chipsalliance/adams-bridge/docs/images/MLDSA/image1.png

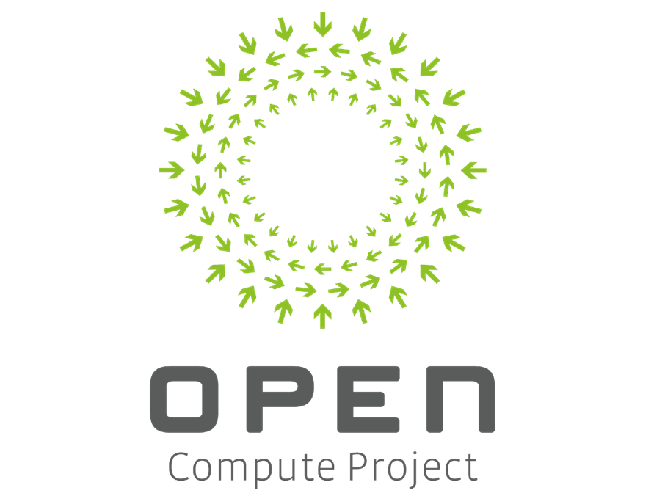
docs/images/MLDSA/image1.png
