chipsalliance/adams-bridge/docs/images/MLDSA/image64.png

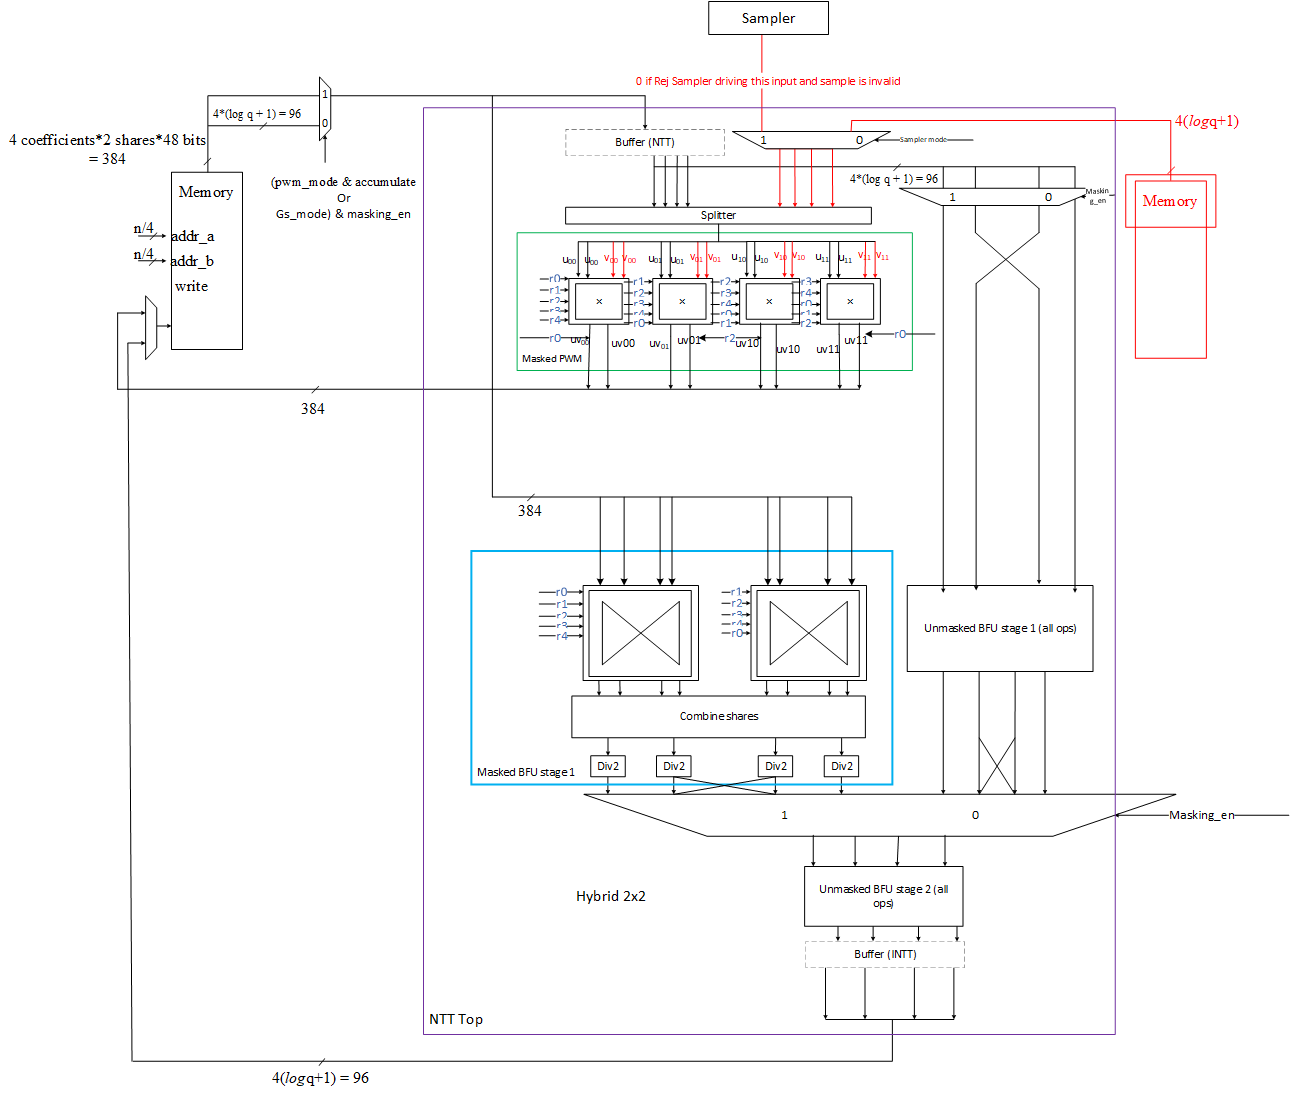
docs/images/MLDSA/image64.png
