chipsalliance/adams-bridge/docs/images/MLKEM/image2.png

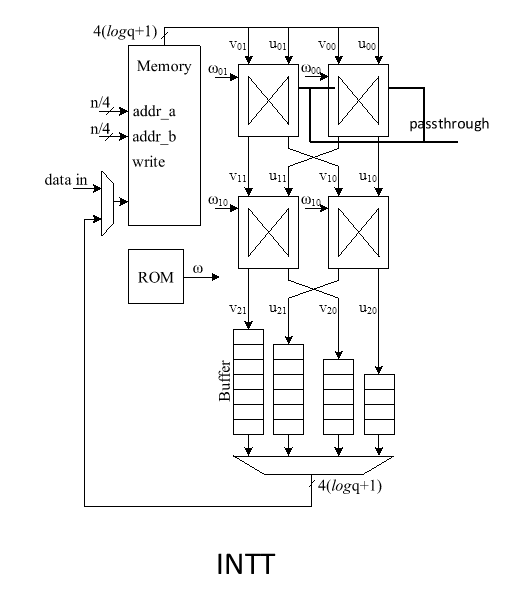
docs/images/MLKEM/image2.png
