chipsalliance/adams-bridge/docs/images/MLKEM/image3.png

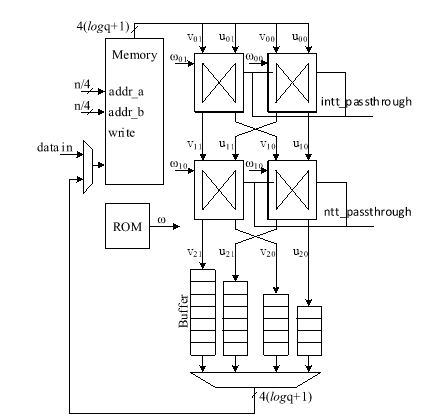
docs/images/MLKEM/image3.png
