chipsalliance/adams-bridge/docs/AdamsBridge_TestPlan.xlsx

Sheet: ML-KEM
Test Category | Test Name | Randomization Parameters | Description | Pass Metrics
Baseline Function
 | Directed Keygen KATs (tb) | none | Validate the keygen using a fixed KAT to ensure any update doesn't break the functionallity | Data check
 | Directed Encaps KATs (tb) | none | Validate the signing using a fixed KAT to ensure any update doesn't break the functionallity | Data check
 | Directed Keygen+Decaps KATs (tb) | none | Validate the keygen+signing using a fixed KAT to ensure any update doesn't break the functionallity | Data check
 | Directed Decaps KATs (tb) | none | Validate the verifying using a fixed KAT to ensure any update doesn't break the functionallity | Data check
 | Directed Keygen KATs (smoke tests) | none | Validate the keygen using a fixed KAT in a C smoke test to ensure any update doesn't break the functionallity | Data check
 | Directed Keygen+Decaps KATs (smoke tests) | none | Validate the keygen+signing using a fixed KAT in a C smoke test to ensure any update doesn't break the functionallity | Data check
 | Directed Encaps KATs (smoke tests) | none | Validate the signing using a fixed KAT in a C smoke test to ensure any update doesn't break the functionallity | Data check
 | Directed Decaps KATs (smoke tests) | none | Validate the verifying using a fixed KAT in a C smoke test to ensure any update doesn't break the functionallity | Data check
 | randomized test | selected operation | Randomly select keygen/encap/decap and verify using reference model | Data check
 |  | order of operation
 |  | input data
 | Zero-seed KAT | seed = 0 | Run keygen with all-zero seed and validate against known behavior | Data check
 | Chaning the command during the process | randomized timing | Assert another command either 1 cycle or X cycles after the first command to ensure it is ignored while the engine is busy.
 | zeroize with command | none | Assert zeroize simultaneously with keygen, encaps, or decap
 | zeroize during the process | randomized timing | Assert zeroize either 1 cycle or X cycles after issuing the command to interrupt the process and ensure all registers and memories are cleared.
 | kv interaction | selected operation | Perform key generation, Encaps or Decaps with the seed sourced from KV, ensuring the secret asset remains hidden from firmware.
 |  | order of operation
 |  | input data
 | zeorize after process being done | selected operation | Assert zeroize upon process completion to ensure all registers and memories will be cleared.
 |  | input data | add several assertion to ensure registers and memories are cleared using zeroize/scan_mode command.
Error Trigger
 | encapsulation with invalid ek | invalid input | Set a 12b coefficient value in the EK to >= MLKEM Q | Data check
 | decapsulation with invalid dk | invalid input | Bit flip on EK/hash portion of DK | Data check
 | Decaps rejection | valid ct from a different EK | Use a ciphertext from a different EK and ensure decapsulation fails (comparing with expected shared key) | Data check
Edge cases
 | Prevent partial key recovery |  | zeroize during kv access
 |  |  | fw read during kv access
 |  |  | Assert zeroize in the middle of reading the seed from KV to ensure that no partial key is presented.
 | Restrict fw access while kv assets exist |  | Attempt to read the API while the seed is sourced from KV, ensuring the secret asset is not exposed to the firmware.
 | Reg API lock feature |  | reading the API during the process
 |  |  | any unlock(excluding the regular valid output) clears the API content
 |  |  | only valid signature unlocks the API and releases the content
 | scan_mode/debug |  | Assert scan/debug_mode to interrupt the process and ensure all registers are cleared.
 | write after read during zeroize |  | Read from and write to the API while zeroize is occurring to ensure the engine only returns 0.
Unit Level TB
 | barrett reduction

Sheet: ML-DSA
Test Category | Test Name | Randomization Parameters | Description | Pass Metrics
Baseline Function
 | Directed Keygen KATs (tb) | none | Validate the keygen using a fixed KAT to ensure any update doesn't break the functionallity | Data check
 | Directed Signing KATs (tb) | none | Validate the signing using a fixed KAT to ensure any update doesn't break the functionallity | Data check
 | Directed Keygen+Signing KATs (tb) | none | Validate the keygen+signing using a fixed KAT to ensure any update doesn't break the functionallity | Data check
 | Directed Verifying KATs (tb) | none | Validate the verifying using a fixed KAT to ensure any update doesn't break the functionallity | Data check
 | Directed Keygen KATs (smoke tests) | none | Validate the keygen using a fixed KAT in a C smoke test to ensure any update doesn't break the functionallity | Data check
 | Directed Keygen+signing KATs (smoke tests) | none | Validate the keygen+signing using a fixed KAT in a C smoke test to ensure any update doesn't break the functionallity | Data check
 | Directed Signing KATs (smoke tests) | none | Validate the signing using a fixed KAT in a C smoke test to ensure any update doesn't break the functionallity | Data check
 | Directed Verifying KATs (smoke tests) | none | Validate the verifying using a fixed KAT in a C smoke test to ensure any update doesn't break the functionallity | Data check
 | randomized test | selected operation order of operation input data | randomly select one operations (keygen/signing/verifying tests) and perform using random inputs and validate the reuslts using the reference model. | Data check
 | verifying failure | change rho/t1 parts of pk change the message change c~/z/h part of signature | randomly change different parts of input to generate failure for verifying | Data chaeck
 | on the fly reset test | randomized timing | Assert reset during execution to halt the core.
 | Chaning the command during the process | randomized timing | Assert another command either 1 cycle or X cycles after the first command to ensure it is ignored while the engine is busy.
 | zeroize with command | none | Assert zeroize simultaneously with the keygen, signing, or verifying command to ensure the command is ignored.
 | zeroize during the process | randomized timing | Assert zeroize either 1 cycle or X cycles after issuing the command to interrupt the process and ensure all registers and memories are cleared.
 | kv interaction with keygen/signing | selected operation order of operation input data | Perform key generation or signing with the seed sourced from KV, ensuring the secret asset remains hidden from firmware.
 | zeorize after process being done | selected operation input data | Assert zeroize upon process completion to ensure all registers and memories will be cleared.
Error Trigger
 | signing with invalid s1/s2 | invalid input | Perform the signing operation with invalid input to validate that the system detects the error and reports it appropriately. | Data check
 | verifying with invalid h | invalid input | Perform the verifying operation with invalid input to validate that the system detects the error and reports it appropriately. | Data check
Edge cases
 | inject invalid makehint |  | make failure for hintsum during signing/verifying | Data check
 | inject invalid normcheck |  | inject failute for 3 normcheck operations in singing, or the one for verifying | Data check
 | partial key recovery |  | zeroize during kv access fw read during kv access hmac/sha interation during kv access
 | fw access while kv assets exist |  | Attempt to read the API while the seed is sourced from KV, ensuring the secret asset is not exposed to the firmware.
 | equal scenaio for decompose |  | Checking the corner cases for decomposition operations to ensure all edge scenarios are handled correctly.
Unique features
 | Reg API lock feature |  | reading the API during the process any unlock(excluding the regular valid output) clears the API content only valid signature unlocks the API and releases the content signing failure keeps API locked
 | single signing cmd |  | single signing is not supported
 | iteration failure for signing round |  | inject failure for validity checks during signing for all rounds to check time-out
 | iteration failure for rejection samplers |  | inject failure for vrejection samplers to check time-out
 | zeroize partial keys (inject zeroize) |  | Assert zeroize in the middle of reading the seed from KV to ensure that no partial key is presented.
 | mldsa with scan_mode/debug |  | Assert scan/debug_mode to interrupt the process and ensure all registers are cleared.
 | sva for zeroize period |  | add several assertion to ensure registers and memories are cleared using zeroize/scan_mode command.
 | write after read during zeroize |  | Read from and write to the API while zeroize is occurring to ensure the engine only returns 0.
 | code coverage at least for a week |  | Checking the coverage
 | sign_rnd |  | Validate non-deterministic signing and verifying by using a fixed KAT to ensure correct functionality.
 | Lint issues |  | Checking the lint
