chipsalliance/adams-bridge/(threads)

Thread 45 (2024-11-22):

updated NTT block to support masking countermeasure for A.y

mojtaba-bisheh, 2024-11-22:
The current masking supports only PWM operation that is followed by INTT operations. Hence, the intermediate results of PWM is not stored in memory.
In the case of A.y, PWM with accumulation needs to happen first and then INTT. Since this is accumulation over several polynomials, we cannot perform INTT on the fly for each PWM operation that happens.
We should update the memory arch to store the intermediate masked data of size (4 coeff * 2 shares * 46 bits * 64 addr) that stores 1 poly at a time and accumulation happens over it with masked PWM. Then INTT is triggered that reads this share memory and performs 1st stage of masking and combines shares and writes to original memory.

Now, NTT should support:
All unmasked operations
Masked PWM
Masked PWMA (accumulation)
Masked INTT
Masked PWM + INTT

Thread 54 (2024-12-11):

Don't use a prehashed version of ML-DSA

brainhub, 2024-12-11:
NIST has recently clarified that one FIPS module can accept a hash of the message and use the "pure" or "normal" version of ML-DSA. ("pure ML-DSA" below). The method to use pure ML-DSA with a hash of the message is known as "external mu" method.

The method can be seen on lines 6-7 of Algorithm 8 in https://doi.org/10.6028/NIST.FIPS.204:

6: 𝑡𝑟 ← H(𝑝𝑘, 64)
7: 𝜇 ← (H(BytesToBits(𝑡𝑟)||𝑀 ′ , 64)) ▷ message representative that may optionally be computed in a different cryptographic module

Then the module, such as the one implementing this IP, takes the 64-byte "mu" as input (representing the hashed message).

The issues of prehashing is best to leave to the higher levels of firmware. In many cases, as e.g. in composite signatures, the messages passed to ML-DSA are very small, and the pure ML-DSA is used. This is just one example. The same is true for e.g. boot images where often short images are signed, that include hashes of larger images.

Therefore, to make the IP applicable to more use cases, and to simplify testing of the IP, it should stay with the pure version of ML-DSA.

This keeps the register `message` effectively the same. In this case of verification the register `pk` is not used. I don't see a strong need to hash the `pk` by IP itself, so this should not be a material issue.

igilman0, 2024-12-11:
If I understand the previous post correctly, it is now impossible to check the current Adam's Bridge (ABR) IP implementation correctness against the NIST-provided FIPS204 standard compliance Sign and Verify vectors.  Correct?
These vectors have input "messages" (M in FIPS204 nomenclature) that are way longer than the ABR 64-byte MSG register so currently ABR couldn't even accept them.

Could you also confirm that the ABR IP in fact *will* be fixed to accept a 64-byte "mu" input into its MSG register (a.k.a., externally-computed message representative "mu")?

brainhub, 2024-12-12:
I think I was asking for this 35180387a977abe48777415c1aed86c35413a25f . @igilman0, so there is "pure ML-DSA" and "prehash ML-DSA" and they are binary incompatible. The test vectors will not match.

I propose to use the "external mu" interface to pure ML-DSA.

> Could you also confirm that the ABR IP in fact will be fixed to accept a 64-byte "mu" input into its MSG register (a.k.a., externally-hashed message representative "mu")?

I am not sure to whom this question is directed, but because I advocate pure ML-DSA, the minimal change to the current interface is to accept the "mu". This will mean from functional point of view that the same properties of the HW interface are preserved, namely, that the input representative of a message is still a hash (broadly speaking), while this interface can be tested against standard pure ML-DSA test vectors.

mojtaba-bisheh, 2024-12-12:
AdamsBridge doesn't support ExternalMu variant. This is pure MLDSA where the message size is limited to 512 bits based on Calitpra use model.
Caliptra performs a SHA512 over the data and passes the digest to AdamsBridge that works in Pure MLDSA mode.

brainhub, 2024-12-12:
Will you be able to find "official" test vectors for fixed-size-512-bit-message?

mjosaarinen, 2024-12-18:
Comment from the sidelines :)  The current behavior maps to the "IPD" draft version of FIPS 204, which allowed one to simply sign a hash as if it were a message. This is problematic cryptanalytically as the same signature is now valid for both SHA(message) and also its hash, interpreted as a 64-byte message (without hashing). HashML-DSA and additional domain separation were specifically introduced in the final version of FIPS 204 to overcome this EUF-CMA security problem. Thus I would not think that the current approach is FIPS-certifiable.

 I've worked with Chris Celi of NIST little bit on this (to fix those test vectors), and the latest test vectors include ExternalMu cases, so one should be able to FIPS certify with that kind of API.

An ExternaMu interface would allow your module to support all modes and hash functions (pure and non-pure) with current external interfaces. It bypasses the domain separation padding steps altogether and 64-byte "msg" becomes:
- "mu" on line 6 of Algorithm 7 (ML-DSA.Sign_internal) and
- "mu" on line 7 of Algorithm 8 (ML-DSA.Verify_internal)
( See https://doi.org/10.6028/NIST.FIPS.204 )

You're trusting the caller to compute the hash so you could also trust that party to also format the hash with domain separation. Note the comment _message representative that may optionally be computed in a different cryptographic module_ in the spec.

Cheers,
-markku

mjosaarinen, 2024-12-18:
Btw the only bug in these test vectors was that the "rnd" parameter bytes need to reversed (or for Adams Bridge, not reversed, unlike everything else..) https://groups.google.com/a/list.nist.gov/g/pqc-forum/c/bV_tuibsCWU/m/HrNpJ2sTAAAJ

To pass all test cases one needs four different APIs but you don't need to implement all of those; it's just to facilitate people having different kinds of APIs.

## quote

**Dec 5, 2024, 3:36 PM (13 days ago) to Christopher,**
Thanks Chris,

With this byte reversal of "rnd", I am now passing all 360 ML-DSA sigGen test cases. It seems to work for preHash, externalMu, both external and internal interfaces, and all parameter sets.

This requires one to use four different signing interfaces to the ML-Dsa implementation:

1. When "preHash" is set: Algorithm 4, HashML-DSA.Sign(sk, M, ctx, PH) interface, with the "PH" switch case extended with all of the additional OIDs and hashes in the test cases.
3. When "externalMu" is set: Algorithm 7, ML-DSA.Sign_internal(sk, <M'>, rnd) is used with the additional parameter mu that is inserted in line 6 of the algorithm. Parameter M' is not used.
4. when "signatureInterface" = "external": Algorithm 2 ML-DSA.Sign(sk, M, ctx).
5. when "signatureInterface" = "internal": Algorithm 7, Algorithm 7, ML-DSA.Sign_internal(sk, M', rnd), where M' is the message.

My test code checks the various flags in that order; for example, if preHash is set, other cases are ignored.

Note again that in *all* cases, the rnd input bytes are reversed to pass the non-deterministic cases.

Cheers,
- Markku

mojtaba-bisheh, 2025-03-12:
> NIST has recently clarified that one FIPS module can accept a hash of the message and use the "pure" or "normal" version of ML-DSA. ("pure ML-DSA" below). The method to use pure ML-DSA with a hash of the message is known as "external mu" method.
- The current design only supports Pure-MLDSA.

> An ExternaMu interface would allow your module to support all modes and hash functions (pure and non-pure) with current external interfaces. It bypasses the domain separation padding steps altogether and 64-byte "msg" becomes:
- ExternalMu is added to design but hardcoded to be zero until validation https://github.com/chipsalliance/adams-bridge/issues/108

> Note again that in _all_ cases, the rnd input bytes are reversed to pass the non-deterministic cases.
- we have added a smoke test with non-zero rnd to ensure the endianness is correct. https://github.com/chipsalliance/caliptra-rtl/tree/main/src/integration/test_suites/smoke_test_mldsa_sign_rnd

Thread 62 (2024-12-19):

sample_in_ball_ctrl module state machine stuck in SIB_DONE state without zeroize or reset

batthineniatlubis, 2024-12-19:
In the sampler units, one of the units is sample_in_ball_ctrl which is being used in signing operation. This module got an FSM which traverses from IDLE -> BUFFER -> ACTIVE->DONE, once it reached the"DONE" state the fsm waits for the zeroize or !rst_b signal to jump back to"IDLE" state.On the higher  level if the signature is valid for the current request and once this request is served and a new request is triggered without a zeroize or !rst_b then the SampleInball operation immediately returns done signal which isn't actually triggered for this request.

mojtaba-bisheh, 2024-12-19:
We assume zeroize is required between two operations, however, we can consider this fix as an enhancement for any use case that doesn't need FIPS certificate to perform zeroize

Closed 2025-06-25.

Thread 67 (2025-01-14):

lint waiver file doesn’t exist

mojtaba-bisheh, 2025-01-14:
One of the files provides pointers for lint waivers but the directories doesn’t exist in github

https://github.com/chipsalliance/adams-bridge/blob/b4a3eec9a791a260a036f453f4e6ef3f596ea6c8/src/mldsa_top/config/compile.yml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

Closed 2025-01-16.

Thread 73 (2025-01-21):

Adams Bridge interface needs debugUnlock_or_scan_mode_switch input to drive zeroize in case of debug/scan mode

upadhyayulakiran, 2025-01-21:
ABR needs debugUnlock_or_scan_mode_switch input to zeroize internal regs and memories upon debug/scan mode entry

@Nitsirks I believe all crypto engines until now finish zeroization in the next clk after assertion of this signal. However in mldsa, it will take ~500 clks to finish zeroizing the memories. Can you confirm if this is okay and if the memories won't be part of the scan chain (per discussion with Avirup this morning)?

Nitsirks, 2025-01-22:
Scan mode is usually for shifting out flop values, which will be cleared in the same clock.

We need to be very clear in the integration spec how integrators will need to protect SRAMs from leaking secrets over BIST logic. This would include putting restrictions on when dft logic can read them.

Closed 2025-01-23.

Thread 86 (2025-02-05):

There is a write when ntt is done.

batthineniatlubis, 2025-02-05:
The following scenario occurs when the ntt is set for one of the modes for example ct and the operation goes on until the done signal is asserted, which ideally considering done a very strong signal, because after done, we should be able to start another computation. In the current design its not feasible because there is a write even when the done is asserted and this means a new computation cannot be triggered until this is finished. This would be an issue if the ntt block is pulled and used for any another project where it needs back to back computations.

Closed 2025-02-21.

Thread 89 (2025-02-09):

buf_wren stays asserted during EXEC_WAIT state in ntt_ctrl module

batthineniatlubis, 2025-02-09:
The issue here is, buf_wren stays high even in EXEC_WAIT(last state before going to STAGE state for next round) state and it writes 0s to the lower buffer while upper buffer is being read. This is not expected.

upadhyayulakiran, 2025-02-21:
This is an issue, however in ABR we don't see functional issue due to this, since the 0s are written after the last set of writes complete. So, the 0s are never read and everything pointers are reset before starting next round. It's good to fix, but not a functional issue. Marking as enhancement

Thread 90 (2025-02-10):

NTT: wrong counting for sampler valid causing deadlock

mojtaba-bisheh, 2025-02-10:
If sampler valid de-asserts at data beat number 63 it can cause a deadlock, where the computation never finishes.
Here is the response from the designer:

This is a bug. I see in the waves that, sampler_valid goes low on the very last read. In that case, since data is not valid, NTT should wait for sampler_valid to go high again and then read, execute and write. But in this case, since the read counter is already updated, it thinks that it already saw the last data whereas the write fsm is stuck because it only counted 63 writes instead of 64.

[ntt_top_never_leaves_busy3.fsdb.zip](https://github.com/user-attachments/files/18724897/ntt_top_never_leaves_busy3.fsdb.zip)

mojtaba-bisheh, 2025-02-10:
CCed https://github.com/ludwigatlubis

Closed 2025-02-21.

Thread 96 (2025-02-14):

Norm check shuffling is enabled for non shuffle mode

batthineniatlubis, 2025-02-14:
In the normcheck where back to back enables trigger one with shuffling and the second without shuffling, in the second operation still it will considered as shuffling because of the latched_shuffling signal is resetted post idle state.

[fv_norm_check_top_fv_norm_check_top_verif_run_IDLE_to_READ_MEM_1_a_0.fsdb.zip](https://github.com/user-attachments/files/18800349/fv_norm_check_top_fv_norm_check_top_verif_run_IDLE_to_READ_MEM_1_a_0.fsdb.zip)

.

Thread 125 (2025-03-12):

Assertion error at EOT

BharathwajMuralidharan, 2025-03-12:
Hi Team,
I am currently observing the following assertion failure in the MLDSA tests
"mldsa.sampler_top_inst.sha3_inst.u_pad.RunThenComplete_M". The assertion is a strong assertion, expecting an response before the EOT. Despite adding a drain time, It is observed that the assertion still fails.

Nitsirks, 2025-05-13:
Which operation (keygen/sign/verify) are you running that results in this assertion?

Nitsirks, 2025-07-10:
closing due to inactivity and inability to reproduce internally.

Closed 2025-07-10.

Thread 131 (2025-03-20):

sigdecode_h missing default case in rd fsm

batthineniatlubis, 2025-03-20:
The read fsm in the sigdecode_h module doesn't have a default condition.

This is an enhancement

Thread 133 (2025-03-24):

Simulation deadlock for signing tests

BharathwajMuralidharan, 2025-03-24:
Hi,

While executing the random signing testcase, it is observed that the simulation doesn't proceed beyond 42000 ns(clk is operating at frequency of 1ghz). Further debugging revealed that the simulation is stuck at the following logic in mldsa_ctrl.sv

  always_comb process_done = (keygen_process & keygen_done) |
                             (signing_process & signature_done) |
                             (verifying_process & verify_done);

in a parallel always_ff block, the process_done deasserts the signing_process signal which is causing this deadlock.

Let me know if any waveform is needed.

The simulator used here is xcelium.

Nitsirks, 2025-04-25:
process_done should have triggered the VALID register to be set. Are you sure that the signing operation didn't just complete normally?

Nitsirks, 2025-05-13:
Closing this issue due to inactivity, feel free to re-open it if you are still facing the issue.

BharathwajMuralidharan, 2025-05-14:
"process_done should have triggered the VALID register to be set" --> The simulator identified a glitch condition with this logic and the test gets stuck. We have used a delay_trigger switch as a workaround. Attaching the cadence article for your reference
 https://community.cadence.com/cadence_technology_forums/f/logic-design/15558/problem-with-simvision-hanging-in-an-endless-loop

Thread 136 (2025-04-15):

Stream msg interface doesn't absorb back pressure for ctx

batthineniatlubis, 2025-04-15:
In the rtl version of mldsa_ctrl where it supports the msg stream. It is observed  that if the ctx_size is greater than the number of beats the keccak module handles then there will be a back pressure from the keccak by deasserting msg_rdy_i for a clk and this would drop the msg_valid missing the ctx data. Since the logic doesn't consider this case.

Nitsirks, 2025-04-25:
After review, looks like the modeling of primary inputs was incorrect. Runs with the corrected modeling will determine if this is a real issue.

Thread 145 (2025-05-15):

[BUG] Streaming message will drop a byte for specific lengths of message

Nitsirks, 2025-05-15:
The streaming message logic will drop 1 byte of MSG data when an odd number of dwords is sent to the streaming message buffer, followed by a partial dword of 3 bytes.

In this corner case, the partial triggers the last message logic and transitions to the flush state. In the flush state, the normal condition is to flush the remaining bytes, but in this case there is a full message + 1 byte so it only flushes the full message and drops the last byte.

This escaped due to a hole in the validation randomization that was preventing odd dword length messages.

Closed 2025-05-16.

Thread 163 (2025-07-17):

Reset in CBD and specification

batthineniatlubis, 2025-07-17:
The reset pin (active low) isn't used since the module is purely combinational. Rather zeroize is used, so the reset pin can be removed.

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

CBD specification has a modular mux values 0,1,2,3,4. Which should be 0,1,2,6,7.

https://github.com/chipsalliance/adams-bridge/blob/feee8cfc22bc73e33eba261c5000d996ac16cdec/docs/AdamsBridge_MLKEM.md

Closed 2025-07-18.

Thread 168 (2025-07-23):

[RTL] Decaps flow is missing an input check

Nitsirks, 2025-07-23:
FIPS 203 requires a decapsulation check that the provided hash of EK is in fact the hash of the provided EK portion of the DK.

Closed 2025-07-30.

Thread 197 (2025-08-22):

Build failure from missing includes

jlmahowa-amd, 2025-08-22:
For FPGA builds I found that with 2.1 (not required for 2.0) I need to include kv_macros.svh and abr_config_define.svh from abr_ctrl.sv.
A couple concerns with my hack:
- Many of the macros are defined in abr_sva.svh, which is included in abr_config_defines.svh. Would abr_sva.svh be preferred to be included instead of abr_config_defines.svh?
- kv_macros.svh is from the caliptra-rtl repo. Are there concerns about adding an include from the caliptra-rtl besides gating it on CALIPTRA being defined?

The error message reported by Vivado for the build is misleading. Vivado dropped abr_ctrl.sv because of the undefined macros.
```
ERROR: [Synth 8-439] module 'abr_ctrl' not found [/fourtb/jlmahowa/caliptra-mcu-sw-lock/hw/fpga/caliptra_build/caliptra_fpga_project.gen/sources_1/bd/caliptra_fpga_project_bd/ipshared/3d11/src/abr_top.sv:339
```

The actual errors in abr_ctrl.sv:
```
[HDL 9-3952] use of undefined macro 'CALIPTRA_KV_WRITE_STATUS_ASSIGN' ["/fourtb/jlmahowa/caliptra-mcu-sw-lock/hw/caliptra-ss/third_party/caliptra-rtl/submodules/adams-bridge/src/abr_top/rtl/abr_ctrl.sv":242]

[HDL 9-3952] use of undefined macro 'CALIPTRA_KV_READ_CTRL_REG2STRUCT' ["/fourtb/jlmahowa/caliptra-mcu-sw-lock/hw/caliptra-ss/third_party/caliptra-rtl/submodules/adams-bridge/src/abr_top/rtl/abr_ctrl.sv":243]

[HDL 9-3952] use of undefined macro 'CALIPTRA_KV_WRITE_CTRL_REG2STRUCT' ["/fourtb/jlmahowa/caliptra-mcu-sw-lock/hw/caliptra-ss/third_party/caliptra-rtl/submodules/adams-bridge/src/abr_top/rtl/abr_ctrl.sv":246]

[HDL 9-3952] use of undefined macro 'ABR_ASSERT_KNOWN' ["/fourtb/jlmahowa/caliptra-mcu-sw-lock/hw/caliptra-ss/third_party/caliptra-rtl/submodules/adams-bridge/src/abr_top/rtl/abr_ctrl.sv":2192]

[HDL 9-3952] use of undefined macro 'ABR_ASSERT' ["/fourtb/jlmahowa/caliptra-mcu-sw-lock/hw/caliptra-ss/third_party/caliptra-rtl/submodules/adams-bridge/src/abr_top/rtl/abr_ctrl.sv":2196]

[HDL 9-3952] use of undefined macro 'ABR_ASSERT_NEVER' ["/fourtb/jlmahowa/caliptra-mcu-sw-lock/hw/caliptra-ss/third_party/caliptra-rtl/submodules/adams-bridge/src/abr_top/rtl/abr_ctrl.sv":2198]

[HDL 9-3952] use of undefined macro 'ASSERT' ["/fourtb/jlmahowa/caliptra-mcu-sw-lock/hw/caliptra-ss/src/ast/rtl/adc.sv":113]

[HDL 9-3952] use of undefined macro 'ASSERT_KNOWN' ["/fourtb/jlmahowa/caliptra-mcu-sw-lock/hw/caliptra-ss/src/ast/rtl/ast.sv":938]

[HDL 9-3952] use of undefined macro 'ASSERT_PRIM_REG_WE_ONEHOT_ERROR_TRIGGER_ERR' ["/fourtb/jlmahowa/caliptra-mcu-sw-lock/hw/caliptra-ss/src/ast/rtl/ast.sv":995]

[HDL 9-3952] use of undefined macro 'ASSERT' ["/fourtb/jlmahowa/caliptra-mcu-sw-lock/hw/caliptra-ss/src/ast/rtl/ast_pulse_sync.sv":143]

[HDL 9-3952] use of undefined macro 'ASSERT_PULSE' ["/fourtb/jlmahowa/caliptra-mcu-sw-lock/hw/caliptra-ss/src/ast/rtl/ast_reg_top.sv":1958]

[HDL 9-3952] use of undefined macro 'ASSERT' ["/fourtb/jlmahowa/caliptra-mcu-sw-lock/hw/caliptra-ss/src/ast/rtl/ast_reg_top.sv":1961]

[HDL 9-3952] use of undefined macro 'ASSERT' ["/fourtb/jlmahowa/caliptra-mcu-sw-lock/hw/caliptra-ss/src/pwrmgr/rtl/pwrmgr.sv":163]

[HDL 9-3952] use of undefined macro 'ASSERT_INIT' ["/fourtb/jlmahowa/caliptra-mcu-sw-lock/hw/caliptra-ss/src/pwrmgr/rtl/pwrmgr.sv":370]

[HDL 9-3952] use of undefined macro 'ASSERT_KNOWN' ["/fourtb/jlmahowa/caliptra-mcu-sw-lock/hw/caliptra-ss/src/pwrmgr/rtl/pwrmgr.sv":696]

[HDL 9-3952] use of undefined macro 'ASSERT_PRIM_FSM_ERROR_TRIGGER_ERR' ["/fourtb/jlmahowa/caliptra-mcu-sw-lock/hw/caliptra-ss/src/pwrmgr/rtl/pwrmgr.sv":729]

[HDL 9-3952] use of undefined macro 'ASSERT_PRIM_REG_WE_ONEHOT_ERROR_TRIGGER_ALERT' ["/fourtb/jlmahowa/caliptra-mcu-sw-lock/hw/caliptra-ss/src/pwrmgr/rtl/pwrmgr.sv":736]

[HDL 9-3952] use of undefined macro 'ASSERT_INIT' ["/fourtb/jlmahowa/caliptra-mcu-sw-lock/hw/caliptra-ss/src/pwrmgr/rtl/pwrmgr_fsm.sv":80]

[HDL 9-3952] use of undefined macro 'PRIM_FLOP_SPARSE_FSM' ["/fourtb/jlmahowa/caliptra-mcu-sw-lock/hw/caliptra-ss/src/pwrmgr/rtl/pwrmgr_fsm.sv":179]

[HDL 9-3952] use of undefined macro 'PRIM_FLOP_SPARSE_FSM' ["/fourtb/jlmahowa/caliptra-mcu-sw-lock/hw/caliptra-ss/src/pwrmgr/rtl/pwrmgr_slow_fsm.sv":138]

[HDL 9-3952] use of undefined macro 'ASSERT' ["/fourtb/jlmahowa/caliptra-mcu-sw-lock/hw/caliptra-ss/src/pwrmgr/rtl/pwrmgr_slow_fsm.sv":356]

[HDL 9-3952] use of undefined macro 'ASSERT_INIT' ["/fourtb/jlmahowa/caliptra-mcu-sw-lock/hw/caliptra-ss/src/tlul/rtl/tlul_adapter_dmi.sv":180]

```

Nitsirks, 2025-08-26:
closed with pr #199

Closed 2025-08-26.

Thread 203 (2025-09-02):

[Question] memory collision when zeroize?

nelson-ou, 2025-09-02:
Hello!
When _zeroize_ occur, both **mem*_re_i** and **mem*_we_i** are assert to 1'b1
There will be a memory read/write collision at address 0 isn't it?
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

Thread 206 (2025-09-04):

Timing issues with SRAM to reg path

amitjaink, 2025-09-04:
We are observing timing issues with mem2reg paths after replacing the existing flop based
memory with our techonology specific SRAM(includign DFT and ECC logic)

There is a high logic depth for mem2reg paths in Adams Bridge(Screenshot attached)

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

)

WNS: -0.282358
Average Logic depth: 35
Average Buffer invertors added: 6

Please look into  pipeline the SRAM data in Adams bridge

Thread 214 (2025-09-16):

[Lint] Mismatch bit length

seongchan1-kim, 2025-09-16:
Hi,

There are lint errors by mismatch bit length.

1. Between "sampler_ntt_data" and "pwm_b_rd_data" in abr_top.sv(676 line).

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

2. Between "mlkem_mul_res_reduced_reg" and "opb_i" in ntt_butterfly.sv(256 line).

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

3. Between "w10_i[MLKEM_REG_SIZE - 1:0]" and "opw_i" in ntt_hybrid_butterfly_2x2.sv (321 line, 338 line)

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

Regards,
Seongchan

seongchan1-kim, 2025-09-19:
Hi @Nitsirks

Lint rule is a PORT_BITLEN.

Regards,
Seongchan

Nitsirks, 2025-09-19:
Thanks Seongchan,

I'm looking for an equivalent spyglass rule to catch these in the future.

seongchan1-kim, 2025-09-19:
Hi @Nitsirks ,

Okay, Thanks.
Are these lint errors planning to be fixed?

Regards,
Seongchan
