chipsalliance/adams-bridge/src/abr_top/stimulus/uvmf_mldsa_top_promote_regression.yml

document:
  schema: 1.0

contents:
  - generator:
      tags: ["L0", "uvmf_mldsa",  "directed", "smoke_test"]
      path: ""
      weight: 100
      generations: 1
      formats: 
        generate: "reseed {template}.yml -seed 1"
        path: "{template_basename}__1.yml"
      templates:
        - $ADAMSBRIDGE_ROOT/src/abr_top/uvmf/uvmf_template_output/project_benches/mldsa/tb/tests/src/ML_DSA_randomized_key_gen_and_sign_test
  - generator:
      tags: ["L0", "uvmf_mldsa",  "directed", "smoke_test"]
      path: ""
      weight: 100
      generations: 1
      formats: 
        generate: "reseed {template}.yml -seed 1"
        path: "{template_basename}__1.yml"
      templates:
        - $ADAMSBRIDGE_ROOT/src/abr_top/uvmf/uvmf_template_output/project_benches/mldsa/tb/tests/src/ML_DSA_randomized_verif_test
  - generator:
      tags: ["L0", "uvmf_mldsa",  "directed", "smoke_test"]
      path: ""
      weight: 100
      generations: 1
      formats: 
        generate: "reseed {template}.yml -seed 1"
        path: "{template_basename}__1.yml"
      templates:
        - $ADAMSBRIDGE_ROOT/src/abr_top/uvmf/uvmf_template_output/project_benches/mldsa/tb/tests/src/ML_DSA_keygen_KATs_test
  - generator:
      tags: ["L0", "uvmf_mldsa",  "directed", "smoke_test"]
      path: ""
      weight: 100
      generations: 1
      formats: 
        generate: "reseed {template}.yml -seed 1"
        path: "{template_basename}__1.yml"
      templates:
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
      generations: 1
      formats: 
        generate: "reseed {template}.yml -seed 1"
        path: "{template_basename}__1.yml"
      templates:
        - $ADAMSBRIDGE_ROOT/src/abr_top/uvmf/uvmf_template_output/project_benches/mldsa/tb/tests/src/ML_DSA_randomized_verif_stream_msg_test
