chipsalliance/adams-bridge/src/abr_top/rtl/abr_ctrl.sv

// SPDX-License-Identifier: Apache-2.0
//
// Licensed under the Apache License, Version 2.0 (the "License");
// you may not use this file except in compliance with the License.
// You may obtain a copy of the License at
//
// http://www.apache.org/licenses/LICENSE-2.0
//
// Unless required by applicable law or agreed to in writing, software
// distributed under the License is distributed on an "AS IS" BASIS,
// WITHOUT WARRANTIES OR CONDITIONS OF ANY KIND, either express or implied.
// See the License for the specific language governing permissions and
// limitations under the License.

//High level controller block for executing
//Adams Bridge functions
//  ML-DSA Keygen
//  ML-DSA Signing
//  ML-DSA Verifying
//  ML-KEM Keygen
//  ML-KEM Encaps
//  ML-KEM Decaps

`include "abr_config_defines.svh"
`ifdef CALIPTRA
`include "kv_macros.svh"
`endif

module abr_ctrl
  import abr_reg_pkg::*;
  import abr_sha3_pkg::*;
  import abr_sampler_pkg::*;
  import abr_ctrl_pkg::*;
  import abr_params_pkg::*;
  import ntt_defines_pkg::*;
  import compress_defines_pkg::*;
  import decompress_defines_pkg::*;
  `ifdef CALIPTRA
  import kv_defines_pkg::*; 
  `endif
  #(
    parameter SRAM_LATENCY = 1,
    parameter bit MASKING_EN = 0,
    parameter bit SHA3_MASKING_EN = 0
  )
  (
  input logic clk,
  input logic rst_b,
  output logic zeroize,

`ifdef RV_FPGA_SCA
  output logic NTT_trigger,
  output logic PWM_trigger,
  output logic PWA_trigger,
  output logic INTT_trigger,
`endif

  output abr_reg__in_t abr_reg_hwif_in_o,
  input  abr_reg__out_t abr_reg_hwif_out_i,

  //sampler interface
  output abr_sampler_mode_e          sampler_mode_o,
  output logic                       sha3_start_o,
  output logic                       sha3_masked_o,
  output logic                       msg_start_o,
  output logic                       msg_valid_o,
  input  logic                       msg_rdy_i,
  output logic [MsgStrbW-1:0]        msg_strobe_o,
  output logic [MsgWidth-1:0]        msg_data_o,
  output logic                       sampler_start_o,

  input  logic                       sampler_busy_i,
  input logic                        sampler_state_dv_i,
  input logic [abr_sha3_pkg::StateW-1:0] sampler_state_data_i,

  output logic [ABR_MEM_ADDR_WIDTH-1:0] dest_base_addr_o,

  //ntt interfaces — single command set, abr_top handles mirroring to NTT[1]
  output logic                        ntt_enable_o,
  output abr_ntt_mode_e               ntt_mode_o,
  output ntt_mem_addr_t               ntt_mem_base_addr_o,
  output pwo_mem_addr_t               pwo_mem_base_addr_o,
  output logic                        ntt_masking_en_o,
  output logic                        ntt_shuffling_en_o,
  input logic                         ntt_busy_i,

  //aux interfaces
  output logic [ABR_MEM_ADDR_WIDTH-1:0] aux_src0_base_addr_o,
  output logic [ABR_MEM_ADDR_WIDTH-1:0] aux_src1_base_addr_o,
  output logic [ABR_MEM_ADDR_WIDTH-1:0] aux_dest_base_addr_o,

  output logic                        split_en_o,
  output logic                        recombine_en_o,
  output logic                        recombine_mode_o,    // 0 = MLDSA, 1 = MLKEM

  output logic power2round_enable_o,
  input mem_if_t [1:0] pwr2rnd_keymem_if_i,
  input logic [1:0] [ABR_REG_WIDTH-1:0] pwr2rnd_wr_data_i,
  input logic pk_t1_wren_i,
  input logic [7:0][T1_COEFF_W-1:0] pk_t1_wrdata_i,
  input logic [7:0] pk_t1_wr_addr_i,
  input logic power2round_done_i,

  output logic decompose_enable_o,
  output logic decompose_mode_o,
  input logic decompose_done_i,

  output logic skencode_enable_o,
  input mem_if_t skencode_keymem_if_i,
  input logic [ABR_REG_WIDTH-1:0] skencode_wr_data_i,
  input logic skencode_done_i,

  output logic skdecode_enable_o,
  input mem_if_t [1:0] skdecode_keymem_if_i,
  output logic [1:0][ABR_REG_WIDTH-1:0] skdecode_rd_data_o,
  output logic [1:0] skdecode_rd_data_valid_o,
  input logic skdecode_done_i,
  input logic skdecode_error_i,

  output logic makehint_enable_o,
  input logic makehint_invalid_i,
  input logic makehint_done_i,
  input logic makehint_reg_wren_i,
  input logic [3:0][7:0] makehint_reg_wrdata_i,
  input logic [ABR_MEM_ADDR_WIDTH-1:0] makehint_reg_wr_addr_i,

  output logic normcheck_enable_o,
  output logic [1:0] normcheck_mode_o,
  input logic normcheck_invalid_i,
  input logic normcheck_done_i,

  output logic sigencode_enable_o,
  input mem_if_t sigencode_wr_req_i,
  input logic [1:0][3:0][19:0] sigencode_wr_data_i,
  input logic sigencode_done_i,

  output logic pkdecode_enable_o,
  input logic pkdecode_rd_en_i,
  input logic [7:0] pkdecode_rd_addr_i,
  output logic [7:0][T1_COEFF_W-1:0] pkdecode_rd_data_o,
  output logic pkdecode_rd_data_valid_o,
  input logic pkdecode_done_i,

  output logic sigdecode_h_enable_o, 
  output logic [SIGNATURE_H_VALID_NUM_BYTES-1:0][7:0] signature_h_o,
  input logic sigdecode_h_invalid_i,
  input logic sigdecode_h_done_i,

  output logic sigdecode_z_enable_o, 
  input mem_if_t sigdecode_z_rd_req_i,
  output logic [1:0][3:0][19:0] sigdecode_z_rd_data_o,
  output logic sigdecode_z_rd_data_valid_o,
  input logic sigdecode_z_done_i,

  output logic compress_enable_o,
  output compress_mode_t compress_mode_o,
  output logic compress_compare_mode_o,
  output logic [2:0] compress_num_poly_o,
  input logic compress_done_i,
  input logic compress_compare_failed_i,
  input logic [1:0] compress_api_rw_en_i,
  input logic [ABR_MEM_ADDR_WIDTH-1:0] compress_api_rw_addr_i,
  input logic [ABR_REG_WIDTH-1:0] compress_api_wr_data_i,
  output logic [ABR_REG_WIDTH-1:0] compress_api_rd_data_o,
  output logic compress_api_rd_data_valid_o,

  output logic decompress_enable_o,
  input logic decompress_done_i,
  output decompress_mode_t decompress_mode_o,
  output logic [2:0] decompress_num_poly_o,
  input logic decompress_api_rd_en_i,
  input logic [ABR_MEM_ADDR_WIDTH-1:0] decompress_api_rd_addr_i,
  output logic [1:0][ABR_REG_WIDTH-1:0] decompress_api_rd_data_o,
  output logic decompress_api_rd_data_valid_o,

  output logic lfsr_enable_o,
  // Aggregated LFSR seed: NTT seeds plus (when SHA3 masking is enabled) the
  // masked-Keccak DOM and message-mask LFSR seeds. All fields are carved from
  // currently-unused upper SHAKE-squeeze bits and are mutually disjoint.
  output abr_lfsr_seed_t lfsr_seed_o,

  //Memory interface export
  abr_sram_if.req sk_bank0_mem_if,
  abr_sram_if.req sk_bank1_mem_if,
  abr_sram_be_if.req sig_z_mem_if,
  abr_sram_be_if.req pk_mem_if,

  output mem_if_t zeroize_mem_o,

  `ifdef CALIPTRA
  // KV interface
  output kv_read_t [2:0] kv_read,
  input kv_rd_resp_t [2:0] kv_rd_resp,
  output kv_write_t kv_write,
  input kv_wr_resp_t kv_wr_resp,
  //PCR Signing
  input pcr_signing_t pcr_signing_data,
  input logic ocp_lock_in_progress,
  `endif

  input logic debugUnlock_or_scan_mode_switch,
  output logic busy_o,

  //Interrupts
  output logic error_intr,
  output logic notif_intr

  );

  abr_reg__in_t abr_reg_hwif_in;
  abr_reg__out_t abr_reg_hwif_out;
  abr_scratch_reg_u abr_scratch_reg;
  logic abr_ready;
  logic abr_idle;
  logic mldsa_valid_reg;
  logic mlkem_valid_reg;
  logic mldsa_privkey_lock, mlkem_dk_lock;
  logic kv_mldsa_seed_data_present, kv_mlkem_seed_data_present, kv_mlkem_msg_data_present;
  logic kv_mlkem_msg_nonzero;
  logic kv_mlkem_msg_write_en;
  logic [$clog2(MLKEM_MSG_MEM_NUM_DWORDS)-1:0] kv_mlkem_msg_write_offset;
  logic [ABR_REG_WIDTH-1:0] kv_mlkem_msg_write_data;

  logic external_mu;
  logic external_mu_mode, external_mu_mode_nxt;

  `ifdef CALIPTRA
  //Custom keyvault logic for Caliptra
  logic kv_mldsa_seed_write_en;
  logic [$clog2(SEED_NUM_DWORDS)-1:0] kv_mldsa_seed_write_offset;
  logic [ABR_REG_WIDTH-1:0] kv_mldsa_seed_write_data;
  logic kv_mlkem_seed_write_en;
  logic [$clog2(2*SEED_NUM_DWORDS)-1:0] kv_mlkem_seed_write_offset;
  logic [ABR_REG_WIDTH-1:0] kv_mlkem_seed_write_data;
  kv_read_ctrl_reg_t kv_mldsa_seed_read_ctrl_reg;
  kv_read_ctrl_reg_t kv_mlkem_seed_read_ctrl_reg;
  kv_read_ctrl_reg_t kv_mlkem_msg_read_ctrl_reg;
  kv_write_ctrl_reg_t kv_mlkem_sharedkey_write_ctrl_reg;
  kv_read_filter_metrics_t kv_mldsa_seed_read_metrics;
  kv_read_filter_metrics_t kv_mlkem_seed_read_metrics;
  kv_read_filter_metrics_t kv_mlkem_msg_read_metrics;
  kv_write_filter_metrics_t kv_mlkem_sharedkey_write_metrics;
  kv_error_code_e kv_mldsa_seed_error;
  kv_error_code_e kv_mlkem_seed_error;
  kv_error_code_e kv_mlkem_msg_error;
  kv_error_code_e kv_mlkem_sharedkey_error;
  logic kv_mldsa_seed_ready, kv_mldsa_seed_done;
  logic kv_mlkem_seed_ready, kv_mlkem_seed_done;
  logic kv_mlkem_msg_ready, kv_mlkem_msg_done;
  logic kv_mlkem_sharedkey_ready, kv_mlkem_sharedkey_done;
  logic kv_mldsa_seed_data_present_set;
  logic kv_mlkem_seed_data_present_set;
  logic kv_mlkem_msg_data_present_set;
  logic pcr_sign_mode;
  logic pcr_sign_input_invalid;
  logic dest_keyvault;
  logic kv_dest_data_avail;

  logic [SHAREDKEY_NUM_DWORDS-1:0][3:0][7:0] mlkem_sharedkey_data;

  `CALIPTRA_KV_READ_STATUS_ASSIGN(kv_mldsa_seed, abr_reg_hwif_in, zeroize)
  `CALIPTRA_KV_READ_STATUS_ASSIGN(kv_mlkem_seed, abr_reg_hwif_in, zeroize)
  `CALIPTRA_KV_READ_STATUS_ASSIGN(kv_mlkem_msg, abr_reg_hwif_in, zeroize)
  `CALIPTRA_KV_WRITE_STATUS_ASSIGN(kv_mlkem_sharedkey, abr_reg_hwif_in, zeroize)
  `CALIPTRA_KV_READ_CTRL_REG2STRUCT(kv_mldsa_seed_read_ctrl_reg, kv_mldsa_seed_rd_ctrl, abr_reg_hwif_out)
  `CALIPTRA_KV_READ_CTRL_REG2STRUCT(kv_mlkem_seed_read_ctrl_reg, kv_mlkem_seed_rd_ctrl, abr_reg_hwif_out)
  `CALIPTRA_KV_READ_CTRL_REG2STRUCT(kv_mlkem_msg_read_ctrl_reg,  kv_mlkem_msg_rd_ctrl, abr_reg_hwif_out)
  `CALIPTRA_KV_WRITE_CTRL_REG2STRUCT(kv_mlkem_sharedkey_write_ctrl_reg,  kv_mlkem_sharedkey_wr_ctrl, abr_reg_hwif_out)

  //Detect keyvault data coming in to lock api registers and protect outputs
  always_comb kv_mldsa_seed_data_present_set = kv_mldsa_seed_read_ctrl_reg.read_en | pcr_sign_mode;
  always_comb kv_mlkem_seed_data_present_set = kv_mlkem_seed_read_ctrl_reg.read_en;
  always_comb kv_mlkem_msg_data_present_set = kv_mlkem_msg_read_ctrl_reg.read_en;
  
  //lock kv controls
  always_comb abr_reg_hwif_in.kv_mldsa_seed_rd_ctrl.read_en.swwe         = !kv_mldsa_seed_data_present && abr_ready;
  always_comb abr_reg_hwif_in.kv_mldsa_seed_rd_ctrl.read_entry.swwe      = !kv_mldsa_seed_data_present && abr_ready;
  always_comb abr_reg_hwif_in.kv_mldsa_seed_rd_ctrl.pcr_hash_extend.swwe = '0;
  always_comb abr_reg_hwif_in.kv_mldsa_seed_rd_ctrl.rsvd.swwe            = '0;
  always_comb abr_reg_hwif_in.kv_mlkem_seed_rd_ctrl.read_en.swwe         = !kv_mlkem_seed_data_present && abr_ready;
  always_comb abr_reg_hwif_in.kv_mlkem_seed_rd_ctrl.read_entry.swwe      = !kv_mlkem_seed_data_present && abr_ready;
  always_comb abr_reg_hwif_in.kv_mlkem_seed_rd_ctrl.pcr_hash_extend.swwe = '0;
  always_comb abr_reg_hwif_in.kv_mlkem_seed_rd_ctrl.rsvd.swwe            = '0;
  always_comb abr_reg_hwif_in.kv_mlkem_msg_rd_ctrl.read_en.swwe          = !kv_mlkem_msg_data_present  && abr_ready;
  always_comb abr_reg_hwif_in.kv_mlkem_msg_rd_ctrl.read_entry.swwe       = !kv_mlkem_msg_data_present  && abr_ready;
  always_comb abr_reg_hwif_in.kv_mlkem_msg_rd_ctrl.pcr_hash_extend.swwe  = '0;
  always_comb abr_reg_hwif_in.kv_mlkem_msg_rd_ctrl.rsvd.swwe             = '0;
  always_comb abr_reg_hwif_in.kv_mlkem_sharedkey_wr_ctrl.write_en.swwe              = abr_ready;
  always_comb abr_reg_hwif_in.kv_mlkem_sharedkey_wr_ctrl.write_entry.swwe           = abr_ready;
  always_comb abr_reg_hwif_in.kv_mlkem_sharedkey_wr_ctrl.hmac_key_dest_valid.swwe   = abr_ready;
  always_comb abr_reg_hwif_in.kv_mlkem_sharedkey_wr_ctrl.hmac_block_dest_valid.swwe = abr_ready;
  always_comb abr_reg_hwif_in.kv_mlkem_sharedkey_wr_ctrl.mldsa_seed_dest_valid.swwe = abr_ready;
  always_comb abr_reg_hwif_in.kv_mlkem_sharedkey_wr_ctrl.ecc_pkey_dest_valid.swwe   = abr_ready;
  always_comb abr_reg_hwif_in.kv_mlkem_sharedkey_wr_ctrl.ecc_seed_dest_valid.swwe   = abr_ready;
  always_comb abr_reg_hwif_in.kv_mlkem_sharedkey_wr_ctrl.aes_key_dest_valid.swwe    = abr_ready;
  always_comb abr_reg_hwif_in.kv_mlkem_sharedkey_wr_ctrl.mlkem_seed_dest_valid.swwe = abr_ready;
  always_comb abr_reg_hwif_in.kv_mlkem_sharedkey_wr_ctrl.mlkem_msg_dest_valid.swwe  = abr_ready;
  always_comb abr_reg_hwif_in.kv_mlkem_sharedkey_wr_ctrl.dma_data_dest_valid.swwe   = abr_ready;
  always_comb abr_reg_hwif_in.kv_mlkem_sharedkey_wr_ctrl.rsvd.swwe                  = '0;

  //OCP Lock filtering rules inputs
  always_comb begin
    //MLDSA SEED
    kv_mldsa_seed_read_metrics.ocp_lock_in_progress = ocp_lock_in_progress;
    kv_mldsa_seed_read_metrics.kv_read_dest         = KV_NUM_READ'(1<<KV_DEST_IDX_MLDSA_SEED);
    kv_mldsa_seed_read_metrics.kv_key_entry         = kv_mldsa_seed_read_ctrl_reg.read_entry;
    //MLKEM SEED
    kv_mlkem_seed_read_metrics.ocp_lock_in_progress = ocp_lock_in_progress;
    kv_mlkem_seed_read_metrics.kv_read_dest         = KV_NUM_READ'(1<<KV_DEST_IDX_MLKEM_SEED);
    kv_mlkem_seed_read_metrics.kv_key_entry         = kv_mlkem_seed_read_ctrl_reg.read_entry;
    //MLKEM MSG
    kv_mlkem_msg_read_metrics.ocp_lock_in_progress  = ocp_lock_in_progress;
    kv_mlkem_msg_read_metrics.kv_read_dest          = KV_NUM_READ'(1<<KV_DEST_IDX_MLKEM_MSG);
    kv_mlkem_msg_read_metrics.kv_key_entry          = kv_mlkem_msg_read_ctrl_reg.read_entry;
    //MLKEM SHARED KEY
    kv_mlkem_sharedkey_write_metrics.ocp_lock_in_progress = ocp_lock_in_progress;
    kv_mlkem_sharedkey_write_metrics.kv_data0_present     = kv_mlkem_seed_data_present;
    kv_mlkem_sharedkey_write_metrics.kv_data0_entry       = kv_mlkem_seed_read_ctrl_reg.read_entry;
    kv_mlkem_sharedkey_write_metrics.kv_data1_present     = kv_mlkem_msg_data_present;
    kv_mlkem_sharedkey_write_metrics.kv_data1_entry       = kv_mlkem_msg_read_ctrl_reg.read_entry;
    kv_mlkem_sharedkey_write_metrics.kv_write_src         = KV_NUM_WRITE'(1 << KV_WRITE_IDX_MLKEM);
    kv_mlkem_sharedkey_write_metrics.kv_write_entry       = kv_mlkem_sharedkey_write_ctrl_reg.write_entry;
    kv_mlkem_sharedkey_write_metrics.aes_decrypt_ecb_op   = 1'b0;
  end

  //Read ML-DSA SEED
  kv_read_client #(
    .DATA_WIDTH(SEED_NUM_DWORDS*32),
    .PAD(0)
  )
  kv_mldsa_seed_read_inst
  (
    .clk(clk),
    .rst_b(rst_b),
    .zeroize(zeroize),

    //client control register
    .read_ctrl_reg(kv_mldsa_seed_read_ctrl_reg),
    .read_metrics(kv_mldsa_seed_read_metrics),

    //interface with kv
    .kv_read(kv_read[0]),
    .kv_resp(kv_rd_resp[0]),

    //interface with client
    .write_en(kv_mldsa_seed_write_en),
    .write_offset(kv_mldsa_seed_write_offset),
    .write_data(kv_mldsa_seed_write_data),

    .error_code(kv_mldsa_seed_error),
    .kv_ready(kv_mldsa_seed_ready),
    .read_done(kv_mldsa_seed_done),
    .check_key_size(1'b0),
    .expected_key_size(KV_ENTRY_SIZE_W'(SEED_NUM_DWORDS-1))
  );

  //Read ML-KEM SEED
  kv_read_client #(
    .DATA_WIDTH(2*SEED_NUM_DWORDS*32),
    .PAD(0)
  )
  kv_mlkem_seed_read_inst
  (
    .clk(clk),
    .rst_b(rst_b),
    .zeroize(zeroize),

    //client control register
    .read_ctrl_reg(kv_mlkem_seed_read_ctrl_reg),
    .read_metrics(kv_mlkem_seed_read_metrics),

    //interface with kv
    .kv_read(kv_read[1]),
    .kv_resp(kv_rd_resp[1]),

    //interface with client
    .write_en(kv_mlkem_seed_write_en),
    .write_offset(kv_mlkem_seed_write_offset),
    .write_data(kv_mlkem_seed_write_data),

    .error_code(kv_mlkem_seed_error),
    .kv_ready(kv_mlkem_seed_ready),
    .read_done(kv_mlkem_seed_done),
    .check_key_size(1'b0),
    .expected_key_size(KV_ENTRY_SIZE_W'(2*SEED_NUM_DWORDS-1))
  );

  //Read ML-KEM SEED
  kv_read_client #(
    .DATA_WIDTH(MLKEM_MSG_MEM_NUM_DWORDS*32),
    .PAD(0)
  )
  kv_mlkem_msg_read_inst
  (
    .clk(clk),
    .rst_b(rst_b),
    .zeroize(zeroize),

    //client control register
    .read_ctrl_reg(kv_mlkem_msg_read_ctrl_reg),
    .read_metrics(kv_mlkem_msg_read_metrics),

    //interface with kv
    .kv_read(kv_read[2]),
    .kv_resp(kv_rd_resp[2]),

    //interface with client
    .write_en(kv_mlkem_msg_write_en),
    .write_offset(kv_mlkem_msg_write_offset),
    .write_data(kv_mlkem_msg_write_data),

    .error_code(kv_mlkem_msg_error),
    .kv_ready(kv_mlkem_msg_ready),
    .read_done(kv_mlkem_msg_done),
    .check_key_size(1'b0),
    .expected_key_size(KV_ENTRY_SIZE_W'(MLKEM_MSG_MEM_NUM_DWORDS-1))
  );

kv_write_client #(
  .DATA_WIDTH(SHAREDKEY_NUM_DWORDS*32),
  .KV_WRITE_SWAP_DWORDS(0)
)
kv_mlkem_sharedkey_write_inst
(
  .clk(clk),
  .rst_b(rst_b),
  .zeroize(zeroize),

  //client control register
  .write_ctrl_reg(kv_mlkem_sharedkey_write_ctrl_reg),
  .num_dwords(SHAREDKEY_NUM_DWORDS[3:0]), 
  .write_metrics(kv_mlkem_sharedkey_write_metrics),

  //interface with kv
  .kv_write(kv_write),
  .kv_resp(kv_wr_resp),

  //interface with client
  .dest_keyvault(dest_keyvault),
  .dest_data_avail(kv_dest_data_avail),
  .dest_data(mlkem_sharedkey_data),

  .error_code(kv_mlkem_sharedkey_error),
  .kv_ready(kv_mlkem_sharedkey_ready),
  .dest_done(kv_mlkem_sharedkey_done)
);
//Swizzle the data to match KV endianness
always_comb begin
  for(int d = 0; d < SHAREDKEY_NUM_DWORDS; d++) begin
    for(int b = 0; b < 4; b++) begin
      mlkem_sharedkey_data[d][b] = abr_scratch_reg.mlkem_enc.shared_key[SHAREDKEY_NUM_DWORDS-1-d][(b*8) +: 8];
    end
  end
end

always_ff @(posedge clk or negedge rst_b) begin : abr_kv_reg
  if (!rst_b) begin
    kv_mldsa_seed_data_present <= '0;
    kv_mlkem_seed_data_present <= '0;
    kv_mlkem_msg_data_present <= '0;
    kv_mlkem_msg_nonzero <= '0;
  end else if (zeroize) begin
    kv_mldsa_seed_data_present <= '0;
    kv_mlkem_seed_data_present <= '0;
    kv_mlkem_msg_data_present <= '0;
    kv_mlkem_msg_nonzero <= '0;
  end else begin
    kv_mldsa_seed_data_present <=  kv_mldsa_seed_data_present_set ? '1 : kv_mldsa_seed_data_present;
    kv_mlkem_seed_data_present <=  kv_mlkem_seed_data_present_set ? '1 : kv_mlkem_seed_data_present;
    kv_mlkem_msg_data_present  <=  kv_mlkem_msg_data_present_set ? '1 : kv_mlkem_msg_data_present;
    // Track whether any nonzero dword was written from KV for msg
    if (kv_mlkem_msg_write_en & |kv_mlkem_msg_write_data)
      kv_mlkem_msg_nonzero <= 1'b1;
  end
end

always_comb pcr_sign_mode = abr_reg_hwif_out.MLDSA_CTRL.PCR_SIGN.value;

`else
  `CALIPTRA_KV_RD_TIEOFF(kv_mldsa_seed, abr_reg_hwif_in)
  `CALIPTRA_KV_RD_TIEOFF(kv_mlkem_seed, abr_reg_hwif_in)
  `CALIPTRA_KV_RD_TIEOFF(kv_mlkem_msg, abr_reg_hwif_in)
  `CALIPTRA_KV_WR_TIEOFF(kv_mlkem_sharedkey, abr_reg_hwif_in)

always_comb kv_mldsa_seed_data_present = '0;
always_comb kv_mlkem_seed_data_present = '0;
always_comb kv_mlkem_msg_data_present = '0;
always_comb kv_mlkem_msg_nonzero = '0;

always_comb kv_mlkem_msg_write_en = '0;
always_comb kv_mlkem_msg_write_offset = '0;
always_comb kv_mlkem_msg_write_data = '0;
`endif

  mldsa_cmd_e mldsa_cmd_reg;
  mlkem_cmd_e mlkem_cmd_reg;

  logic mldsa_keygen_process, mldsa_keygen_process_nxt;
  logic mldsa_signing_process, mldsa_signing_process_nxt;
  logic mldsa_verifying_process, mldsa_verifying_process_nxt;
  logic mldsa_keygen_signing_process, mldsa_keygen_signing_process_nxt;
  logic mldsa_keygen_done,mldsa_signature_done,mldsa_verify_done;
  logic mlkem_keygen_process, mlkem_keygen_process_nxt;
  logic mlkem_encaps_process, mlkem_encaps_process_nxt;
  logic mlkem_decaps_process, mlkem_decaps_process_nxt;
  logic mlkem_keygen_decaps_process, mlkem_keygen_decaps_process_nxt;
  logic mlkem_keygen_done,mlkem_encaps_done,mlkem_decaps_done;
  logic mldsa_process_done;
  logic mlkem_process_done;

  //assign appropriate data to msg interface
  logic [ABR_OPR_WIDTH-1:0]  sampler_src;
  logic [15:0]               sampler_src_offset;
  logic [SRAM_LATENCY:0][2:0] sampler_src_offset_stg;
  logic [15:0]               sampler_imm;
  
  logic [ENTROPY_NUM_DWORDS-1 : 0][ABR_REG_WIDTH-1:0] entropy_reg;
  logic [SEED_NUM_DWORDS-1 : 0][ABR_REG_WIDTH-1:0] mldsa_seed_reg;
  logic [SEED_NUM_DWORDS-1 : 0][ABR_REG_WIDTH-1:0] mlkem_seed_d_reg;
  logic [MLDSA_MSG_NUM_DWORDS-1 : 0][ABR_REG_WIDTH-1:0] msg_reg;
  logic internal_mu_we;
  logic [MU_NUM_DWORDS-1 : 0][ABR_REG_WIDTH-1:0] internal_mu_reg;
  logic [MU_NUM_DWORDS-1 : 0][ABR_REG_WIDTH-1:0] external_mu_reg;
  logic [SIGN_RND_NUM_DWORDS-1 : 0][ABR_REG_WIDTH-1:0] sign_rnd_reg;
  logic [7:0][63:0] mu_reg;
  logic [15:0] kappa_reg;
  logic update_kappa;

  logic [MsgWidth-1:0] msg_data;
  logic stream_msg_mode;
  logic stream_msg_rdy;
  logic stream_msg_valid;
  logic [3:0] stream_msg_strobe;
  logic stream_msg_last;
  logic stream_msg_done;
  logic stream_msg_ip;

  logic [31:0] stream_msg_data;
  logic [63:0] stream_msg_buffer_data;
  logic        stream_msg_buffer_valid;
  logic [7:0]  stream_msg_buffer_strobe;
  logic        stream_msg_buffer_flush;

  logic [CTX_NUM_DWORDS-1:0][ABR_REG_WIDTH-1:0] ctx_reg;
  logic [CTX_SIZE_W-1:0] ctx_size;
  logic [CTX_SIZE_W-$clog2(STREAM_MSG_STROBE_W)-1:0] ctx_cnt_required;
  logic [$clog2(STREAM_MSG_STROBE_W)-1:0] ctx_cnt_offset;

  mldsa_stream_msg_fsm_state_e stream_msg_fsm_ps, stream_msg_fsm_ns;
  logic [CTX_SIZE_W-$clog2(STREAM_MSG_STROBE_W)-1:0] ctx_cnt,ctx_cnt_nxt;

  logic abr_seq_en;
  logic [ABR_PROG_ADDR_W-1 : 0] abr_prog_cntr, abr_prog_cntr_nxt;
  abr_seq_instr_t abr_instr_o, abr_instr;

  logic msg_done;
  logic msg_last;
  logic [MsgStrbW-1:0] msg_strobe_nxt, last_msg_strobe;
  logic [ABR_OPR_WIDTH-1:$clog2(MsgStrbW)] msg_cnt_nxt, msg_cnt;
  logic msg_valid_nxt;

  logic error_flag;
  logic error_flag_reg;
  logic error_flag_edge;
  logic mldsa_seed_zero_error;
  logic mlkem_seed_zero_error;
  logic mlkem_msg_zero_error;
  logic subcomponent_busy;

  abr_ctrl_fsm_state_e abr_ctrl_fsm_ps, abr_ctrl_fsm_ns;
  logic msg_valid, msg_valid_stg;
  logic msg_cnt_inc;

  mldsa_signature_u signature_reg;

  //signature and verify validity checks
  logic signature_valid, set_signature_valid, clear_signature_valid;
  logic verify_valid, set_verify_valid, clear_verify_valid;
  logic decaps_valid, set_decaps_valid, clear_decaps_valid;
  logic encaps_input_check_failure;
  logic decaps_input_check_failure;

  //Explicit hardware signature verification result
  logic mldsa_verify_res_we;
  logic mldsa_verify_res_match;
  logic mldsa_verify_pass_reg;

  //per controller enable/busy for ntt
  logic ntt_en;
  logic ntt_busy;

  logic [ABR_MEM_ADDR_WIDTH-1:0] ntt_temp_address;

  //Interrupts
  logic abr_status_done;

  logic set_entropy;
  logic [7:0][63:0] lfsr_entropy_reg;
  logic [MsgWidth-1:0] counter_reg;

  logic zeroize_mem_we;
  logic zeroize_mem_we_pk, zeroize_mem_we_sk, zeroize_mem_we_sig;
  logic [ABR_MEM_ADDR_WIDTH-1:0] zeroize_mem_addr;
  logic zeroize_mem_done;
  

  //Private Key and Decaps Key External Memory
  //Request muxing
  logic [1:0] sk_ram_we_bank, sk_ram_re_bank;
  logic [1:0][SK_MEM_BANK_ADDR_W-1:0] sk_ram_waddr_bank, sk_ram_raddr_bank;
  logic [1:0][ABR_REG_WIDTH-1:0] sk_ram_wdata, sk_ram_rdata;

  logic [1:0] skencode_keymem_we_bank, pwr2rnd_keymem_we_bank, api_keymem_we_bank;
  logic [1:0] mlkem_api_dk_we_bank, mlkem_api_ek_we_bank, mlkem_api_ct_we_bank, mlkem_api_msg_we_bank;
  logic [ABR_REG_WIDTH-1:0] mlkem_msg_wdata;
  logic [1:0] compress_keymem_we_bank;
  logic [SRAM_LATENCY:0][1:0] compress_keymem_re_bank; 
  logic [SRAM_LATENCY:0] decompress_keymem_re;
  logic [SK_MEM_BANK_ADDR_W:0] api_sk_waddr, api_sk_raddr;
  logic [SK_MEM_BANK_ADDR_W:0] api_sk_mem_waddr, api_sk_mem_raddr;
  logic [5:0] api_sk_reg_waddr, api_sk_reg_raddr;
  logic [1:0] api_sk_re_bank;
  logic [SRAM_LATENCY:0][1:0] api_keymem_re_bank;
  logic [SRAM_LATENCY:0] api_sk_reg_re;

  logic api_keymem_wr_dec, api_sk_reg_wr_dec;
  logic api_keymem_rd_dec, api_sk_reg_rd_dec;
  logic api_keymem_rd_vld;

  logic [SRAM_LATENCY:0][1:0] skdecode_re_bank;
  logic [1:0][SK_MEM_BANK_ADDR_W:0] skdecode_rdaddr;

  logic [SK_MEM_BANK_ADDR_W:0] mlkem_api_dk_addr;
  logic [SK_MEM_BANK_ADDR_W:0] mlkem_api_dk_mem_addr;
  logic [5:0] mlkem_api_dk_reg_addr;
  logic [1:0] mlkem_api_dk_re_bank;

  logic mlkem_api_dk_mem_dec, mlkem_api_dk_reg_dec;
  logic mlkem_api_dk_rd_vld;

  logic [SK_MEM_BANK_ADDR_W:0] mlkem_api_ek_addr;
  logic [SK_MEM_BANK_ADDR_W:0] mlkem_api_ek_mem_addr;
  logic [5:0] mlkem_api_ek_reg_addr;
  logic [1:0] mlkem_api_ek_re_bank;

  logic mlkem_api_ek_mem_dec, mlkem_api_ek_reg_dec;
  logic mlkem_api_ek_rd_vld;

  logic [SK_MEM_BANK_ADDR_W:0] mlkem_api_ct_addr;
  logic [SK_MEM_BANK_ADDR_W:0] mlkem_api_ct_mem_addr;
  logic [1:0] mlkem_api_ct_re_bank;

  logic mlkem_api_ct_mem_dec, mlkem_api_ct_rd_vld;

  logic [SK_MEM_BANK_ADDR_W:0] mlkem_api_msg_waddr;
  logic [SK_MEM_BANK_ADDR_W:0] mlkem_api_msg_mem_waddr;
  logic mlkem_api_msg_mem_wr_dec;

  logic [SRAM_LATENCY:0] privkey_out_rd_ack, signature_rd_ack, pubkey_rd_ack;
  logic [SRAM_LATENCY:0] encapskey_rd_ack, decapskey_rd_ack, ciphertext_rd_ack;

  logic [ABR_REG_WIDTH-1:0] privkey_out_rdata;

  logic [ABR_REG_WIDTH-1:0] api_reg_rdata;

  //Signature external mem
  logic sig_z_ram_we, sig_z_ram_re;
  logic [SRAM_LATENCY:0] sigdecode_z_ram_re;
  logic [SIG_Z_MEM_ADDR_W-1:0] sig_z_ram_waddr, sig_z_ram_raddr;
  logic [SIG_Z_MEM_NUM_DWORD-1:0][31:0] sig_z_ram_wdata, sig_z_ram_rdata;
  logic [SIG_Z_MEM_WSTROBE_W-1:0] sig_z_ram_wstrobe;
  logic api_sig_z_dec, api_sig_h_dec, api_sig_c_dec;
  logic [SRAM_LATENCY:0] api_sig_z_re;
  logic api_sig_z_we;
  logic api_sig_reg_re;
  logic [SIG_ADDR_W-1:0] api_sig_addr;
  mldsa_signature_z_addr_t [SRAM_LATENCY:0] api_sig_z_addr;
  logic [SIG_C_REG_ADDR_W-1:0] api_sig_c_addr;
  logic [SIG_H_REG_ADDR_W-1:0] api_sig_h_addr;
  logic [ABR_REG_WIDTH-1:0] signature_reg_rdata;

//public key memory
  logic pubkey_ram_we, pubkey_ram_re;
  logic [PK_MEM_ADDR_W-1:0] pubkey_ram_waddr, pubkey_ram_raddr;
  logic [PK_MEM_NUM_DWORDS-1:0][31:0] pubkey_ram_wdata, pubkey_ram_rdata;
  logic [31:0][T1_COEFF_W-1:0] pubkey_ram_rdata_t1;
  logic [PK_MEM_WSTROBE_W-1:0] pubkey_ram_wstrobe;
  logic api_pubkey_dec, api_pubkey_rho_dec;
  logic [SRAM_LATENCY:0] api_pubkey_re;
  logic api_pubkey_we;
  logic [PK_ADDR_W-1:0] api_pubkey_addr;
  mldsa_pubkey_mem_addr_t api_pubkey_mem_addr[SRAM_LATENCY:0];
  mldsa_pubkey_mem_addr_t sampler_pubkey_mem_addr;
  logic [5:0] api_pk_reg_raddr,api_pk_reg_waddr;
  logic [SRAM_LATENCY:0] sampler_pk_rd_en;
  logic [SRAM_LATENCY:0] pkdecode_rd_en;
  logic [SRAM_LATENCY:0] sampler_sk_rd_en;
  logic [SK_MEM_BANK_ADDR_W-1:0] sampler_sk_rd_offset;
  logic [SRAM_LATENCY:0][1:0] pkdecode_rd_offset;

  assign abr_reg_hwif_in_o = abr_reg_hwif_in;
  assign abr_reg_hwif_out = abr_reg_hwif_out_i;

  //ABR Ready allows writes to api registers
  //No writes allowed during operation or when keyvault reads are in progress
  `ifdef CALIPTRA
  always_comb abr_ready = (abr_prog_cntr == ABR_RESET) &
                           kv_mlkem_seed_ready &
                           kv_mlkem_msg_ready &
                           kv_mldsa_seed_ready &
                           kv_mlkem_sharedkey_ready;

  always_comb abr_idle = ((abr_prog_cntr == ABR_RESET) | (abr_prog_cntr == ABR_ZEROIZE) |
                           mldsa_valid_reg | mlkem_valid_reg) &
                           kv_mlkem_seed_ready &
                           kv_mlkem_msg_ready &
                           kv_mldsa_seed_ready &
                           kv_mlkem_sharedkey_ready;

  always_comb kv_dest_data_avail = dest_keyvault & 
                                   ((mlkem_encaps_process & mlkem_encaps_done) |
                                    (mlkem_decaps_process & mlkem_decaps_done));   
  `else
  always_comb abr_ready = (abr_prog_cntr == ABR_RESET);
  always_comb abr_idle = ((abr_prog_cntr == ABR_RESET) | (abr_prog_cntr == ABR_ZEROIZE) |
                           mldsa_valid_reg | mlkem_valid_reg);
  `endif

  //without zeroize to make it more complex
  always_ff @(posedge clk or negedge rst_b) begin
    if (!rst_b)
      counter_reg <= '0;
    else
      counter_reg <= counter_reg + 1;
  end

  //Set busy when engine is in progress
  always_comb busy_o = ~abr_idle;
  always_comb zeroize = abr_reg_hwif_out.MLDSA_CTRL.ZEROIZE.value || 
                        abr_reg_hwif_out.MLKEM_CTRL.ZEROIZE.value ||
                        debugUnlock_or_scan_mode_switch;

  always_comb abr_reg_hwif_in.reset_b = rst_b;
  always_comb abr_reg_hwif_in.hard_reset_b = rst_b; //no sticky registers
  always_comb abr_reg_hwif_in.abr_ready = abr_ready;
  always_comb abr_reg_hwif_in.MLDSA_CTRL.CTRL.hwclr = |mldsa_cmd_reg;
  always_comb abr_reg_hwif_in.MLKEM_CTRL.CTRL.hwclr = |mlkem_cmd_reg;
  `ifdef CALIPTRA
    always_comb abr_reg_hwif_in.MLDSA_CTRL.PCR_SIGN.hwclr = abr_reg_hwif_out.MLDSA_CTRL.PCR_SIGN.value;
    always_comb mldsa_cmd_reg = mldsa_cmd_e'(abr_reg_hwif_out.MLDSA_CTRL.CTRL.value & {$bits(mldsa_cmd_reg){kv_mldsa_seed_ready}});
    always_comb mlkem_cmd_reg = mlkem_cmd_e'(abr_reg_hwif_out.MLKEM_CTRL.CTRL.value & 
                                            {$bits(mlkem_cmd_reg){kv_mlkem_seed_ready}} & 
                                            {$bits(mlkem_cmd_reg){kv_mlkem_msg_ready}});
  `else
    always_comb abr_reg_hwif_in.MLDSA_CTRL.PCR_SIGN.hwclr = '0;
    always_comb mldsa_cmd_reg = mldsa_cmd_e'(abr_reg_hwif_out.MLDSA_CTRL.CTRL.value);
    always_comb mlkem_cmd_reg = mlkem_cmd_e'(abr_reg_hwif_out.MLKEM_CTRL.CTRL.value);
  `endif
  
  always_comb external_mu = abr_reg_hwif_out.MLDSA_CTRL.EXTERNAL_MU.value;
  always_comb abr_reg_hwif_in.MLDSA_CTRL.EXTERNAL_MU.hwclr = abr_reg_hwif_out.MLDSA_CTRL.EXTERNAL_MU.value;

  always_comb begin : ABR_REG_HWIF_IN_ASSIGN
    //MLDSA
    abr_reg_hwif_in.MLDSA_NAME[0].NAME.next = MLDSA_CORE_NAME[31:0];
    abr_reg_hwif_in.MLDSA_NAME[1].NAME.next = MLDSA_CORE_NAME[63:32];
    abr_reg_hwif_in.MLDSA_VERSION[0].VERSION.next = MLDSA_CORE_VERSION[31:0];
    abr_reg_hwif_in.MLDSA_VERSION[1].VERSION.next = MLDSA_CORE_VERSION[63:32];

    abr_reg_hwif_in.MLDSA_STATUS.READY.next = abr_ready;
    abr_reg_hwif_in.MLDSA_STATUS.VALID.next = mldsa_valid_reg;
    abr_reg_hwif_in.MLDSA_STATUS.ERROR.next = error_flag_reg;
    abr_reg_hwif_in.MLDSA_STATUS.MSG_STREAM_READY.next = stream_msg_rdy;
    abr_reg_hwif_in.MLDSA_STATUS.VERIFY_PASS.next = mldsa_verify_pass_reg & ~error_flag_reg;

    stream_msg_mode = abr_reg_hwif_out.MLDSA_CTRL.STREAM_MSG.value;
    abr_reg_hwif_in.MLDSA_CTRL.STREAM_MSG.hwclr = zeroize;

    for (int unsigned dword=0; dword < ENTROPY_NUM_DWORDS; dword++) begin
      entropy_reg[dword] = abr_reg_hwif_out.ABR_ENTROPY[dword].ENTROPY.value;
      abr_reg_hwif_in.ABR_ENTROPY[dword].ENTROPY.hwclr = zeroize;
    end

    for (int unsigned dword=0; dword < SEED_NUM_DWORDS; dword++) begin
      mldsa_seed_reg[dword] = abr_reg_hwif_out.MLDSA_SEED[dword].SEED.value;

      `ifdef CALIPTRA
      abr_reg_hwif_in.MLDSA_SEED[dword].SEED.we = (pcr_sign_mode | (kv_mldsa_seed_write_en & (kv_mldsa_seed_write_offset == SEED_NUM_DWORDS-1-dword))) & ~zeroize;
      abr_reg_hwif_in.MLDSA_SEED[dword].SEED.next = pcr_sign_mode   ? pcr_signing_data.pcr_mldsa_signing_seed[SEED_NUM_DWORDS-1-dword] : 
                                                      kv_mldsa_seed_write_data;
      abr_reg_hwif_in.MLDSA_SEED[dword].SEED.hwclr = zeroize | (kv_mldsa_seed_error != KV_SUCCESS);
      abr_reg_hwif_in.MLDSA_SEED[dword].SEED.swwe = abr_ready & ~kv_mldsa_seed_data_present;
      `else
      abr_reg_hwif_in.MLDSA_SEED[dword].SEED.we = '0;
      abr_reg_hwif_in.MLDSA_SEED[dword].SEED.next = '0;
      abr_reg_hwif_in.MLDSA_SEED[dword].SEED.hwclr = zeroize;
      abr_reg_hwif_in.MLDSA_SEED[dword].SEED.swwe = abr_ready;
      `endif
    end
  
    for (int unsigned dword=0; dword < MLDSA_MSG_NUM_DWORDS; dword++) begin
      msg_reg[dword] = external_mu_mode? '0 : abr_reg_hwif_out.MLDSA_MSG[dword].MSG.value;
      `ifdef CALIPTRA
      abr_reg_hwif_in.MLDSA_MSG[dword].MSG.we = pcr_sign_mode & !external_mu & !zeroize;
      abr_reg_hwif_in.MLDSA_MSG[dword].MSG.next = pcr_signing_data.pcr_hash[MLDSA_MSG_NUM_DWORDS-1-dword];
      abr_reg_hwif_in.MLDSA_MSG[dword].MSG.hwclr = zeroize;
      `else
      abr_reg_hwif_in.MLDSA_MSG[dword].MSG.we = '0;
      abr_reg_hwif_in.MLDSA_MSG[dword].MSG.next = '0;
      abr_reg_hwif_in.MLDSA_MSG[dword].MSG.hwclr = zeroize;
      `endif
      abr_reg_hwif_in.MLDSA_MSG[dword].MSG.swwe = abr_ready | stream_msg_rdy;
    end

    for (int unsigned dword=0; dword < MU_NUM_DWORDS; dword++) begin
      external_mu_reg[dword] = abr_reg_hwif_out.MLDSA_EXTERNAL_MU[dword].EXTERNAL_MU.value;
      abr_reg_hwif_in.MLDSA_EXTERNAL_MU[dword].EXTERNAL_MU.we = internal_mu_we & !external_mu & !zeroize;
      abr_reg_hwif_in.MLDSA_EXTERNAL_MU[dword].EXTERNAL_MU.next = internal_mu_reg[dword];
      abr_reg_hwif_in.MLDSA_EXTERNAL_MU[dword].EXTERNAL_MU.hwclr = zeroize;
    end
  
    for (int unsigned dword=0; dword < SIGN_RND_NUM_DWORDS; dword++) begin
      sign_rnd_reg[dword] = abr_reg_hwif_out.MLDSA_SIGN_RND[dword].SIGN_RND.value;
      abr_reg_hwif_in.MLDSA_SIGN_RND[dword].SIGN_RND.hwclr = zeroize;
    end
  
    for (int unsigned dword=0; dword < VERIFY_RES_NUM_DWORDS; dword++) begin 
      abr_reg_hwif_in.MLDSA_VERIFY_RES[dword].VERIFY_RES.we = set_verify_valid | mldsa_verify_res_we;
      abr_reg_hwif_in.MLDSA_VERIFY_RES[dword].VERIFY_RES.next = set_verify_valid ? ~signature_reg.enc.c[dword] : sampler_state_data_i[dword*32 +: 32];
      abr_reg_hwif_in.MLDSA_VERIFY_RES[dword].VERIFY_RES.hwclr = zeroize;
    end
  
    abr_reg_hwif_in.MLDSA_MSG_STROBE.STROBE.swwe = stream_msg_rdy;
    abr_reg_hwif_in.MLDSA_MSG_STROBE.STROBE.hwclr = zeroize;

    for (int unsigned dword = 0; dword < CTX_NUM_DWORDS; dword++) begin
      ctx_reg[dword] = abr_reg_hwif_out.MLDSA_CTX[dword].CTX.value;
      abr_reg_hwif_in.MLDSA_CTX[dword].CTX.hwclr = zeroize;
    end
    ctx_size = abr_reg_hwif_out.MLDSA_CTX_CONFIG.CTX_SIZE.value;
    abr_reg_hwif_in.MLDSA_CTX_CONFIG.CTX_SIZE.hwclr = zeroize;

    //MLKEM
    abr_reg_hwif_in.MLKEM_NAME[0].NAME.next = MLKEM_CORE_NAME[31:0];
    abr_reg_hwif_in.MLKEM_NAME[1].NAME.next = MLKEM_CORE_NAME[63:32];
    abr_reg_hwif_in.MLKEM_VERSION[0].VERSION.next = MLKEM_CORE_VERSION[31:0];
    abr_reg_hwif_in.MLKEM_VERSION[1].VERSION.next = MLKEM_CORE_VERSION[63:32];

    abr_reg_hwif_in.MLKEM_STATUS.READY.next = abr_ready;
    abr_reg_hwif_in.MLKEM_STATUS.VALID.next = mlkem_valid_reg;
    abr_reg_hwif_in.MLKEM_STATUS.ERROR.next = error_flag_reg;

    for (int unsigned dword=0; dword < SEED_NUM_DWORDS; dword++) begin
      mlkem_seed_d_reg[dword] = abr_reg_hwif_out.MLKEM_SEED_D[dword].SEED.value;
      `ifdef CALIPTRA
      abr_reg_hwif_in.MLKEM_SEED_D[dword].SEED.we = ((kv_mlkem_seed_write_en & (kv_mlkem_seed_write_offset == $clog2(2*SEED_NUM_DWORDS)'(SEED_NUM_DWORDS-1-dword)))) & ~zeroize;
      abr_reg_hwif_in.MLKEM_SEED_D[dword].SEED.next = kv_mlkem_seed_write_data;
      abr_reg_hwif_in.MLKEM_SEED_D[dword].SEED.hwclr = zeroize | (kv_mlkem_seed_error != KV_SUCCESS);
      abr_reg_hwif_in.MLKEM_SEED_D[dword].SEED.swwe = abr_ready & ~kv_mlkem_seed_data_present;
      `else
      mlkem_seed_d_reg[dword] = abr_reg_hwif_out.MLKEM_SEED_D[dword].SEED.value;
      abr_reg_hwif_in.MLKEM_SEED_D[dword].SEED.we = '0;
      abr_reg_hwif_in.MLKEM_SEED_D[dword].SEED.next = '0;
      abr_reg_hwif_in.MLKEM_SEED_D[dword].SEED.hwclr = zeroize;
      abr_reg_hwif_in.MLKEM_SEED_D[dword].SEED.swwe = abr_ready;
      `endif
    end

    for (int unsigned dword=0; dword < SEED_NUM_DWORDS; dword++) begin
      abr_reg_hwif_in.MLKEM_SEED_Z[dword].wr_ack = abr_reg_hwif_out.MLKEM_SEED_Z[dword].req & abr_reg_hwif_out.MLKEM_SEED_Z[dword].req_is_wr;
    end

    for (int unsigned dword=0; dword < SHAREDKEY_NUM_DWORDS; dword++) begin
      abr_reg_hwif_in.MLKEM_SHARED_KEY[dword].rd_ack = abr_reg_hwif_out.MLKEM_SHARED_KEY[dword].req & ~abr_reg_hwif_out.MLKEM_SHARED_KEY[dword].req_is_wr;
      `ifdef CALIPTRA
      abr_reg_hwif_in.MLKEM_SHARED_KEY[dword].rd_data = mlkem_valid_reg & ~dest_keyvault & ~kv_mlkem_seed_data_present & ~kv_mlkem_msg_data_present ? 
                                                        abr_scratch_reg.mlkem_enc.shared_key[dword] : '0;
      `else
      abr_reg_hwif_in.MLKEM_SHARED_KEY[dword].rd_data = mlkem_valid_reg ? abr_scratch_reg.mlkem_enc.shared_key[dword] : '0;
      `endif
    end
  end

  always_comb begin : ABR_REG_HWIF_IN_MEM_ASSIGN
    //MLDSA
    abr_reg_hwif_in.MLDSA_PRIVKEY_IN.rd_ack = abr_reg_hwif_out.MLDSA_PRIVKEY_IN.req & ~abr_reg_hwif_out.MLDSA_PRIVKEY_IN.req_is_wr;
    abr_reg_hwif_in.MLDSA_PRIVKEY_IN.wr_ack = abr_reg_hwif_out.MLDSA_PRIVKEY_IN.req & abr_reg_hwif_out.MLDSA_PRIVKEY_IN.req_is_wr;
    abr_reg_hwif_in.MLDSA_PRIVKEY_IN.rd_data = '0; //NO READ PORT
    abr_reg_hwif_in.MLDSA_PRIVKEY_OUT.rd_ack = privkey_out_rd_ack[SRAM_LATENCY];
    abr_reg_hwif_in.MLDSA_PRIVKEY_OUT.wr_ack = abr_reg_hwif_out.MLDSA_PRIVKEY_OUT.req & abr_reg_hwif_out.MLDSA_PRIVKEY_OUT.req_is_wr;
    abr_reg_hwif_in.MLDSA_PRIVKEY_OUT.rd_data = privkey_out_rd_ack[SRAM_LATENCY] & mldsa_valid_reg & ~mldsa_privkey_lock ? privkey_out_rdata : 0;
    abr_reg_hwif_in.MLDSA_SIGNATURE.rd_ack = signature_rd_ack[SRAM_LATENCY];
    abr_reg_hwif_in.MLDSA_SIGNATURE.wr_ack = abr_reg_hwif_out.MLDSA_SIGNATURE.req & abr_reg_hwif_out.MLDSA_SIGNATURE.req_is_wr;
    abr_reg_hwif_in.MLDSA_SIGNATURE.rd_data = api_sig_z_re[SRAM_LATENCY] ? sig_z_ram_rdata[api_sig_z_addr[SRAM_LATENCY].offset] : api_reg_rdata;
    abr_reg_hwif_in.MLDSA_PUBKEY.rd_ack = pubkey_rd_ack[SRAM_LATENCY];
    abr_reg_hwif_in.MLDSA_PUBKEY.wr_ack = abr_reg_hwif_out.MLDSA_PUBKEY.req &  abr_reg_hwif_out.MLDSA_PUBKEY.req_is_wr;
    abr_reg_hwif_in.MLDSA_PUBKEY.rd_data = api_pubkey_re[SRAM_LATENCY] ? pubkey_ram_rdata[api_pubkey_mem_addr[SRAM_LATENCY].offset] : api_reg_rdata;
    //MLKEM
    abr_reg_hwif_in.MLKEM_CIPHERTEXT.rd_ack = ciphertext_rd_ack[SRAM_LATENCY];
    abr_reg_hwif_in.MLKEM_CIPHERTEXT.wr_ack = abr_reg_hwif_out.MLKEM_CIPHERTEXT.req & abr_reg_hwif_out.MLKEM_CIPHERTEXT.req_is_wr;
    abr_reg_hwif_in.MLKEM_CIPHERTEXT.rd_data = ciphertext_rd_ack[SRAM_LATENCY] & mlkem_valid_reg ? privkey_out_rdata : '0;
    abr_reg_hwif_in.MLKEM_DECAPS_KEY.rd_ack = decapskey_rd_ack[SRAM_LATENCY];
    abr_reg_hwif_in.MLKEM_DECAPS_KEY.wr_ack = abr_reg_hwif_out.MLKEM_DECAPS_KEY.req & abr_reg_hwif_out.MLKEM_DECAPS_KEY.req_is_wr;
    abr_reg_hwif_in.MLKEM_DECAPS_KEY.rd_data = decapskey_rd_ack[SRAM_LATENCY] & mlkem_valid_reg & ~mlkem_dk_lock ? privkey_out_rdata : '0;
    abr_reg_hwif_in.MLKEM_ENCAPS_KEY.rd_ack = encapskey_rd_ack[SRAM_LATENCY];
    abr_reg_hwif_in.MLKEM_ENCAPS_KEY.wr_ack = abr_reg_hwif_out.MLKEM_ENCAPS_KEY.req & abr_reg_hwif_out.MLKEM_ENCAPS_KEY.req_is_wr;
    abr_reg_hwif_in.MLKEM_ENCAPS_KEY.rd_data = encapskey_rd_ack[SRAM_LATENCY] & mlkem_valid_reg ? privkey_out_rdata : '0;
    abr_reg_hwif_in.MLKEM_MSG.rd_ack = abr_reg_hwif_out.MLKEM_MSG.req & ~abr_reg_hwif_out.MLKEM_MSG.req_is_wr;
    abr_reg_hwif_in.MLKEM_MSG.wr_ack = abr_reg_hwif_out.MLKEM_MSG.req & abr_reg_hwif_out.MLKEM_MSG.req_is_wr;
    abr_reg_hwif_in.MLKEM_MSG.rd_data = '0; //NO READ PORT
  end

  //Generate a pulse to trig the interrupt after finishing the operation
  always_comb abr_status_done = (abr_reg_hwif_in.MLDSA_STATUS.VALID.next & ~abr_reg_hwif_out.MLDSA_STATUS.VALID.value) || 
                                (abr_reg_hwif_in.MLKEM_STATUS.VALID.next & ~abr_reg_hwif_out.MLKEM_STATUS.VALID.value);

  assign error_intr = abr_reg_hwif_out.intr_block_rf.error_global_intr_r.intr;
  assign notif_intr = abr_reg_hwif_out.intr_block_rf.notif_global_intr_r.intr;

  always_comb begin
    abr_reg_hwif_in.intr_block_rf.error_internal_intr_r.error_internal_sts.hwset = error_flag_edge;
    abr_reg_hwif_in.intr_block_rf.notif_internal_intr_r.notif_cmd_done_sts.hwset = abr_status_done;
  end

  //Private Key and Decaps Key External Memory
  always_ff @(posedge clk or negedge rst_b) begin : mldsa_privkey_lock_reg
    if (!rst_b) begin
      mldsa_privkey_lock <= '1;
      mlkem_dk_lock <= '1;
    end else if (zeroize) begin
      mldsa_privkey_lock <= '1;
      mlkem_dk_lock <= '1;
    end else if ((|mldsa_cmd_reg) | (|mlkem_cmd_reg)) begin
      //Re-lock when any command is issued
      mldsa_privkey_lock <= '1;
      mlkem_dk_lock <= '1;
    end else begin
      //Clear the lock only after completing standalone keygen where the seed did not come from the keyvault
      if (~kv_mldsa_seed_data_present & (mldsa_keygen_process & mldsa_keygen_done)) mldsa_privkey_lock <= '0;
      if (~kv_mlkem_seed_data_present & (mlkem_keygen_process & mlkem_keygen_done)) mlkem_dk_lock <= '0;
    end
  end
  
  always_comb api_keymem_rd_vld = abr_reg_hwif_out.MLDSA_PRIVKEY_OUT.req & ~abr_reg_hwif_out.MLDSA_PRIVKEY_OUT.req_is_wr & 
                                  mldsa_valid_reg & ~mldsa_privkey_lock;

  always_comb api_sk_waddr = abr_reg_hwif_out.MLDSA_PRIVKEY_IN.addr[12:2];
  always_comb api_sk_raddr = abr_reg_hwif_out.MLDSA_PRIVKEY_OUT.addr[12:2];

  always_comb api_sk_reg_wr_dec = abr_reg_hwif_out.MLDSA_PRIVKEY_IN.req & api_sk_waddr inside {[0:31]};
  always_comb api_keymem_wr_dec = abr_reg_hwif_out.MLDSA_PRIVKEY_IN.req & api_sk_waddr inside {[32:PRIVKEY_NUM_DWORDS-1]} & ~kv_mlkem_msg_data_present;

  always_comb api_sk_reg_rd_dec = abr_reg_hwif_out.MLDSA_PRIVKEY_OUT.req & api_sk_raddr inside {[0:31]};
  always_comb api_keymem_rd_dec = abr_reg_hwif_out.MLDSA_PRIVKEY_OUT.req & api_sk_raddr inside {[32:PRIVKEY_NUM_DWORDS-1]};

  assign api_sk_reg_waddr = {1'b0,api_sk_waddr[4:0]};
  assign api_sk_reg_raddr = {1'b0,api_sk_raddr[4:0]};

  assign api_sk_mem_waddr = api_sk_waddr - 'd32;
  assign api_sk_mem_raddr = api_sk_raddr - 'd32;

  always_comb mlkem_api_dk_rd_vld = abr_reg_hwif_out.MLKEM_DECAPS_KEY.req & ~abr_reg_hwif_out.MLKEM_DECAPS_KEY.req_is_wr & 
                                    mlkem_valid_reg & ~mlkem_dk_lock;

  always_comb mlkem_api_dk_addr = {1'b0,abr_reg_hwif_out.MLKEM_DECAPS_KEY.addr[11:2]};

  always_comb mlkem_api_dk_reg_dec = abr_reg_hwif_out.MLKEM_DECAPS_KEY.req & mlkem_api_dk_addr inside {[MLKEM_DK_MEM_NUM_DWORDS:DK_NUM_DWORDS-1]};
  always_comb mlkem_api_dk_mem_dec = abr_reg_hwif_out.MLKEM_DECAPS_KEY.req & mlkem_api_dk_addr inside {[0:MLKEM_DK_MEM_NUM_DWORDS-1]};

  assign mlkem_api_dk_reg_addr = {1'b0,mlkem_api_dk_addr[4:0]};

  assign mlkem_api_dk_mem_addr = mlkem_api_dk_addr;

  always_comb mlkem_api_ek_rd_vld = abr_reg_hwif_out.MLKEM_ENCAPS_KEY.req & ~abr_reg_hwif_out.MLKEM_ENCAPS_KEY.req_is_wr & mlkem_valid_reg;

  always_comb mlkem_api_ek_addr = {2'b0,abr_reg_hwif_out.MLKEM_ENCAPS_KEY.addr[10:2]};

  always_comb mlkem_api_ek_reg_dec = abr_reg_hwif_out.MLKEM_ENCAPS_KEY.req & mlkem_api_ek_addr inside {[MLKEM_EK_MEM_NUM_DWORDS:EK_NUM_DWORDS-1]};
  always_comb mlkem_api_ek_mem_dec = abr_reg_hwif_out.MLKEM_ENCAPS_KEY.req & mlkem_api_ek_addr inside {[0:MLKEM_EK_MEM_NUM_DWORDS-1]};

  assign mlkem_api_ek_reg_addr = {3'b0,mlkem_api_ek_addr[2:0]};

  assign mlkem_api_ek_mem_addr = mlkem_api_ek_addr + MLKEM_DEST_EK_MEM_OFFSET[SK_MEM_BANK_ADDR_W:0];

  always_comb mlkem_api_ct_rd_vld = abr_reg_hwif_out.MLKEM_CIPHERTEXT.req & ~abr_reg_hwif_out.MLKEM_CIPHERTEXT.req_is_wr & mlkem_valid_reg;

  always_comb mlkem_api_ct_addr = {2'b0,abr_reg_hwif_out.MLKEM_CIPHERTEXT.addr[10:2]};

  always_comb mlkem_api_ct_mem_dec = abr_reg_hwif_out.MLKEM_CIPHERTEXT.req & mlkem_api_ct_addr inside {[0:MLKEM_CIPHERTEXT_MEM_NUM_DWORDS-1]};

  assign mlkem_api_ct_mem_addr = mlkem_api_ct_addr + MLKEM_DEST_C1_MEM_OFFSET[SK_MEM_BANK_ADDR_W:0];

  logic [$clog2(MLKEM_MSG_MEM_NUM_DWORDS)-1:0] kv_mlkem_msg_write_offset_rev;
  assign kv_mlkem_msg_write_offset_rev = $clog2(MLKEM_MSG_MEM_NUM_DWORDS)'(MLKEM_MSG_MEM_NUM_DWORDS-1-kv_mlkem_msg_write_offset);
  always_comb mlkem_api_msg_waddr =  kv_mlkem_msg_write_en ? {8'b0,kv_mlkem_msg_write_offset_rev} : {8'b0,abr_reg_hwif_out.MLKEM_MSG.addr[4:2]};
  always_comb mlkem_api_msg_mem_wr_dec = abr_reg_hwif_out.MLKEM_MSG.req & ~kv_mlkem_msg_data_present & mlkem_api_msg_waddr inside {[0:MLKEM_MSG_MEM_NUM_DWORDS-1]};
  assign mlkem_api_msg_mem_waddr = mlkem_api_msg_waddr + MLKEM_DEST_MSG_MEM_OFFSET[SK_MEM_BANK_ADDR_W:0];
  always_comb mlkem_msg_wdata = kv_mlkem_msg_write_en ? kv_mlkem_msg_write_data : abr_reg_hwif_out.MLKEM_MSG.wr_data;
  
  always_comb sampler_sk_rd_en[0] = (sampler_src == MLKEM_EK_REG_ID) & (sampler_src_offset inside {[0:191]}) |
                                    (sampler_src == MLKEM_MSG_ID) & (sampler_src_offset inside {[0:3]}) |
                                    (sampler_src == MLKEM_CIPHERTEXT_ID) & (sampler_src_offset inside {[0:195]});

  always_comb sampler_sk_rd_offset = (sampler_src == MLKEM_EK_REG_ID) ? MLKEM_DEST_EK_MEM_OFFSET/2 :
                                     (sampler_src == MLKEM_MSG_ID) ? MLKEM_DEST_MSG_MEM_OFFSET/2 :
                                     (sampler_src == MLKEM_CIPHERTEXT_ID) ? MLKEM_DEST_C1_MEM_OFFSET/2 : '0;

  //Secret Key Write Interface
  always_comb begin
    for (int unsigned i = 0; i < 2; i++) begin
      skencode_keymem_we_bank[i] = ((skencode_keymem_if_i.rd_wr_en == RW_WRITE) & (skencode_keymem_if_i.addr[0] == i));
      pwr2rnd_keymem_we_bank[i] = (pwr2rnd_keymem_if_i[i].rd_wr_en == RW_WRITE);
      api_keymem_we_bank[i] = abr_reg_hwif_in.MLDSA_PRIVKEY_IN.wr_ack & abr_ready & api_keymem_wr_dec & (api_sk_mem_waddr[0] == i);
      mlkem_api_dk_we_bank[i] = abr_reg_hwif_in.MLKEM_DECAPS_KEY.wr_ack & abr_ready & mlkem_api_dk_mem_dec & (mlkem_api_dk_mem_addr[0] == i);
      mlkem_api_ek_we_bank[i] = abr_reg_hwif_in.MLKEM_ENCAPS_KEY.wr_ack & abr_ready & mlkem_api_ek_mem_dec & (mlkem_api_ek_mem_addr[0] == i);
      mlkem_api_ct_we_bank[i] = abr_reg_hwif_in.MLKEM_CIPHERTEXT.wr_ack & abr_ready & mlkem_api_ct_mem_dec & (mlkem_api_ct_mem_addr[0] == i);
      mlkem_api_msg_we_bank[i] = ((abr_reg_hwif_in.MLKEM_MSG.wr_ack & abr_ready & mlkem_api_msg_mem_wr_dec) | kv_mlkem_msg_write_en) & (mlkem_api_msg_waddr[0] == i);
      compress_keymem_we_bank[i] = compress_api_rw_en_i[0] & (compress_api_rw_addr_i[0] == i);

      sk_ram_we_bank[i] = skencode_keymem_we_bank[i] | pwr2rnd_keymem_we_bank[i] | compress_keymem_we_bank[i] |api_keymem_we_bank[i] |
                          mlkem_api_dk_we_bank[i] | mlkem_api_ek_we_bank[i] | mlkem_api_ct_we_bank[i] | mlkem_api_msg_we_bank[i] | zeroize_mem_we_sk;

      sk_ram_waddr_bank[i] = ({SK_MEM_BANK_ADDR_W{skencode_keymem_we_bank[i]}} & skencode_keymem_if_i.addr[SK_MEM_BANK_ADDR_W:1]) |
                             ({SK_MEM_BANK_ADDR_W{pwr2rnd_keymem_we_bank[i]}} & pwr2rnd_keymem_if_i[i].addr[SK_MEM_BANK_ADDR_W:1] ) |
                             ({SK_MEM_BANK_ADDR_W{compress_keymem_we_bank[i]}} & compress_api_rw_addr_i[SK_MEM_BANK_ADDR_W:1]) |
                             ({SK_MEM_BANK_ADDR_W{api_keymem_we_bank[i]}} & api_sk_mem_waddr[SK_MEM_BANK_ADDR_W:1]) |
                             ({SK_MEM_BANK_ADDR_W{mlkem_api_dk_we_bank[i]}} & mlkem_api_dk_mem_addr[SK_MEM_BANK_ADDR_W:1]) |
                             ({SK_MEM_BANK_ADDR_W{mlkem_api_ek_we_bank[i]}} & mlkem_api_ek_mem_addr[SK_MEM_BANK_ADDR_W:1]) |
                             ({SK_MEM_BANK_ADDR_W{mlkem_api_ct_we_bank[i]}} & mlkem_api_ct_mem_addr[SK_MEM_BANK_ADDR_W:1]) |
                             ({SK_MEM_BANK_ADDR_W{mlkem_api_msg_we_bank[i]}} & mlkem_api_msg_mem_waddr[SK_MEM_BANK_ADDR_W:1]) |
                             ({SK_MEM_BANK_ADDR_W{zeroize_mem_we_sk}} & zeroize_mem_addr[SK_MEM_BANK_ADDR_W-1:0]);
                 
      sk_ram_wdata[i] = ({ABR_REG_WIDTH{skencode_keymem_we_bank[i]}} & skencode_wr_data_i) |
                        ({ABR_REG_WIDTH{pwr2rnd_keymem_we_bank[i]}} & pwr2rnd_wr_data_i[i]) |
                        ({ABR_REG_WIDTH{compress_keymem_we_bank[i]}} & compress_api_wr_data_i) |
                        ({ABR_REG_WIDTH{api_keymem_we_bank[i]}} & abr_reg_hwif_out.MLDSA_PRIVKEY_IN.wr_data) |
                        ({ABR_REG_WIDTH{mlkem_api_dk_we_bank[i]}} & abr_reg_hwif_out.MLKEM_DECAPS_KEY.wr_data) |
                        ({ABR_REG_WIDTH{mlkem_api_ek_we_bank[i]}} & abr_reg_hwif_out.MLKEM_ENCAPS_KEY.wr_data) |
                        ({ABR_REG_WIDTH{mlkem_api_ct_we_bank[i]}} & abr_reg_hwif_out.MLKEM_CIPHERTEXT.wr_data) |
                        ({ABR_REG_WIDTH{mlkem_api_msg_we_bank[i]}} & mlkem_msg_wdata);         
    end
  end     
  
  //Secret Key Read Interface
  always_comb decompress_keymem_re[0] = decompress_api_rd_en_i;

  always_comb begin
    for (int unsigned i = 0; i < 2; i++) begin
      api_sk_re_bank[i] = api_keymem_rd_vld & api_keymem_rd_dec & (api_sk_mem_raddr[0] == i);
      mlkem_api_dk_re_bank[i] = mlkem_api_dk_rd_vld & mlkem_api_dk_mem_dec & (mlkem_api_dk_mem_addr[0] == i);
      mlkem_api_ek_re_bank[i] = mlkem_api_ek_rd_vld & mlkem_api_ek_mem_dec & (mlkem_api_ek_mem_addr[0] == i);
      mlkem_api_ct_re_bank[i] = mlkem_api_ct_rd_vld & mlkem_api_ct_mem_dec & (mlkem_api_ct_mem_addr[0] == i);

      skdecode_re_bank[0][i] = (skdecode_keymem_if_i[i].rd_wr_en == RW_READ);

      skdecode_rdaddr[i] = skdecode_keymem_if_i[i].addr[SK_MEM_BANK_ADDR_W:0];

      compress_keymem_re_bank[0][i] = compress_api_rw_en_i[1] & (compress_api_rw_addr_i[0] == i);

      sk_ram_re_bank[i] = skdecode_re_bank[0][i] | api_sk_re_bank[i] | mlkem_api_dk_re_bank[i] |  mlkem_api_ek_re_bank[i] |
                          mlkem_api_ct_re_bank[i] | sampler_sk_rd_en[0] | decompress_keymem_re[0] | compress_keymem_re_bank[0][i];

      sk_ram_raddr_bank[i] = ({SK_MEM_BANK_ADDR_W{skdecode_re_bank[0][i]}} & skdecode_rdaddr[i][SK_MEM_BANK_ADDR_W:1]) |
                             ({SK_MEM_BANK_ADDR_W{api_sk_re_bank[i]}} & api_sk_mem_raddr[SK_MEM_BANK_ADDR_W:1]) |
                             ({SK_MEM_BANK_ADDR_W{mlkem_api_dk_re_bank[i]}} & mlkem_api_dk_mem_addr[SK_MEM_BANK_ADDR_W:1]) |
                             ({SK_MEM_BANK_ADDR_W{mlkem_api_ek_re_bank[i]}} & mlkem_api_ek_mem_addr[SK_MEM_BANK_ADDR_W:1]) |
                             ({SK_MEM_BANK_ADDR_W{mlkem_api_ct_re_bank[i]}} & mlkem_api_ct_mem_addr[SK_MEM_BANK_ADDR_W:1]) |
                             ({SK_MEM_BANK_ADDR_W{decompress_keymem_re[0]}} & decompress_api_rd_addr_i[SK_MEM_BANK_ADDR_W-1:0]) |
                             ({SK_MEM_BANK_ADDR_W{compress_keymem_re_bank[0][i]}} & compress_api_rw_addr_i[SK_MEM_BANK_ADDR_W:1]) |
                             ({SK_MEM_BANK_ADDR_W{sampler_sk_rd_en[0]}} & (sampler_src_offset[SK_MEM_BANK_ADDR_W-1:0] + sampler_sk_rd_offset));

    end
  end

  always_comb api_keymem_re_bank[0] = api_sk_re_bank | mlkem_api_dk_re_bank | mlkem_api_ek_re_bank | mlkem_api_ct_re_bank;
  always_comb api_sk_reg_re[0] =  api_sk_reg_rd_dec | (mlkem_api_dk_rd_vld & mlkem_api_dk_reg_dec) | (mlkem_api_ek_rd_vld & mlkem_api_ek_reg_dec);

  always_comb skdecode_rd_data_o = sk_ram_rdata;
  always_comb skdecode_rd_data_valid_o = skdecode_re_bank[SRAM_LATENCY];
  always_comb decompress_api_rd_data_o = sk_ram_rdata;
  always_comb decompress_api_rd_data_valid_o = decompress_keymem_re[SRAM_LATENCY];
  always_comb compress_api_rd_data_o = {ABR_REG_WIDTH{compress_keymem_re_bank[SRAM_LATENCY][0]}} & sk_ram_rdata[0] |
                                       {ABR_REG_WIDTH{compress_keymem_re_bank[SRAM_LATENCY][1]}} & sk_ram_rdata[1];
  always_comb compress_api_rd_data_valid_o = |compress_keymem_re_bank[SRAM_LATENCY];                      
  always_comb privkey_out_rdata = {ABR_REG_WIDTH{api_keymem_re_bank[SRAM_LATENCY][0]}} & sk_ram_rdata[0] |
                                  {ABR_REG_WIDTH{api_keymem_re_bank[SRAM_LATENCY][1]}} & sk_ram_rdata[1] |
                                  {ABR_REG_WIDTH{api_sk_reg_re[SRAM_LATENCY]}} & api_reg_rdata;

  always_comb sk_bank0_mem_if.we_i = (sk_ram_we_bank[0]);
  always_comb sk_bank0_mem_if.waddr_i = (sk_ram_waddr_bank[0]);
  always_comb sk_bank0_mem_if.wdata_i = (sk_ram_wdata[0]);
  always_comb sk_bank0_mem_if.re_i = (sk_ram_re_bank[0]);
  always_comb sk_bank0_mem_if.raddr_i = (sk_ram_raddr_bank[0]);
  always_comb sk_ram_rdata[0] = sk_bank0_mem_if.rdata_o;

  always_comb sk_bank1_mem_if.we_i = (sk_ram_we_bank[1]);
  always_comb sk_bank1_mem_if.waddr_i = (sk_ram_waddr_bank[1]);
  always_comb sk_bank1_mem_if.wdata_i = (sk_ram_wdata[1]);
  always_comb sk_bank1_mem_if.re_i = (sk_ram_re_bank[1]);
  always_comb sk_bank1_mem_if.raddr_i = (sk_ram_raddr_bank[1]);
  always_comb sk_ram_rdata[1] = sk_bank1_mem_if.rdata_o;

  //private key read ports
  always_ff @(posedge clk or negedge rst_b) begin
    if (!rst_b) begin
      api_reg_rdata <= '0;
    end else if (zeroize) begin
      api_reg_rdata <= '0;
    end else begin
      if      (api_sk_reg_rd_dec)    api_reg_rdata <= {ABR_REG_WIDTH{api_keymem_rd_vld}} & abr_scratch_reg.raw[api_sk_reg_raddr];
      else if (mlkem_api_dk_reg_dec) api_reg_rdata <= {ABR_REG_WIDTH{mlkem_api_dk_rd_vld}} & abr_scratch_reg.raw[mlkem_api_dk_reg_addr];
      else if (mlkem_api_ek_reg_dec) api_reg_rdata <= {ABR_REG_WIDTH{mlkem_api_ek_rd_vld}} & abr_scratch_reg.raw[mlkem_api_ek_reg_addr];    
      else if (api_pubkey_rho_dec)   api_reg_rdata <= {ABR_REG_WIDTH{mldsa_valid_reg}} & abr_scratch_reg.raw[api_pk_reg_raddr];
      else if (api_sig_reg_re)       api_reg_rdata <= {ABR_REG_WIDTH{mldsa_valid_reg}} & signature_reg_rdata;
    end
  end

  always_comb api_sig_addr = abr_reg_hwif_out.MLDSA_SIGNATURE.addr[SIG_ADDR_W+1:2];

  always_comb api_sig_c_dec = abr_reg_hwif_out.MLDSA_SIGNATURE.req & api_sig_addr inside {[0:SIGNATURE_C_NUM_DWORDS-1]};
  always_comb api_sig_z_dec = abr_reg_hwif_out.MLDSA_SIGNATURE.req & api_sig_addr inside {[SIGNATURE_C_NUM_DWORDS:SIGNATURE_C_NUM_DWORDS+SIGNATURE_Z_NUM_DWORDS-1]};
  always_comb api_sig_h_dec = abr_reg_hwif_out.MLDSA_SIGNATURE.req & api_sig_addr inside {[SIGNATURE_C_NUM_DWORDS+SIGNATURE_Z_NUM_DWORDS:SIGNATURE_NUM_DWORDS-1]};

  always_comb api_sig_z_addr[0].addr   = SIG_Z_MEM_ADDR_W'( (api_sig_addr - SIGNATURE_C_NUM_DWORDS)/SIG_Z_MEM_NUM_DWORD );
  always_comb api_sig_z_addr[0].offset = (api_sig_addr - SIGNATURE_C_NUM_DWORDS)%SIG_Z_MEM_NUM_DWORD;
  always_comb api_sig_c_addr = api_sig_addr[SIG_C_REG_ADDR_W-1:0];
  always_comb api_sig_h_addr = SIG_H_REG_ADDR_W'( api_sig_addr - (SIGNATURE_C_NUM_DWORDS+SIGNATURE_Z_NUM_DWORDS) );

  always_comb api_sig_z_we = abr_ready & api_sig_z_dec & abr_reg_hwif_in.MLDSA_SIGNATURE.wr_ack;

  always_comb api_sig_z_re[0] = mldsa_valid_reg & api_sig_z_dec & ~abr_reg_hwif_out.MLDSA_SIGNATURE.req_is_wr;
  always_comb api_sig_reg_re = (api_sig_c_dec | api_sig_h_dec) & ~abr_reg_hwif_out.MLDSA_SIGNATURE.req_is_wr;

  always_comb sig_z_mem_if.we_i = (sig_z_ram_we);
  always_comb sig_z_mem_if.waddr_i = (sig_z_ram_waddr);
  always_comb sig_z_mem_if.wstrobe_i = (sig_z_ram_wstrobe);
  always_comb sig_z_mem_if.wdata_i = (sig_z_ram_wdata);
  always_comb sig_z_mem_if.re_i = (sig_z_ram_re);
  always_comb sig_z_mem_if.raddr_i = (sig_z_ram_raddr);
  always_comb sig_z_ram_rdata = sig_z_mem_if.rdata_o;

  //read requests
  always_comb sigdecode_z_ram_re[0] = sigdecode_z_rd_req_i.rd_wr_en == RW_READ;
  always_comb sig_z_ram_re = sigdecode_z_ram_re[0] | api_sig_z_re[0];
  always_comb sig_z_ram_raddr = ({SIG_Z_MEM_ADDR_W{sigdecode_z_ram_re[0]}} & sigdecode_z_rd_req_i.addr[SIG_Z_MEM_ADDR_W:1]) |
                                ({SIG_Z_MEM_ADDR_W{api_sig_z_re[0]}} & api_sig_z_addr[0].addr);

  always_comb sigdecode_z_rd_data_o = sig_z_ram_rdata;
  always_comb sigdecode_z_rd_data_valid_o = sigdecode_z_ram_re[SRAM_LATENCY];

  //write requests
  always_comb sig_z_ram_we = (sigencode_wr_req_i.rd_wr_en == RW_WRITE) | api_sig_z_we | zeroize_mem_we_sig;
  always_comb sig_z_ram_waddr = ({SIG_Z_MEM_ADDR_W{(sigencode_wr_req_i.rd_wr_en == RW_WRITE)}} & sigencode_wr_req_i.addr[SIG_Z_MEM_ADDR_W:1]) |
                                ({SIG_Z_MEM_ADDR_W{api_sig_z_we}} & api_sig_z_addr[0].addr) |
                                ({SIG_Z_MEM_ADDR_W{zeroize_mem_we_sig}} & zeroize_mem_addr[SIG_Z_MEM_ADDR_W-1:0]);

  always_comb sig_z_ram_wstrobe = ({SIG_Z_MEM_WSTROBE_W{(sigencode_wr_req_i.rd_wr_en == RW_WRITE)}}) |
                                  ({SIG_Z_MEM_WSTROBE_W{api_sig_z_we}} & ('hF << api_sig_z_addr[0].offset*4)) |
                                  ({SIG_Z_MEM_WSTROBE_W{zeroize_mem_we_sig}});


  always_comb sig_z_ram_wdata = ({SIG_Z_MEM_DATA_W{(sigencode_wr_req_i.rd_wr_en == RW_WRITE)}} & sigencode_wr_data_i) |
                                ({SIG_Z_MEM_DATA_W{(api_sig_z_we)}} & SIG_Z_MEM_DATA_W'(abr_reg_hwif_out.MLDSA_SIGNATURE.wr_data << api_sig_z_addr[0].offset*32));

  always_comb signature_reg_rdata = {ABR_REG_WIDTH{api_sig_c_dec}} & signature_reg.enc.c[api_sig_c_addr] |
                                    {ABR_REG_WIDTH{api_sig_h_dec}} & signature_reg.enc.h[api_sig_h_addr];

  always_ff @(posedge clk or negedge rst_b) begin
    if (!rst_b) begin
      signature_reg <= '0;
    end else if (zeroize) begin
      signature_reg <= '0;
    end else begin
      //HW write c
      if (sampler_state_dv_i & (abr_instr.operand3 == MLDSA_DEST_SIG_C_REG_ID)) begin
        signature_reg.enc.c <= sampler_state_data_i[511:0];
      end else if (abr_ready & api_sig_c_dec & abr_reg_hwif_out.MLDSA_SIGNATURE.req_is_wr) begin
        signature_reg.enc.c[api_sig_c_addr] <= abr_reg_hwif_out.MLDSA_SIGNATURE.wr_data;
      end
      //HW write h
      if (set_signature_valid) begin
        signature_reg.enc.h <= '0;
      end else if (makehint_reg_wren_i) begin
        for (int unsigned dword = 0; dword < SIGNATURE_H_NUM_DWORDS; dword++) begin
          if (makehint_reg_wr_addr_i == dword)
            signature_reg.enc.h[dword] <= signature_reg.enc.h[dword] | makehint_reg_wrdata_i;
        end
      end else if (abr_ready & api_sig_h_dec & abr_reg_hwif_out.MLDSA_SIGNATURE.req_is_wr) begin
        signature_reg.enc.h[api_sig_h_addr] <= abr_reg_hwif_out.MLDSA_SIGNATURE.wr_data;
      end
    end
  end

  always_comb begin
    //HW read h
    for (int unsigned i = 0; i < SIGNATURE_H_VALID_NUM_BYTES; i++) begin
      signature_h_o[i] = signature_reg.enc.h[i/4][(i%4)*8 +: 8];
    end
  end

  always_comb begin
    sampler_src_offset_stg[0] = sampler_pubkey_mem_addr.offset[2:0];
    pkdecode_rd_offset[0] = pkdecode_rd_addr_i[1:0];
  end



  always_comb api_pubkey_addr = abr_reg_hwif_out.MLDSA_PUBKEY.addr[PK_ADDR_W+1:2];

  always_comb api_pubkey_rho_dec = abr_reg_hwif_out.MLDSA_PUBKEY.req & api_pubkey_addr inside {[0:7]};
  always_comb api_pubkey_dec = abr_reg_hwif_out.MLDSA_PUBKEY.req & api_pubkey_addr inside {[8:PUBKEY_NUM_DWORDS-1]};

  always_comb api_pubkey_mem_addr[0].addr   = PK_MEM_ADDR_W'( (api_pubkey_addr - 8)/PK_MEM_NUM_DWORDS );
  always_comb api_pubkey_mem_addr[0].offset = (api_pubkey_addr - 8)%PK_MEM_NUM_DWORDS;

  always_comb api_pk_reg_raddr = {3'b0,api_pubkey_addr[2:0]};
  always_comb api_pk_reg_waddr = {3'b0,api_pubkey_addr[2:0]};

  always_comb api_pubkey_we = abr_ready & api_pubkey_dec & abr_reg_hwif_in.MLDSA_PUBKEY.wr_ack;

  always_comb api_pubkey_re[0] = mldsa_valid_reg & api_pubkey_dec & ~abr_reg_hwif_out.MLDSA_PUBKEY.req_is_wr;

  always_comb pk_mem_if.we_i = (pubkey_ram_we);
  always_comb pk_mem_if.waddr_i = (pubkey_ram_waddr);
  always_comb pk_mem_if.wstrobe_i = (pubkey_ram_wstrobe);
  always_comb pk_mem_if.wdata_i = (pubkey_ram_wdata);
  always_comb pk_mem_if.re_i = (pubkey_ram_re);
  always_comb pk_mem_if.raddr_i = (pubkey_ram_raddr);
  always_comb pubkey_ram_rdata = pk_mem_if.rdata_o;

  assign pubkey_ram_rdata_t1 = pubkey_ram_rdata;

  always_comb pkdecode_rd_en[0] = pkdecode_rd_en_i;

  always_comb begin
      sampler_pk_rd_en[0] = (sampler_src == MLDSA_PK_REG_ID) & (sampler_src_offset inside {[4:324]});
      sampler_pubkey_mem_addr.addr = PK_MEM_ADDR_W'((sampler_src_offset - 4)/(PK_MEM_NUM_DWORDS_HALF));
      sampler_pubkey_mem_addr.offset = (sampler_src_offset - 4)%(PK_MEM_NUM_DWORDS_HALF);
  end
  //read requests
  always_comb pubkey_ram_re = sampler_pk_rd_en[0] | pkdecode_rd_en[0] | api_pubkey_re[0];
  always_comb pubkey_ram_raddr = ({PK_MEM_ADDR_W{sampler_pk_rd_en[0]}} & sampler_pubkey_mem_addr.addr) |
                                 ({PK_MEM_ADDR_W{pkdecode_rd_en[0]}} & pkdecode_rd_addr_i[PK_MEM_ADDR_W+1:2]) |
                                 ({PK_MEM_ADDR_W{api_pubkey_re[0]}} & api_pubkey_mem_addr[0].addr);

  always_comb begin
    unique case (pkdecode_rd_offset[SRAM_LATENCY][1:0])
      2'b00:   pkdecode_rd_data_o = pubkey_ram_rdata_t1[7:0];
      2'b01:   pkdecode_rd_data_o = pubkey_ram_rdata_t1[15:8];
      2'b10:   pkdecode_rd_data_o = pubkey_ram_rdata_t1[23:16];
      default: pkdecode_rd_data_o = pubkey_ram_rdata_t1[31:24];
    endcase
  end

  always_comb pkdecode_rd_data_valid_o = pkdecode_rd_en[SRAM_LATENCY];

  //write requests
  always_comb pubkey_ram_we = (pk_t1_wren_i) | api_pubkey_we | zeroize_mem_we_pk;
  always_comb pubkey_ram_waddr = ({PK_MEM_ADDR_W{pk_t1_wren_i}} & pk_t1_wr_addr_i[PK_MEM_ADDR_W+1:2]) |
                                ({PK_MEM_ADDR_W{api_pubkey_we}} & api_pubkey_mem_addr[0].addr) |
                                ({PK_MEM_ADDR_W{zeroize_mem_we_pk}} & zeroize_mem_addr[PK_MEM_ADDR_W-1:0]);

  always_comb pubkey_ram_wstrobe = ({PK_MEM_WSTROBE_W{pk_t1_wren_i}} & PK_MEM_WSTROBE_W'('h3FF << pk_t1_wr_addr_i[1:0]*10)) |
                                   ({PK_MEM_WSTROBE_W{api_pubkey_we}} & PK_MEM_WSTROBE_W'('hF << api_pubkey_mem_addr[0].offset*4)) |
                                   ({PK_MEM_WSTROBE_W{zeroize_mem_we_pk}});


  always_comb pubkey_ram_wdata = ({PK_MEM_DATA_W{pk_t1_wren_i}} & PK_MEM_DATA_W'(pk_t1_wrdata_i << pk_t1_wr_addr_i[1:0]*80)) |
                                 ({PK_MEM_DATA_W{(api_pubkey_we)}} & PK_MEM_DATA_W'(abr_reg_hwif_out.MLDSA_PUBKEY.wr_data << api_pubkey_mem_addr[0].offset*32));

  //pipeline the read ack
  always_comb begin
      privkey_out_rd_ack[0] = abr_reg_hwif_out.MLDSA_PRIVKEY_OUT.req & ~abr_reg_hwif_out.MLDSA_PRIVKEY_OUT.req_is_wr;
      signature_rd_ack[0]   = abr_reg_hwif_out.MLDSA_SIGNATURE.req & ~abr_reg_hwif_out.MLDSA_SIGNATURE.req_is_wr;
      pubkey_rd_ack[0]      = abr_reg_hwif_out.MLDSA_PUBKEY.req & ~abr_reg_hwif_out.MLDSA_PUBKEY.req_is_wr;
      encapskey_rd_ack[0]   = abr_reg_hwif_out.MLKEM_ENCAPS_KEY.req & ~abr_reg_hwif_out.MLKEM_ENCAPS_KEY.req_is_wr;
      decapskey_rd_ack[0]   = abr_reg_hwif_out.MLKEM_DECAPS_KEY.req & ~abr_reg_hwif_out.MLKEM_DECAPS_KEY.req_is_wr;
      ciphertext_rd_ack[0]  = abr_reg_hwif_out.MLKEM_CIPHERTEXT.req & ~abr_reg_hwif_out.MLKEM_CIPHERTEXT.req_is_wr;
  end

  //Stage the read enables into read data valids
  generate
    for (genvar g_stage = 1; g_stage <= SRAM_LATENCY; g_stage++) begin : read_en_stage
    //public key memory
      always_ff @(posedge clk or negedge rst_b) begin
        if (!rst_b) begin
          api_pubkey_re[g_stage] <= '0;
          api_pubkey_mem_addr[g_stage] <= '0;
          pkdecode_rd_en[g_stage] <= '0;
          pkdecode_rd_offset[g_stage] <= '0;
          sampler_pk_rd_en[g_stage] <= '0;
          sampler_sk_rd_en[g_stage] <= '0;
          sampler_src_offset_stg[g_stage] <= '0;
          sigdecode_z_ram_re[g_stage] <= '0;
          api_sig_z_re[g_stage] <= '0;
          api_sig_z_addr[g_stage] <= '0;
          skdecode_re_bank[g_stage] <= '0;
          api_keymem_re_bank[g_stage] <= '0;
          privkey_out_rd_ack[g_stage] <= '0;
          signature_rd_ack[g_stage] <= '0;
          pubkey_rd_ack[g_stage] <= '0;
          encapskey_rd_ack[g_stage] <= '0;
          decapskey_rd_ack[g_stage] <= '0;
          ciphertext_rd_ack[g_stage] <= '0;
          api_sk_reg_re[g_stage] <= '0;
          compress_keymem_re_bank[g_stage] <= '0;
          decompress_keymem_re[g_stage] <= '0;
        end else if (zeroize) begin
          api_pubkey_re[g_stage] <= '0;
          api_pubkey_mem_addr[g_stage] <= '0;
          pkdecode_rd_en[g_stage] <= '0;
          pkdecode_rd_offset[g_stage] <= '0;
          sampler_pk_rd_en[g_stage] <= '0;
          sampler_sk_rd_en[g_stage] <= '0;
          sampler_src_offset_stg[g_stage] <= '0;
          sigdecode_z_ram_re[g_stage] <= '0;
          api_sig_z_re[g_stage] <= '0;
          api_sig_z_addr[g_stage] <= '0;
          skdecode_re_bank[g_stage] <= '0;
          api_keymem_re_bank[g_stage] <= '0;
          privkey_out_rd_ack[g_stage] <= '0;
          signature_rd_ack[g_stage] <= '0;
          pubkey_rd_ack[g_stage] <= '0;
          encapskey_rd_ack[g_stage] <= '0;
          decapskey_rd_ack[g_stage] <= '0;
          ciphertext_rd_ack[g_stage] <= '0;
          api_sk_reg_re[g_stage] <= '0;
          compress_keymem_re_bank[g_stage] <= '0;
          decompress_keymem_re[g_stage] <= '0;
        end else begin
          api_pubkey_re[g_stage] <= api_pubkey_re[g_stage-1];
          api_pubkey_mem_addr[g_stage] <= api_pubkey_mem_addr[g_stage-1];
          pkdecode_rd_en[g_stage] <= pkdecode_rd_en[g_stage-1];
          pkdecode_rd_offset[g_stage] <= pkdecode_rd_offset[g_stage-1];
          sampler_pk_rd_en[g_stage] <= sampler_pk_rd_en[g_stage-1];
          sampler_sk_rd_en[g_stage] <=sampler_sk_rd_en[g_stage-1];
          sampler_src_offset_stg[g_stage] <= sampler_src_offset_stg[g_stage-1];
          sigdecode_z_ram_re[g_stage] <= sigdecode_z_ram_re[g_stage-1];
          api_sig_z_re[g_stage] <= api_sig_z_re[g_stage-1];
          api_sig_z_addr[g_stage] <= api_sig_z_addr[g_stage-1];
          skdecode_re_bank[g_stage] <= skdecode_re_bank[g_stage-1];
          api_keymem_re_bank[g_stage] <= api_keymem_re_bank[g_stage-1];
          privkey_out_rd_ack[g_stage] <= privkey_out_rd_ack[g_stage-1];
          signature_rd_ack[g_stage] <= signature_rd_ack[g_stage-1];
          pubkey_rd_ack[g_stage] <= pubkey_rd_ack[g_stage-1];
          encapskey_rd_ack[g_stage] <= encapskey_rd_ack[g_stage-1];
          decapskey_rd_ack[g_stage] <= decapskey_rd_ack[g_stage-1];
          ciphertext_rd_ack[g_stage] <= ciphertext_rd_ack[g_stage-1];
          api_sk_reg_re[g_stage] <= api_sk_reg_re[g_stage-1];
          compress_keymem_re_bank[g_stage] <= compress_keymem_re_bank[g_stage-1];
          decompress_keymem_re[g_stage] <= decompress_keymem_re[g_stage-1];
        end
      end
    end
  endgenerate

  //pure-MLDSA assuming 512-bit input msg and empty ctx
  //padding zeroes for highest dword to prevent x prop
  logic [MLDSA_MSG_NUM_DWORDS-1+2 : 0][ABR_REG_WIDTH-1:0] msg_p_reg;
  always_comb begin
    if (stream_msg_mode) msg_p_reg = {512'b0,stream_msg_buffer_data};
    else msg_p_reg = {32'h0, 16'h0, msg_reg, 8'h00, 8'h00};
  end

  logic [15:0] kappa_sum;
  assign kappa_sum = kappa_reg + 16'(sampler_imm[2:0]);

  always_ff @(posedge clk or negedge rst_b) begin
    if (!rst_b) begin
      msg_data <= '0;
    end else if (zeroize) begin
      msg_data <= '0;
    end else begin
      unique case (sampler_src) inside
        MLDSA_SEED_ID:        msg_data <= msg_last ? {48'b0,sampler_imm} : {mldsa_seed_reg[{sampler_src_offset[1:0],1'b1}],mldsa_seed_reg[{sampler_src_offset[1:0],1'b0}]};
        MLDSA_RHO_ID:         msg_data <= msg_last ? {48'b0,sampler_imm} : abr_scratch_reg.mldsa_enc.rho[sampler_src_offset[1:0]];
        MLDSA_RHO_P_ID:       msg_data <= msg_last ? {48'b0,sampler_imm} : abr_scratch_reg.mldsa_enc.rho_p[sampler_src_offset[2:0]];
        MLDSA_TR_ID:          msg_data <= abr_scratch_reg.mldsa_enc.tr[sampler_src_offset[2:0]];
        MLDSA_MSG_ID:         msg_data <= {msg_p_reg[{sampler_src_offset[3:0],1'b1}],msg_p_reg[{sampler_src_offset[3:0],1'b0}]};
        MLDSA_K_ID:           msg_data <= abr_scratch_reg.mldsa_enc.K[sampler_src_offset[1:0]];
        MLDSA_MU_ID:          msg_data <= mu_reg[sampler_src_offset[2:0]];
        MLDSA_SIGN_RND_ID:    msg_data <= {sign_rnd_reg[{sampler_src_offset[1:0],1'b1}],sign_rnd_reg[{sampler_src_offset[1:0],1'b0}]};
        MLDSA_RHO_P_KAPPA_ID: msg_data <= msg_last ? {48'b0,kappa_sum} : abr_scratch_reg.mldsa_enc.rho_p[sampler_src_offset[2:0]];
        MLDSA_SIG_C_REG_ID:   msg_data <= {signature_reg.enc.c[{sampler_src_offset[2:0],1'b1}], signature_reg.enc.c[{sampler_src_offset[2:0],1'b0}]};
        MLDSA_PK_REG_ID:      msg_data <= abr_scratch_reg.mldsa_enc.rho[sampler_src_offset[1:0]];
        ABR_ENTROPY_ID:       msg_data <= lfsr_entropy_reg[sampler_src_offset[2:0]];
        MLKEM_SEED_D_ID:      msg_data <= msg_last ? {48'b0,sampler_imm} : {mlkem_seed_d_reg[{sampler_src_offset[1:0],1'b1}],mlkem_seed_d_reg[{sampler_src_offset[1:0],1'b0}]};
        MLKEM_SIGMA_ID:       msg_data <= msg_last ? {48'b0,sampler_imm} : abr_scratch_reg.mlkem_enc.sigma[sampler_src_offset[1:0]];
        MLKEM_RHO_ID:         msg_data <= msg_last ? {48'b0,sampler_imm} : abr_scratch_reg.mlkem_enc.rho[sampler_src_offset[1:0]];
        MLKEM_EK_REG_ID:      msg_data <= abr_scratch_reg.mlkem_enc.rho[sampler_src_offset[1:0]];
        MLKEM_R_ID:           msg_data <= msg_last ? {48'b0,sampler_imm} : abr_scratch_reg.mlkem_enc.sigma[sampler_src_offset[1:0]];
        MLKEM_TR_ID:          msg_data <= abr_scratch_reg.mlkem_enc.tr[sampler_src_offset[1:0]];
        MLKEM_SEED_Z_ID:      msg_data <= {abr_scratch_reg.mlkem_enc.seed_z[{sampler_src_offset[1:0],1'b1}],abr_scratch_reg.mlkem_enc.seed_z[{sampler_src_offset[1:0],1'b0}]};
        ABR_CNT_ID:           msg_data <= counter_reg;
        default:              msg_data <= '0;
      endcase
    end 
  end

  always_comb begin
    msg_data_o = sampler_pk_rd_en[SRAM_LATENCY] ? {pubkey_ram_rdata[{sampler_src_offset_stg[SRAM_LATENCY][2:0],1'b1}],pubkey_ram_rdata[{sampler_src_offset_stg[SRAM_LATENCY][2:0],1'b0}]} :
                 sampler_sk_rd_en[SRAM_LATENCY] ? sk_ram_rdata : msg_data;
  end

  //If we're storing state directly into registers, do that here
  //Scratch register is a common set of flops used by all flows
  always_ff @(posedge clk or negedge rst_b) begin
    if (!rst_b) begin
      abr_scratch_reg <= '0;
    end
    else if (zeroize) begin
      abr_scratch_reg <= '0;
    end
    //Sampler Writes
    else if (sampler_state_dv_i) begin
      unique case (abr_instr.operand3)
        MLDSA_DEST_K_RHO_REG_ID: begin
          abr_scratch_reg.mldsa_enc.rho <= sampler_state_data_i[255:0];
          abr_scratch_reg.mldsa_enc.rho_p <= sampler_state_data_i[767:256];
          abr_scratch_reg.mldsa_enc.K <= sampler_state_data_i[1023:768];
        end
        MLDSA_DEST_TR_REG_ID: begin
          abr_scratch_reg.mldsa_enc.tr <= sampler_state_data_i[511:0];
        end
        MLDSA_DEST_RHO_P_REG_ID: begin
          abr_scratch_reg.mldsa_enc.rho_p <= sampler_state_data_i[511:0];
        end
        MLKEM_DEST_RHO_SIGMA_REG_ID: begin
          abr_scratch_reg.mlkem_enc.rho <= sampler_state_data_i[255:0];
          abr_scratch_reg.mlkem_enc.sigma <= sampler_state_data_i[511:256];
        end
        MLKEM_DEST_TR_REG_ID: begin
          abr_scratch_reg.mlkem_enc.tr <= sampler_state_data_i[255:0];
        end
        MLKEM_DEST_K_R_REG_ID: begin
          abr_scratch_reg.mlkem_enc.shared_key <= sampler_state_data_i[255:0];
          abr_scratch_reg.mlkem_enc.sigma <= sampler_state_data_i[511:256];
        end
        MLKEM_DEST_K_REG_ID: begin
          if (~decaps_valid & mlkem_decaps_process) //implicit rejection for shared key
            abr_scratch_reg.mlkem_enc.shared_key <= sampler_state_data_i[255:0];
        end
        default: begin
          //default case does nothing, just to avoid linter warnings
        end
      endcase
    end
    //API Writes
    else if (abr_reg_hwif_in.MLKEM_ENCAPS_KEY.wr_ack & abr_ready & mlkem_api_ek_reg_dec) begin
      abr_scratch_reg.raw[mlkem_api_ek_reg_addr] <= abr_reg_hwif_out.MLKEM_ENCAPS_KEY.wr_data;
    end
    else if (abr_reg_hwif_in.MLKEM_DECAPS_KEY.wr_ack & abr_ready & mlkem_api_dk_reg_dec) begin
      abr_scratch_reg.raw[mlkem_api_dk_reg_addr] <= abr_reg_hwif_out.MLKEM_DECAPS_KEY.wr_data;
    end
    else if (abr_reg_hwif_in.MLDSA_PRIVKEY_IN.wr_ack & abr_ready & api_sk_reg_wr_dec) begin
      abr_scratch_reg.raw[api_sk_reg_waddr] <= abr_reg_hwif_out.MLDSA_PRIVKEY_IN.wr_data;
    end
    else if (abr_ready & api_pubkey_rho_dec & abr_reg_hwif_out.MLDSA_PUBKEY.req_is_wr) begin
      abr_scratch_reg.raw[api_pk_reg_waddr] <= abr_reg_hwif_out.MLDSA_PUBKEY.wr_data;
    end
    else begin
      for (int unsigned i = 0; i < SEED_NUM_DWORDS; i++) begin
        if (abr_reg_hwif_out.MLKEM_SEED_Z[i].req & abr_reg_hwif_out.MLKEM_SEED_Z[i].req_is_wr & abr_ready & ~kv_mlkem_seed_data_present) begin
          abr_scratch_reg.mlkem_enc.seed_z[i] <= abr_reg_hwif_out.MLKEM_SEED_Z[i].wr_data;
        end
        `ifdef CALIPTRA
        if (kv_mlkem_seed_write_en & (kv_mlkem_seed_write_offset == (2*SEED_NUM_DWORDS - 1 - i))) begin
          abr_scratch_reg.mlkem_enc.seed_z[i] <= kv_mlkem_seed_write_data;
        end
        `endif
      end
    end
  end


  always_comb begin
    internal_mu_we = sampler_state_dv_i & (abr_instr.operand3 == MLDSA_DEST_MU_REG_ID);
    internal_mu_reg = sampler_state_data_i[511:0];
    mu_reg = external_mu_reg;
  end

  // without zeroize to make it more complex
  always_ff @(posedge clk or negedge rst_b) begin
    if (!rst_b) begin
      lfsr_seed_o <= '0;
      lfsr_entropy_reg <= '0;
    end
    else if (set_entropy) begin
      lfsr_entropy_reg <= lfsr_entropy_reg ^ entropy_reg;
    end
    else if (sampler_state_dv_i) begin
      // Entropy pass 1: capture the 512-bit entropy feedback only.
      if (abr_instr.operand3 == ABR_DEST_ENTROPY_REG_ID) begin
          lfsr_entropy_reg <= sampler_state_data_i[ENTROPY_LSB +: ENTROPY_W];
      end
      // Entropy pass 2: capture the LFSR seeds from a fresh squeeze; these bits are
      // disjoint from the pass-1 feedback, so no entropy output is ever reused.
      if (abr_instr.operand3 == ABR_DEST_LFSR_SEED_REG_ID) begin
          lfsr_seed_o.ntt  <= sampler_state_data_i[NTT_SEED_LSB +: NTT_SEED_W];
          lfsr_seed_o.dom  <= sampler_state_data_i[DOM_SEED_LSB +: KECCAK_DOM_LFSR_W];
          lfsr_seed_o.msg  <= sampler_state_data_i[MSG_SEED_LSB +: KECCAK_MSG_LFSR_W];
      end
    end
  end

  always_ff @(posedge clk or negedge rst_b) begin
    if (!rst_b) begin
      kappa_reg <= '0;
    end
    else if (zeroize) begin
      kappa_reg <= '0;
    end
    else if (update_kappa) begin
      kappa_reg <= kappa_reg + 7;
    end
  end
  
  always_ff @(posedge clk or negedge rst_b) begin
    if (!rst_b) begin
      mldsa_valid_reg <= '0;
      mlkem_valid_reg <= '0;
      signature_valid <= 0;
      verify_valid <= 0;
      decaps_valid <= 0;
      mldsa_keygen_process <= 0;
      mldsa_signing_process <= 0;
      mldsa_verifying_process <= 0;
      mldsa_keygen_signing_process <= 0;
      mlkem_keygen_process <= 0;
      mlkem_encaps_process <= 0;
      mlkem_decaps_process <= 0;
      mlkem_keygen_decaps_process <= 0;
    end
    else if (zeroize) begin
      mldsa_valid_reg <= '0;
      mlkem_valid_reg <= '0;
      signature_valid <= 0;
      verify_valid <= 0;
      decaps_valid <= 0;
      mldsa_keygen_process <= 0;
      mldsa_signing_process <= 0;
      mldsa_verifying_process <= 0;
      mldsa_keygen_signing_process <= 0;
      mlkem_keygen_process <= 0;
      mlkem_encaps_process <= 0;
      mlkem_decaps_process <= 0;
      mlkem_keygen_decaps_process <= 0;
    end
    else begin
      mldsa_valid_reg <= mldsa_valid_reg | mldsa_process_done;
      mlkem_valid_reg <= mlkem_valid_reg | mlkem_process_done;
      signature_valid <= set_signature_valid ? 1 :
                         clear_signature_valid ? 0 :
                         signature_valid;
      verify_valid <= set_verify_valid ? 1 :
                      clear_verify_valid ? 0 :
                      verify_valid;
      decaps_valid <= set_decaps_valid ? 1 :
                      clear_decaps_valid ? 0 :
                      decaps_valid;
      mldsa_keygen_process <= mldsa_process_done ? '0 : mldsa_keygen_process | mldsa_keygen_process_nxt;
      mldsa_signing_process <= mldsa_process_done ? '0 : mldsa_signing_process | mldsa_signing_process_nxt;
      mldsa_verifying_process <= mldsa_process_done ? '0 : mldsa_verifying_process | mldsa_verifying_process_nxt;
      mldsa_keygen_signing_process <= mldsa_process_done ? '0 : mldsa_keygen_signing_process | mldsa_keygen_signing_process_nxt;
      mlkem_keygen_process <= mlkem_process_done ? '0 : mlkem_keygen_process | mlkem_keygen_process_nxt;
      mlkem_encaps_process <= mlkem_process_done ? '0 : mlkem_encaps_process | mlkem_encaps_process_nxt;
      mlkem_decaps_process <= mlkem_process_done ? '0 : mlkem_decaps_process | mlkem_decaps_process_nxt;
      mlkem_keygen_decaps_process <= mlkem_process_done ? '0 : mlkem_keygen_decaps_process | mlkem_keygen_decaps_process_nxt;
    end
  end

  always_comb mldsa_process_done = (mldsa_keygen_process & mldsa_keygen_done) |
                                   (mldsa_signing_process & mldsa_signature_done) |
                                   (mldsa_verifying_process & mldsa_verify_done);
  
  always_comb mlkem_process_done = (mlkem_keygen_process & mlkem_keygen_done) |
                                   (mlkem_encaps_process & mlkem_encaps_done) |
                                   (mlkem_decaps_process & mlkem_decaps_done);

  always_ff @(posedge clk or negedge rst_b) begin
    if (!rst_b)
      external_mu_mode <= 0;  
    else if (zeroize | mldsa_process_done)
      external_mu_mode <= 0; 
    else 
      external_mu_mode <= external_mu_mode | external_mu_mode_nxt;
  end
      
  //Clear signature if makehint or normcheck fail
  always_comb clear_signature_valid = mldsa_signing_process & ((makehint_done_i & makehint_invalid_i) | (normcheck_done_i & normcheck_invalid_i));

  //Jump to done if this happens, could cause x reads (or fix sigdecode to not stop early)
  always_comb clear_verify_valid = mldsa_verifying_process & ((normcheck_done_i & normcheck_invalid_i) | 
                                   (abr_instr.opcode.aux_en & (abr_instr.opcode.mode.aux_mode == MLDSA_SIGDEC_H) & sigdecode_h_invalid_i));

  //--------------------------------------------------------------------
  // Explicit hardware signature verification result
  //
  // The recomputed c~ is compared against the c field of the supplied
  // signature by hardware, at the exact same cycle (and with the exact
  // same data) that populates MLDSA_VERIFY_RES.
  //
  // The result flop is cleared when a verify is started (set_verify_valid)
  // and when a verify is aborted early on a rejected signature
  // (clear_verify_valid). Early-abort paths jump straight to MLDSA_VERIFY_E
  // and never assert mldsa_verify_res_we, so the explicit clear guarantees
  // the flag can never report the verdict of a previous verify.
  //--------------------------------------------------------------------
  always_comb mldsa_verify_res_we = verify_valid & sampler_state_dv_i & (abr_instr.operand3 == MLDSA_DEST_VERIFY_RES_REG_ID);
  always_comb mldsa_verify_res_match = (sampler_state_data_i[(VERIFY_RES_NUM_DWORDS*32)-1:0] == signature_reg.enc.c);

  always_ff @(posedge clk or negedge rst_b) begin : mldsa_verify_result
    if (!rst_b)
      mldsa_verify_pass_reg <= 1'b0;
    else if (zeroize)
      mldsa_verify_pass_reg <= 1'b0;
    else if (set_verify_valid | clear_verify_valid)
      mldsa_verify_pass_reg <= 1'b0;
    else if (mldsa_verify_res_we)
      mldsa_verify_pass_reg <= mldsa_verify_res_match;
  end

  //Clear decaps valid if the compare of c fails
  always_comb clear_decaps_valid = mlkem_decaps_process & abr_instr.opcode.aux_en & (abr_instr.opcode.mode.aux_mode == MLKEM_COMPRESS) &
                                   compress_compare_mode_o & compress_compare_failed_i;

  always_comb encaps_input_check_failure = mlkem_encaps_process & abr_instr.opcode.aux_en & (abr_instr.opcode.mode.aux_mode == MLKEM_COMPRESS) & compress_compare_mode_o & compress_compare_failed_i;
  always_comb decaps_input_check_failure = mlkem_decaps_process & sampler_state_dv_i & (abr_instr.operand3 == MLKEM_DEST_TR_REG_ID) & (sampler_state_data_i[255:0] != abr_scratch_reg.mlkem_enc.tr);

  //ML-DSA sequencer, instruction is busy
  always_comb subcomponent_busy = !(abr_ctrl_fsm_ns inside {ABR_CTRL_IDLE, ABR_CTRL_MSG_WAIT}) |
                                  sampler_busy_i | ntt_busy;

always_comb begin
  error_flag = skdecode_error_i | encaps_input_check_failure | decaps_input_check_failure;
  `ifdef CALIPTRA
  //extra error condition for caliptra
  pcr_sign_input_invalid = (mldsa_cmd_reg inside {MLDSA_KEYGEN, MLDSA_SIGN, MLDSA_VERIFY}) & pcr_sign_mode;
  // All-zero KV seed/msg error detection
  mldsa_seed_zero_error = kv_mldsa_seed_data_present & (|mldsa_cmd_reg) & (mldsa_seed_reg == '0);
  mlkem_seed_zero_error = kv_mlkem_seed_data_present & (|mlkem_cmd_reg) & (mlkem_seed_d_reg == '0) & (abr_scratch_reg.mlkem_enc.seed_z == '0);
  mlkem_msg_zero_error  = kv_mlkem_msg_data_present  & (|mlkem_cmd_reg) & ~kv_mlkem_msg_nonzero;
  error_flag |= pcr_sign_input_invalid | mldsa_seed_zero_error | mlkem_seed_zero_error | mlkem_msg_zero_error;
  `else
  mldsa_seed_zero_error = '0;
  mlkem_seed_zero_error = '0;
  mlkem_msg_zero_error  = '0;
  `endif
end                              

  always_ff @(posedge clk or negedge rst_b) 
  begin : error_detection
      if(!rst_b)
          error_flag_reg <= 1'b0;
      else if(zeroize)
          error_flag_reg <= 1'b0;
      else if (error_flag)
          error_flag_reg <= 1'b1;
  end // error_detection

  always_comb error_flag_edge = error_flag & (!error_flag_reg);

  //program counter
  always_ff @(posedge clk or negedge rst_b) begin
    if(!rst_b) begin
      abr_prog_cntr <= ABR_RESET;
    end
    else if(zeroize) begin
      abr_prog_cntr <= ABR_ZEROIZE;
    end
    else if (error_flag_reg) begin
      abr_prog_cntr <= ABR_ERROR;
    end else begin
      abr_prog_cntr <= abr_prog_cntr_nxt;
    end
  end

  //Subroutine decode
  always_comb begin
    mldsa_keygen_process_nxt = 0;
    mldsa_signing_process_nxt = 0;
    mldsa_verifying_process_nxt = 0;
    mldsa_keygen_signing_process_nxt = 0;
    mldsa_keygen_done = 0;
    mldsa_signature_done = 0;
    mldsa_verify_done = 0;
    update_kappa = 0;
    set_verify_valid = 0; 
    set_signature_valid = 0;
    set_decaps_valid = 0;
    external_mu_mode_nxt = 0; 
    mlkem_keygen_process_nxt = 0;
    mlkem_encaps_process_nxt = 0;
    mlkem_decaps_process_nxt = 0;
    mlkem_keygen_decaps_process_nxt = 0;
    mlkem_keygen_done = 0;
    mlkem_encaps_done = 0;
    mlkem_decaps_done = 0;
    abr_prog_cntr_nxt = abr_prog_cntr;
    abr_seq_en = !zeroize;
    set_entropy = 0;

    unique case (abr_prog_cntr) inside
      ABR_RESET : begin 
        // Waiting for new valid command
        unique case ({mlkem_cmd_reg,mldsa_cmd_reg}) inside
          {MLKEM_NONE,MLDSA_KEYGEN} : begin  // keygen
            abr_prog_cntr_nxt = MLDSA_KG_S;
            mldsa_keygen_process_nxt = 1;
            set_entropy = 1;
          end
          {MLKEM_NONE,MLDSA_SIGN} : begin  // signing
            abr_prog_cntr_nxt = MLDSA_SIGN_S;
            mldsa_signing_process_nxt  = 1;
            set_signature_valid = 1;
            set_entropy = 1;
            external_mu_mode_nxt = external_mu;
          end
          {MLKEM_NONE,MLDSA_VERIFY} : begin  // verifying
            abr_prog_cntr_nxt = MLDSA_VERIFY_S;
            mldsa_verifying_process_nxt  = 1;
            set_verify_valid = 1;
            external_mu_mode_nxt = external_mu;
          end
          {MLKEM_NONE,MLDSA_KEYGEN_SIGN} : begin  // KEYGEN + SIGNING 
            abr_prog_cntr_nxt = MLDSA_KG_S;
            mldsa_keygen_signing_process_nxt  = 1;
            set_signature_valid = 1;
            set_entropy = 1;
            external_mu_mode_nxt = external_mu;
          end
          {MLKEM_KEYGEN,MLDSA_NONE} : begin  // MLKEM KEYGEN
            abr_prog_cntr_nxt = MLKEM_KG_S;
            mlkem_keygen_process_nxt  = 1;
            set_entropy = 1;
          end                    
          {MLKEM_ENCAPS,MLDSA_NONE} : begin  // MLKEM ENCAPS
            abr_prog_cntr_nxt = MLKEM_ENCAPS_S;
            mlkem_encaps_process_nxt  = 1;
            set_entropy = 1;
          end
          {MLKEM_DECAPS,MLDSA_NONE} : begin  // MLKEM DECAPS
            abr_prog_cntr_nxt = MLKEM_DECAPS_S;
            mlkem_decaps_process_nxt = 1;
            set_decaps_valid = 1;
            set_entropy = 1;
          end
          {MLKEM_KEYGEN_DEC,MLDSA_NONE} : begin  // MLKEM DECAPS
            abr_prog_cntr_nxt = MLKEM_KG_S;
            mlkem_keygen_decaps_process_nxt  = 1;
            set_decaps_valid = 1;
            set_entropy = 1;
          end
          default : begin
            abr_prog_cntr_nxt = ABR_RESET;
            abr_seq_en = 0;
            external_mu_mode_nxt = 0;
          end
        endcase
      end
      ABR_ZEROIZE : begin
        if (zeroize_mem_done)
          abr_prog_cntr_nxt = ABR_RESET;
        else
          abr_prog_cntr_nxt = ABR_ZEROIZE;
        abr_seq_en = 0;  
      end     
      MLDSA_KG_JUMP_SIGN : begin
        //Jump to signing process
        if (mldsa_keygen_signing_process) begin
          set_signature_valid = 1;
          abr_prog_cntr_nxt = MLDSA_SIGN_CHECK_MODE;
          mldsa_signing_process_nxt  = 1;
        end
        else begin
          abr_prog_cntr_nxt = abr_prog_cntr + 1;
        end
      end
      MLDSA_KG_E : begin // end of keygen
        mldsa_keygen_done = 1;
      end
      MLDSA_SIGN_CHECK_MODE : begin
        if (external_mu_mode)
          abr_prog_cntr_nxt = MLDSA_SIGN_H_RHO_P;
        else
          abr_prog_cntr_nxt = MLDSA_SIGN_H_MU;
      end
      MLDSA_SIGN_CHL_E : begin // end of challenge generation
        if (signature_valid) 
          abr_prog_cntr_nxt = MLDSA_SIGN_E;
        else begin
          set_signature_valid = 1;
          //increment kappa value
          update_kappa = 1;
          //restart challenge generation
          abr_prog_cntr_nxt = MLDSA_SIGN_LFSR_S;
       end
      end
      MLDSA_SIGN_E : begin // end of signature
        mldsa_signature_done = 1;
      end
      MLDSA_VERIFY_CHECK_MODE : begin
        if (external_mu_mode)
          abr_prog_cntr_nxt = MLDSA_VERIFY_MAKE_C;
        else
          abr_prog_cntr_nxt = MLDSA_VERIFY_H_MU;
      end
      MLDSA_VERIFY_E : begin // end of verify flow
        mldsa_verify_done = 1;
      end
      MLKEM_KG_E : begin // end of keygen
        if (mlkem_keygen_decaps_process) begin
          abr_prog_cntr_nxt = MLKEM_DECAPS_S;
          mlkem_decaps_process_nxt  = 1;
        end else begin
          mlkem_keygen_done = mlkem_keygen_process;
        end
      end
      MLKEM_ENCAPS_E : begin // end of encaps
        //Both encaps and encaps come here
        //if decaps, keep running to decaps chk state
        if (mlkem_decaps_process) begin
          abr_prog_cntr_nxt = MLKEM_DECAPS_CHK;
        end
        //else, we're done here
        else begin
          mlkem_encaps_done = 1;
        end
      end
      MLKEM_DECAPS_E : begin // end of decaps
        mlkem_decaps_done = 1; 
      end
      default : begin
        if (clear_verify_valid)
          abr_prog_cntr_nxt = MLDSA_VERIFY_E;
        else if (subcomponent_busy) begin //Stalled until sub-component is done 
          abr_prog_cntr_nxt = abr_prog_cntr;
        end
        else begin
          abr_prog_cntr_nxt = abr_prog_cntr + 1;
        end
      end
    endcase
  end

//Controller abr_instr decode - drives sampler and primary ntt
  always_comb begin
    sampler_mode_o = ABR_SAMPLER_NONE;
    if (abr_instr.opcode.sampler_en) begin
      if (abr_instr.opcode.ntt_en & abr_instr.opcode.mode.ntt_mode inside {MLDSA_PWM_SMPL, MLDSA_PWM_ACCUM_SMPL}) begin
        sampler_mode_o = MLDSA_REJ_SAMPLER;
      end else if (abr_instr.opcode.ntt_en & abr_instr.opcode.mode.ntt_mode inside {MLKEM_PWM_SMPL, MLKEM_PWM_ACCUM_SMPL}) begin
        sampler_mode_o = MLKEM_REJ_SAMPLER;
      end else begin
        sampler_mode_o = abr_instr.opcode.mode.sampler_mode;
      end
    end else if (abr_instr.opcode.keccak_en) begin
      sampler_mode_o = abr_instr.opcode.mode.sampler_mode;
    end else if (abr_instr.opcode.aux_en) begin
      if (abr_instr.opcode.mode.aux_mode == MLDSA_DECOMP) begin
        sampler_mode_o = ABR_SHAKE256;
      end
    end
  end

  always_comb sha3_masked_o = SHA3_MASKING_EN && abr_instr.opcode.mask_keccak_en;

  always_comb sampler_src_offset = {4'b0, msg_cnt};

  always_comb dest_base_addr_o = abr_instr.operand3[ABR_MEM_ADDR_WIDTH-1:0];
  always_comb aux_src0_base_addr_o = abr_instr.operand1[ABR_MEM_ADDR_WIDTH-1:0];
  always_comb aux_src1_base_addr_o = abr_instr.operand2[ABR_MEM_ADDR_WIDTH-1:0];
  always_comb aux_dest_base_addr_o = abr_instr.operand3[ABR_MEM_ADDR_WIDTH-1:0];

  always_comb normcheck_mode_o = (abr_instr.opcode.aux_en & (abr_instr.opcode.mode.aux_mode == MLDSA_NORMCHK)) ? abr_instr.imm[1:0] : '0;
  always_comb decompose_mode_o = abr_instr.opcode.aux_en & (abr_instr.opcode.mode.aux_mode == MLDSA_USEHINT);
  always_comb compress_mode_o = (abr_instr.opcode.aux_en & (abr_instr.opcode.mode.aux_mode == MLKEM_COMPRESS)) ? abr_instr.imm[1:0] : '0;
  always_comb compress_num_poly_o = (abr_instr.opcode.aux_en & (abr_instr.opcode.mode.aux_mode == MLKEM_COMPRESS)) ? abr_instr.imm[10:8] : '0;
  always_comb compress_compare_mode_o = abr_instr.opcode.aux_en & (abr_instr.opcode.mode.aux_mode == MLKEM_COMPRESS) & 
                                        ((abr_instr.imm[4] & mlkem_encaps_process) | (abr_instr.imm[5] & mlkem_decaps_process)); 
  always_comb decompress_mode_o = (abr_instr.opcode.aux_en & (abr_instr.opcode.mode.aux_mode == MLKEM_DECOMPRESS)) ? abr_instr.imm[1:0] : '0;
  always_comb decompress_num_poly_o = (abr_instr.opcode.aux_en & (abr_instr.opcode.mode.aux_mode == MLKEM_DECOMPRESS)) ? abr_instr.imm[10:8] : '0;
  
//Message streaming mode
//new input data available
always_ff @(posedge clk or negedge rst_b) begin
  if (!rst_b) begin
    stream_msg_valid <= 0;
  end
  else if (zeroize) begin
    stream_msg_valid <= 0;
  end
  else if (stream_msg_rdy) begin
    stream_msg_valid <= abr_reg_hwif_out.MLDSA_MSG[0].MSG.swmod;
  end
end 

//set stream message ip when given instruction to load MSG
always_comb stream_msg_ip = stream_msg_mode & (abr_ctrl_fsm_ps == ABR_CTRL_MSG_LOAD) & (sampler_src == MLDSA_MSG_ID);

//count how many dwords of ctx sent
always_ff @(posedge clk or negedge rst_b) begin
  if (!rst_b) begin
    ctx_cnt <= 0;
  end
  else if (zeroize) begin
    ctx_cnt <= 0;
  end
  else begin
    ctx_cnt <= ctx_cnt_nxt;
  end
end 

always_comb {ctx_cnt_required,ctx_cnt_offset} = ctx_size;

always_comb begin
  stream_msg_fsm_ns = stream_msg_fsm_ps;
  stream_msg_buffer_flush = 0;
  stream_msg_rdy = 0;
  stream_msg_done = 0;
  stream_msg_strobe = 0;
  stream_msg_data = 0;
  stream_msg_last = 0;
  ctx_cnt_nxt = 0;
  unique case (stream_msg_fsm_ps) inside
    MLDSA_MSG_IDLE: begin
      if (stream_msg_ip) stream_msg_fsm_ns = MLDSA_MSG_CTX_SIZE;
    end
    MLDSA_MSG_CTX_SIZE: begin
      //Drive context mode and size - 2 bytes
      stream_msg_strobe = 4'b0011;
      stream_msg_data = {16'h0, ctx_size, 8'h00};
      stream_msg_fsm_ns = MLDSA_MSG_CTX;
    end
    MLDSA_MSG_CTX: begin
      //Drive context
      ctx_cnt_nxt = ctx_cnt + 1;
      stream_msg_last = ctx_cnt >= ctx_cnt_required;
      stream_msg_strobe = stream_msg_last ? ~(STREAM_MSG_STROBE_W'('1) << ctx_cnt_offset) : '1;
      stream_msg_data = ctx_reg[ctx_cnt];
      if (ctx_cnt >= ctx_cnt_required) begin
        stream_msg_fsm_ns = MLDSA_MSG_RDY;
        ctx_cnt_nxt = 0;
      end
    end
    MLDSA_MSG_RDY: begin
      //Stream msg
      stream_msg_rdy = 1;
      stream_msg_strobe = stream_msg_valid ? abr_reg_hwif_out.MLDSA_MSG_STROBE.STROBE.value : '0;
      stream_msg_data = abr_reg_hwif_out.MLDSA_MSG[0].MSG.value;
      if ((stream_msg_strobe != '1) & stream_msg_valid) begin
        stream_msg_fsm_ns = MLDSA_MSG_FLUSH;
      end
    end
    MLDSA_MSG_FLUSH: begin
      //Flush buffer
      stream_msg_buffer_flush = 1;
      if (stream_msg_buffer_strobe == '0) begin
        stream_msg_fsm_ns = MLDSA_MSG_DONE;
      end
    end
    MLDSA_MSG_DONE: begin
      stream_msg_done = 1;
      stream_msg_fsm_ns = MLDSA_MSG_IDLE;
    end
    default: begin
    end
  endcase
end

//State flop
always_ff @(posedge clk or negedge rst_b) begin : stream_msg_fsm_flops
  if (!rst_b) begin
    stream_msg_fsm_ps <= MLDSA_MSG_IDLE;
  end
  else if (zeroize) begin
    stream_msg_fsm_ps <= MLDSA_MSG_IDLE;
  end
  else begin
    stream_msg_fsm_ps <= stream_msg_fsm_ns;
  end
end 

//Buffer msg data to align to msg interface
abr_msg_buffer #(
  .NUM_WR(STREAM_MSG_STROBE_W),
  .NUM_RD(MsgStrbW),
  .BUFFER_DATA_W(8) //stores on byte level
) stream_msg_buffer (
  .clk(clk),
  .rst_b(rst_b),
  .zeroize(zeroize),
  .flush(stream_msg_buffer_flush),
  //input data
  .data_valid_i(stream_msg_strobe),
  .data_i(stream_msg_data),
  .buffer_full_o(),
  //output data
  .data_valid_o(stream_msg_buffer_strobe),
  .data_hold_i('0),
  .data_o(stream_msg_buffer_data)
);

//send valid when full packet, or when flushing
always_comb stream_msg_buffer_valid = stream_msg_buffer_flush ? (|stream_msg_buffer_strobe) : (&stream_msg_buffer_strobe);

//determine the number of bytes in the last message
//operand 2 contains the length of the message being fed to sha3
//shift a zero into the strobe for each byte, and invert to get the valid bytes
always_comb last_msg_strobe = ~(MsgStrbW'('1) << abr_instr.length[$clog2(MsgStrbW)-1:0]);

//overload msg interface with stream msg interface
always_comb msg_cnt_nxt = stream_msg_ip ? '0 :
                          msg_done ? '0 :
                          msg_cnt_inc ? msg_cnt + 'd1 : msg_cnt;
always_comb msg_valid_nxt = stream_msg_ip ? stream_msg_buffer_valid : msg_valid;
always_comb msg_strobe_nxt = stream_msg_ip ? stream_msg_buffer_strobe :
                             msg_last ? last_msg_strobe : '1;

//Computing the msg interfaces signals
//Last cycle when msg count is equal to length - add a cnt for extra SRAM latency
//EK requires waiting for SRAM latency to drain before reading the flops
//Need to ensure that we increment the msg count 
always_comb begin
  msg_valid_stg = 0;
  msg_last = 0;
  msg_done = 0;
  msg_cnt_inc = 0;
  if (stream_msg_ip) begin
    msg_last = 0;
    msg_done = stream_msg_done;
  end
  else if (abr_ctrl_fsm_ps == ABR_CTRL_MSG_LOAD) begin
    if (sampler_src inside {MLKEM_EK_REG_ID}) begin
      if (sampler_src_offset inside {[0:191]}) begin //Delay the part from SRAM reads
        msg_cnt_inc = 1;
        msg_valid_stg = sampler_sk_rd_en[SRAM_LATENCY-1];
      end else if (sampler_sk_rd_en[SRAM_LATENCY-1]) begin //Dont increment msg cnt until SRAM reads have drained
        msg_cnt_inc = 0;
        msg_valid_stg = 1;
      end else begin //Read the data stored in flops
        msg_cnt_inc = 1;
        msg_valid_stg = 1;
      end

      msg_last = (msg_cnt == (abr_instr.length[ABR_OPR_WIDTH-1:$clog2(MsgStrbW)]));
      msg_done = (msg_cnt > (abr_instr.length[ABR_OPR_WIDTH-1:$clog2(MsgStrbW)]));
    end
    else if (sampler_src inside {MLKEM_MSG_ID,MLKEM_CIPHERTEXT_ID}) begin
      msg_cnt_inc = 1;
      msg_valid_stg = sampler_sk_rd_en[SRAM_LATENCY-1];
      msg_last = (msg_cnt == (abr_instr.length[ABR_OPR_WIDTH-1:$clog2(MsgStrbW)] + (SRAM_LATENCY-1)));
      msg_done = (msg_cnt > (abr_instr.length[ABR_OPR_WIDTH-1:$clog2(MsgStrbW)] + (SRAM_LATENCY-1)));
    end
    else if (sampler_src inside {MLDSA_PK_REG_ID} && sampler_src_offset >= 4) begin
      msg_cnt_inc = 1;
      msg_valid_stg = sampler_pk_rd_en[SRAM_LATENCY-1];
      msg_last = (msg_cnt == (abr_instr.length[ABR_OPR_WIDTH-1:$clog2(MsgStrbW)] + (SRAM_LATENCY-1)));
      msg_done = (msg_cnt > (abr_instr.length[ABR_OPR_WIDTH-1:$clog2(MsgStrbW)] + (SRAM_LATENCY-1)));
    end
    else begin
      msg_cnt_inc = 1;
      msg_valid_stg = 1;
      msg_last = (msg_cnt == abr_instr.length[ABR_OPR_WIDTH-1:$clog2(MsgStrbW)]);
      msg_done = (msg_cnt > abr_instr.length[ABR_OPR_WIDTH-1:$clog2(MsgStrbW)]);
    end
  end
end

always_ff @(posedge clk or negedge rst_b) begin
  if (!rst_b) begin
    msg_cnt <= 0;
    msg_valid_o <= 0;
    msg_strobe_o <= 0;
  end
  else if (zeroize) begin
    msg_cnt <= 0;
    msg_valid_o <= 0;
    msg_strobe_o <= 0;
  end
  else begin
    msg_cnt <= msg_cnt_nxt;
    msg_valid_o <= msg_valid_nxt;
    msg_strobe_o <= msg_strobe_nxt;
  end
end

//State logic
always_comb begin : ctrl_fsm_out_combo
    abr_ctrl_fsm_ns = abr_ctrl_fsm_ps;
    sha3_start_o = '0;
    msg_start_o = '0;
    msg_valid = '0;
    sampler_start_o = '0;
    sampler_src = '0;
    sampler_imm = '0;
    ntt_en = '0;
    power2round_enable_o = '0;
    decompose_enable_o = '0;
    skencode_enable_o = '0;
    pkdecode_enable_o = '0;
    sigdecode_h_enable_o = '0;
    sigdecode_z_enable_o = '0;
    skdecode_enable_o = '0;
    makehint_enable_o = '0;
    sigencode_enable_o = '0;
    normcheck_enable_o = '0;
    compress_enable_o = '0;
    decompress_enable_o = '0;
    lfsr_enable_o = '0;

    unique case (abr_ctrl_fsm_ps)
      ABR_CTRL_IDLE: begin
        //load keccak data to SIPO
        if (abr_instr.opcode.keccak_en)
          abr_ctrl_fsm_ns = ABR_CTRL_SHA3_START;
        else if (abr_instr.opcode.ntt_en & ntt_busy)
          abr_ctrl_fsm_ns = ABR_CTRL_STALLED;
        else if ((abr_instr.opcode.sampler_en | abr_instr.opcode.aux_en | abr_instr.opcode.ntt_en))
          abr_ctrl_fsm_ns = ABR_CTRL_FUNC_START;
      end
      ABR_CTRL_SHA3_START: begin
        abr_ctrl_fsm_ns = ABR_CTRL_MSG_START;
        //drive start
        sha3_start_o = 1;
      end
      ABR_CTRL_MSG_START: begin
        abr_ctrl_fsm_ns = ABR_CTRL_MSG_LOAD;
        msg_start_o = 1;
      end
      ABR_CTRL_MSG_LOAD: begin
        msg_valid = msg_valid_stg;
        sampler_src = abr_instr.operand1;
        sampler_imm = abr_instr.imm;
        if (msg_done) begin
          msg_valid =0;
          if (abr_instr.opcode.ntt_en & ntt_busy) abr_ctrl_fsm_ns = ABR_CTRL_STALLED;
          else if (abr_instr.opcode.sampler_en | abr_instr.opcode.aux_en | abr_instr.opcode.ntt_en) abr_ctrl_fsm_ns = ABR_CTRL_FUNC_START;
	  else abr_ctrl_fsm_ns = ABR_CTRL_MSG_WAIT;
        end
      end
      ABR_CTRL_MSG_WAIT: begin
        //load another message
        if (abr_instr.opcode.keccak_en) 
          abr_ctrl_fsm_ns = ABR_CTRL_MSG_LOAD;
        //NTT is stalled
        else if (abr_instr.opcode.ntt_en & ntt_busy) 
          abr_ctrl_fsm_ns = ABR_CTRL_STALLED;
        //Start the function
        else if ((abr_instr.opcode.sampler_en | abr_instr.opcode.aux_en | abr_instr.opcode.ntt_en))
          abr_ctrl_fsm_ns = ABR_CTRL_FUNC_START;
      end
      ABR_CTRL_STALLED: begin
        if (abr_instr.opcode.ntt_en & ~ntt_busy) 
          abr_ctrl_fsm_ns = ABR_CTRL_FUNC_START;
      end
      ABR_CTRL_FUNC_START: begin
        abr_ctrl_fsm_ns = ABR_CTRL_DONE;
        sampler_start_o = abr_instr.opcode.sampler_en;
        ntt_en = abr_instr.opcode.ntt_en;
        if (abr_instr.opcode.aux_en) begin
          power2round_enable_o = (abr_instr.opcode.mode.aux_mode == MLDSA_PWR2RND);
          decompose_enable_o = (abr_instr.opcode.mode.aux_mode inside {MLDSA_DECOMP,MLDSA_USEHINT});
          skencode_enable_o = (abr_instr.opcode.mode.aux_mode == MLDSA_SKENCODE);
          pkdecode_enable_o = (abr_instr.opcode.mode.aux_mode == MLDSA_PKDECODE);
          sigdecode_h_enable_o = (abr_instr.opcode.mode.aux_mode == MLDSA_SIGDEC_H);
          sigdecode_z_enable_o = (abr_instr.opcode.mode.aux_mode == MLDSA_SIGDEC_Z);
          skdecode_enable_o = (abr_instr.opcode.mode.aux_mode == MLDSA_SKDECODE);
          makehint_enable_o = (abr_instr.opcode.mode.aux_mode == MLDSA_MAKEHINT);
          sigencode_enable_o = (abr_instr.opcode.mode.aux_mode == MLDSA_SIGENC);
          normcheck_enable_o = (abr_instr.opcode.mode.aux_mode == MLDSA_NORMCHK);
          compress_enable_o = (abr_instr.opcode.mode.aux_mode == MLKEM_COMPRESS);
          decompress_enable_o = (abr_instr.opcode.mode.aux_mode == MLKEM_DECOMPRESS);
          lfsr_enable_o = (abr_instr.opcode.mode.aux_mode == MLDSA_LFSR);
        end
      end
      ABR_CTRL_DONE: begin
        if ((~sampler_busy_i & ~ntt_busy & ~abr_instr.opcode.aux_en) |
            (abr_instr.opcode.aux_en & (abr_instr.opcode.mode.aux_mode inside {MLDSA_DECOMP,MLDSA_USEHINT}) & decompose_done_i) |
            (abr_instr.opcode.aux_en & (abr_instr.opcode.mode.aux_mode == MLDSA_PWR2RND)    & power2round_done_i) |
            (abr_instr.opcode.aux_en & (abr_instr.opcode.mode.aux_mode == MLDSA_SKENCODE)   & skencode_done_i) |
            (abr_instr.opcode.aux_en & (abr_instr.opcode.mode.aux_mode == MLDSA_PKDECODE)   & pkdecode_done_i) |
            (abr_instr.opcode.aux_en & (abr_instr.opcode.mode.aux_mode == MLDSA_SIGDEC_H)   & sigdecode_h_done_i) |
            (abr_instr.opcode.aux_en & (abr_instr.opcode.mode.aux_mode == MLDSA_SIGDEC_Z)   & sigdecode_z_done_i) |
            (abr_instr.opcode.aux_en & (abr_instr.opcode.mode.aux_mode == MLDSA_NORMCHK)    & normcheck_done_i) |
            (abr_instr.opcode.aux_en & (abr_instr.opcode.mode.aux_mode == MLDSA_SKDECODE)   & skdecode_done_i) |
            (abr_instr.opcode.aux_en & (abr_instr.opcode.mode.aux_mode == MLDSA_MAKEHINT)   & makehint_done_i) |
            (abr_instr.opcode.aux_en & (abr_instr.opcode.mode.aux_mode == MLDSA_SIGENC)     & sigencode_done_i) |
            (abr_instr.opcode.aux_en & (abr_instr.opcode.mode.aux_mode == MLKEM_COMPRESS)   & compress_done_i) |
            (abr_instr.opcode.aux_en & (abr_instr.opcode.mode.aux_mode == MLKEM_DECOMPRESS) & decompress_done_i) |
            (abr_instr.opcode.aux_en & (abr_instr.opcode.mode.aux_mode == MLDSA_LFSR)) ) begin
          
          abr_ctrl_fsm_ns = ABR_CTRL_IDLE;

        end
      end
      default: begin
      end
    endcase
end

//State flop
always_ff @(posedge clk or negedge rst_b) begin : ctrl_fsm_flops
  if (!rst_b) begin
      abr_ctrl_fsm_ps <= ABR_CTRL_IDLE;
  end
  else if (zeroize) begin
      abr_ctrl_fsm_ps <= ABR_CTRL_IDLE;
  end
  else begin
      abr_ctrl_fsm_ps <= abr_ctrl_fsm_ns;
  end
end  

abr_seq abr_seq_inst
(
  .clk(clk),

  .en_i(abr_seq_en),
  .addr_i(abr_prog_cntr_nxt),
  .data_o(abr_instr_o)
);

//NTT gasket — single command output
//Check if ntt is being enabled in this clock also
always_comb begin
  ntt_busy = abr_instr.opcode.ntt_en & (ntt_busy_i | ntt_enable_o);
end

always_comb begin
  ntt_enable_o = ntt_en;
  ntt_mode_o = abr_instr.opcode.mode.ntt_mode;
  ntt_masking_en_o = abr_instr.opcode.masking_en & ntt_en;
  ntt_shuffling_en_o = abr_instr.opcode.shuffling_en;
  ntt_temp_address = abr_instr.imm[0] ? MLDSA_TEMP2_BASE[ABR_MEM_ADDR_WIDTH-1:0] : MLDSA_TEMP0_BASE[ABR_MEM_ADDR_WIDTH-1:0];
  ntt_mem_base_addr_o = '{src_base_addr:abr_instr.operand1[ABR_MEM_ADDR_WIDTH-1:0],
                                        interim_base_addr:ntt_temp_address,
                                        dest_base_addr:abr_instr.operand3[ABR_MEM_ADDR_WIDTH-1:0]};
  pwo_mem_base_addr_o = '{pw_base_addr_b:abr_instr.operand1[ABR_MEM_ADDR_WIDTH-1:0],
                                        pw_base_addr_a:abr_instr.operand2[ABR_MEM_ADDR_WIDTH-1:0],
                                        pw_base_addr_c:abr_instr.operand3[ABR_MEM_ADDR_WIDTH-1:0]};                                   
end

// Splitter/recombine is bypassed if masking is disabled.
always_comb split_en_o = MASKING_EN & abr_instr.opcode.masking_en & ~ntt_en;
always_comb recombine_en_o = MASKING_EN & abr_instr.opcode.recombine_en;

always_comb recombine_mode_o =
    (abr_instr.opcode.ntt_en & (abr_instr.opcode.mode.ntt_mode == MLKEM_PWS)) |
    (abr_instr.opcode.aux_en & (abr_instr.opcode.mode.aux_mode == MLKEM_COMPRESS));

always_comb abr_instr = ((abr_prog_cntr == ABR_ZEROIZE) | (abr_prog_cntr == ABR_RESET)) ? '0 : abr_instr_o;

always_ff @(posedge clk or negedge rst_b) begin
  if (!rst_b) begin
    zeroize_mem_addr <= 0;
    zeroize_mem_done <= 0;
  end
  else if (abr_prog_cntr == ABR_ZEROIZE) begin
    if (zeroize_mem_addr == ABR_MEM_MAX_DEPTH-1) begin
      zeroize_mem_addr <= 0;
      zeroize_mem_done <= 1;
    end else if (!zeroize_mem_done) begin
      zeroize_mem_addr <= zeroize_mem_addr + 1;
    end
  end else begin
    zeroize_mem_addr <= 0;
    zeroize_mem_done <= 0;
  end
end

always_comb zeroize_mem_we = (abr_prog_cntr == ABR_ZEROIZE) & !zeroize_mem_done;
always_comb zeroize_mem_we_pk = zeroize_mem_we && zeroize_mem_o.addr < PK_MEM_DEPTH;
always_comb zeroize_mem_we_sk = zeroize_mem_we && zeroize_mem_o.addr < SK_MEM_BANK_DEPTH;
always_comb zeroize_mem_we_sig = zeroize_mem_we && zeroize_mem_o.addr < SIG_Z_MEM_DEPTH;
always_comb zeroize_mem_o.rd_wr_en = zeroize_mem_we? RW_WRITE : RW_IDLE;
always_comb zeroize_mem_o.addr = zeroize_mem_addr;
  
`ifdef RV_FPGA_SCA
    //===========================================================================
    //
    //      ************** TRIGER Functionality **************
    //
    //===========================================================================
    logic NTT_raw_signal, PWM_raw_signal, PWA_raw_signal, INTT_raw_signal;
    gen_pulse_custom NTT_pulse
    (
        .clk(clk),
        .reset_n(rst_b),
        .raw_signal(NTT_raw_signal),
        .trigger_pulse(NTT_trigger)
    );

    gen_pulse_custom PWM_pulse
    (
        .clk(clk),
        .reset_n(rst_b),
        .raw_signal(PWM_raw_signal),
        .trigger_pulse(PWM_trigger)
    );
    
    gen_pulse_custom PWA_pulse
    (
        .clk(clk),
        .reset_n(rst_b),
        .raw_signal(PWA_raw_signal),
        .trigger_pulse(PWA_trigger)
    );

    gen_pulse_custom INTT_pulse
    (
        .clk(clk),
        .reset_n(rst_b),
        .raw_signal(INTT_raw_signal),
        .trigger_pulse(INTT_trigger)
    );

    always_ff @(posedge clk or negedge rst_b) begin
        if (!rst_b) begin
            NTT_raw_signal <= 'h0;
            PWM_raw_signal <= 'h0;
            PWA_raw_signal <= 'h0;
            INTT_raw_signal <= 'h0;
        end 
        else if (zeroize) begin
            NTT_raw_signal <= 'h0;
            PWM_raw_signal <= 'h0;
            PWA_raw_signal <= 'h0;
            INTT_raw_signal <= 'h0;
        end 
        else begin
            if (sec_seq_en) begin
                unique case(sec_prog_cntr_nxt)
                    MLDSA_SIGN_VALID_S : begin //NTT(C)
                        NTT_raw_signal <= 'h1;
                        PWM_raw_signal <= 'h0;
                        PWA_raw_signal <= 'h0;
                        INTT_raw_signal <= 'h0;
                    end
                    MLDSA_SIGN_VALID_S+2 : begin
                        NTT_raw_signal <= 'h0;
                        PWM_raw_signal <= 'h1;
                        PWA_raw_signal <= 'h0;
                        INTT_raw_signal <= 'h0;
                    end
                    MLDSA_SIGN_VALID_S+4 : begin
                        NTT_raw_signal <= 'h0;
                        PWM_raw_signal <= 'h0;
                        PWA_raw_signal <= 'h1;
                        INTT_raw_signal <= 'h0;
                    end
                    MLDSA_SIGN_VALID_S+3 : begin
                        NTT_raw_signal <= 'h0;
                        PWM_raw_signal <= 'h0;
                        PWA_raw_signal <= 'h0;
                        INTT_raw_signal <= 'h1;
                    end
                    default : begin
                        NTT_raw_signal <= 'h0;
                        PWM_raw_signal <= 'h0;
                        PWA_raw_signal <= 'h0;
                        INTT_raw_signal <= 'h0;
                    end
                endcase 
            end
        end
    end
`endif

  `ABR_ASSERT_KNOWN(ERR_ABR_CTRL_FSM_X, {abr_ctrl_fsm_ps}, clk, !rst_b)
  `ABR_ASSERT_KNOWN(ERR_NTT_MEM_X, {ntt_mem_base_addr_o}, clk, !rst_b) 
  `ABR_ASSERT_KNOWN(ERR_PWO_MEM_X, {pwo_mem_base_addr_o}, clk, !rst_b)
  `ABR_ASSERT_KNOWN(ERR_REG_HWIF_X, {abr_reg_hwif_in_o}, clk, !rst_b)
  `ABR_ASSERT(ZEROIZE_SEED_REG, $fell(zeroize) |-> (mldsa_seed_reg === '0), clk, !rst_b)

  // ------------------------------------------------------------------
  // Decode-partition mutex checks
  //
  // For every API bus that is partitioned between a scratch-reg region
  // and a memory region (or between multiple memory regions), the decode
  // signals must be mutually exclusive on any given cycle. A shared
  // endpoint (e.g. write decode [0:31] AND [31:...]) collapses two
  // buffers onto the same address and drives a spurious write; that is
  // exactly the class of bug tracked as adams-bridge #284.
  //
  // These MUTEX assertions catch overlap the first time the boundary
  // address is exercised, regardless of which side of the split is the
  // logically intended target.
  // ------------------------------------------------------------------
  `ABR_ASSERT_MUTEX(ERR_MLDSA_PRIVKEY_IN_DEC_MUTEX,
                    {api_sk_reg_wr_dec, api_keymem_wr_dec}, clk, !rst_b)
  `ABR_ASSERT_MUTEX(ERR_MLDSA_PRIVKEY_OUT_DEC_MUTEX,
                    {api_sk_reg_rd_dec, api_keymem_rd_dec}, clk, !rst_b)
  `ABR_ASSERT_MUTEX(ERR_MLKEM_DK_DEC_MUTEX,
                    {mlkem_api_dk_reg_dec, mlkem_api_dk_mem_dec}, clk, !rst_b)
  `ABR_ASSERT_MUTEX(ERR_MLKEM_EK_DEC_MUTEX,
                    {mlkem_api_ek_reg_dec, mlkem_api_ek_mem_dec}, clk, !rst_b)
  `ABR_ASSERT_MUTEX(ERR_MLDSA_SIG_DEC_MUTEX,
                    {api_sig_c_dec, api_sig_z_dec, api_sig_h_dec}, clk, !rst_b)
  `ABR_ASSERT_MUTEX(ERR_MLDSA_PUBKEY_DEC_MUTEX,
                    {api_pubkey_rho_dec, api_pubkey_dec}, clk, !rst_b)

  `ABR_ASSERT(ERR_MLDSA_PRIVKEY_WR_REG_MATCHES_RD,
              api_sk_reg_wr_dec |-> (api_sk_waddr < 'd32), clk, !rst_b)
  `ABR_ASSERT(ERR_MLDSA_PRIVKEY_WR_MEM_MATCHES_RD,
              api_keymem_wr_dec |-> (api_sk_waddr >= 'd32), clk, !rst_b)

  `ABR_ASSERT(ERR_MLDSA_PRIVKEY_SK_MEM_WADDR_IN_RANGE,
              (abr_reg_hwif_in.MLDSA_PRIVKEY_IN.wr_ack & abr_ready & api_keymem_wr_dec)
                |-> (api_sk_mem_waddr < (PRIVKEY_NUM_DWORDS - 32)),
              clk, !rst_b)

`ifdef CALIPTRA
  `ABR_ASSERT_STABLE(ERR_ABR_MLDSA_SEED_RD_CTRL_NOT_STABLE, kv_mldsa_seed_read_ctrl_reg, clk, (!rst_b || (abr_prog_cntr == ABR_RESET)) )
  `ABR_ASSERT_STABLE(ERR_ABR_MLKEM_SEED_RD_CTRL_NOT_STABLE, kv_mlkem_seed_read_ctrl_reg, clk, (!rst_b || (abr_prog_cntr == ABR_RESET)) )
  `ABR_ASSERT_STABLE(ERR_ABR_MLKEM_MSG_RD_CTRL_NOT_STABLE,  kv_mlkem_msg_read_ctrl_reg , clk, (!rst_b || (abr_prog_cntr == ABR_RESET)) )
`endif

endmodule
