chipsalliance/adams-bridge/src/abr_top/rtl/abr_top.sv

// SPDX-License-Identifier: Apache-2.0
//
// Licensed under the Apache License, Version 2.0 (the "License");
// you may not use this file except in compliance with the License.
// You may obtain a copy of the License at
//
// http://www.apache.org/licenses/LICENSE-2.0
//
// Unless required by applicable law or agreed to in writing, software
// distributed under the License is distributed on an "AS IS" BASIS,
// WITHOUT WARRANTIES OR CONDITIONS OF ANY KIND, either express or implied.
// See the License for the specific language governing permissions and
// limitations under the License.

//Initial top level module
`include "abr_config_defines.svh"
`include "abr_prim_assert.sv"

module abr_top
  import abr_prim_alert_pkg::*;
  import abr_reg_pkg::*;
  import abr_params_pkg::*;
  import abr_ctrl_pkg::*;
  import abr_sampler_pkg::*;
  import abr_sha3_pkg::*;
  import ntt_defines_pkg::*;
  import decompose_defines_pkg::*;
  import compress_defines_pkg::*;
  import decompress_defines_pkg::*;
  `ifdef CALIPTRA
  import kv_defines_pkg::*; 
  `endif
  #(
  //top level params
    parameter bit MASKING_EN = 1,
    parameter bit SHA3_MASKING_EN = 1,
    parameter SRAM_LATENCY = 1, //SRAM read latency in cycles
    parameter AHB_ADDR_WIDTH = 32,
    parameter AHB_DATA_WIDTH = 64,
    parameter CLIENT_DATA_WIDTH = 32
  )
  (
  input logic clk,
  input logic rst_b,

`ifdef RV_FPGA_SCA
  output wire NTT_trigger,
  output wire PWM_trigger,
  output wire PWA_trigger,
  output wire INTT_trigger,
`endif

  //ahb input
  input logic  [AHB_ADDR_WIDTH-1:0] haddr_i,
  input logic  [AHB_DATA_WIDTH-1:0] hwdata_i,
  input logic                       hsel_i,
  input logic                       hwrite_i,
  input logic                       hready_i,
  input logic  [1:0]                htrans_i,
  input logic  [2:0]                hsize_i,

  //ahb output
  output logic                      hresp_o,
  output logic                      hreadyout_o,
  output logic [AHB_DATA_WIDTH-1:0] hrdata_o,

  abr_mem_if.req                  abr_memory_export,

  `ifdef CALIPTRA
  // KV interface
  output kv_read_t [2:0] kv_read,
  input kv_rd_resp_t [2:0] kv_rd_resp,
  output kv_write_t kv_write,
  input kv_wr_resp_t kv_wr_resp,
  //PCR Signing
  input pcr_signing_t pcr_signing_data,
  input logic ocp_lock_in_progress,
  `endif
  //Zeroize the engine if entering debug or scan mode
  input logic debugUnlock_or_scan_mode_switch,

  output logic                      busy_o,

  output logic                      error_intr,
  output logic                      notif_intr


  );

//Signal Declarations
  localparam ABR_NUM_NTT = MASKING_EN ? 2 : 1;
  // Safe array index for share[1] refs in MASKING_EN=0 dead branches (avoids VCS SIOB).
  localparam MASKED_IDX  = MASKING_EN ? 1 : 0;
  logic zeroize_reg;

  abr_sampler_mode_e         sampler_mode;
  logic                      sha3_start;
  logic                      sha3_masked;
  logic                      msg_start;
  logic                      msg_valid;
  logic                      msg_rdy;
  logic [MsgStrbW-1:0]       msg_strobe;
  logic [MsgWidth-1:0]       msg_data;
  logic                      sampler_start;
  logic [ABR_MEM_ADDR_WIDTH-1:0] dest_base_addr;

  logic                        sampler_busy;
  logic                        sampler_state_dv;
  logic [abr_sha3_pkg::StateW-1:0] sampler_state_data;

  logic sampler_mem_dv;
  logic [ABR_MEM_DATA_WIDTH-1:0] sampler_mem_data [ABR_NUM_NTT];
  logic [ABR_MEM_ADDR_WIDTH-1:0] sampler_mem_addr;

  logic [ABR_NUM_NTT-1:0] sampler_ntt_dv, sampler_ntt_dv_f;
  logic [ABR_NUM_NTT-1:0] sampler_ntt_mode;
  logic [ABR_NUM_NTT-1:0] sampler_valid;
  logic [COEFF_PER_CLK-1:0][MLDSA_Q_WIDTH-1:0] sampler_ntt_data;

  abr_ntt_mode_e [ABR_NUM_NTT-1:0] ntt_mode;
  mode_t [ABR_NUM_NTT-1:0] mode;
  logic [ABR_NUM_NTT-1:0] accumulate;
  logic [ABR_NUM_NTT-1:0] ntt_enable;
  logic [ABR_NUM_NTT-1:0] mlkem_mode;
  ntt_mem_addr_t [ABR_NUM_NTT-1:0] ntt_mem_base_addr;
  pwo_mem_addr_t [ABR_NUM_NTT-1:0] pwo_mem_base_addr;

  // Controller outputs — single command set
  abr_ntt_mode_e ntt_mode_ctrl;
  logic ntt_enable_ctrl;
  ntt_mem_addr_t ntt_mem_base_addr_ctrl;
  pwo_mem_addr_t pwo_mem_base_addr_ctrl;
  logic ntt_masking_en_ctrl;
  logic ntt_shuffling_en_ctrl;
  logic split_en;
  // Aggregate recombine enable + mode driven by abr_ctrl.
  logic [1:0][ABR_MEM_DATA_WIDTH-1:0] recombine_share0;
  logic [1:0][ABR_MEM_DATA_WIDTH-1:0] recombine_share1;
  logic [1:0][ABR_MEM_DATA_WIDTH-1:0] recombine_data;
  logic                          recombine_en;
  logic [SRAM_LATENCY:0]         recombine_en_pipe;
  logic                          recombine_mode;       // 0 = MLDSA, 1 = MLKEM (stable for entire op)
  mem_if_t [ABR_NUM_NTT-1:0] ntt_mem_wr_req;
  logic [ABR_NUM_NTT-1:0][2:0][ABR_MEM_ADDR_WIDTH-1:0] ntt_mem_wr_req_mux;
  mem_if_t [ABR_NUM_NTT-1:0] ntt_mem_rd_req;
  logic [ABR_NUM_NTT-1:0][2:0][ABR_MEM_ADDR_WIDTH-1:0] ntt_mem_rd_req_mux;
  logic [ABR_NUM_NTT-1:0][ABR_MEM_DATA_WIDTH-1:0] ntt_mem_wr_data;
  logic [ABR_NUM_NTT-1:0][2:0][ABR_MEM_DATA_WIDTH-1:0] ntt_mem_wr_data_mux;
  logic [ABR_NUM_NTT-1:0][ABR_MEM_DATA_WIDTH-1:0] ntt_mem_rd_data;
  logic [ABR_NUM_NTT-1:0] ntt_mem_rd_data_valid;
  mem_if_t [ABR_NUM_NTT-1:0] pwm_a_rd_req;
  logic [ABR_NUM_NTT-1:0][2:0][ABR_MEM_ADDR_WIDTH-1:0] pwm_a_rd_req_mux;
  mem_if_t [ABR_NUM_NTT-1:0] pwm_b_rd_req;
  logic [ABR_NUM_NTT-1:0][2:0][ABR_MEM_ADDR_WIDTH-1:0] pwm_b_rd_req_mux;
  logic [ABR_NUM_NTT-1:0][ABR_MEM_DATA_WIDTH-1:0] pwm_a_rd_data;
  logic [ABR_NUM_NTT-1:0][ABR_MEM_DATA_WIDTH-1:0] pwm_b_rd_data;
  logic [ABR_NUM_NTT-1:0] pwm_a_rd_data_valid;
  logic [ABR_NUM_NTT-1:0] pwm_b_rd_data_valid;
  logic [ABR_NUM_NTT-1:0] ntt_busy;
  logic [ABR_NUM_NTT-1:0] ntt_done;
  logic [ABR_NUM_NTT-1:0] ntt_shuffling_en;

  mem_if_t w1_mem_wr_req;
  logic [ABR_MEM_W1_DATA_W-1:0] w1_mem_wr_data;
  mem_if_t w1_mem_rd_req;
  logic [ABR_MEM_W1_DATA_W-1:0] w1_mem_rd_data;

  logic decomp_msg_valid;
  logic [MsgWidth-1:0] decomp_msg_data;

  logic [ABR_MEM_ADDR_WIDTH-1:0] aux_src0_base_addr;
  logic [ABR_MEM_ADDR_WIDTH-1:0] aux_src1_base_addr;
  logic [ABR_MEM_ADDR_WIDTH-1:0] aux_dest_base_addr;

  logic power2round_enable, power2round_done;
  mem_if_t [1:0] pwr2rnd_mem_rd_req;
  logic [1:0][ABR_MEM_DATA_WIDTH-1:0] pwr2rnd_mem_rd_data;
  logic pwr2rnd_mem_rd_data_valid;
  mem_if_t [1:0] pwr2rnd_keymem_if;
  logic [1:0] [ABR_REG_WIDTH-1:0] pwr2rnd_wr_data;
  logic pk_t1_wren;
  logic [7:0][T1_COEFF_W-1:0] pk_t1_wrdata;
  logic [7:0] pk_t1_wr_addr;

  logic decompose_enable, decompose_done;
  mem_if_t decomp_mem_wr_req;
  mem_if_t [1:0] decomp_mem_rd_req;
  logic [ABR_MEM_DATA_WIDTH-1:0] decomp_mem_wr_data;
  logic [1:0][ABR_MEM_DATA_WIDTH-1:0] decomp_mem_rd_data;
  logic decomp_mem_rd_data_valid;
  logic decompose_mode;

  logic skencode_enable, skencode_done;
  mem_if_t skencode_keymem_if;
  logic [ABR_REG_WIDTH-1:0] skencode_wr_data;
  mem_if_t [1:0] skencode_mem_rd_req;
  logic [1:0][ABR_MEM_DATA_WIDTH-1:0] skencode_mem_rd_data;
  logic skencode_mem_rd_data_valid;

  logic skdecode_enable, skdecode_done;
  mem_if_t [1:0] skdecode_keymem_if;
  logic [1:0][ABR_REG_WIDTH-1:0] skdecode_rd_data;
  logic [1:0] skdecode_rd_data_valid;
  mem_if_t [1:0] skdecode_mem_wr_req;
  logic [ABR_NUM_NTT-1:0][ABR_MEM_DATA_WIDTH-1:0] skdecode_mem_wr_data_a;
  logic [ABR_NUM_NTT-1:0][ABR_MEM_DATA_WIDTH-1:0] skdecode_mem_wr_data_b;
  logic skdecode_error;

  logic makehint_enable, makehint_done;
  logic makehint_invalid;
  mem_if_t makehint_mem_rd_req;
  logic [ABR_MEM_DATA_WIDTH-1:0] makehint_mem_rd_data;
  logic makehint_mem_rd_data_valid;
  logic makehint_reg_wren;
  logic [3:0][7:0] makehint_reg_wrdata;
  logic [ABR_MEM_ADDR_WIDTH-1:0] makehint_reg_wr_addr;

  logic normcheck_enable;
  logic normcheck_done;
  logic [1:0] normcheck_mode;
  logic normcheck_invalid;
  mem_if_t normcheck_mem_rd_req;
  logic [ABR_MEM_DATA_WIDTH-1:0] normcheck_mem_rd_data;
  logic normcheck_mem_rd_data_valid;

  logic compress_enable;
  logic compress_done;
  logic compress_compare_failed;
  compress_mode_t compress_mode;
  logic compress_compare_mode;
  logic [2:0] compress_num_poly;
  mem_if_t compress_mem_rd_req;
  logic [ABR_MEM_DATA_WIDTH-1:0] compress_mem_rd_data;
  logic compress_mem_rd_data_valid;
  logic [1:0] compress_api_rw_en;
  logic [ABR_MEM_ADDR_WIDTH-1:0] compress_api_rw_addr;
  logic [ABR_REG_WIDTH-1:0] compress_api_wr_data;
  logic [ABR_REG_WIDTH-1:0] compress_api_rd_data;
  logic compress_api_rd_data_valid;

  logic decompress_enable;
  logic decompress_done;
  decompress_mode_t decompress_mode;
  logic [2:0] decompress_num_poly;
  mem_if_t decompress_mem_wr_req;
  logic [ABR_NUM_NTT-1:0][ABR_MEM_DATA_WIDTH-1:0] decompress_mem_wr_data;
  logic decompress_api_rd_en;
  logic [ABR_MEM_ADDR_WIDTH-1:0] decompress_api_rd_addr;
  logic [1:0][ABR_REG_WIDTH-1:0] decompress_api_rd_data;
  logic decompress_api_rd_data_valid;

  logic sigencode_enable, sigencode_done;
  mem_if_t [1:0] sigencode_mem_rd_req;
  logic [1:0][ABR_MEM_DATA_WIDTH-1:0] sigencode_mem_rd_data;
  logic sigencode_mem_rd_data_valid;
  mem_if_t sigencode_mem_wr_req;
  logic [1:0][3:0][19:0] sigencode_mem_wr_data;

  logic pkdecode_enable, pkdecode_done;
  mem_if_t [1:0] pkdecode_mem_wr_req;
  logic [1:0][ABR_MEM_DATA_WIDTH-1:0] pkdecode_mem_wr_data;
  logic pkdecode_rd_en;
  logic [7:0] pkdecode_rd_addr;
  logic [7:0][T1_COEFF_W-1:0] pkdecode_rd_data;
  logic pkdecode_rd_data_valid;

  logic sigdecode_z_enable, sigdecode_z_done;
  mem_if_t [1:0] sigdecode_z_mem_wr_req;
  logic [1:0][ABR_MEM_DATA_WIDTH-1:0] sigdecode_z_mem_wr_data;
  mem_if_t sigdecode_z_mem_rd_req;
  logic [1:0][3:0][19:0] sigdecode_z_mem_rd_data;
  logic sigdecode_z_mem_rd_data_valid;

  logic sigdecode_h_enable, sigdecode_h_done;
  logic [SIGNATURE_H_VALID_NUM_BYTES-1:0][7:0] signature_h;
  logic sigdecode_h_invalid;
  mem_if_t sigdecode_h_mem_wr_req;
  logic [ABR_MEM_DATA_WIDTH-1:0] sigdecode_h_mem_wr_data;

  mem_if_t                       sib_mem_rd_req;
  logic [ABR_MEM_DATA_WIDTH-1:0] sib_mem_rd_data;
  logic sib_mem_rd_data_valid;

  logic lfsr_enable;
  abr_lfsr_seed_t lfsr_seed;
  logic [NTT_NUM_LFSR-1:0][NTT_LFSR_W-1:0] rand_bits;

  // Dedicated masked-Keccak LFSRs (independent of the NTT masking LFSRs above).
  //  - DOM bank: free-running, full-width, zero-stall (5*161 = 805 >= 801).
  //  - Msg LFSR: single 64b, advanced only on an accepted masked message beat.
  // Seeds arrive inside lfsr_seed (.dom/.msg); the sequencer always seeds before
  // any masked SHA3 op, so no separate "seeded" gate is tracked here.
  logic [KECCAK_DOM_NUM_LFSR-1:0][KECCAK_DOM_LFSR_DW-1:0]  keccak_dom_lfsr_state;
  logic [KECCAK_DOM_LFSR_W-1:0]                            keccak_dom_rand_bits;
  logic [KECCAK_MSG_LFSR_W-1:0]                            keccak_msg_rand_bits;
  logic [abr_sha3_pkg::StateW/2-1:0]                       keccak_dom_rand;
  logic [MsgWidth-1:0]                                     keccak_msg_mask;
  logic                                                    keccak_aux_rand;

  //gasket to assemble reg requests
  logic abr_reg_dv;
  logic abr_reg_hold;
  logic abr_reg_rd_ack, abr_reg_wr_ack;
  logic [CLIENT_DATA_WIDTH-1:0] abr_reg_rdata;
  logic [AHB_ADDR_WIDTH-1:0]    abr_reg_addr;
  logic [CLIENT_DATA_WIDTH-1:0] abr_reg_wdata;
  logic                         abr_reg_write;

  logic abr_reg_err, abr_reg_read_err, abr_reg_write_err;

  abr_reg__in_t abr_reg_hwif_in;
  abr_reg__out_t abr_reg_hwif_out;

  mem_if_t zeroize_mem;
  logic zeroize_mem_we;
  logic [2:0] zeroize_mem_we_inst;
  logic zeroize_mem_we_w1_inst;
  logic zeroize_mem_re;
  logic [ABR_MEM_ADDR_WIDTH-1:0] zeroize_mem_addr;
    
  //Memory interface decode — [ABR_NUM_NTT-1:0] outermost: [0]=regular, [1]=masked
  logic [ABR_NUM_NTT-1:0][2:1] abr_mem_re;
  logic [ABR_NUM_NTT-1:0][2:1][ABR_MEM_ADDR_WIDTH-4:0] abr_mem_raddr;
  logic [ABR_NUM_NTT-1:0][2:1][ABR_MEM_DATA_WIDTH-1:0] abr_mem_rdata;
  logic [ABR_NUM_NTT-1:0][1:0] abr_mem_re0_bank;
  logic [ABR_NUM_NTT-1:0][1:0][ABR_MEM_ADDR_WIDTH-5:0] abr_mem_raddr0_bank;
  logic [ABR_NUM_NTT-1:0][1:0][ABR_MEM_DATA_WIDTH-1:0] abr_mem_rdata0_bank;
  logic [ABR_NUM_NTT-1:0][2:1] abr_mem_we;
  logic [ABR_NUM_NTT-1:0][2:1][ABR_MEM_ADDR_WIDTH-4:0] abr_mem_waddr;
  logic [ABR_NUM_NTT-1:0][2:1][ABR_MEM_DATA_WIDTH-1:0] abr_mem_wdata;
  logic [ABR_NUM_NTT-1:0][1:0] abr_mem_we0_bank;
  logic [ABR_NUM_NTT-1:0][1:0][ABR_MEM_ADDR_WIDTH-5:0] abr_mem_waddr0_bank;
  logic [ABR_NUM_NTT-1:0][1:0][ABR_MEM_DATA_WIDTH-1:0] abr_mem_wdata0_bank;

  logic [2:1] sampler_mem_we;
  logic [ABR_NUM_NTT-1:0][2:0] ntt_mem_we;
  logic [ABR_NUM_NTT-1:0][2:0] ntt_mem_we_mux;
  logic [ABR_NUM_NTT-1:0][1:0] ntt_mem_we0_bank;
  logic [2:1] decomp_mem_we;
  logic [1:0] sampler_mem_we0_bank;
  logic [1:0] decomp_mem_we0_bank;
  logic [1:0] skdecode_mem_we0_bank;
  logic [1:0] pkdecode_mem_we0_bank;
  logic [1:0] sigdecode_z_mem_we0_bank;
  logic [2:1] sigdecode_h_mem_we;
  logic [1:0] sigdecode_h_mem_we0_bank;
  logic [1:0] decompress_mem_we0_bank;
  logic [2:1] decompress_mem_we;

  logic [ABR_NUM_NTT-1:0][2:0] ntt_mem_re[SRAM_LATENCY:0];
  logic [ABR_NUM_NTT-1:0][2:0] pwo_a_mem_re[SRAM_LATENCY:0];
  logic [ABR_NUM_NTT-1:0][2:0] pwo_b_mem_re[SRAM_LATENCY:0];
  logic [1:0][2:1] decomp_mem_re[SRAM_LATENCY:0];
  logic [2:1] normcheck_mem_re[SRAM_LATENCY:0];
  logic [2:1] compress_mem_re[SRAM_LATENCY:0];
  logic [ABR_NUM_NTT-1:0][1:0] ntt_mem_re0_bank[SRAM_LATENCY:0];
  logic [ABR_NUM_NTT-1:0][1:0] pwo_a_mem_re0_bank[SRAM_LATENCY:0];
  logic [ABR_NUM_NTT-1:0][1:0] pwo_b_mem_re0_bank[SRAM_LATENCY:0];
  logic [1:0][1:0] decomp_mem_re0_bank[SRAM_LATENCY:0];
  logic [1:0] normcheck_mem_re0_bank[SRAM_LATENCY:0];
  logic [1:0] compress_mem_re0_bank[SRAM_LATENCY:0];
  logic [2:1] makehint_mem_re[SRAM_LATENCY:0];
  logic [ABR_NUM_NTT-1:0][2:0] ntt_mem_re_mux;
  logic [ABR_NUM_NTT-1:0][2:0] pwo_a_mem_re_mux;
  logic [ABR_NUM_NTT-1:0][2:0] pwo_b_mem_re_mux;
  logic [ABR_NUM_NTT-1:0][1:0] ntt_mem_re0_bank_mux;
  logic [ABR_NUM_NTT-1:0][1:0] pwo_a_mem_re0_bank_mux;
  logic [ABR_NUM_NTT-1:0][1:0] pwo_b_mem_re0_bank_mux;
  logic [1:0] skencode_mem_re0_bank[SRAM_LATENCY:0];
  logic [1:0] sigencode_mem_re0_bank[SRAM_LATENCY:0];
  logic [1:0] pwr2rnd_mem_re0_bank[SRAM_LATENCY:0];

  logic sib_mem_re[1:0];
  logic [ABR_NUM_NTT-1:0] ntt_sib_rd_detect;
  logic [ABR_NUM_NTT-1:0] ntt_sib_rd_detect_d1;

  //memory interfaces
  abr_sram_if #(.ADDR_W(SK_MEM_BANK_ADDR_W), .DATA_W(SK_MEM_BANK_DATA_W)) sk_bank0_mem_if();
  abr_sram_if #(.ADDR_W(SK_MEM_BANK_ADDR_W), .DATA_W(SK_MEM_BANK_DATA_W)) sk_bank1_mem_if();
  abr_sram_be_if #(.ADDR_W(SIG_Z_MEM_ADDR_W), .DATA_W(SIG_Z_MEM_DATA_W)) sig_z_mem_if();
  abr_sram_be_if #(.ADDR_W(PK_MEM_ADDR_W), .DATA_W(PK_MEM_DATA_W)) pk_mem_if();

  logic [1:0][ABR_MEM_DATA_WIDTH-1:0] splitter_rand;
  logic [ABR_NUM_NTT-1:0][5:0] shuffling_rand;
  for (genvar gi = 0; gi < 2; gi++) begin : gen_rand_assign
    assign splitter_rand[gi]  = rand_bits[gi][ABR_MEM_DATA_WIDTH-1:0];
    if (gi < ABR_NUM_NTT) begin : gen_shuffle
      assign shuffling_rand[gi] = rand_bits[gi][ABR_MEM_DATA_WIDTH+5:ABR_MEM_DATA_WIDTH];
    end
  end

  abr_ahb_slv_sif #(
    .AHB_ADDR_WIDTH(AHB_ADDR_WIDTH),
    .AHB_DATA_WIDTH(AHB_DATA_WIDTH),
    .CLIENT_DATA_WIDTH(CLIENT_DATA_WIDTH)
)
  mldsa_ahb_slv_inst (
    //AMBA AHB Lite INF
    .hclk(clk),
    .hreset_n(rst_b),
    .haddr_i(haddr_i),
    .hwdata_i(hwdata_i),
    .hsel_i(hsel_i),
    .hwrite_i(hwrite_i),
    .hready_i(hready_i),
    .htrans_i(htrans_i),
    .hsize_i(hsize_i),

    .hresp_o(hresp_o),
    .hreadyout_o(hreadyout_o),
    .hrdata_o(hrdata_o),

    //COMPONENT INF
    .dv(abr_reg_dv),
    .hld(abr_reg_hold),
    .err(abr_reg_err),
    .write(abr_reg_write),
    .wdata(abr_reg_wdata),
    .addr(abr_reg_addr[AHB_ADDR_WIDTH-1:0]),

    .rdata(abr_reg_rdata)
);

always_comb abr_reg_err = (abr_reg_rd_ack & abr_reg_read_err) | (abr_reg_wr_ack & abr_reg_write_err);
always_comb abr_reg_hold = abr_reg_dv & ~(abr_reg_rd_ack | abr_reg_wr_ack);

abr_reg abr_reg_inst (
  .clk(clk),
  .rst(rst_b),

  .s_cpuif_req(abr_reg_dv),
  .s_cpuif_req_is_wr(abr_reg_write),
  .s_cpuif_addr(abr_reg_addr[ABR_REG_ADDR_WIDTH-1:0]),
  .s_cpuif_wr_data(abr_reg_wdata),
  .s_cpuif_wr_biten('1),
  .s_cpuif_req_stall_wr(),
  .s_cpuif_req_stall_rd(),
  .s_cpuif_rd_ack(abr_reg_rd_ack),
  .s_cpuif_rd_err(abr_reg_read_err),
  .s_cpuif_rd_data(abr_reg_rdata),
  .s_cpuif_wr_ack(abr_reg_wr_ack),
  .s_cpuif_wr_err(abr_reg_write_err),

  .hwif_in(abr_reg_hwif_in),
  .hwif_out(abr_reg_hwif_out)
);

abr_ctrl #(
  .SRAM_LATENCY(SRAM_LATENCY),
  .MASKING_EN(MASKING_EN),
  .SHA3_MASKING_EN(SHA3_MASKING_EN)
)
abr_ctrl_inst
(
  .clk(clk),
  .rst_b(rst_b),
  .zeroize(zeroize_reg),

  .sk_bank0_mem_if(sk_bank0_mem_if.req),
  .sk_bank1_mem_if(sk_bank1_mem_if.req),
  .sig_z_mem_if(sig_z_mem_if.req),
  .pk_mem_if(pk_mem_if.req),

`ifdef RV_FPGA_SCA
  .NTT_trigger(NTT_trigger),
  .PWM_trigger(PWM_trigger),
  .PWA_trigger(PWA_trigger),
  .INTT_trigger(INTT_trigger),
`endif

`ifdef CALIPTRA
  .kv_read(kv_read),
  .kv_rd_resp(kv_rd_resp),
  .kv_write(kv_write),
  .kv_wr_resp(kv_wr_resp),
  .pcr_signing_data(pcr_signing_data),
  .ocp_lock_in_progress(ocp_lock_in_progress),
`endif

  //control interface
  .abr_reg_hwif_in_o(abr_reg_hwif_in),
  .abr_reg_hwif_out_i(abr_reg_hwif_out),

  //sampler interface
  .sampler_mode_o(sampler_mode),
  .sha3_start_o(sha3_start), //start the sha3 engine
  .sha3_masked_o(sha3_masked), //masking enable signal for the sha3 engine
  .msg_start_o(msg_start), //start a new message
  .msg_valid_o(msg_valid), //msg interface valid
  .msg_rdy_i(msg_rdy),  //msg interface rdy (~hold)
  .msg_strobe_o(msg_strobe), //msg byte enables
  .msg_data_o(msg_data),

  .sampler_start_o(sampler_start),
  .dest_base_addr_o(dest_base_addr),

  .sampler_state_dv_i(sampler_state_dv),
  .sampler_state_data_i(sampler_state_data),
  .sampler_busy_i(sampler_busy),

  //ntt interface — single command set from controller
  .ntt_enable_o(ntt_enable_ctrl),
  .ntt_mode_o(ntt_mode_ctrl),
  .ntt_mem_base_addr_o(ntt_mem_base_addr_ctrl),
  .pwo_mem_base_addr_o(pwo_mem_base_addr_ctrl),
  .ntt_masking_en_o(ntt_masking_en_ctrl),
  .ntt_shuffling_en_o(ntt_shuffling_en_ctrl),
  .ntt_busy_i(ntt_busy[0]),

  //aux interface
  .aux_src0_base_addr_o(aux_src0_base_addr),
  .aux_src1_base_addr_o(aux_src1_base_addr),
  .aux_dest_base_addr_o(aux_dest_base_addr),

  .split_en_o(split_en),
  .recombine_en_o(recombine_en),
  .recombine_mode_o(recombine_mode),

  .power2round_enable_o(power2round_enable),
  .pwr2rnd_keymem_if_i(pwr2rnd_keymem_if),
  .pwr2rnd_wr_data_i(pwr2rnd_wr_data),
  .pk_t1_wren_i(pk_t1_wren),
  .pk_t1_wr_addr_i(pk_t1_wr_addr),
  .pk_t1_wrdata_i(pk_t1_wrdata),
  .power2round_done_i(power2round_done),
  
  .decompose_enable_o(decompose_enable),
  .decompose_mode_o(decompose_mode),
  .decompose_done_i(decompose_done),

  .skdecode_enable_o(skdecode_enable),
  .skdecode_keymem_if_i(skdecode_keymem_if),
  .skdecode_rd_data_o(skdecode_rd_data),
  .skdecode_rd_data_valid_o(skdecode_rd_data_valid),
  .skdecode_done_i(skdecode_done),
  .skdecode_error_i(skdecode_error),

  .skencode_enable_o(skencode_enable),
  .skencode_keymem_if_i(skencode_keymem_if),
  .skencode_wr_data_i(skencode_wr_data),
  .skencode_done_i(skencode_done),

  .makehint_enable_o(makehint_enable),
  .makehint_invalid_i(makehint_invalid),
  .makehint_done_i(makehint_done),
  .makehint_reg_wren_i(makehint_reg_wren),
  .makehint_reg_wr_addr_i(makehint_reg_wr_addr),
  .makehint_reg_wrdata_i(makehint_reg_wrdata),

  .normcheck_enable_o(normcheck_enable),
  .normcheck_mode_o(normcheck_mode),
  .normcheck_invalid_i(normcheck_invalid),
  .normcheck_done_i(normcheck_done),

  .sigencode_enable_o(sigencode_enable),
  .sigencode_wr_req_i(sigencode_mem_wr_req),
  .sigencode_wr_data_i(sigencode_mem_wr_data),
  .sigencode_done_i(sigencode_done),

  .pkdecode_enable_o(pkdecode_enable),
  .pkdecode_rd_en_i(pkdecode_rd_en),
  .pkdecode_rd_addr_i(pkdecode_rd_addr),
  .pkdecode_rd_data_o(pkdecode_rd_data),
  .pkdecode_rd_data_valid_o(pkdecode_rd_data_valid),
  .pkdecode_done_i(pkdecode_done),

  .sigdecode_h_enable_o(sigdecode_h_enable),
  .signature_h_o(signature_h),
  .sigdecode_h_invalid_i(sigdecode_h_invalid),
  .sigdecode_h_done_i(sigdecode_h_done),

  .sigdecode_z_enable_o(sigdecode_z_enable),
  .sigdecode_z_rd_req_i(sigdecode_z_mem_rd_req),
  .sigdecode_z_rd_data_o(sigdecode_z_mem_rd_data),
  .sigdecode_z_rd_data_valid_o(sigdecode_z_mem_rd_data_valid),
  .sigdecode_z_done_i(sigdecode_z_done),

  .compress_enable_o(compress_enable),
  .compress_mode_o(compress_mode),
  .compress_num_poly_o(compress_num_poly),
  .compress_compare_mode_o(compress_compare_mode),
  .compress_done_i(compress_done),
  .compress_compare_failed_i(compress_compare_failed),
  .compress_api_rw_en_i(compress_api_rw_en),
  .compress_api_rw_addr_i(compress_api_rw_addr),
  .compress_api_wr_data_i(compress_api_wr_data),
  .compress_api_rd_data_o(compress_api_rd_data),
  .compress_api_rd_data_valid_o(compress_api_rd_data_valid),

  .decompress_enable_o(decompress_enable),
  .decompress_mode_o(decompress_mode),
  .decompress_num_poly_o(decompress_num_poly),
  .decompress_done_i(decompress_done),
  .decompress_api_rd_en_i(decompress_api_rd_en),
  .decompress_api_rd_addr_i(decompress_api_rd_addr),
  .decompress_api_rd_data_o(decompress_api_rd_data),
  .decompress_api_rd_data_valid_o(decompress_api_rd_data_valid),

  .lfsr_enable_o(lfsr_enable),
  .lfsr_seed_o(lfsr_seed),

  .busy_o(busy_o),
  .zeroize_mem_o(zeroize_mem),

  .error_intr(error_intr),
  .notif_intr(notif_intr),
  .debugUnlock_or_scan_mode_switch(debugUnlock_or_scan_mode_switch)
);

always_comb zeroize_mem_we = (zeroize_mem.rd_wr_en == RW_WRITE);
always_comb zeroize_mem_we_inst[0] = zeroize_mem_we && (zeroize_mem.addr < ABR_MEM_INST0_DEPTH);
always_comb zeroize_mem_we_inst[1] = zeroize_mem_we && (zeroize_mem.addr < ABR_MEM_INST1_DEPTH);
always_comb zeroize_mem_we_inst[2] = zeroize_mem_we && (zeroize_mem.addr < ABR_MEM_INST2_DEPTH);
always_comb zeroize_mem_we_w1_inst = zeroize_mem_we && (zeroize_mem.addr < ABR_MEM_W1_DEPTH);

//read pulse to clear flopped output after first entry has been zeroized
always_comb zeroize_mem_re = (zeroize_mem_we) && (zeroize_mem.addr == 'd1);
always_comb zeroize_mem_addr = zeroize_mem.addr;

// Number of SHA3 message shares, derived from the top-level masking parameter
// (previously a package parameter).
localparam int Sha3Share = (SHA3_MASKING_EN) ? 2 : 1;
logic [MsgWidth-1:0] msg_data_i[Sha3Share];
generate
  if (SHA3_MASKING_EN) begin : decomp_mask_tie_off
    // Message-share splitter: for masked operations the incoming single-share
    // plaintext is split into two Boolean shares using an LFSR mask
    // Public (unmasked) operations pass through with share1 tied to zero.
    logic [MsgWidth-1:0] msg_plain;
    logic [MsgWidth-1:0] msg_masked;
    assign msg_plain     = decomp_msg_valid ? decomp_msg_data : msg_data;

    abr_prim_xor2 #(
      .Width(MsgWidth)
    ) msg_share_xor (
      .in0_i(msg_plain),
      .in1_i(keccak_msg_mask),
      .out_o(msg_masked)
    );

    assign msg_data_i[0] = sha3_masked ? msg_masked : msg_plain;
    assign msg_data_i[1] = sha3_masked ? keccak_msg_mask : '0;
  end else begin : decomp_no_mask_gen
    assign msg_data_i[0] = decomp_msg_valid ? decomp_msg_data : msg_data;
  end
endgenerate

abr_sampler_top #(
  .SRAM_LATENCY(SRAM_LATENCY),
  .ABR_NUM_NTT(ABR_NUM_NTT),
  .Sha3EnMasking(SHA3_MASKING_EN)
)
sampler_top_inst
(
  .clk(clk),
  .rst_b(rst_b),
  .zeroize(zeroize_reg),

  .sampler_mode_i(sampler_mode),
  .sha3_start_i(sha3_start), //start the sha3 engine
  .sha3_masked_i(sha3_masked), //masking enable signal for the sha3 engine
  .msg_start_i(msg_start), //start a new message
  .msg_valid_i(msg_valid | decomp_msg_valid),
  .msg_rdy_o(msg_rdy), 
  .msg_strobe_i(decomp_msg_valid ? '1 : msg_strobe),
  .msg_data_i(msg_data_i), 

  .sib_mem_rd_req_i(sib_mem_rd_req),
  .sib_mem_rd_data_o(sib_mem_rd_data),

  .sampler_start_i(sampler_start),
  .dest_base_addr_i(dest_base_addr),

  .sampler_busy_o(sampler_busy),

  .sampler_ntt_dv_o(sampler_ntt_dv[0]),
  .sampler_ntt_data_o(sampler_ntt_data),

  .sampler_mem_dv_o(sampler_mem_dv),
  .sampler_mem_data_o(sampler_mem_data),
  .sampler_mem_addr_o(sampler_mem_addr),

  .split_en_i(split_en),
  .rand_i(splitter_rand[0]),

  // Dedicated masked-Keccak randomness (DOM multipliers). The sequencer always
  // seeds the LFSR bank before issuing a masked SHA3 op, and the full-width bank
  // refreshes every cycle, so randomness is always valid.
  .keccak_rand_valid_i(1'b1),
  .keccak_rand_early_i(1'b1),
  .keccak_rand_data_i(keccak_dom_rand),
  .keccak_rand_aux_i(keccak_aux_rand),

  .sampler_state_dv_o(sampler_state_dv),
  .sampler_state_data_o(sampler_state_data)
);

generate if (MASKING_EN) begin : sampler_ntt_dv_mirror
  assign sampler_ntt_dv[1] = sampler_ntt_dv[0];
end endgenerate

// NTT control: controller outputs single command; NTT[0] always gets it,
// NTT[1] mirrors NTT[0] when masking is enabled.
always_comb begin
  ntt_enable[0]        = ntt_enable_ctrl;
  ntt_mode[0]          = ntt_mode_ctrl;
  ntt_mem_base_addr[0] = ntt_mem_base_addr_ctrl;
  pwo_mem_base_addr[0] = pwo_mem_base_addr_ctrl;
  ntt_shuffling_en[0]  = ntt_shuffling_en_ctrl;
end

// NTT[1] mirror — only present when MASKING_EN (else share[1] is out of bounds).
generate if (MASKING_EN) begin : ntt1_ctrl_mirror
  always_comb begin
    ntt_enable[1]        = ntt_masking_en_ctrl ? ntt_enable_ctrl : '0;
    ntt_mode[1]          = ntt_mode_ctrl;
    ntt_mem_base_addr[1] = ntt_mem_base_addr_ctrl;
    pwo_mem_base_addr[1] = pwo_mem_base_addr_ctrl;
    ntt_shuffling_en[1]  = ntt_shuffling_en_ctrl;
  end
end endgenerate

always_ff @(posedge clk or negedge rst_b) begin
  if (!rst_b) begin
    sampler_ntt_dv_f <= 0;
  end
  else if (zeroize_reg) begin
    sampler_ntt_dv_f <= 0;
  end
  else begin
    sampler_ntt_dv_f <= sampler_ntt_dv;
  end
end

generate
  for (genvar g_inst = 0; g_inst < ABR_NUM_NTT; g_inst++) begin : ntt_gen
    //NTT
    //gasket here, create common interfaces?
    always_comb begin
      mode[g_inst] = '0;
      accumulate[g_inst] = '0;
      sampler_valid[g_inst] = 0;
      sampler_ntt_mode[g_inst] = 0;
      mlkem_mode[g_inst] = 0;

      unique case (ntt_mode[g_inst]) inside
        ABR_NTT_NONE: begin
        end
        MLDSA_NTT: begin
          mode[g_inst] = ct;
        end
        MLDSA_INTT: begin
          mode[g_inst] = gs;
        end
        MLDSA_PWM_SMPL: begin
          mode[g_inst] = pwm;
          sampler_valid[g_inst] = sampler_ntt_dv[g_inst];
          sampler_ntt_mode[g_inst] = 1;
        end
        MLDSA_PWM_ACCUM_SMPL: begin
          mode[g_inst] = pwm;
          accumulate[g_inst] = 1;
          sampler_valid[g_inst] = sampler_ntt_dv[g_inst];
          sampler_ntt_mode[g_inst] = 1;
        end
        MLDSA_PWM: begin
          mode[g_inst] = pwm;
          sampler_valid[g_inst] = 1;
        end
        MLDSA_PWM_ACCUM: begin
          mode[g_inst] = pwm;
          accumulate[g_inst] = 1;
          sampler_valid[g_inst] = 1;
        end
        MLDSA_PWA: begin
          mode[g_inst] = pwa;
          sampler_valid[g_inst] = 1;
        end
        MLDSA_PWS: begin
          mode[g_inst] = pws;
          sampler_valid[g_inst] = 1;
        end
        MLKEM_NTT: begin
          mode[g_inst] = ct;
          mlkem_mode[g_inst] = 1;
        end
        MLKEM_INTT: begin
          mode[g_inst] = gs;
          mlkem_mode[g_inst] = 1;
        end
        MLKEM_PWM_SMPL: begin
          mode[g_inst] = pairwm;
          sampler_valid[g_inst] = sampler_ntt_dv[g_inst];
          sampler_ntt_mode[g_inst] = 1;
          mlkem_mode[g_inst] = 1;
        end
        MLKEM_PWM_ACCUM_SMPL: begin
          mode[g_inst] = pairwm;
          accumulate[g_inst] = 1;
          sampler_valid[g_inst] = sampler_ntt_dv[g_inst];
          sampler_ntt_mode[g_inst] = 1;
          mlkem_mode[g_inst] = 1;
        end
        MLKEM_PWM: begin
          mode[g_inst] = pairwm;
          sampler_valid[g_inst] = 1;
          mlkem_mode[g_inst] = 1;
        end
        MLKEM_PWM_ACCUM: begin
          mode[g_inst] = pairwm;
          accumulate[g_inst] = 1;
          sampler_valid[g_inst] = 1;
          mlkem_mode[g_inst] = 1;
        end
        MLKEM_PWA: begin
          mode[g_inst] = pwa;
          sampler_valid[g_inst] = 1;
          mlkem_mode[g_inst] = 1;
        end
        MLKEM_PWS: begin
          mode[g_inst] = pws;
          sampler_valid[g_inst] = 1;
          mlkem_mode[g_inst] = 1;
        end
        default: begin
        end
      endcase
      
      
    end

  ntt_top #(
    .SRAM_LATENCY(SRAM_LATENCY)
  )
  ntt_top_inst (
    .clk(clk),
    .reset_n(rst_b),
    .zeroize(zeroize_reg),

    .mode(mode[g_inst]),
    .ntt_enable(ntt_enable[g_inst]),
    .mlkem(mlkem_mode[g_inst]),
    .ntt_mem_base_addr(ntt_mem_base_addr[g_inst]),
    .pwo_mem_base_addr(pwo_mem_base_addr[g_inst]),
    .accumulate(accumulate[g_inst]),
    .sampler_valid(sampler_valid[g_inst]),
    .shuffle_en(ntt_shuffling_en[g_inst]),
    .random(shuffling_rand[g_inst]),
    //NTT mem IF — zero-extend 96→384 for inputs, truncate 384→96 for outputs
    .mem_wr_req(ntt_mem_wr_req[g_inst]),
    .mem_rd_req(ntt_mem_rd_req[g_inst]),
    .mem_wr_data(ntt_mem_wr_data[g_inst]),
    .mem_rd_data_valid(ntt_mem_rd_data_valid[g_inst]),
    .mem_rd_data(ntt_mem_rd_data[g_inst]),
    //PWM mem IF
    .pwm_a_rd_req(pwm_a_rd_req[g_inst]),
    .pwm_b_rd_req(pwm_b_rd_req[g_inst]),
    .pwm_a_rd_data_valid(pwm_a_rd_data_valid[g_inst]),
    .pwm_a_rd_data(pwm_a_rd_data[g_inst]),
    .pwm_b_rd_data_valid(pwm_b_rd_data_valid[g_inst]),
    .pwm_b_rd_data(sampler_ntt_mode[g_inst] ? ABR_MEM_DATA_WIDTH'(sampler_ntt_data) : pwm_b_rd_data[g_inst]),
    .ntt_busy(ntt_busy[g_inst]),
    .ntt_done(ntt_done[g_inst])
  );
  end
endgenerate

power2round_top
power2round_inst (
  .clk(clk),
  .reset_n(rst_b),
  .zeroize(zeroize_reg),

  .enable(power2round_enable),
  .done(power2round_done),

  .src_base_addr(aux_src0_base_addr),
  .mem_a_rd_req(pwr2rnd_mem_rd_req[0]),
  .mem_rd_data_a(pwr2rnd_mem_rd_data[0]),
  .mem_b_rd_req(pwr2rnd_mem_rd_req[1]),
  .mem_rd_data_b(pwr2rnd_mem_rd_data[1]),
  .mem_rd_data_valid(pwr2rnd_mem_rd_data_valid),

  .pk_t1_wren(pk_t1_wren),
  .pk_t1_wr_addr(pk_t1_wr_addr),
  .pk_t1_wrdata(pk_t1_wrdata),

  .skmem_dest_base_addr(aux_dest_base_addr),
  .skmem_a_wr_req(pwr2rnd_keymem_if[0]),
  .skmem_wr_data_a(pwr2rnd_wr_data[0]),
  .skmem_b_wr_req(pwr2rnd_keymem_if[1]),
  .skmem_wr_data_b(pwr2rnd_wr_data[1])
);

decompose
decompose_inst (
  .clk(clk),
  .reset_n(rst_b),
  .zeroize(zeroize_reg),

  .decompose_enable(decompose_enable),
  .dcmp_mode(decompose_mode),
  .src_base_addr(aux_src0_base_addr),
  .dest_base_addr(aux_dest_base_addr),
  .hint_src_base_addr(aux_src1_base_addr),

  //Output to memory - r0
  .mem_rd_req(decomp_mem_rd_req[0]),
  .mem_wr_req(decomp_mem_wr_req),
  .mem_rd_data_valid(decomp_mem_rd_data_valid),
  .mem_rd_data(decomp_mem_rd_data[0]),
  .mem_wr_data(decomp_mem_wr_data),

  //Output to memory - h (sigDecode)
  .mem_hint_rd_req(decomp_mem_rd_req[1]),
  .mem_hint_rd_data(decomp_mem_rd_data[1]),

  //Output to z mem - z != 0
  .z_mem_wr_req(w1_mem_wr_req),
  .z_neq_z(w1_mem_wr_data),

  //Output of w1_encode - r1
  .w1_o(decomp_msg_data),
  .buffer_en(decomp_msg_valid),

  .decompose_done(decompose_done)
);

skencode
#(
  .MEM_ADDR_WIDTH(ABR_MEM_ADDR_WIDTH)
)
skencode_inst
(
  .clk(clk),
  .reset_n(rst_b),
  .zeroize(zeroize_reg),

  .src_base_addr(aux_src0_base_addr),
  .dest_base_addr(aux_dest_base_addr),

  .skencode_enable(skencode_enable),
  .skencode_done(skencode_done),

  .keymem_a_wr_req(skencode_keymem_if),
  .keymem_a_wr_data(skencode_wr_data),
  .mem_a_rd_req(skencode_mem_rd_req[0]),
  .mem_a_rd_data(skencode_mem_rd_data[0]),
  .mem_b_rd_req(skencode_mem_rd_req[1]),
  .mem_b_rd_data(skencode_mem_rd_data[1]),
  .mem_rd_data_valid(skencode_mem_rd_data_valid)
);

skdecode_top
#(
  .ABR_NUM_NTT(ABR_NUM_NTT)
)
skdecode_inst
(
  .clk(clk),
  .reset_n(rst_b),
  .zeroize(zeroize_reg),

  .skdecode_enable(skdecode_enable),
  .skdecode_done(skdecode_done),

  .keymem_src_base_addr(aux_src0_base_addr), 
  .dest_base_addr(aux_dest_base_addr),

  .keymem_rd_req(skdecode_keymem_if),
  .keymem_rd_data(skdecode_rd_data),
  .keymem_rd_data_valid(skdecode_rd_data_valid),

  .mem_a_wr_req(skdecode_mem_wr_req[0]),
  .mem_a_wr_data(skdecode_mem_wr_data_a),
  .mem_b_wr_req(skdecode_mem_wr_req[1]),
  .mem_b_wr_data(skdecode_mem_wr_data_b),

  .split_en_i(split_en),
  .rand_i(splitter_rand[0]),
  .rand_dual_i(splitter_rand[1]),

  .s1_done(),
  .s2_done(),
  .t0_done(),
  .skdecode_error(skdecode_error)
);

makehint
makehint_inst
(
  .clk(clk),
  .reset_n(rst_b),
  .zeroize(zeroize_reg),

  .makehint_enable(makehint_enable),
  .makehint_done(makehint_done),

  .mem_base_addr(aux_src0_base_addr),

  .mem_rd_req(makehint_mem_rd_req),
  .mem_rd_data_valid(makehint_mem_rd_data_valid),
  .r(makehint_mem_rd_data),

  .reg_wren(makehint_reg_wren),
  .reg_wr_addr(makehint_reg_wr_addr),
  .reg_wrdata(makehint_reg_wrdata),

  .z_rd_req(w1_mem_rd_req),
  .z(w1_mem_rd_data),

  .invalid_h(makehint_invalid)
);

norm_check_top
norm_check_inst
(
  .clk(clk),
  .reset_n(rst_b),
  .zeroize(zeroize_reg),

  .mode(normcheck_mode),
  .norm_check_enable(normcheck_enable),

  .randomness(shuffling_rand[0]),

  .norm_check_ready(),
  .norm_check_done(normcheck_done),
  
  .mem_base_addr(aux_src0_base_addr),
  .mem_rd_req(normcheck_mem_rd_req),
  .mem_rd_data_valid(normcheck_mem_rd_data_valid),
  .mem_rd_data(normcheck_mem_rd_data),

  .invalid(normcheck_invalid)

);

sigencode_z_top
sigencode_z_inst
(
  .clk(clk),
  .reset_n(rst_b),
  .zeroize(zeroize_reg),
  
  .sigencode_z_enable(sigencode_enable),
  .sigencode_z_done(sigencode_done),

  .src_base_addr(aux_src0_base_addr),
  .sigmem_dest_base_addr(aux_dest_base_addr),

  .mem_a_rd_req(sigencode_mem_rd_req[0]),
  .mem_a_rd_data(sigencode_mem_rd_data[0]),
  .mem_b_rd_req(sigencode_mem_rd_req[1]),
  .mem_b_rd_data(sigencode_mem_rd_data[1]),
  .mem_rd_data_valid(sigencode_mem_rd_data_valid),
  
  .sigmem_a_wr_req(sigencode_mem_wr_req),
  .sigmem_a_wr_data(sigencode_mem_wr_data[0]),
  .sigmem_b_wr_req(),
  .sigmem_b_wr_data(sigencode_mem_wr_data[1])
);

pkdecode 
#(
  .API_ADDR_WIDTH(8)
)
pkdecode_inst (
  .clk(clk),
  .reset_n(rst_b),
  .zeroize(zeroize_reg),

  .pkdecode_enable(pkdecode_enable),
  .pkdecode_done(pkdecode_done),

  .dest_base_addr(aux_dest_base_addr),

  .API_rd_en(pkdecode_rd_en),
  .API_rd_address(pkdecode_rd_addr),
  .API_rd_data(pkdecode_rd_data),
  .API_rd_data_valid(pkdecode_rd_data_valid),

  .mem_a_wr_req(pkdecode_mem_wr_req[0]),
  .mem_a_wr_data(pkdecode_mem_wr_data[0]),
  .mem_b_wr_req(pkdecode_mem_wr_req[1]),
  .mem_b_wr_data(pkdecode_mem_wr_data[1])
);

sigdecode_z_top
sigdecode_z_inst (
  .clk(clk),
  .reset_n(rst_b),
  .zeroize(zeroize_reg),

  .sigdecode_z_enable(sigdecode_z_enable),
  .sigdecode_z_done(sigdecode_z_done),

  .dest_base_addr(aux_dest_base_addr),

  .mem_a_wr_req(sigdecode_z_mem_wr_req[0]),
  .mem_a_wr_data(sigdecode_z_mem_wr_data[0]),
  .mem_b_wr_req(sigdecode_z_mem_wr_req[1]),
  .mem_b_wr_data(sigdecode_z_mem_wr_data[1]),

  .sigmem_rd_req(sigdecode_z_mem_rd_req),
  .sigmem_rd_data(sigdecode_z_mem_rd_data),
  .sigmem_rd_data_valid(sigdecode_z_mem_rd_data_valid)
);

sigdecode_h
sigdecode_h_inst (
  .clk(clk),
  .reset_n(rst_b),
  .zeroize(zeroize_reg),

  .sigdecode_h_enable(sigdecode_h_enable),
  .sigdecode_h_done(sigdecode_h_done),

  .dest_base_addr(aux_dest_base_addr),

  .encoded_h_i(signature_h),
  .mem_wr_req(sigdecode_h_mem_wr_req),
  .mem_wr_data(sigdecode_h_mem_wr_data),

  .sigdecode_h_error(sigdecode_h_invalid)
);

compress_top #(
  .SRAM_LATENCY(SRAM_LATENCY)
)
compress_top_inst
(
  .clk(clk),
  .reset_n(rst_b),
  .zeroize(zeroize_reg),

  .mode(compress_mode),
  .compare_mode(compress_compare_mode),
  .num_poly(compress_num_poly),
  .src_base_addr(aux_src0_base_addr),
  .dest_base_addr(aux_dest_base_addr),

  .compress_enable(compress_enable),
  .compress_done(compress_done),
  .compare_failed(compress_compare_failed),

  .mem_rd_req(compress_mem_rd_req),
  .mem_rd_data_valid(compress_mem_rd_data_valid),
  .mem_rd_data(compress_mem_rd_data),

  .api_rw_en(compress_api_rw_en),
  .api_rw_addr(compress_api_rw_addr),
  .api_wr_data(compress_api_wr_data),
  .api_rd_data(compress_api_rd_data),
  .api_rd_data_valid(compress_api_rd_data_valid)
);

decompress_top
#(
  .ABR_NUM_NTT(ABR_NUM_NTT)
)
decompress_top_inst
(
  .clk(clk),
  .reset_n(rst_b),
  .zeroize(zeroize_reg),

  .mode(decompress_mode),
  .num_poly(decompress_num_poly),
  .src_base_addr(aux_src0_base_addr),
  .dest_base_addr(aux_dest_base_addr),

  .decompress_enable(decompress_enable),
  .decompress_done(decompress_done),

  .mem_wr_req(decompress_mem_wr_req),
  .mem_wr_data(decompress_mem_wr_data),

  .split_en_i(split_en),
  .rand_i(splitter_rand[0]),

  .api_rd_en(decompress_api_rd_en),
  .api_rd_addr(decompress_api_rd_addr),
  .api_rd_data(decompress_api_rd_data),
  .api_rd_data_valid(decompress_api_rd_data_valid)
);

for (genvar gi = 0; gi < 2; gi++) begin : gen_lfsr
  abr_prim_lfsr
  #(
    .LfsrType("FIB_XNOR"),
    .LfsrDw(NTT_LFSR_W),
    .StateOutDw(NTT_LFSR_W)
  ) abr_prim_lfsr_inst
  (
    .clk_i(clk),
    .rst_b(rst_b),
    .seed_en_i(lfsr_enable),
    .seed_i(lfsr_seed.ntt[gi]),
    .lfsr_en_i(1'b1),
    .entropy_i('0),
    .state_o(rand_bits[gi])
  );
end

// Dedicated masked-Keccak LFSRs. Only instantiated when the masked Keccak core
// exists (SHA3_MASKING_EN). Two independent, independently-seeded generators:
//   * DOM bank  : free-running FIB_XNOR LFSRs (5*161=805), cross-coupled through
//                 entropy_i for inter-instance diffusion. Supplies the full 800b
//                 DOM randomness plus 1 aux bit every cycle => no permutation
//                 stalls. Slices: [StateW/2-1:0] -> rand_data_i, [StateW/2] -> aux.
//   * Msg LFSR  : single 64b FIB_XNOR LFSR advanced ONLY on an accepted masked
//                 beat, so each message word is split with a distinct mask
generate
  if (SHA3_MASKING_EN) begin : gen_keccak_lfsr
    for (genvar gi = 0; gi < KECCAK_DOM_NUM_LFSR; gi++) begin : gen_keccak_dom_lfsr
      abr_prim_lfsr
      #(
        .LfsrType("FIB_XNOR"),
        .LfsrDw(KECCAK_DOM_LFSR_DW),
        .StateOutDw(KECCAK_DOM_LFSR_DW)
      ) abr_keccak_dom_lfsr_inst
      (
        .clk_i(clk),
        .rst_b(rst_b),
        .seed_en_i(lfsr_enable),
        .seed_i(lfsr_seed.dom[gi]),
        .lfsr_en_i(1'b1),
        .entropy_i(keccak_dom_lfsr_state[(gi+1) % KECCAK_DOM_NUM_LFSR][7:0]),
        .state_o(keccak_dom_lfsr_state[gi])
      );
    end
    assign keccak_dom_rand_bits = keccak_dom_lfsr_state;
    assign keccak_dom_rand      = keccak_dom_rand_bits[abr_sha3_pkg::StateW/2-1:0];
    assign keccak_aux_rand      = keccak_dom_rand_bits[abr_sha3_pkg::StateW/2];
    abr_prim_lfsr
    #(
      .LfsrType("FIB_XNOR"),
      .LfsrDw(KECCAK_MSG_LFSR_W),
      .StateOutDw(KECCAK_MSG_LFSR_W)
    ) abr_keccak_msg_lfsr_inst
    (
      .clk_i(clk),
      .rst_b(rst_b),
      .seed_en_i(lfsr_enable),
      .seed_i(lfsr_seed.msg),
      .lfsr_en_i(1'b1),
      .entropy_i('0),
      .state_o(keccak_msg_rand_bits)
    );
    assign keccak_msg_mask = keccak_msg_rand_bits[MsgWidth-1:0];
  end else begin : gen_no_keccak_lfsr
    assign keccak_dom_lfsr_state = '0;
    assign keccak_dom_rand_bits  = '0;
    assign keccak_msg_rand_bits  = '0;
    assign keccak_dom_rand       = '0;
    assign keccak_msg_mask       = '0;
    assign keccak_aux_rand       = 1'b0;
  end
endgenerate

always_comb begin
  abr_memory_export.w1_mem_we_i = (w1_mem_wr_req.rd_wr_en == RW_WRITE) | zeroize_mem_we_w1_inst;
  abr_memory_export.w1_mem_waddr_i = (w1_mem_wr_req.addr[ABR_MEM_W1_ADDR_W-1:0]) | 
                                       ({ABR_MEM_W1_ADDR_W{zeroize_mem_we_w1_inst}} & zeroize_mem_addr[ABR_MEM_W1_ADDR_W-1:0]);
  abr_memory_export.w1_mem_wdata_i = zeroize_mem_we_w1_inst ? '0 : w1_mem_wr_data;
  abr_memory_export.w1_mem_re_i = w1_mem_rd_req.rd_wr_en == RW_READ;
  abr_memory_export.w1_mem_raddr_i = w1_mem_rd_req.addr[ABR_MEM_W1_ADDR_W-1:0];
  w1_mem_rd_data = abr_memory_export.w1_mem_rdata_o;
end

// During MASKED_NTT_NOSHUF(c), NTT[1] mirrors NTT[0] and needs the same SIB source data.
always_comb begin
  sib_mem_re[0] = (ntt_mem_rd_req[0].rd_wr_en == RW_READ) & (ntt_mem_rd_req[0].addr[ABR_MEM_ADDR_WIDTH-1:ABR_MEM_ADDR_WIDTH-3] == 3'b100);
  sib_mem_rd_req.addr = {ABR_MEM_ADDR_WIDTH{sib_mem_re[0]}} & ntt_mem_rd_req[0].addr;
  sib_mem_rd_req.rd_wr_en = sib_mem_re[0] ? RW_READ : RW_IDLE;
  // Detect per-NTT SIB-range reads for valid generation
  for (int unsigned ntt = 0; ntt < ABR_NUM_NTT; ntt++)
    ntt_sib_rd_detect[ntt] = (ntt_mem_rd_req[ntt].rd_wr_en == RW_READ) &
                              (ntt_mem_rd_req[ntt].addr[ABR_MEM_ADDR_WIDTH-1:ABR_MEM_ADDR_WIDTH-3] == 3'b100);
end

// Pipeline NTT[1] SIB read detect (1-cycle latency matching SIB memory)
always_ff @(posedge clk or negedge rst_b) begin
  if (!rst_b)
    ntt_sib_rd_detect_d1 <= '0;
  else if (zeroize_reg)
    ntt_sib_rd_detect_d1 <= '0;
  else
    ntt_sib_rd_detect_d1 <= ntt_sib_rd_detect;
end

//NTT Muxes — per-NTT direct assign (no cross-NTT OR)
always_comb begin
  ntt_mem_we_mux = '0;
  ntt_mem_re_mux = '0;
  pwo_a_mem_re_mux = '0;
  pwo_b_mem_re_mux = '0;
  ntt_mem_wr_req_mux  = '0;
  ntt_mem_wr_data_mux = '0;
  ntt_mem_rd_req_mux  = '0;
  pwm_a_rd_req_mux    = '0;
  pwm_b_rd_req_mux    = '0;
  for (int unsigned ntt= 0; ntt < ABR_NUM_NTT; ntt++) begin
    for (int unsigned i = 0; i < 3; i++) begin
      ntt_mem_we[ntt][i] = (ntt_mem_wr_req[ntt].rd_wr_en == RW_WRITE) & (ntt_mem_wr_req[ntt].addr[ABR_MEM_ADDR_WIDTH-1:ABR_MEM_ADDR_WIDTH-3] == i);
      ntt_mem_re[0][ntt][i] = (ntt_mem_rd_req[ntt].rd_wr_en == RW_READ) & (ntt_mem_rd_req[ntt].addr[ABR_MEM_ADDR_WIDTH-1:ABR_MEM_ADDR_WIDTH-3] == i);
      pwo_a_mem_re[0][ntt][i] = (pwm_a_rd_req[ntt].rd_wr_en == RW_READ) & (pwm_a_rd_req[ntt].addr[ABR_MEM_ADDR_WIDTH-1:ABR_MEM_ADDR_WIDTH-3] == i);
      pwo_b_mem_re[0][ntt][i] = (ntt_shuffling_en[ntt] ? ~sampler_ntt_dv_f[ntt] : ~sampler_ntt_dv[ntt]) & (pwm_b_rd_req[ntt].rd_wr_en == RW_READ) & (pwm_b_rd_req[ntt].addr[ABR_MEM_ADDR_WIDTH-1:ABR_MEM_ADDR_WIDTH-3] == i);

      ntt_mem_we_mux[ntt][i] = ntt_mem_we[ntt][i];
      ntt_mem_re_mux[ntt][i] = ntt_mem_re[0][ntt][i];
      pwo_a_mem_re_mux[ntt][i] = pwo_a_mem_re[0][ntt][i];
      pwo_b_mem_re_mux[ntt][i] = pwo_b_mem_re[0][ntt][i];

      ntt_mem_wr_req_mux[ntt][i]  = ({ABR_MEM_ADDR_WIDTH{ntt_mem_we[ntt][i]}}   & ntt_mem_wr_req[ntt].addr);
      ntt_mem_rd_req_mux[ntt][i]  = ({ABR_MEM_ADDR_WIDTH{ntt_mem_re[0][ntt][i]}}   & ntt_mem_rd_req[ntt].addr);
      pwm_a_rd_req_mux[ntt][i]    = ({ABR_MEM_ADDR_WIDTH{pwo_a_mem_re[0][ntt][i]}} & pwm_a_rd_req[ntt].addr);
      pwm_b_rd_req_mux[ntt][i]    = ({ABR_MEM_ADDR_WIDTH{pwo_b_mem_re[0][ntt][i]}} & pwm_b_rd_req[ntt].addr);

      ntt_mem_wr_data_mux[ntt][i] = ({ABR_MEM_DATA_WIDTH{ntt_mem_we[ntt][i]}}   & ntt_mem_wr_data[ntt]);
    end
  end
end

//Write Muxes — per-NTT: all non-NTT sources fan-out to every NTT index
always_comb begin
  for (int unsigned i = 0; i < 3; i++) begin
    if (i == 0) begin
      for (int unsigned bank = 0; bank < 2; bank++) begin
        sampler_mem_we0_bank[bank] = sampler_mem_dv & (sampler_mem_addr[ABR_MEM_ADDR_WIDTH-1:ABR_MEM_ADDR_WIDTH-3] == i) & (sampler_mem_addr[0] == bank);
        decomp_mem_we0_bank[bank] = (decomp_mem_wr_req.rd_wr_en == RW_WRITE) & (decomp_mem_wr_req.addr[ABR_MEM_ADDR_WIDTH-1:ABR_MEM_ADDR_WIDTH-3] == i) & (decomp_mem_wr_req.addr[0] == bank);
        sigdecode_h_mem_we0_bank[bank] = (sigdecode_h_mem_wr_req.rd_wr_en == RW_WRITE) & (sigdecode_h_mem_wr_req.addr[ABR_MEM_ADDR_WIDTH-1:ABR_MEM_ADDR_WIDTH-3] == i) & (sigdecode_h_mem_wr_req.addr[0] == bank);
        skdecode_mem_we0_bank[bank] = (skdecode_mem_wr_req[bank].rd_wr_en == RW_WRITE);
        pkdecode_mem_we0_bank[bank] = (pkdecode_mem_wr_req[bank].rd_wr_en == RW_WRITE);
        sigdecode_z_mem_we0_bank[bank] = (sigdecode_z_mem_wr_req[bank].rd_wr_en == RW_WRITE);
        decompress_mem_we0_bank[bank] = (decompress_mem_wr_req.rd_wr_en == RW_WRITE) & (decompress_mem_wr_req.addr[ABR_MEM_ADDR_WIDTH-1:ABR_MEM_ADDR_WIDTH-3] == i) & (decompress_mem_wr_req.addr[0] == bank);

        for (int unsigned ntt = 0; ntt < ABR_NUM_NTT; ntt++) begin
          ntt_mem_we0_bank[ntt][bank] = ntt_mem_we_mux[ntt][i] & (ntt_mem_wr_req_mux[ntt][i][0] == bank);

          abr_mem_we0_bank[ntt][bank] = sampler_mem_we0_bank[bank] | ntt_mem_we0_bank[ntt][bank] | decompress_mem_we0_bank[bank] |
                                       decomp_mem_we0_bank[bank] | skdecode_mem_we0_bank[bank] | pkdecode_mem_we0_bank[bank] |
                                       sigdecode_h_mem_we0_bank[bank] | sigdecode_z_mem_we0_bank[bank] | zeroize_mem_we_inst[0];

          abr_mem_waddr0_bank[ntt][bank] = ({ABR_MEM_ADDR_WIDTH-4{sampler_mem_we0_bank[bank]}}     & sampler_mem_addr[ABR_MEM_ADDR_WIDTH-4:1]) |
                                          ({ABR_MEM_ADDR_WIDTH-4{ntt_mem_we0_bank[ntt][bank]}}    & ntt_mem_wr_req_mux[ntt][0][ABR_MEM_ADDR_WIDTH-4:1]) |
                                          ({ABR_MEM_ADDR_WIDTH-4{decomp_mem_we0_bank[bank]}}      & decomp_mem_wr_req.addr[ABR_MEM_ADDR_WIDTH-4:1]) |
                                          ({ABR_MEM_ADDR_WIDTH-4{decompress_mem_we0_bank[bank]}}  & decompress_mem_wr_req.addr[ABR_MEM_ADDR_WIDTH-4:1]) |
                                          ({ABR_MEM_ADDR_WIDTH-4{sigdecode_h_mem_we0_bank[bank]}} & sigdecode_h_mem_wr_req.addr[ABR_MEM_ADDR_WIDTH-4:1]) |
                                          ({ABR_MEM_ADDR_WIDTH-4{skdecode_mem_we0_bank[bank]}}    & skdecode_mem_wr_req[bank].addr[ABR_MEM_ADDR_WIDTH-4:1]) |
                                          ({ABR_MEM_ADDR_WIDTH-4{pkdecode_mem_we0_bank[bank]}}    & pkdecode_mem_wr_req[bank].addr[ABR_MEM_ADDR_WIDTH-4:1]) |
                                          ({ABR_MEM_ADDR_WIDTH-4{sigdecode_z_mem_we0_bank[bank]}} & sigdecode_z_mem_wr_req[bank].addr[ABR_MEM_ADDR_WIDTH-4:1]) |
                                          ({ABR_MEM_ADDR_WIDTH-4{zeroize_mem_we_inst[0]}} & (zeroize_mem_addr[ABR_MEM_ADDR_WIDTH-5:0]));

          abr_mem_wdata0_bank[ntt][bank] = ({ABR_MEM_DATA_WIDTH{sampler_mem_we0_bank[bank]}}     & sampler_mem_data[ntt]) |
                                          ({ABR_MEM_DATA_WIDTH{ntt_mem_we0_bank[ntt][bank]}}    & ntt_mem_wr_data_mux[ntt][0]) |
                                          ({ABR_MEM_DATA_WIDTH{decomp_mem_we0_bank[bank]}}      & decomp_mem_wr_data) |
                                          ({ABR_MEM_DATA_WIDTH{decompress_mem_we0_bank[bank]}}  & decompress_mem_wr_data[ntt]) |
                                          ({ABR_MEM_DATA_WIDTH{sigdecode_h_mem_we0_bank[bank]}} & sigdecode_h_mem_wr_data) |
                                          ({ABR_MEM_DATA_WIDTH{skdecode_mem_we0_bank[bank]}}    & (bank == 0 ? skdecode_mem_wr_data_a[ntt] : skdecode_mem_wr_data_b[ntt])) |
                                          ({ABR_MEM_DATA_WIDTH{pkdecode_mem_we0_bank[bank]}}    & pkdecode_mem_wr_data[bank]) |
                                          ({ABR_MEM_DATA_WIDTH{sigdecode_z_mem_we0_bank[bank]}} & sigdecode_z_mem_wr_data[bank]);
        end
      end
    end else begin
      sampler_mem_we[i] = sampler_mem_dv & (sampler_mem_addr[ABR_MEM_ADDR_WIDTH-1:ABR_MEM_ADDR_WIDTH-3] == i);
      decomp_mem_we[i] = (decomp_mem_wr_req.rd_wr_en == RW_WRITE) & (decomp_mem_wr_req.addr[ABR_MEM_ADDR_WIDTH-1:ABR_MEM_ADDR_WIDTH-3] == i);
      decompress_mem_we[i] = (decompress_mem_wr_req.rd_wr_en == RW_WRITE) & (decompress_mem_wr_req.addr[ABR_MEM_ADDR_WIDTH-1:ABR_MEM_ADDR_WIDTH-3] == i);
      sigdecode_h_mem_we[i] = (sigdecode_h_mem_wr_req.rd_wr_en == RW_WRITE) & (sigdecode_h_mem_wr_req.addr[ABR_MEM_ADDR_WIDTH-1:ABR_MEM_ADDR_WIDTH-3] == i);

      for (int unsigned ntt = 0; ntt < ABR_NUM_NTT; ntt++) begin
        abr_mem_we[ntt][i] = sampler_mem_we[i] | ntt_mem_we_mux[ntt][i] | decomp_mem_we[i] | decompress_mem_we[i] | sigdecode_h_mem_we[i] | zeroize_mem_we_inst[i];
        abr_mem_waddr[ntt][i] = ({ABR_MEM_ADDR_WIDTH-3{sampler_mem_we[i]}}           & sampler_mem_addr[ABR_MEM_ADDR_WIDTH-4:0]) |
                               ({ABR_MEM_ADDR_WIDTH-3{ntt_mem_we_mux[ntt][i]}}      & ntt_mem_wr_req_mux[ntt][i][ABR_MEM_ADDR_WIDTH-4:0]) |
                               ({ABR_MEM_ADDR_WIDTH-3{decomp_mem_we[i]}}             & decomp_mem_wr_req.addr[ABR_MEM_ADDR_WIDTH-4:0]) |
                               ({ABR_MEM_ADDR_WIDTH-3{decompress_mem_we[i]}}         & decompress_mem_wr_req.addr[ABR_MEM_ADDR_WIDTH-4:0]) |
                               ({ABR_MEM_ADDR_WIDTH-3{sigdecode_h_mem_we[i]}}        & sigdecode_h_mem_wr_req.addr[ABR_MEM_ADDR_WIDTH-4:0]) |
                               ({ABR_MEM_ADDR_WIDTH-3{zeroize_mem_we_inst[i]}}       & zeroize_mem_addr[ABR_MEM_ADDR_WIDTH-4:0]);
      end
    end
  end
end

//Write Data Muxes — per-NTT
always_comb begin
  for (int unsigned ntt = 0; ntt < ABR_NUM_NTT; ntt++) begin
    for (int unsigned i = 1; i < 3; i++) begin
      abr_mem_wdata[ntt][i] = ({ABR_MEM_DATA_WIDTH{sampler_mem_we[i]}}           & sampler_mem_data[ntt]) |
                              ({ABR_MEM_DATA_WIDTH{ntt_mem_we_mux[ntt][i]}}     & ntt_mem_wr_data_mux[ntt][i]) |
                              ({ABR_MEM_DATA_WIDTH{decomp_mem_we[i]}}            & decomp_mem_wr_data) |
                              ({ABR_MEM_DATA_WIDTH{decompress_mem_we[i]}}        & decompress_mem_wr_data[ntt]) |
                              ({ABR_MEM_DATA_WIDTH{sigdecode_h_mem_we[i]}}       & sigdecode_h_mem_wr_data);
    end
  end
end

//Read Muxes — per-NTT
always_comb begin
  for (int unsigned i = 0; i < 3; i++) begin
    if (i == 0) begin
      for (int unsigned ntt = 0; ntt < ABR_NUM_NTT; ntt++) begin
        ntt_mem_re0_bank_mux[ntt] = '0;
        pwo_a_mem_re0_bank_mux[ntt] = '0;
        pwo_b_mem_re0_bank_mux[ntt] = '0;
      end
      for (int unsigned bank = 0; bank < 2; bank++) begin
        for (int unsigned ntt = 0; ntt < ABR_NUM_NTT; ntt++) begin
          ntt_mem_re0_bank[0][ntt][bank]   = (ntt_mem_rd_req[ntt].rd_wr_en == RW_READ) & (ntt_mem_rd_req[ntt].addr[ABR_MEM_ADDR_WIDTH-1:ABR_MEM_ADDR_WIDTH-3] == i) & (ntt_mem_rd_req[ntt].addr[0] == bank);
          pwo_a_mem_re0_bank[0][ntt][bank] = (pwm_a_rd_req[ntt].rd_wr_en == RW_READ) & (pwm_a_rd_req[ntt].addr[ABR_MEM_ADDR_WIDTH-1:ABR_MEM_ADDR_WIDTH-3] == i) & (pwm_a_rd_req[ntt].addr[0] == bank);
          pwo_b_mem_re0_bank[0][ntt][bank] = (ntt_shuffling_en[ntt] ? ~sampler_ntt_dv_f[ntt] : ~sampler_ntt_dv[ntt]) & (pwm_b_rd_req[ntt].rd_wr_en == RW_READ) & (pwm_b_rd_req[ntt].addr[ABR_MEM_ADDR_WIDTH-1:ABR_MEM_ADDR_WIDTH-3] == i) & (pwm_b_rd_req[ntt].addr[0] == bank);
          ntt_mem_re0_bank_mux[ntt][bank] |= ntt_mem_re0_bank[0][ntt][bank];
          pwo_a_mem_re0_bank_mux[ntt][bank] |= pwo_a_mem_re0_bank[0][ntt][bank];
          pwo_b_mem_re0_bank_mux[ntt][bank] |= pwo_b_mem_re0_bank[0][ntt][bank];
        end
    
        decomp_mem_re0_bank[0][0][bank] = (decomp_mem_rd_req[0].rd_wr_en == RW_READ) & (decomp_mem_rd_req[0].addr[ABR_MEM_ADDR_WIDTH-1:ABR_MEM_ADDR_WIDTH-3] == i) & (decomp_mem_rd_req[0].addr[0] == bank);
        decomp_mem_re0_bank[0][1][bank] = (decomp_mem_rd_req[1].rd_wr_en == RW_READ) & (decomp_mem_rd_req[1].addr[ABR_MEM_ADDR_WIDTH-1:ABR_MEM_ADDR_WIDTH-3] == i) & (decomp_mem_rd_req[1].addr[0] == bank);
        normcheck_mem_re0_bank[0][bank] = (normcheck_mem_rd_req.rd_wr_en == RW_READ) & (normcheck_mem_rd_req.addr[ABR_MEM_ADDR_WIDTH-1:ABR_MEM_ADDR_WIDTH-3] == i) & (normcheck_mem_rd_req.addr[0] == bank);
        compress_mem_re0_bank[0][bank]  = (compress_mem_rd_req.rd_wr_en == RW_READ) & (compress_mem_rd_req.addr[ABR_MEM_ADDR_WIDTH-1:ABR_MEM_ADDR_WIDTH-3] == i) & (compress_mem_rd_req.addr[0] == bank);
        skencode_mem_re0_bank[0][bank]  = (skencode_mem_rd_req[bank].rd_wr_en == RW_READ);
        sigencode_mem_re0_bank[0][bank] = (sigencode_mem_rd_req[bank].rd_wr_en == RW_READ);
        pwr2rnd_mem_re0_bank[0][bank]   = (pwr2rnd_mem_rd_req[bank].rd_wr_en == RW_READ);

        // NTT[0] reads from regular memory; non-NTT sources also use regular memory
        // During RECOMBINE, NTT[0] pwm_b reads from masked memory — suppress from regular side
        abr_mem_re0_bank[0][bank] = ntt_mem_re0_bank_mux[0][bank] | pwo_a_mem_re0_bank_mux[0][bank] | pwo_b_mem_re0_bank_mux[0][bank] |
                                   decomp_mem_re0_bank[0][0][bank] | decomp_mem_re0_bank[0][1][bank] | 
                                   skencode_mem_re0_bank[0][bank] | normcheck_mem_re0_bank[0][bank] |
                                   sigencode_mem_re0_bank[0][bank] | pwr2rnd_mem_re0_bank[0][bank] |
                                   compress_mem_re0_bank[0][bank];
        abr_mem_raddr0_bank[0][bank] = ({ABR_MEM_ADDR_WIDTH-4{ntt_mem_re0_bank_mux[0][bank]}}   & ntt_mem_rd_req_mux[0][i][ABR_MEM_ADDR_WIDTH-4:1]) |
                                      ({ABR_MEM_ADDR_WIDTH-4{pwo_a_mem_re0_bank_mux[0][bank]}} & pwm_a_rd_req_mux[0][i][ABR_MEM_ADDR_WIDTH-4:1])   |
                                      ({ABR_MEM_ADDR_WIDTH-4{pwo_b_mem_re0_bank_mux[0][bank]}} & pwm_b_rd_req_mux[0][i][ABR_MEM_ADDR_WIDTH-4:1])   |
                                      ({ABR_MEM_ADDR_WIDTH-4{decomp_mem_re0_bank[0][0][bank]}} & decomp_mem_rd_req[0].addr[ABR_MEM_ADDR_WIDTH-4:1]) |
                                      ({ABR_MEM_ADDR_WIDTH-4{decomp_mem_re0_bank[0][1][bank]}} & decomp_mem_rd_req[1].addr[ABR_MEM_ADDR_WIDTH-4:1]) |
                                      ({ABR_MEM_ADDR_WIDTH-4{skencode_mem_re0_bank[0][bank]}}  & skencode_mem_rd_req[bank].addr[ABR_MEM_ADDR_WIDTH-4:1]) |
                                      ({ABR_MEM_ADDR_WIDTH-4{normcheck_mem_re0_bank[0][bank]}} & normcheck_mem_rd_req.addr[ABR_MEM_ADDR_WIDTH-4:1]) |
                                      ({ABR_MEM_ADDR_WIDTH-4{sigencode_mem_re0_bank[0][bank]}} & sigencode_mem_rd_req[bank].addr[ABR_MEM_ADDR_WIDTH-4:1])|
                                      ({ABR_MEM_ADDR_WIDTH-4{pwr2rnd_mem_re0_bank[0][bank]}}   & pwr2rnd_mem_rd_req[bank].addr[ABR_MEM_ADDR_WIDTH-4:1]) |
                                      ({ABR_MEM_ADDR_WIDTH-4{compress_mem_re0_bank[0][bank]}} & compress_mem_rd_req.addr[ABR_MEM_ADDR_WIDTH-4:1]);
      end
    end else begin
      decomp_mem_re[0][0][i] = (decomp_mem_rd_req[0].rd_wr_en == RW_READ) & (decomp_mem_rd_req[0].addr[ABR_MEM_ADDR_WIDTH-1:ABR_MEM_ADDR_WIDTH-3] == i);
      decomp_mem_re[0][1][i] = (decomp_mem_rd_req[1].rd_wr_en == RW_READ) & (decomp_mem_rd_req[1].addr[ABR_MEM_ADDR_WIDTH-1:ABR_MEM_ADDR_WIDTH-3] == i);
      normcheck_mem_re[0][i] = (normcheck_mem_rd_req.rd_wr_en == RW_READ) & (normcheck_mem_rd_req.addr[ABR_MEM_ADDR_WIDTH-1:ABR_MEM_ADDR_WIDTH-3] == i);
      makehint_mem_re[0][i]  = (makehint_mem_rd_req.rd_wr_en == RW_READ)  & (makehint_mem_rd_req.addr[ABR_MEM_ADDR_WIDTH-1:ABR_MEM_ADDR_WIDTH-3] == i);
      compress_mem_re[0][i]  = (compress_mem_rd_req.rd_wr_en == RW_READ) & (compress_mem_rd_req.addr[ABR_MEM_ADDR_WIDTH-1:ABR_MEM_ADDR_WIDTH-3] == i);

      // NTT[0] reads from regular memory
      // During RECOMBINE, NTT[0] pwm_b reads from masked memory — suppress from regular side
      abr_mem_re[0][i] = ntt_mem_re_mux[0][i] | pwo_a_mem_re_mux[0][i] | pwo_b_mem_re_mux[0][i] |
                        decomp_mem_re[0][0][i] | decomp_mem_re[0][1][i] | 
                        normcheck_mem_re[0][i] | makehint_mem_re[0][i] | compress_mem_re[0][i];
      abr_mem_raddr[0][i] = ({ABR_MEM_ADDR_WIDTH-3{ntt_mem_re_mux[0][i]}}   & ntt_mem_rd_req_mux[0][i][ABR_MEM_ADDR_WIDTH-4:0])   |
                           ({ABR_MEM_ADDR_WIDTH-3{pwo_a_mem_re_mux[0][i]}} & pwm_a_rd_req_mux[0][i][ABR_MEM_ADDR_WIDTH-4:0]) |
                           ({ABR_MEM_ADDR_WIDTH-3{pwo_b_mem_re_mux[0][i]}} & pwm_b_rd_req_mux[0][i][ABR_MEM_ADDR_WIDTH-4:0]) |
                           ({ABR_MEM_ADDR_WIDTH-3{decomp_mem_re[0][0][i]}} & decomp_mem_rd_req[0].addr[ABR_MEM_ADDR_WIDTH-4:0]) |
                           ({ABR_MEM_ADDR_WIDTH-3{decomp_mem_re[0][1][i]}} & decomp_mem_rd_req[1].addr[ABR_MEM_ADDR_WIDTH-4:0]) |
                           ({ABR_MEM_ADDR_WIDTH-3{normcheck_mem_re[0][i]}} & normcheck_mem_rd_req.addr[ABR_MEM_ADDR_WIDTH-4:0]) |
                           ({ABR_MEM_ADDR_WIDTH-3{makehint_mem_re[0][i]}}  & makehint_mem_rd_req.addr[ABR_MEM_ADDR_WIDTH-4:0]) |
                           ({ABR_MEM_ADDR_WIDTH-3{compress_mem_re[0][i]}} & compress_mem_rd_req.addr[ABR_MEM_ADDR_WIDTH-4:0]);
      end
  end
end

// NTT[1] masked memory read mux — present only when MASKING_EN.
generate if (MASKING_EN) begin : ntt1_mem_read_mux
  always_comb begin
    for (int unsigned bank = 0; bank < 2; bank++) begin
      // Masked-mem parallel read for share1 fetch on any active fused consumer.
      // For PWS_R, operand1→pwm_b at abr_ctrl (operand-swap convention), so PWS_R
      // also uses pwm_b's request — NOT pwm_a's (which carries an unrelated operand2).
      // recombine_en from abr_ctrl; *_mem_re* steers active consumer (mutex).
      abr_mem_re0_bank[1][bank] = ntt_mem_re0_bank_mux[1][bank] | pwo_a_mem_re0_bank_mux[1][bank] | pwo_b_mem_re0_bank_mux[1][bank] |
                                  (recombine_en & (pwo_b_mem_re0_bank[0][0][bank] |
                                                   normcheck_mem_re0_bank[0][bank] |
                                                   sigencode_mem_re0_bank[0][bank] |
                                                   compress_mem_re0_bank[0][bank]  |
                                                   skencode_mem_re0_bank[0][bank]  |
                                                   decomp_mem_re0_bank[0][0][bank] |
                                                   pwr2rnd_mem_re0_bank[0][bank]));
      abr_mem_raddr0_bank[1][bank] = ({ABR_MEM_ADDR_WIDTH-4{ntt_mem_re0_bank_mux[1][bank]}}   & ntt_mem_rd_req_mux[1][0][ABR_MEM_ADDR_WIDTH-4:1]) |
                                    ({ABR_MEM_ADDR_WIDTH-4{pwo_a_mem_re0_bank_mux[1][bank]}} & pwm_a_rd_req_mux[1][0][ABR_MEM_ADDR_WIDTH-4:1])   |
                                    ({ABR_MEM_ADDR_WIDTH-4{pwo_b_mem_re0_bank_mux[1][bank]}} & pwm_b_rd_req_mux[1][0][ABR_MEM_ADDR_WIDTH-4:1])   |
                                    ({ABR_MEM_ADDR_WIDTH-4{recombine_en & pwo_b_mem_re0_bank[0][0][bank]}} & pwm_b_rd_req_mux[0][0][ABR_MEM_ADDR_WIDTH-4:1]) |
                                    ({ABR_MEM_ADDR_WIDTH-4{recombine_en & normcheck_mem_re0_bank[0][bank]}} & normcheck_mem_rd_req.addr[ABR_MEM_ADDR_WIDTH-4:1]) |
                                    ({ABR_MEM_ADDR_WIDTH-4{recombine_en & sigencode_mem_re0_bank[0][bank]}} & sigencode_mem_rd_req[bank].addr[ABR_MEM_ADDR_WIDTH-4:1]) |
                                    ({ABR_MEM_ADDR_WIDTH-4{recombine_en & compress_mem_re0_bank[0][bank]}}  & compress_mem_rd_req.addr[ABR_MEM_ADDR_WIDTH-4:1])      |
                                    ({ABR_MEM_ADDR_WIDTH-4{recombine_en & skencode_mem_re0_bank[0][bank]}}  & skencode_mem_rd_req[bank].addr[ABR_MEM_ADDR_WIDTH-4:1]) |
                                    ({ABR_MEM_ADDR_WIDTH-4{recombine_en & decomp_mem_re0_bank[0][0][bank]}} & decomp_mem_rd_req[0].addr[ABR_MEM_ADDR_WIDTH-4:1]) |
                                    ({ABR_MEM_ADDR_WIDTH-4{recombine_en & pwr2rnd_mem_re0_bank[0][bank]}}   & pwr2rnd_mem_rd_req[bank].addr[ABR_MEM_ADDR_WIDTH-4:1]);
    end
    for (int unsigned i = 1; i < 3; i++) begin
      // Non-banked memories (i=1,2). SIGENCODE/SKENCODE/PWR2RND consume only
      // banked memories; COMPRESS_R and DECOMPOSE_R (port [0]) also span here.
      abr_mem_re[1][i] = ntt_mem_re_mux[1][i] | pwo_a_mem_re_mux[1][i] | pwo_b_mem_re_mux[1][i] |
                          (recombine_en & (pwo_b_mem_re[0][0][i]   |
                                           normcheck_mem_re[0][i]  |
                                           compress_mem_re[0][i]   |
                                           decomp_mem_re[0][0][i]));
      abr_mem_raddr[1][i] = ({ABR_MEM_ADDR_WIDTH-3{ntt_mem_re_mux[1][i]}}   & ntt_mem_rd_req_mux[1][i][ABR_MEM_ADDR_WIDTH-4:0])   |
                           ({ABR_MEM_ADDR_WIDTH-3{pwo_a_mem_re_mux[1][i]}} & pwm_a_rd_req_mux[1][i][ABR_MEM_ADDR_WIDTH-4:0]) |
                           ({ABR_MEM_ADDR_WIDTH-3{pwo_b_mem_re_mux[1][i]}} & pwm_b_rd_req_mux[1][i][ABR_MEM_ADDR_WIDTH-4:0]) |
                           ({ABR_MEM_ADDR_WIDTH-3{recombine_en & pwo_b_mem_re[0][0][i]}} & pwm_b_rd_req_mux[0][i][ABR_MEM_ADDR_WIDTH-4:0]) |
                           ({ABR_MEM_ADDR_WIDTH-3{recombine_en & normcheck_mem_re[0][i]}} & normcheck_mem_rd_req.addr[ABR_MEM_ADDR_WIDTH-4:0]) |
                           ({ABR_MEM_ADDR_WIDTH-3{recombine_en & compress_mem_re[0][i]}} & compress_mem_rd_req.addr[ABR_MEM_ADDR_WIDTH-4:0]) |
                           ({ABR_MEM_ADDR_WIDTH-3{recombine_en & decomp_mem_re[0][0][i]}} & decomp_mem_rd_req[0].addr[ABR_MEM_ADDR_WIDTH-4:0]);
    end
  end
end endgenerate

//Pipeline read enables
generate
  for (genvar g_stage = 1; g_stage <= SRAM_LATENCY; g_stage++) begin : read_en_stage
    always_ff @(posedge clk or negedge rst_b) begin : read_en_flops
      if (!rst_b) begin
        ntt_mem_re[g_stage] <= '{default: '0};
        pwo_a_mem_re[g_stage] <= '{default: '0};
        pwo_b_mem_re[g_stage] <= '{default: '0};
        decomp_mem_re[g_stage] <= '{default: '0};
        normcheck_mem_re[g_stage] <= '{default: '0};
        compress_mem_re[g_stage] <= '{default: '0};
        ntt_mem_re0_bank[g_stage] <= '{default: '0};
        pwo_a_mem_re0_bank[g_stage] <= '{default: '0};
        pwo_b_mem_re0_bank[g_stage] <= '{default: '0};
        decomp_mem_re0_bank[g_stage] <= '{default: '0};
        normcheck_mem_re0_bank[g_stage] <= '{default: '0};
        compress_mem_re0_bank[g_stage] <= '{default: '0};
        makehint_mem_re[g_stage] <= '{default: '0};
        skencode_mem_re0_bank[g_stage] <= '{default: '0};
        sigencode_mem_re0_bank[g_stage] <= '{default: '0};
        pwr2rnd_mem_re0_bank[g_stage] <= '{default: '0}; 
      end
      else if (zeroize_reg) begin
        ntt_mem_re[g_stage] <= '{default: '0};
        pwo_a_mem_re[g_stage] <= '{default: '0};
        pwo_b_mem_re[g_stage] <= '{default: '0};
        decomp_mem_re[g_stage] <= '{default: '0};
        normcheck_mem_re[g_stage] <= '{default: '0};
        compress_mem_re[g_stage] <= '{default: '0};
        ntt_mem_re0_bank[g_stage] <= '{default: '0};
        pwo_a_mem_re0_bank[g_stage] <= '{default: '0};
        pwo_b_mem_re0_bank[g_stage] <= '{default: '0};
        decomp_mem_re0_bank[g_stage] <= '{default: '0};
        normcheck_mem_re0_bank[g_stage] <= '{default: '0};
        compress_mem_re0_bank[g_stage] <= '{default: '0};
        makehint_mem_re[g_stage] <= '{default: '0};
        skencode_mem_re0_bank[g_stage] <= '{default: '0};
        sigencode_mem_re0_bank[g_stage] <= '{default: '0};
        pwr2rnd_mem_re0_bank[g_stage] <= '{default: '0}; 
      end
      else begin
        ntt_mem_re[g_stage] <= ntt_mem_re[g_stage-1];
        pwo_a_mem_re[g_stage]<= pwo_a_mem_re[g_stage-1];
        pwo_b_mem_re[g_stage] <= pwo_b_mem_re[g_stage-1];
        decomp_mem_re[g_stage] <= decomp_mem_re[g_stage-1];
        normcheck_mem_re[g_stage] <= normcheck_mem_re[g_stage-1];
        compress_mem_re[g_stage] <= compress_mem_re[g_stage-1];
        ntt_mem_re0_bank[g_stage] <= ntt_mem_re0_bank[g_stage-1];
        pwo_a_mem_re0_bank[g_stage] <= pwo_a_mem_re0_bank[g_stage-1];
        pwo_b_mem_re0_bank[g_stage] <= pwo_b_mem_re0_bank[g_stage-1];
        decomp_mem_re0_bank[g_stage] <= decomp_mem_re0_bank[g_stage-1];
        normcheck_mem_re0_bank[g_stage] <= normcheck_mem_re0_bank[g_stage-1];
        compress_mem_re0_bank[g_stage] <= compress_mem_re0_bank[g_stage-1];
        makehint_mem_re[g_stage] <= makehint_mem_re[g_stage-1];
        skencode_mem_re0_bank[g_stage] <= skencode_mem_re0_bank[g_stage-1];
        sigencode_mem_re0_bank[g_stage] <= sigencode_mem_re0_bank[g_stage-1];
        pwr2rnd_mem_re0_bank[g_stage] <= pwr2rnd_mem_re0_bank[g_stage-1]; 
      end
    end  
  end
endgenerate

generate
  for (genvar g_stage = 1; g_stage <= 1; g_stage++) begin : sib_read_en_stage
    always_ff @(posedge clk or negedge rst_b) begin : sib_read_en_flops
      if (!rst_b) begin
        sib_mem_re[g_stage] <= '0; 
      end
      else if (zeroize_reg) begin
        sib_mem_re[g_stage] <= '0; 
      end
      else begin
        sib_mem_re[g_stage] <= sib_mem_re[g_stage-1]; 
      end
    end  
  end
endgenerate

//Read data muxes — NTT[0] from regular memory, NTT[1] from masked memory
always_comb begin
  ntt_mem_rd_data = 0;
  pwm_a_rd_data = 0;
  pwm_b_rd_data = 0;
  decomp_mem_rd_data = 0;
  normcheck_mem_rd_data = 0;
  compress_mem_rd_data = 0;

  for (int unsigned i = 0; i < 3; i++) begin
    if (i == 0) begin
      for (int unsigned bank = 0; bank < 2; bank++) begin
        for (int unsigned ntt = 0; ntt < ABR_NUM_NTT; ntt++) begin
          ntt_mem_rd_data[ntt] |= ({ABR_MEM_DATA_WIDTH{ntt_mem_re0_bank[SRAM_LATENCY][ntt][bank]}} & abr_mem_rdata0_bank[ntt][bank]);
          pwm_a_rd_data[ntt]   |= ({ABR_MEM_DATA_WIDTH{pwo_a_mem_re0_bank[SRAM_LATENCY][ntt][bank]}} & abr_mem_rdata0_bank[ntt][bank]);
          pwm_b_rd_data[ntt]   |= ({ABR_MEM_DATA_WIDTH{pwo_b_mem_re0_bank[SRAM_LATENCY][ntt][bank]}} & abr_mem_rdata0_bank[ntt][bank]);
        end
        decomp_mem_rd_data[0] |= ({ABR_MEM_DATA_WIDTH{decomp_mem_re0_bank[SRAM_LATENCY][0][bank]}} & abr_mem_rdata0_bank[0][bank]);
        decomp_mem_rd_data[1] |= ({ABR_MEM_DATA_WIDTH{decomp_mem_re0_bank[SRAM_LATENCY][1][bank]}} & abr_mem_rdata0_bank[0][bank]);
        normcheck_mem_rd_data |= ({ABR_MEM_DATA_WIDTH{normcheck_mem_re0_bank[SRAM_LATENCY][bank]}} & abr_mem_rdata0_bank[0][bank]);
        compress_mem_rd_data  |= ({ABR_MEM_DATA_WIDTH{compress_mem_re0_bank[SRAM_LATENCY][bank]}} & abr_mem_rdata0_bank[0][bank]);
      end
    end else begin
      for (int unsigned ntt = 0; ntt < ABR_NUM_NTT; ntt++) begin
        ntt_mem_rd_data[ntt] |= ({ABR_MEM_DATA_WIDTH{ntt_mem_re[SRAM_LATENCY][ntt][i]}} & abr_mem_rdata[ntt][i]);
        pwm_a_rd_data[ntt]   |= ({ABR_MEM_DATA_WIDTH{pwo_a_mem_re[SRAM_LATENCY][ntt][i]}} & abr_mem_rdata[ntt][i]);
        pwm_b_rd_data[ntt]   |= ({ABR_MEM_DATA_WIDTH{pwo_b_mem_re[SRAM_LATENCY][ntt][i]}} & abr_mem_rdata[ntt][i]);
      end
      decomp_mem_rd_data[0] |= ({ABR_MEM_DATA_WIDTH{decomp_mem_re[SRAM_LATENCY][0][i]}} & abr_mem_rdata[0][i]);
      decomp_mem_rd_data[1] |= ({ABR_MEM_DATA_WIDTH{decomp_mem_re[SRAM_LATENCY][1][i]}} & abr_mem_rdata[0][i]);
      normcheck_mem_rd_data |= ({ABR_MEM_DATA_WIDTH{normcheck_mem_re[SRAM_LATENCY][i]}} & abr_mem_rdata[0][i]);
      compress_mem_rd_data  |= ({ABR_MEM_DATA_WIDTH{compress_mem_re[SRAM_LATENCY][i]}} & abr_mem_rdata[0][i]);
    end
  end
  for (int unsigned ntt = 0; ntt < ABR_NUM_NTT; ntt++)
    ntt_mem_rd_data[ntt] |= ({ABR_MEM_DATA_WIDTH{sib_mem_re[1]}} & sib_mem_rd_data);

  // Fused-recombiner override on NTT[0] consumer muxes (PWS_R / NORMCHK_R /
  // COMPRESS_R / DECOMPOSE_R port[0]). Single-issue mutex: only one fires per cycle.
  if (MASKING_EN && recombine_en_pipe[SRAM_LATENCY]) begin
    pwm_b_rd_data[0]      = recombine_data[0] | recombine_data[1];
    normcheck_mem_rd_data = recombine_data[0] | recombine_data[1];
    compress_mem_rd_data  = recombine_data[0] | recombine_data[1];
    decomp_mem_rd_data[0] = recombine_data[0] | recombine_data[1];
  end
end

//======================================================================
// Shared consumer-recombiner. recombine_en/_mode from abr_ctrl, pipelined
// SRAM_LATENCY deep to align with mem-read return. Recombiner is
// combinational (LATENCY=0).
//======================================================================

assign recombine_en_pipe[0] = recombine_en;

generate
  for (genvar g_stage = 1; g_stage <= SRAM_LATENCY; g_stage++) begin : recombine_en_pipe_gen
    always_ff @(posedge clk or negedge rst_b) begin
      if (!rst_b)
        recombine_en_pipe[g_stage] <= 1'b0;
      else if (zeroize_reg)
        recombine_en_pipe[g_stage] <= 1'b0;
      else
        recombine_en_pipe[g_stage] <= recombine_en_pipe[g_stage-1];
    end
  end
endgenerate

// Per-bank share capture. For PWS_R, operand1 (to-be-recombined) is on pwm_b
// (abr_ctrl operand1→pw_base_addr_b swap). Single-port consumers fire on one
// bank/cycle; the inactive bank sees share0=share1=0 → recombine=0, harmless.
// SIGENCODE_R/SKENCODE_R/PWR2RND_R fire both banks concurrently (port↔bank fixed).
always_comb begin
  for (int unsigned bank = 0; bank < 2; bank++) begin
    recombine_share0[bank] = '0;
    recombine_share1[bank] = '0;
  end
  // Banked memory (i==0): per-bank one-hot source selector OR-reduces the 7
  // fused-consumer read-enables (already mutexed by ERR_MEM_0_*_RD_ACCESS_MUTEX
  // and the recombine-scoped mutex below).
  for (int unsigned bank = 0; bank < 2; bank++) begin
    automatic logic bank_src_sel;
    bank_src_sel = recombine_en_pipe[SRAM_LATENCY] &
                   (pwo_b_mem_re0_bank[SRAM_LATENCY][0][bank] |
                    normcheck_mem_re0_bank[SRAM_LATENCY][bank] |
                    sigencode_mem_re0_bank[SRAM_LATENCY][bank] |
                    compress_mem_re0_bank[SRAM_LATENCY][bank]  |
                    skencode_mem_re0_bank[SRAM_LATENCY][bank]  |
                    decomp_mem_re0_bank[SRAM_LATENCY][0][bank] |
                    pwr2rnd_mem_re0_bank[SRAM_LATENCY][bank]);
    recombine_share0[bank] |= ({ABR_MEM_DATA_WIDTH{bank_src_sel}} & abr_mem_rdata0_bank[0][bank]);
    if (MASKING_EN)
      recombine_share1[bank] |= ({ABR_MEM_DATA_WIDTH{bank_src_sel}} & abr_mem_rdata0_bank[MASKED_IDX][bank]);
  end
  // Non-banked memories (i==1,2): only PWS_R, NORMCHK_R, COMPRESS_R, DECOMPOSE_R
  // contribute (SIGENCODE/SKENCODE/PWR2RND are banked-only). Broadcast to both
  // bank recombiners — the single-port consumer mux below OR-merges harmlessly.
  for (int unsigned i = 1; i < 3; i++) begin
    automatic logic other_src_sel;
    other_src_sel = recombine_en_pipe[SRAM_LATENCY] &
                    (pwo_b_mem_re[SRAM_LATENCY][0][i] |
                     normcheck_mem_re[SRAM_LATENCY][i] |
                     compress_mem_re[SRAM_LATENCY][i] |
                     decomp_mem_re[SRAM_LATENCY][0][i]);
    for (int unsigned bank = 0; bank < 2; bank++) begin
      recombine_share0[bank] |= ({ABR_MEM_DATA_WIDTH{other_src_sel}} & abr_mem_rdata[0][i]);
      if (MASKING_EN)
        recombine_share1[bank] |= ({ABR_MEM_DATA_WIDTH{other_src_sel}} & abr_mem_rdata[MASKED_IDX][i]);
    end
  end
end

generate if (MASKING_EN) begin : g_recombiner
  // Per-bank dual recombiner — required by dual-port consumers
  // (SIGENCODE_R/SKENCODE_R/PWR2RND_R). Single-port consumers see
  // share0=share1=0 on the inactive bank → output 0, OR-merges harmlessly.
  for (genvar bank = 0; bank < 2; bank++) begin : g_per_bank
    abr_recombiner u_recombiner (
      .mode     (recombine_mode),
      .share0_i (recombine_share0[bank]),
      .share1_i (recombine_share1[bank]),
      .data_o   (recombine_data[bank])
    );
  end
end else begin : g_no_recombiner
  assign recombine_data  = '0;
end endgenerate

// SKENCODE_R / SIGENCODE_R / PWR2RND_R consumer muxes — dual-port: each port
// maps to its own bank's recombiner output. Dormant case falls through to the
// regular-mem path (bit-identical to baseline).
always_comb begin
  skencode_mem_rd_data[0] = (MASKING_EN && recombine_en_pipe[SRAM_LATENCY]) ? recombine_data[0]
                                                                            : abr_mem_rdata0_bank[0][0];
  skencode_mem_rd_data[1] = (MASKING_EN && recombine_en_pipe[SRAM_LATENCY]) ? recombine_data[1]
                                                                            : abr_mem_rdata0_bank[0][1];
end
always_comb makehint_mem_rd_data = abr_mem_rdata[0][2];
always_comb begin
  sigencode_mem_rd_data[0] = (MASKING_EN && recombine_en_pipe[SRAM_LATENCY]) ? recombine_data[0]
                                                                             : abr_mem_rdata0_bank[0][0];
  sigencode_mem_rd_data[1] = (MASKING_EN && recombine_en_pipe[SRAM_LATENCY]) ? recombine_data[1]
                                                                             : abr_mem_rdata0_bank[0][1];
end
always_comb begin
  pwr2rnd_mem_rd_data[0] = (MASKING_EN && recombine_en_pipe[SRAM_LATENCY]) ? recombine_data[0]
                                                                           : abr_mem_rdata0_bank[0][0];
  pwr2rnd_mem_rd_data[1] = (MASKING_EN && recombine_en_pipe[SRAM_LATENCY]) ? recombine_data[1]
                                                                           : abr_mem_rdata0_bank[0][1];
end

//Read data valids
always_comb compress_mem_rd_data_valid = (|compress_mem_re[SRAM_LATENCY]) || (|compress_mem_re0_bank[SRAM_LATENCY]);
always_comb makehint_mem_rd_data_valid = (|makehint_mem_re[SRAM_LATENCY]);
always_comb sib_mem_rd_data_valid = (|sib_mem_re[1]);
always_comb normcheck_mem_rd_data_valid = (|normcheck_mem_re[SRAM_LATENCY]) || (|normcheck_mem_re0_bank[SRAM_LATENCY]);
always_comb decomp_mem_rd_data_valid = (|decomp_mem_re[SRAM_LATENCY]) || (|decomp_mem_re0_bank[SRAM_LATENCY]);
always_comb begin: ntt_rd_data_valid_gen
  for (int unsigned ntt = 0; ntt < ABR_NUM_NTT; ntt++) begin
    // SIB valid: Both NTTs use NTT[0]'s SIB read detect (pipelined 1 cycle).
    // Only NTT[0] actually drives the SIB read port — NTT[1]'s SIB-range addresses
    // go nowhere in the memory mux (no inst4 decode). Since NOSHUF guarantees both
    // NTTs are cycle-aligned (same addresses, same timing), NTT[0]'s SIB read detect
    // fires at exactly the cycles NTT[1] also needs valid. SIB data is already
    // broadcast to all NTTs on line 1548.
    ntt_mem_rd_data_valid[ntt] = (|ntt_mem_re[SRAM_LATENCY][ntt]) || (|ntt_mem_re0_bank[SRAM_LATENCY][ntt]) ||
                                 ntt_sib_rd_detect_d1[0];
    pwm_a_rd_data_valid[ntt] = (|pwo_a_mem_re[SRAM_LATENCY][ntt]) || (|pwo_a_mem_re0_bank[SRAM_LATENCY][ntt]);
    pwm_b_rd_data_valid[ntt] = (|pwo_b_mem_re[SRAM_LATENCY][ntt]) || (|pwo_b_mem_re0_bank[SRAM_LATENCY][ntt]);
  end
end

always_comb skencode_mem_rd_data_valid = (|skencode_mem_re0_bank[SRAM_LATENCY]);
always_comb sigencode_mem_rd_data_valid = (|sigencode_mem_re0_bank[SRAM_LATENCY]);
always_comb pwr2rnd_mem_rd_data_valid = (|pwr2rnd_mem_re0_bank[SRAM_LATENCY]);  

///Memory instance 0 bank 0 — regular (NTT[0])
always_comb abr_memory_export.mem_inst0_bank0_we_i = (abr_mem_we0_bank[0][0]);
always_comb abr_memory_export.mem_inst0_bank0_waddr_i = (abr_mem_waddr0_bank[0][0][ABR_MEM_INST0_ADDR_W-1:0]);
always_comb abr_memory_export.mem_inst0_bank0_wdata_i = (abr_mem_wdata0_bank[0][0]);
always_comb abr_memory_export.mem_inst0_bank0_re_i = zeroize_mem_re ? 1'b1: (abr_mem_re0_bank[0][0]);
always_comb abr_memory_export.mem_inst0_bank0_raddr_i = zeroize_mem_re ? '0: (abr_mem_raddr0_bank[0][0][ABR_MEM_INST0_ADDR_W-1:0]);
always_comb abr_mem_rdata0_bank[0][0] = abr_memory_export.mem_inst0_bank0_rdata_o;

//Memory instance 0 bank 1 — regular (NTT[0])
always_comb abr_memory_export.mem_inst0_bank1_we_i = (abr_mem_we0_bank[0][1]);
always_comb abr_memory_export.mem_inst0_bank1_waddr_i = (abr_mem_waddr0_bank[0][1][ABR_MEM_INST0_ADDR_W-1:0]);
always_comb abr_memory_export.mem_inst0_bank1_wdata_i = (abr_mem_wdata0_bank[0][1]);
always_comb abr_memory_export.mem_inst0_bank1_re_i = zeroize_mem_re ? 1'b1: (abr_mem_re0_bank[0][1]);
always_comb abr_memory_export.mem_inst0_bank1_raddr_i = zeroize_mem_re ? '0: (abr_mem_raddr0_bank[0][1][ABR_MEM_INST0_ADDR_W-1:0]);
always_comb abr_mem_rdata0_bank[0][1] = abr_memory_export.mem_inst0_bank1_rdata_o;

//Memory instance 1 — regular (NTT[0])
always_comb abr_memory_export.mem_inst1_we_i = (abr_mem_we[0][1]);
always_comb abr_memory_export.mem_inst1_waddr_i = (abr_mem_waddr[0][1][ABR_MEM_INST1_ADDR_W-1:0]);
always_comb abr_memory_export.mem_inst1_wdata_i = (abr_mem_wdata[0][1]);
always_comb abr_memory_export.mem_inst1_re_i = zeroize_mem_re ? 1'b1: (abr_mem_re[0][1]);
always_comb abr_memory_export.mem_inst1_raddr_i = zeroize_mem_re ? '0: (abr_mem_raddr[0][1][ABR_MEM_INST1_ADDR_W-1:0]);
always_comb abr_mem_rdata[0][1] = abr_memory_export.mem_inst1_rdata_o;

//Memory instance 2 — regular (NTT[0])
always_comb abr_memory_export.mem_inst2_we_i = (abr_mem_we[0][2]);
always_comb abr_memory_export.mem_inst2_waddr_i = (abr_mem_waddr[0][2][ABR_MEM_INST2_ADDR_W-1:0]);
always_comb abr_memory_export.mem_inst2_wdata_i = (abr_mem_wdata[0][2]);
always_comb abr_memory_export.mem_inst2_re_i = zeroize_mem_re ? 1'b1: (abr_mem_re[0][2]);
always_comb abr_memory_export.mem_inst2_raddr_i = zeroize_mem_re ? '0: (abr_mem_raddr[0][2][ABR_MEM_INST2_ADDR_W-1:0]);
always_comb abr_mem_rdata[0][2] = abr_memory_export.mem_inst2_rdata_o;

// Masked memory exports — NTT[1] (only when MASKING_EN=1)
generate if (MASKING_EN) begin : masked_mem_export_gen
  always_comb abr_memory_export.mem_inst0_bank0_masked_we_i = abr_mem_we0_bank[1][0];
  always_comb abr_memory_export.mem_inst0_bank0_masked_waddr_i = abr_mem_waddr0_bank[1][0][ABR_MEM_INST0_ADDR_W-1:0];
  always_comb abr_memory_export.mem_inst0_bank0_masked_wdata_i = abr_mem_wdata0_bank[1][0];
  always_comb abr_memory_export.mem_inst0_bank0_masked_re_i = zeroize_mem_re ? 1'b1 : abr_mem_re0_bank[1][0];
  always_comb abr_memory_export.mem_inst0_bank0_masked_raddr_i = zeroize_mem_re ? '0 : abr_mem_raddr0_bank[1][0][ABR_MEM_INST0_ADDR_W-1:0];
  always_comb abr_mem_rdata0_bank[1][0] = abr_memory_export.mem_inst0_bank0_masked_rdata_o;

  always_comb abr_memory_export.mem_inst0_bank1_masked_we_i = abr_mem_we0_bank[1][1];
  always_comb abr_memory_export.mem_inst0_bank1_masked_waddr_i = abr_mem_waddr0_bank[1][1][ABR_MEM_INST0_ADDR_W-1:0];
  always_comb abr_memory_export.mem_inst0_bank1_masked_wdata_i = abr_mem_wdata0_bank[1][1];
  always_comb abr_memory_export.mem_inst0_bank1_masked_re_i = zeroize_mem_re ? 1'b1 : abr_mem_re0_bank[1][1];
  always_comb abr_memory_export.mem_inst0_bank1_masked_raddr_i = zeroize_mem_re ? '0 : abr_mem_raddr0_bank[1][1][ABR_MEM_INST0_ADDR_W-1:0];
  always_comb abr_mem_rdata0_bank[1][1] = abr_memory_export.mem_inst0_bank1_masked_rdata_o;

  always_comb abr_memory_export.mem_inst1_masked_we_i = abr_mem_we[1][1];
  always_comb abr_memory_export.mem_inst1_masked_waddr_i = abr_mem_waddr[1][1][ABR_MEM_INST1_ADDR_W-1:0];
  always_comb abr_memory_export.mem_inst1_masked_wdata_i = abr_mem_wdata[1][1];
  always_comb abr_memory_export.mem_inst1_masked_re_i = zeroize_mem_re ? 1'b1 : abr_mem_re[1][1];
  always_comb abr_memory_export.mem_inst1_masked_raddr_i = zeroize_mem_re ? '0 : abr_mem_raddr[1][1][ABR_MEM_INST1_ADDR_W-1:0];
  always_comb abr_mem_rdata[1][1] = abr_memory_export.mem_inst1_masked_rdata_o;

  always_comb abr_memory_export.mem_inst2_masked_we_i = abr_mem_we[1][2];
  always_comb abr_memory_export.mem_inst2_masked_waddr_i = abr_mem_waddr[1][2][ABR_MEM_INST2_ADDR_W-1:0];
  always_comb abr_memory_export.mem_inst2_masked_wdata_i = abr_mem_wdata[1][2];
  always_comb abr_memory_export.mem_inst2_masked_re_i = zeroize_mem_re ? 1'b1 : abr_mem_re[1][2];
  always_comb abr_memory_export.mem_inst2_masked_raddr_i = zeroize_mem_re ? '0 : abr_mem_raddr[1][2][ABR_MEM_INST2_ADDR_W-1:0];
  always_comb abr_mem_rdata[1][2] = abr_memory_export.mem_inst2_masked_rdata_o;
end else begin : no_masked_mem_export_gen
  // Tie off masked memory write ports when MASKING_EN=0
  always_comb abr_memory_export.mem_inst0_bank0_masked_we_i = '0;
  always_comb abr_memory_export.mem_inst0_bank0_masked_waddr_i = '0;
  always_comb abr_memory_export.mem_inst0_bank0_masked_wdata_i = '0;
  always_comb abr_memory_export.mem_inst0_bank0_masked_re_i = '0;
  always_comb abr_memory_export.mem_inst0_bank0_masked_raddr_i = '0;
  always_comb abr_memory_export.mem_inst0_bank1_masked_we_i = '0;
  always_comb abr_memory_export.mem_inst0_bank1_masked_waddr_i = '0;
  always_comb abr_memory_export.mem_inst0_bank1_masked_wdata_i = '0;
  always_comb abr_memory_export.mem_inst0_bank1_masked_re_i = '0;
  always_comb abr_memory_export.mem_inst0_bank1_masked_raddr_i = '0;
  always_comb abr_memory_export.mem_inst1_masked_we_i = '0;
  always_comb abr_memory_export.mem_inst1_masked_waddr_i = '0;
  always_comb abr_memory_export.mem_inst1_masked_wdata_i = '0;
  always_comb abr_memory_export.mem_inst1_masked_re_i = '0;
  always_comb abr_memory_export.mem_inst1_masked_raddr_i = '0;
  always_comb abr_memory_export.mem_inst2_masked_we_i = '0;
  always_comb abr_memory_export.mem_inst2_masked_waddr_i = '0;
  always_comb abr_memory_export.mem_inst2_masked_wdata_i = '0;
  always_comb abr_memory_export.mem_inst2_masked_re_i = '0;
  always_comb abr_memory_export.mem_inst2_masked_raddr_i = '0;
end endgenerate

//SK Memory Bank 0
always_comb abr_memory_export.sk_mem_bank0_we_i = sk_bank0_mem_if.we_i;
always_comb abr_memory_export.sk_mem_bank0_waddr_i = sk_bank0_mem_if.waddr_i;
always_comb abr_memory_export.sk_mem_bank0_wdata_i = sk_bank0_mem_if.wdata_i;
always_comb abr_memory_export.sk_mem_bank0_re_i = zeroize_mem_re ? 1'b1: sk_bank0_mem_if.re_i;
always_comb abr_memory_export.sk_mem_bank0_raddr_i = zeroize_mem_re ? '0: sk_bank0_mem_if.raddr_i;
always_comb sk_bank0_mem_if.rdata_o = abr_memory_export.sk_mem_bank0_rdata_o;

//SK Memory Bank 1
always_comb abr_memory_export.sk_mem_bank1_we_i = sk_bank1_mem_if.we_i;
always_comb abr_memory_export.sk_mem_bank1_waddr_i = sk_bank1_mem_if.waddr_i;
always_comb abr_memory_export.sk_mem_bank1_wdata_i = sk_bank1_mem_if.wdata_i;
always_comb abr_memory_export.sk_mem_bank1_re_i = zeroize_mem_re ? 1'b1: sk_bank1_mem_if.re_i;
always_comb abr_memory_export.sk_mem_bank1_raddr_i = zeroize_mem_re ? '0: sk_bank1_mem_if.raddr_i;
always_comb sk_bank1_mem_if.rdata_o = abr_memory_export.sk_mem_bank1_rdata_o;

//Sig Z Memory
always_comb abr_memory_export.sig_z_mem_we_i = sig_z_mem_if.we_i;
always_comb abr_memory_export.sig_z_mem_waddr_i = sig_z_mem_if.waddr_i;
always_comb abr_memory_export.sig_z_mem_wdata_i = sig_z_mem_if.wdata_i;
always_comb abr_memory_export.sig_z_mem_wstrobe_i = sig_z_mem_if.wstrobe_i;
always_comb abr_memory_export.sig_z_mem_re_i = zeroize_mem_re ? 1'b1: sig_z_mem_if.re_i;
always_comb abr_memory_export.sig_z_mem_raddr_i = zeroize_mem_re ? '0: sig_z_mem_if.raddr_i;
always_comb sig_z_mem_if.rdata_o = abr_memory_export.sig_z_mem_rdata_o;

//PK Memory
always_comb abr_memory_export.pk_mem_we_i = pk_mem_if.we_i;
always_comb abr_memory_export.pk_mem_waddr_i = pk_mem_if.waddr_i;
always_comb abr_memory_export.pk_mem_wdata_i = pk_mem_if.wdata_i;
always_comb abr_memory_export.pk_mem_wstrobe_i = pk_mem_if.wstrobe_i;
always_comb abr_memory_export.pk_mem_re_i = zeroize_mem_re ? 1'b1: pk_mem_if.re_i;
always_comb abr_memory_export.pk_mem_raddr_i = zeroize_mem_re ? '0: pk_mem_if.raddr_i;
always_comb pk_mem_if.rdata_o = abr_memory_export.pk_mem_rdata_o;

`ABR_ASSERT_MUTEX(ERR_MEM_0_0_RD_ACCESS_MUTEX, {ntt_mem_re0_bank_mux[0][0],pwo_a_mem_re0_bank_mux[0][0],pwo_b_mem_re0_bank_mux[0][0],
                                                decomp_mem_re0_bank[0][0][0],decomp_mem_re0_bank[0][1][0], pwr2rnd_mem_re0_bank[0][0],
                                                skencode_mem_re0_bank[0][0], normcheck_mem_re0_bank[0][0], sigencode_mem_re0_bank[0][0],
                                                compress_mem_re0_bank[0][0]}, clk, !rst_b)
`ABR_ASSERT_MUTEX(ERR_MEM_0_1_RD_ACCESS_MUTEX, {ntt_mem_re0_bank_mux[0][1],pwo_a_mem_re0_bank_mux[0][1],pwo_b_mem_re0_bank_mux[0][1],
                                                decomp_mem_re0_bank[0][0][1],decomp_mem_re0_bank[0][1][1], pwr2rnd_mem_re0_bank[0][1], 
                                                skencode_mem_re0_bank[0][1],normcheck_mem_re0_bank[0][1],sigencode_mem_re0_bank[0][1],
                                                compress_mem_re0_bank[0][1]}, clk, !rst_b)
`ABR_ASSERT_MUTEX(ERR_MEM_1_RD_ACCESS_MUTEX, {ntt_mem_re_mux[0][1],pwo_a_mem_re_mux[0][1],pwo_b_mem_re_mux[0][1],compress_mem_re[0][1],
                                              normcheck_mem_re[0][1], decomp_mem_re[0][0][1],decomp_mem_re[0][1][1],makehint_mem_re[0][1]}, clk, !rst_b)
`ABR_ASSERT_MUTEX(ERR_MEM_2_RD_ACCESS_MUTEX, {ntt_mem_re_mux[0][2],pwo_a_mem_re_mux[0][2],pwo_b_mem_re_mux[0][2],compress_mem_re[0][2],
                                              normcheck_mem_re[0][2], decomp_mem_re[0][0][2],decomp_mem_re[0][1][2],makehint_mem_re[0][2]}, clk, !rst_b)

`ABR_ASSERT_MUTEX(ERR_MEM_0_0_WR_ACCESS_MUTEX, {sampler_mem_we0_bank[0],ntt_mem_we0_bank[0][0],decomp_mem_we0_bank[0],decompress_mem_we0_bank[0],
                                                skdecode_mem_we0_bank[0], pkdecode_mem_we0_bank[0], sigdecode_h_mem_we0_bank[0],
                                                sigdecode_z_mem_we0_bank[0]}, clk, !rst_b)
`ABR_ASSERT_MUTEX(ERR_MEM_0_1_WR_ACCESS_MUTEX, {sampler_mem_we0_bank[1],ntt_mem_we0_bank[0][1],decomp_mem_we0_bank[1],decompress_mem_we0_bank[1],
                                                skdecode_mem_we0_bank[1], pkdecode_mem_we0_bank[1], sigdecode_h_mem_we0_bank[1],
                                                sigdecode_z_mem_we0_bank[1]}, clk, !rst_b)

`ABR_ASSERT_MUTEX(ERR_MEM_1_WR_ACCESS_MUTEX, {sampler_mem_we[1],ntt_mem_we_mux[0][1],decomp_mem_we[1],decompress_mem_we[1],sigdecode_h_mem_we[1]}, clk, !rst_b)
`ABR_ASSERT_MUTEX(ERR_MEM_2_WR_ACCESS_MUTEX, {sampler_mem_we[2],ntt_mem_we_mux[0][2],decomp_mem_we[2],decompress_mem_we[2],sigdecode_h_mem_we[2]}, clk, !rst_b)

`ABR_ASSERT_KNOWN(ERR_MEM_0_0_WDATA_X, {abr_mem_wdata0_bank[0][0]}, clk, !rst_b, abr_mem_we0_bank[0][0])
`ABR_ASSERT_KNOWN(ERR_MEM_0_1_WDATA_X, {abr_mem_wdata0_bank[0][1]}, clk, !rst_b, abr_mem_we0_bank[0][1])
`ABR_ASSERT_KNOWN(ERR_MEM_1_WDATA_X, {abr_mem_wdata[0][1]}, clk, !rst_b, abr_mem_we[0][1])
`ABR_ASSERT_KNOWN(ERR_MEM_2_WDATA_X, {abr_mem_wdata[0][2]}, clk, !rst_b, abr_mem_we[0][2])

`ABR_ASSERT_KNOWN(ERR_MEM_0_RDATA_X, {ntt_mem_rd_data}, clk, !rst_b)
`ABR_ASSERT_KNOWN(ERR_MEM_1_RDATA_X, {pwm_a_rd_data}, clk, !rst_b)
`ABR_ASSERT_KNOWN(ERR_MEM_2_RDATA_X, {pwm_b_rd_data}, clk, !rst_b)

// ---------------------------------------------------------------------------
// Recombine-fusion assertions
// ---------------------------------------------------------------------------
`ABR_ASSERT_MUTEX(ERR_RECOMBINE_BANK0_SRC_MUTEX,
    {pwo_b_mem_re0_bank[SRAM_LATENCY][0][0], normcheck_mem_re0_bank[SRAM_LATENCY][0],
     sigencode_mem_re0_bank[SRAM_LATENCY][0], compress_mem_re0_bank[SRAM_LATENCY][0],
     skencode_mem_re0_bank[SRAM_LATENCY][0],  decomp_mem_re0_bank[SRAM_LATENCY][0][0],
     pwr2rnd_mem_re0_bank[SRAM_LATENCY][0]},
    clk, !rst_b, recombine_en_pipe[SRAM_LATENCY])
`ABR_ASSERT_MUTEX(ERR_RECOMBINE_BANK1_SRC_MUTEX,
    {pwo_b_mem_re0_bank[SRAM_LATENCY][0][1], normcheck_mem_re0_bank[SRAM_LATENCY][1],
     sigencode_mem_re0_bank[SRAM_LATENCY][1], compress_mem_re0_bank[SRAM_LATENCY][1],
     skencode_mem_re0_bank[SRAM_LATENCY][1],  decomp_mem_re0_bank[SRAM_LATENCY][0][1],
     pwr2rnd_mem_re0_bank[SRAM_LATENCY][1]},
    clk, !rst_b, recombine_en_pipe[SRAM_LATENCY])

  abr_prim_alert_pkg::alert_tx_t [NumAlerts-1:0] alert_tx_o;
  logic clk_i;

  assign clk_i = clk;

  `ABR_ASSERT_PRIM_FSM_ERROR_TRIGGER_ALERT(SHA3FsmCheck_A,
  sampler_top_inst.sha3_inst.u_state_regs, alert_tx_o[1])

  `ABR_ASSERT_PRIM_FSM_ERROR_TRIGGER_ALERT(KeccakRoundFsmCheck_A,
  sampler_top_inst.sha3_inst.u_keccak.u_state_regs, alert_tx_o[1])

  `ABR_ASSERT_PRIM_FSM_ERROR_TRIGGER_ALERT(SHA3padFsmCheck_A,
  sampler_top_inst.sha3_inst.u_pad.u_state_regs, alert_tx_o[1])

  `ABR_ASSERT_PRIM_COUNT_ERROR_TRIGGER_ALERT(WrMsgCountCheck_A,
  sampler_top_inst.sha3_inst.u_pad.u_wrmsg_count, alert_tx_o[1])

  `ABR_ASSERT_PRIM_COUNT_ERROR_TRIGGER_ALERT(RoundCountCheck_A,
  sampler_top_inst.sha3_inst.u_keccak.u_round_count, alert_tx_o[1])

endmodule
