chipsalliance/adams-bridge/src/abr_top/coverage/abr_top_cov_if.sv

// SPDX-License-Identifier: Apache-2.0
//
// Licensed under the Apache License, Version 2.0 (the "License");
// you may not use this file except in compliance with the License.
// You may obtain a copy of the License at
//
// http://www.apache.org/licenses/LICENSE-2.0
//
// Unless required by applicable law or agreed to in writing, software
// distributed under the License is distributed on an "AS IS" BASIS,
// WITHOUT WARRANTIES OR CONDITIONS OF ANY KIND, either express or implied.
// See the License for the specific language governing permissions and
// limitations under the License.

`ifndef VERILATOR

interface abr_top_cov_if
    import abr_params_pkg::*;
    import abr_ctrl_pkg::*;
    import abr_sampler_pkg::*;
    `ifdef CALIPTRA
    import kv_defines_pkg::*; 
    `endif  
    (

    `ifdef CALIPTRA
    input logic           ocp_lock_in_progress,
    `endif

    input logic           clk,
    input logic           rst_b,
    input logic           debugUnlock_or_scan_mode_switch

);

    logic [2 : 0] mldsa_cmd;
    logic [2 : 0] mlkem_cmd;
    logic [2 : 0] mldsa_sw_cmd;
    logic zeroize;
    logic ready;
    logic mldsa_valid;
    logic mlkem_valid;
    logic pcr_process;

    logic error_flag;
    logic skdecode_error;
    logic mldsa_keygen_process;
    logic mldsa_signing_process;
    logic mldsa_verifying_process;
    logic mldsa_keygen_signing_process;
    logic mlkem_keygen_process;
    logic mlkem_encaps_process;
    logic mlkem_decaps_process;
    logic mlkem_keygen_decaps_process;

    logic verify_failure;
    logic normcheck_failure;
    logic [2 : 0] normcheck_mode;
    logic makehint_failure;
    logic invalid_hint;
    logic external_mu_mode;
    logic stream_msg_mode;
    logic stream_msg_ip;

    `ifdef CALIPTRA
    logic pcr_sign_mode;
    logic pcr_sign_input_invalid;
    logic kv_mldsa_seed_data_present;
    logic kv_mlkem_seed_data_present;
    logic kv_mlkem_msg_data_present;

    assign pcr_sign_input_invalid = abr_top.abr_ctrl_inst.pcr_sign_input_invalid;
    assign pcr_sign_mode = abr_top.abr_ctrl_inst.pcr_sign_mode;
    
    assign kv_mldsa_seed_data_present = abr_top.abr_ctrl_inst.kv_mldsa_seed_data_present;
    assign kv_mlkem_seed_data_present = abr_top.abr_ctrl_inst.kv_mlkem_seed_data_present;
    assign kv_mlkem_msg_data_present  = abr_top.abr_ctrl_inst.kv_mlkem_msg_data_present;

    logic mldsa_seed_zero_error;
    logic mlkem_seed_zero_error;
    logic mlkem_msg_zero_error;

    assign mldsa_seed_zero_error = abr_top.abr_ctrl_inst.mldsa_seed_zero_error;
    assign mlkem_seed_zero_error = abr_top.abr_ctrl_inst.mlkem_seed_zero_error;
    assign mlkem_msg_zero_error  = abr_top.abr_ctrl_inst.mlkem_msg_zero_error;

    always_ff @(posedge clk) begin
        if (!rst_b) begin
            pcr_process <= '0;
        end
        else if (pcr_sign_mode) begin
            pcr_process <= '1;
        end
        else if (!mldsa_signing_process & !mldsa_keygen_signing_process) begin
            pcr_process <= '0;
        end
    end

    kv_write_filter_metrics_t kv_write_metrics;
    kv_write_ctrl_reg_t kv_write_ctrl_reg;
    kv_read_ctrl_reg_t kv_read_ctrl_reg;

    assign kv_write_metrics = abr_top.abr_ctrl_inst.kv_mlkem_sharedkey_write_metrics;
    assign kv_write_ctrl_reg = abr_top.abr_ctrl_inst.kv_mlkem_sharedkey_write_ctrl_reg;
    assign kv_read_ctrl_reg = abr_top.abr_ctrl_inst.kv_mldsa_seed_read_ctrl_reg;
    `endif

    assign mldsa_cmd = abr_top.abr_ctrl_inst.mldsa_cmd_reg;
    assign mlkem_cmd = abr_top.abr_ctrl_inst.mlkem_cmd_reg;
    assign zeroize = abr_top.abr_ctrl_inst.zeroize;
    assign ready = abr_top.abr_ctrl_inst.abr_ready;
    assign mldsa_valid = abr_top.abr_ctrl_inst.mldsa_valid_reg;
    assign mlkem_valid = abr_top.abr_ctrl_inst.mlkem_valid_reg;

    always_ff @(posedge clk) begin
        if (!rst_b) begin
            mldsa_sw_cmd <= '0;
        end
        else if (abr_top.abr_reg_inst.decoded_reg_strb.MLDSA_CTRL && abr_top.abr_reg_inst.decoded_req_is_wr) begin // SW write
            mldsa_sw_cmd <= (abr_top.abr_reg_inst.field_storage.MLDSA_CTRL.CTRL.value & ~abr_top.abr_reg_inst.decoded_wr_biten[2:0]) | (abr_top.abr_reg_inst.decoded_wr_data[2:0] & abr_top.abr_reg_inst.decoded_wr_biten[2:0]);
        end
    end


    assign error_flag = abr_top.abr_ctrl_inst.error_flag | abr_top.abr_ctrl_inst.error_flag_reg;
    assign skdecode_error = abr_top.abr_ctrl_inst.skdecode_error_i;

    assign mldsa_keygen_process = abr_top.abr_ctrl_inst.mldsa_keygen_process;
    assign mldsa_signing_process = abr_top.abr_ctrl_inst.mldsa_signing_process;
    assign mldsa_verifying_process = abr_top.abr_ctrl_inst.mldsa_verifying_process;
    assign mldsa_keygen_signing_process = abr_top.abr_ctrl_inst.mldsa_keygen_signing_process;
    assign mlkem_keygen_process = abr_top.abr_ctrl_inst.mlkem_keygen_process;
    assign mlkem_encaps_process = abr_top.abr_ctrl_inst.mlkem_encaps_process;
    assign mlkem_decaps_process = abr_top.abr_ctrl_inst.mlkem_decaps_process;
    assign mlkem_keygen_decaps_process = abr_top.abr_ctrl_inst.mlkem_keygen_decaps_process;

    assign verify_failure = abr_top.abr_ctrl_inst.clear_verify_valid;
    assign normcheck_failure = abr_top.abr_ctrl_inst.normcheck_done_i & abr_top.abr_ctrl_inst.normcheck_invalid_i;
    assign normcheck_mode[0] = (abr_top.abr_ctrl_inst.normcheck_mode_o == 2'b00);
    assign normcheck_mode[1] = (abr_top.abr_ctrl_inst.normcheck_mode_o == 2'b01);
    assign normcheck_mode[2] = (abr_top.abr_ctrl_inst.normcheck_mode_o == 2'b10);
    assign makehint_failure = abr_top.abr_ctrl_inst.makehint_done_i & abr_top.abr_ctrl_inst.makehint_invalid_i;
    assign invalid_hint = abr_top.abr_ctrl_inst.sigdecode_h_invalid_i;
    assign external_mu_mode = abr_top.abr_ctrl_inst.external_mu_mode;
    assign stream_msg_mode = abr_top.abr_ctrl_inst.stream_msg_mode;
    assign stream_msg_ip = abr_top.abr_ctrl_inst.stream_msg_ip;

    // =========================================================================
    // SCA / Masking Coverage Signals
    // =========================================================================

    // Masking control signals from abr_ctrl
    logic sca_ntt_masking_en;
    logic sca_ntt_shuffling_en;
    logic sca_split_en;
    logic sca_recombine_en;

    assign sca_ntt_masking_en   = abr_top.ntt_masking_en_ctrl;
    assign sca_ntt_shuffling_en = abr_top.ntt_shuffling_en_ctrl;
    assign sca_split_en         = abr_top.split_en;
    assign sca_recombine_en     = abr_top.recombine_en;

    // NTT[1] enable (dual-NTT activation) — only exists when MASKING_EN=1
    logic sca_ntt1_enable;
    assign sca_ntt1_enable = (abr_top.ABR_NUM_NTT > 1) ? abr_top.ntt_enable[abr_top.MASKED_IDX] : 1'b0;

    // NTT[0] enable (primary NTT — always active for NTT ops)
    logic sca_ntt0_enable;
    assign sca_ntt0_enable = abr_top.ntt_enable[0];

    // NTT mode for NTT[0] (primary) — covers all operation types including RECOMBINE
    // NOTE: Use packed logic instead of enum types to avoid VCS partition-compile
    // "different enum types" errors when this cov_if is elaborated in both RTL
    // and TB scopes (the imported pkg ends up duplicated across scopes).
    logic [4:0] sca_ntt0_mode;
    assign sca_ntt0_mode = abr_top.ntt_mode[0];

    // NTT mode for NTT[1] — should exercise subset of modes when MASKING_EN=1
    logic [4:0] sca_ntt1_mode;
    assign sca_ntt1_mode = (abr_top.ABR_NUM_NTT > 1) ? 5'(abr_top.ntt_mode[abr_top.MASKED_IDX]) : 5'(ABR_NTT_NONE);

    // Opcode masking/shuffling bits from the instruction
    logic sca_opcode_masking_en;
    logic sca_opcode_shuffling_en;
    logic sca_opcode_ntt_en;

    assign sca_opcode_masking_en   = abr_top.abr_ctrl_inst.abr_instr.opcode.masking_en;
    assign sca_opcode_shuffling_en = abr_top.abr_ctrl_inst.abr_instr.opcode.shuffling_en;
    assign sca_opcode_ntt_en       = abr_top.abr_ctrl_inst.abr_instr.opcode.ntt_en;

    // Splitter activity — sampler splitter (one of the three splitter instances)
    logic sca_sampler_splitter_en;
    logic sca_sampler_splitter_ready;
    assign sca_sampler_splitter_en    = abr_top.sampler_top_inst.u_splitter.en_i;
    assign sca_sampler_splitter_ready = abr_top.sampler_top_inst.u_splitter.ready_o;

    // Splitter activity — skdecode has two splitters (port A and port B)
    logic sca_skdecode_splitter_a_en;
    logic sca_skdecode_splitter_b_en;
    assign sca_skdecode_splitter_a_en = abr_top.skdecode_inst.u_splitter_a.en_i;
    assign sca_skdecode_splitter_b_en = abr_top.skdecode_inst.u_splitter_b.en_i;

    // Splitter activity — decompress splitter
    logic sca_decompress_splitter_en;
    assign sca_decompress_splitter_en = abr_top.decompress_top_inst.u_splitter.en_i;

    // Splitter rand reduction — detect when LFSR rand >= q (reduction path exercised)
    logic sca_splitter_rand_reduced;
    assign sca_splitter_rand_reduced = abr_top.sampler_top_inst.u_splitter.rand_raw[0] >=
                                       abr_top.sampler_top_inst.u_splitter.prime;

    // Recombine pipeline depth tracking
    logic sca_recombine_en_pipe_last;
    assign sca_recombine_en_pipe_last = abr_top.recombine_en_pipe[abr_top.SRAM_LATENCY];

    // NTT[1] SIB read pipeline (bug 9 fix — ntt_sib_rd_detect_d1[0] gates NTT[1] valid)
    logic sca_ntt_sib_rd_detect_d1;
    assign sca_ntt_sib_rd_detect_d1 = abr_top.ntt_sib_rd_detect_d1[0];

    // Recombine pipeline first stage (bug 3 fix — recombine_en_pipe timing)
    logic sca_recombine_en_pipe_first;
    assign sca_recombine_en_pipe_first = abr_top.recombine_en_pipe[0];

    // Per-consumer fused-recombine coverage taps — re-derived from abr_ctrl
    // opcode (per-consumer enables collapsed to single recombine_en at source).
    logic sca_pws_recombine_en;
    logic sca_normchk_recombine_en;
    logic sca_sigencode_recombine_en;
    logic sca_compress_recombine_en;
    logic sca_skencode_recombine_en;
    logic sca_decompose_recombine_en;
    logic sca_pwr2rnd_recombine_en;

    // NOTE: cast both sides of enum comparisons to packed logic to avoid VCS
    // DTIE/DTIIO "different enum types" errors caused by abr_ctrl_pkg being
    // elaborated in both RTL and TB scopes (see note above at sca_ntt0_mode).
    assign sca_pws_recombine_en       = abr_top.MASKING_EN
                                      & abr_top.abr_ctrl_inst.abr_instr.opcode.recombine_en
                                      & abr_top.abr_ctrl_inst.abr_instr.opcode.ntt_en
                                      & (5'(abr_top.abr_ctrl_inst.abr_instr.opcode.mode.ntt_mode) inside {5'(MLDSA_PWS), 5'(MLKEM_PWS), 5'(MLDSA_PWA)});
    assign sca_normchk_recombine_en   = abr_top.MASKING_EN
                                      & abr_top.abr_ctrl_inst.abr_instr.opcode.recombine_en
                                      & abr_top.abr_ctrl_inst.abr_instr.opcode.aux_en
                                      & (5'(abr_top.abr_ctrl_inst.abr_instr.opcode.mode.aux_mode) == 5'(MLDSA_NORMCHK));
    assign sca_sigencode_recombine_en = abr_top.MASKING_EN
                                      & abr_top.abr_ctrl_inst.abr_instr.opcode.recombine_en
                                      & abr_top.abr_ctrl_inst.abr_instr.opcode.aux_en
                                      & (5'(abr_top.abr_ctrl_inst.abr_instr.opcode.mode.aux_mode) == 5'(MLDSA_SIGENC));
    assign sca_compress_recombine_en  = abr_top.MASKING_EN
                                      & abr_top.abr_ctrl_inst.abr_instr.opcode.recombine_en
                                      & abr_top.abr_ctrl_inst.abr_instr.opcode.aux_en
                                      & (5'(abr_top.abr_ctrl_inst.abr_instr.opcode.mode.aux_mode) == 5'(MLKEM_COMPRESS));
    assign sca_skencode_recombine_en  = abr_top.MASKING_EN
                                      & abr_top.abr_ctrl_inst.abr_instr.opcode.recombine_en
                                      & abr_top.abr_ctrl_inst.abr_instr.opcode.aux_en
                                      & (5'(abr_top.abr_ctrl_inst.abr_instr.opcode.mode.aux_mode) == 5'(MLDSA_SKENCODE));
    assign sca_decompose_recombine_en = abr_top.MASKING_EN
                                      & abr_top.abr_ctrl_inst.abr_instr.opcode.recombine_en
                                      & abr_top.abr_ctrl_inst.abr_instr.opcode.aux_en
                                      & (5'(abr_top.abr_ctrl_inst.abr_instr.opcode.mode.aux_mode) == 5'(MLDSA_DECOMP));
    assign sca_pwr2rnd_recombine_en   = abr_top.MASKING_EN
                                      & abr_top.abr_ctrl_inst.abr_instr.opcode.recombine_en
                                      & abr_top.abr_ctrl_inst.abr_instr.opcode.aux_en
                                      & (5'(abr_top.abr_ctrl_inst.abr_instr.opcode.mode.aux_mode) == 5'(MLDSA_PWR2RND));

    // Build-time MASKING_EN tap for cross axes.
    logic sca_masking_en_param;
    assign sca_masking_en_param = abr_top.MASKING_EN;

    // Sampler opcode mode (covers masked-sampling dispatch).
    // Packed logic to dodge VCS dual-scope enum mismatch (see note above).
    logic [4:0] sca_sampler_mode;
    assign sca_sampler_mode = abr_top.sampler_mode;

    // NTT[0]/NTT[1] mode match indicator — when masking, modes should be identical
    logic sca_ntt_modes_match;
    assign sca_ntt_modes_match = (abr_top.ABR_NUM_NTT > 1) ?
                                 (abr_top.ntt_mode[0] == abr_top.ntt_mode[abr_top.MASKED_IDX]) : 1'b1;

    // MASKED_NTT_NOSHUF detection (bug 6 fix — masking=1, shuffling=0, mode=MLDSA_NTT for NTT(c))
    // Distinguished from REJS_MASKED_* which also have masking=1,shuffling=0 but use PWM_SMPL modes.
    // Re-tap the RTL ntt_mode into a packed-logic local so the == compares values, not
    // cross-scope enum types (VCS partcomp duplicates the pkg across RTL/TB scopes).
    logic [4:0] sca_instr_ntt_mode;
    assign sca_instr_ntt_mode = abr_top.abr_ctrl_inst.abr_instr.opcode.mode.ntt_mode;
    logic sca_masked_noshuf;
    assign sca_masked_noshuf = sca_opcode_masking_en & ~sca_opcode_shuffling_en &
                               sca_opcode_ntt_en &
                               (sca_instr_ntt_mode == MLDSA_NTT);

    // Zeroize signal (re-tap for SCA covergroup local use)
    logic sca_zeroize;
    assign sca_zeroize = abr_top.abr_ctrl_inst.zeroize;

    // VERIFY_RES poison-init: re-tap signals that drive `clear_verify_valid`
    // so we can cover that both abort paths fire. By design (abr_ctrl.sv:806-810,
    // hwclr = zeroize only), VERIFY_RES retains the poison `~c~` whenever
    // clear_verify_valid asserts — coverage on the two source bits is sufficient.
    logic sca_clear_verify_valid;
    logic sca_normcheck_invalid;
    logic sca_sigdecode_h_invalid;
    assign sca_clear_verify_valid  = abr_top.abr_ctrl_inst.clear_verify_valid;
    assign sca_normcheck_invalid   = abr_top.abr_ctrl_inst.normcheck_invalid_i;
    assign sca_sigdecode_h_invalid = abr_top.abr_ctrl_inst.sigdecode_h_invalid_i;

    // =========================================================================
    // SCA Covergroup
    // =========================================================================

    covergroup abr_sca_cov_grp @(posedge clk);

        // --- Process coverpoints (declared first so crosses can reference them) ---
        sca_mldsa_keygen_cp:  coverpoint mldsa_keygen_process;
        sca_mldsa_signing_cp: coverpoint mldsa_signing_process;
        sca_mlkem_keygen_cp:  coverpoint mlkem_keygen_process;
        sca_mlkem_encaps_cp:  coverpoint mlkem_encaps_process;
        sca_mlkem_decaps_cp:  coverpoint mlkem_decaps_process;

        // --- Masking activation ---
        ntt_masking_en_cp: coverpoint sca_ntt_masking_en;
        ntt_shuffling_en_cp: coverpoint sca_ntt_shuffling_en;
        split_en_cp: coverpoint sca_split_en;
        recombine_en_cp: coverpoint sca_recombine_en;
        ntt0_enable_cp: coverpoint sca_ntt0_enable;
        ntt1_enable_cp: coverpoint sca_ntt1_enable;

        // --- NTT[0] mode (covers all operation types) ---
        ntt0_mode_cp: coverpoint sca_ntt0_mode {
            bins ntt_none        = {ABR_NTT_NONE};
            bins mldsa_ntt       = {MLDSA_NTT};
            bins mldsa_intt      = {MLDSA_INTT};
            bins mldsa_pwm       = {MLDSA_PWM};
            bins mldsa_pwm_accum = {MLDSA_PWM_ACCUM};
            bins mldsa_pwm_smpl  = {MLDSA_PWM_SMPL};
            bins mldsa_pwm_accum_smpl = {MLDSA_PWM_ACCUM_SMPL};
            bins mldsa_pwa       = {MLDSA_PWA};
            bins mldsa_pws       = {MLDSA_PWS};
            bins mlkem_ntt       = {MLKEM_NTT};
            bins mlkem_intt      = {MLKEM_INTT};
            bins mlkem_pwm       = {MLKEM_PWM};
            bins mlkem_pwm_accum = {MLKEM_PWM_ACCUM};
            bins mlkem_pwm_smpl  = {MLKEM_PWM_SMPL};
            bins mlkem_pwm_accum_smpl = {MLKEM_PWM_ACCUM_SMPL};
            bins mlkem_pwa       = {MLKEM_PWA};
            bins mlkem_pws       = {MLKEM_PWS};
        }
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
