chipsalliance/adams-bridge/(commit log)

2024-03-08 printed zeta_inv
2024-03-26 added ref model for samplers
2024-05-30 Merged PR 175722: sampler and kmac commit
    Initial commit for kmac/sha3 block, rej sampler, rej bounded, exp mask, and sample in ball
    ported prim files from OT used in kmac/sha3 block. Some may be useful to us also
    Related work items: #684182, #684183, #684184, #684185, #684186, #684187, #684188, #684189, #684191, #684192, #684193, #684195, #701280
2024-06-12 Merged PR 183051: Remove sampler_mode, fix pwm addressing
    1. Remove unnecessary sampler_mode from ntt. NTT wrapper still has it for testing purposes to emulate sampler connection to ntt
    2. Fix and clean up pwm addressing
    Related work items: #722319, #722317
    [ntt_ctrl.sv, ntt_top.sv, ntt_top_tb.sv, ntt_utb_top.sv, ntt_wrapper.sv]
2024-07-18 Merged PR 192009: UVM Env for Adam's Bridge
    - Created a UVM environment with UVMF yaml files.
    - Used AHB QVIP to create R/W transactions through the registers of adamsbridge_top.
    - The uvm_predictor predicts the KeyGne, Signing, and Verification operations after their corresponding write operations.
    - The uvm_predictor sends the predicted values to scoreboard with their corresponding read operations.
    - A test is written to perform KeyGne, Signing, and Verification operations.
    - Please note that it is a template, not a complete UVM environment.
    ----
    #### AI description (iteration 1)
    #### PR Classification
    New feature: Creation of UVM environment for Adam's Bridge.
    #### PR Summary
    This pull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
    [interfaces.csv]
2024-07-19 Merged PR 190920: sk decode
    s1, s2 and t0 unpack logic
    TODO:
    1. s1 and s2 error conditions. These need ref model updates to generate valid input bytes
    2. Look into s1s2 buffer full usage
    Related work items: #747398
    [compile.yml, skdecode_ctrl.sv, skdecode_defines_pkg.sv, skdecode_s1s2_unpack.sv, skdecode_t0_unpack.sv, skdecode_tb.sv, skdecode_top.sv]
2024-07-24 Merged PR 192022: adamsbridge control/sequencer
    Integrated sampler, ntt, memory, and controller blocks at the top level
    Sequencer runs through implemented functions, still missing power2round and skencode steps
    New feature: Implementation of sequencer and control path for keygen operations.
    This pull request introduces the sequencer and control path for keygen operations, defining necessary uops and operands.
    - `src/sampler_top/rtl/sampler_top.sv`: Added a new module `sampler_top` with various input/output logic signals, FSM controller, and SHA3 instance. Implemented multiple samplers (rej sampler, rej bounded,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
    [abr_ahb_defines_pkg.sv, abr_ahb_slv_sif.sv, abr_ctrl.sv, abr_seq.sv, compile.yml, exp_mask.sv, exp_mask_ctrl.sv, exp_mask_tb.sv]
2024-07-29 Merged PR 194042: skEncode Design
    We implemented skEncode module
    This module reads 8 coefficients at one cycle from a memory having one cycle latency.
    It encodes the coeffs into 3-bit format and later concatenates them into 32-bit strings.
    These strings are written to secret key API slots.
    The encoded polynomials are s1 and s2.
    Related work items: #756891
2024-07-29 Merged PR 194850: added missed pkg
    added missed pkg of ntt
    Bug fix to address missing package imports and parameter updates.
    This pull request adds missing package imports and updates parameter definitions to align with the updated NTT package.
    - `sigdecode_z_tb.sv`, `sigdecode_z_top.sv`, `sigencode_z_top.sv`, `sigencode_z_tb.sv`: Added import for `abr_params_pkg` and updated `MEM_ADDR_WIDTH` parameter to `ABR_MEM_ADDR_WIDTH`.
    - `sigdecode_z_defines_pkg.sv`, `sigencode_z_defines_pkg.sv`: Added import for `abr_params_pkg` and updated `API_ADDR_WIDTH` parameter to `ABR_MEM_ADDR_WIDTH`.
    Related work items: #760047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
    [sigdecode_z_defines_pkg.sv, sigdecode_z_tb.sv, sigdecode_z_top.sv, sigencode_z_defines_pkg.sv, sigencode_z_tb.sv, sigencode_z_top.sv]
2024-08-12 Merged PR 196898: Hint unpack rtl and tb
    Hint unpack rtl and tb
    New feature: Added RTL and testbench for sigdecode_h module.
    This pull request introduces the RTL implementation and testbench for the `sigdecode_h` module, which manages memory writes and read pointers for the encoded_h array.
    - `src/sigdecode_h/rtl/sigdecode_h_ctrl.sv`: Added the `sigdecode_h_ctrl` module to handle memory writes, read pointers, and FSMs for read and write operations.
    - `src/sigdecode_h/tb/sigdecode_h_tb.sv`: Added the testbench for `sigdecode_h`, including initialization, reset, and test tasks to verify the functionality of the `s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
    [compile.yml, sigdecode_h.sv, sigdecode_h_ctrl.sv, sigdecode_h_defines_pkg.sv, sigdecode_h_tb.sv]
2024-08-12 Merged PR 197714: Lint fixes in ABR submodules
    1. Lint fixes
    2. Update makehint y[w+k-1:w] bytes with hintsum to align with NIST algo
    3. Fix compile errors in sig_encode/decode_z
    Code cleanup and lint fixes.
    This pull request addresses lint issues and refactors code in various ABR submodules to improve code quality and maintainability.
    - `makehint.sv`: Removed unused parameters and imports, and cleaned up state transition logic.
    - `decompose.sv`: Updated address width parameters to use `ABR_MEM_ADDR_WIDTH` and cleaned up address calculations.
    - `ntt_top.sv`: Refactored memory address width parameters to use `ABR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
    [compile.yml, decompose.sv, decompose_ctrl.sv, decompose_mod_2gamma2.sv, decompose_tb.sv, makehint.sv, makehint_tb.sv, mem_driver.sv]
2024-08-15 Merged PR 199619: Complete signing flow with all aux blocks
    All aux blocks necessary for signing flow integrated.
    Makehint reg api writes fixed.
    Norm check halved throughput since R0 and CT0 need to be in separate banks, they can't both be in the split bank for double throughput.
    Skdecode modified to write t0 on both ports since each port is dedicated to a split bank of inst0 memory.
    Misc cleanup of defines packages.
    New feature: Complete signing flow with auxiliary blocks integration.
    Related work items: #752329, #767702
    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
    [abr_ctrl.sv, abr_ctrl_pkg.sv, abr_ram_regout.sv, compile.yml, decompose.sv, decompose_ctrl.sv, decompose_mod_2gamma2.sv, makehint.sv]
2024-08-19 Merged PR 200210: add power2round
    add power2round combined by sk_encode for t0 part
    New feature implementation.
    This pull request introduces the `power2round` architecture and implements the `skencode` functionality for the `t0` part.
    - Added `power2round_ctrl.sv` to handle control logic for the power2round operation, including state machines for reading, writing to secret key memory, and public key memory.
    - Implemented address counters and finite state machines (FSM) for managing memory read/write operations and ensuring proper sequencing and control signals.
    Related work items: #773746, #773748
    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
2024-08-19 Merged PR 200164: verify sequence and aux blocks
    verify sequence and aux blocks
    New feature: Integration of sequencer steps and auxiliary blocks for the verify flow.
    This pull request integrates sequencer steps and auxiliary blocks, including signature decoding and public key decoding, into the verification flow.
    - `adamsbridge_top.sv`: Added instances for `pkdecode`, `sigdecode_z`, and `sigdecode_h` modules, and updated memory write enable logic.
    - `abr_ctrl.sv`: Added logic for handling public key and signature decoding, and updated control FSM for new auxiliary modes.
    - `adamsbridge_reg.sv`: Simplified public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
2024-08-20 Merged PR 201072: power2round randomized test
    power2round ref model
    added power2round randomized test
    New feature: Added randomized testing for the power2round module.
    This pull request introduces randomized testing for the power2round module, enhancing the robustness of the test suite.
    - `src/power2round/tb/power2round_tb.sv`: Added tasks to read test vectors from files, display test results, and updated the test logic to use randomized inputs.
    - `src/power2round/tb/power2round.py`: Modified to generate random coefficients and write them to hex files for testing.
    - `src/power2round/rtl/power2round_ctrl.sv` and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
2024-08-21 Merged PR 201494: UVM updates for 3 operations
    Created 3 test cases and thus 3 sequences
    Updated predictor with mem sub-mapping
    Updated scoreboard and predictor with ignoring unnecessary read register ops
    Updated base sequence by moving all common variables into it
    Updated executbales test_dilithium ones
    removed uvm_reg files under the uvmf
    Code cleanup and refactoring.
    This pull request removes outdated UVM register model files and updates the memory mapping for specific keys.
    - Deleted `src/adamsbridge_top/uvmf/adamsbridge_reg_sample.svh` which contained sample functions for various registers.
    - Removed `src/a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
2024-08-22 Merged PR 201452: Keygen complete flow
    Completed keygen flow
    Integrated power2round
    New feature: Complete flow for KeyGen with sequencer/control logic.
    This pull request completes the KeyGen flow by adding sequencer/control logic, including power2round and skencode functionalities.
    - `src/adamsbridge_top/rtl/abr_ctrl.sv`: Added logic for handling private key memory operations and new control signals for power2round.
    - `src/adamsbridge_top/rtl/adamsbridge_top.sv`: Integrated power2round module and updated auxiliary function connections.
    - `src/adamsbridge_top/rtl/abr_ctrl_pkg.sv`: Defined new constants and memory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
2024-08-28 Merged PR 202884: Rename ABR/Adamsbridge/Dilithium to mldsa
    Code cleanup and renaming.
    This pull request renames parameters and modules from `ABR`/`Adamsbridge`/`Dilithium` to `mldsa` across the entire design.
    - Removed `adamsbridge_top` module in `src/adamsbridge_top/rtl/adamsbridge_top.sv`.
    - Renamed parameters and modules to `mldsa` in the design.
    Related work items: #754661, #762446, #764991
    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
    [interfaces.csv]
2024-08-29 Merged PR 203513: Updated algorithm for FIPS requirements
    - updating KeyGen to latest spec, adding K and L to seed expansion
    - generated file lists
    - debug prints for ref model verify
    Algorithm update to meet FIPS requirements.
    This pull request updates the algorithm to comply with FIPS requirements, including changes to message formatting and hardware updates for signing and verifying.
    - Added multiple include directories and source files in `src/mldsa_top/uvmf/config/uvmf_mldsa.vf` to support the new algorithm.
    - Updated message formatting to include a pre-defined prefix and OID as specified in the linked work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
2024-09-05 Merged PR 205046: Optimizing memory sizes
    - memory reduction by reordering sequencer steps to utilize 1 vector at a time where possible
    - keygen and sign flow working unoptimized
    Related work items: #784954
2024-09-07 Merged PR 205414: clean up synthesis errors
    clean up synthesis errors
    flopped addresses for better timing to rams
    Related work items: #767832
    [compile.yml, decompose.sv, decompose_w1_encode.sv, norm_check_ctrl.sv, ntt_ctrl.sv, skdecode_ctrl.sv]
2024-09-09 Merged PR 205404: Add notif interrupt
    Valid drives notif intr
    Placeholder for error intr
    New feature
    This pull request introduces a notification interrupt feature and includes some code cleanup.
    - `src/mldsa_top/rtl/mldsa_ctrl.sv`: Added logic to generate notification and error interrupts.
    - `src/mldsa_top/rtl/mldsa_top.sv`: Added output logic for error and notification interrupts.
    - `src/ntt_top/tb/ecc_ram_tdp_file.sv`: Removed the file.
    - `src/ntt_top/tb/ntt_ram_tdp_file.sv`: Renamed and modified from `ecc_ram_tdp_file.sv`.
    - `src/ntt_top/tb/ntt_wrapper.sv` and `src/ntt_top/utb/ntt_utb_top/ntt_utb_top.sv`: Upd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
    [compile.yml, ntt_ram_tdp_file.sv, ntt_utb_top.sv, ntt_wrapper.sv]
2024-09-11 Merged PR 206688: regression yml file
    regression yml file
    New feature to support UVM test cases in nightly regression.
    This pull request introduces YAML files and updates to support running UVM test cases for ABR in nightly regression.
    - Added `mldsa_top_nightly_random_regression.yml` to define test generation parameters and templates.
    - Updated `mldsa_scoreboard.svh` to display pass/fail status based on mismatch count.
    - Added `ML_DSA_randomized_verif_test.yml` to specify test parameters and plusargs for randomized verification tests.
    Related work items: #794397
    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
    [uvmf_mldsa_cm_hier.cfg]
2024-09-11 Merged PR 206747: added .exe suffix
    added .exe suffix
    Bug fix to ensure executables run correctly by adding the `.exe` suffix.
    This pull request addresses a regression issue by adding the `.exe` suffix to executable files to ensure they run correctly.
    - Modified `src/mldsa_top/uvmf/uvmf_template_output/project_benches/mldsa/tb/sequences/src/ML_DSA_randomized_key_gen_and_sign_sequence.svh` to add `.exe` suffix to the `test_dilithium5` command.
    - Updated `src/mldsa_top/uvmf/config/compile.yml` to copy `.exe` files during the pre-execution phase.
    - Updated `src/mldsa_top/uvmf/uvmf_template_output/verification_ip/en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
    [compile.yml]
2024-09-11 Merged PR 206767: chmod and .exe suffix change
    Code update to modify executable file handling.
    This pull request updates the handling of executable files by adding a command to print the current working directory.
    - `src/mldsa_top/uvmf/uvmf_template_output/project_benches/mldsa/tb/sequences/src/ML_DSA_randomized_key_gen_and_sign_sequence.svh`: Added a system call to print the current working directory before executing the key generation process.
    Related work items: #794485
    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
2024-09-11 Merged PR 206775: Update compile
    Update compile
    Bug fix to correct file paths in the compile configuration.
    This pull request updates the compile configuration to fix incorrect file paths for executable files.
    - `src/mldsa_top/uvmf/config/compile.yml`: Corrected the paths for `test_dilithium5` and `test_dilithium5_debug` executables.
    Related work items: #794512
    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
    [compile.yml]
2024-09-12 Merged PR 206998: Norm check last_poly last_addr bug fix
    1. Move done flag to 1 cycle later to make sure we capture invalid that toggles on the last addr of the last poly
    2. yml fix
    Bug fix
    This pull request addresses a bug where the invalid flag in the norm check module was not being set properly when the last poly was found to be invalid.
    - `src/norm_check/rtl/norm_check_top.sv`: Added logic to ensure `norm_check_done` is correctly set and not reset prematurely.
    - `src/mldsa_top/uvmf/uvmf_template_output/project_benches/mldsa/tb/tests/src/ML_DSA_randomized_verif_test.yml`: Updated test name to `ML_DSA_randomiz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
    [norm_check_top.sv]
2024-09-12 Merged PR 207046: defined macro for ram replacement
    - fixing ifdefs in prim package
    - replacing ram names with macro for integrator to update
    Code cleanup to use macros for RAM module names.
    This pull request defines a macro for the RAM module name to allow integrators to easily swap in their own modules.
    - `src/abr_prim/rtl/abr_prim_assert.sv`, `src/abr_prim/rtl/abr_prim_assert_sec_cm.svh`, `src/abr_prim/rtl/abr_prim_buf.sv`, `src/abr_prim/rtl/abr_prim_flop.sv`, `src/abr_prim/rtl/abr_prim_flop_en.sv`, `src/abr_prim/rtl/abr_prim_flop_macros.sv`: Updated macro definitions to use `ABR_` prefix.
    - `src/mldsa_top/rt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
    [abr_prim_assert.sv, abr_prim_flop_en.sv, abr_prim_flop_macros.sv]
2024-09-13 Merged PR 207156: ABR now has its own AHB_QVIP params pkg
    ABR now has its own AHB_QVIP params pkg
    New feature: ABR now has its own AHB_QVIP parameters package to remove dependency on caiptra-rtl's libraries.
    This pull request introduces a new AHB_QVIP parameters package for ABR, eliminating the dependency on caiptra-rtl's libraries and addressing the AHB bus width issue.
    - Added `ahb_lite_slave_0_config_policy.svh` for AHB Lite slave configuration.
    - Added `hdl_qvip_ahb_lite_slave.sv` for AHB Lite slave module definition.
    - Updated `Makefile` to include new configuration and source files for simulation and compi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
    [compile.yml, qvip_ahb_lite_slave_params_pkg.sv]
2024-09-13 Merged PR 207425: verbosity change
    verbosity change
    Code modification to adjust verbosity levels for logging.
    This pull request increases the verbosity level of specific log messages to address the issue of large UVM logs.
    - `mldsa_predictor.svh`: Changed verbosity level from `UVM_NONE` to `UVM_HIGH` for various register skip messages.
    - `ML_DSA_randomized_all_sequence.svh`: Updated verbosity level from `UVM_LOW` to `UVM_HIGH` for `MLDSA_STATUS` read messages.
    - `mldsa_scoreboard.svh`: Adjusted verbosity level from `UVM_NONE` to `UVM_HIGH` for certain scoreboard messages.
    - `compile.yml`: Added a global UVM verb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
    [compile.yml]
2024-09-23 Merged PR 210199: fixing bug in sigdecode that causes the block to hang when there is an empty...
    fixing bug in sigdecode that causes the block to hang when there is an empty poly
    Related work items: #798995
    [sigdecode_h_ctrl.sv]
2024-09-25 User/dev/michnorris/abr sync 925 (#2)
    * Merged PR 207156: ABR now has its own AHB_QVIP params pkg
    - Updated `Makefile` to include new c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
    [compile.yml, decompose.sv, decompose_tb.sv, qvip_ahb_lite_slave_params_pkg.sv, sigdecode_h_ctrl.sv]
2024-09-30 Enabling github actions to stamp repo from internal flows (#3)
    - Updated `M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
    [mem_agent.sv, mem_agent_config.sv, mem_driver.sv, mem_if.sv, mem_mon.sv, mem_seq_lib.sv, mem_sequencer.sv, mem_txn.sv]
2024-10-07 User/dev/kupadhyayula/rename config (#7)
    - Updated `Makefile` to include ne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
    [abr_icg.sv, compile.yml, exp_mask_tb.sv]
2024-10-08 fixed mult reduction adder (#8)
    * fixed mult reduction adder
    * added header
    * randomized tb
    ---------
    [compile.yml]
2024-10-18 User/dev/michnorris/gc fixes merge pr (#10)
    * Moved most of SK to ram
    * testing sample buffer opt
    * updating registers with priority encodings to enforce mutex
    * moving sig z to memory
    * fixing bug in sig h
    * pubkey mem implementation
    * fixing mem inst name
    * fixed the read/wr access based on valid/ready for api memories
    * experimenting with single piso
    * fixing merge
    * MICROSOFT AUTOMATED PIPELINE: Stamp 'user/dev/michnorris/gc_fixes_merge_pr' with updated timestamp and hash after successful run
    * fixing rdl script to use correct environment variable
    * MICROSOFT AUTOMATED PIPELINE: Stamp 'user/dev/michnorris/gc_fixes_merge_pr' with updated timestamp and h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
    [abr_1r1w_512x4_ram.sv, abr_1r1w_be_ram.sv, abr_piso.sv, compile.yml, power2round_top.sv, skdecode_ctrl.sv, skdecode_top.sv]
2024-10-23 fixed corner case for w1 decompose (#17)
    * fixed corner case for w1 decompose
    * MICROSOFT AUTOMATED PIPELINE: Stamp 'user/dev/mojtabab/verify_bug' with updated timestamp and hash after successful run
    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
    [decompose.sv, decompose_r1_lut.sv]
2024-10-23 Fixing unit level benches and adding promote regression (#15)
    * updating abr piso so unit testbenches don't break
    adding promote regression to be used by internal pipeline
    * MICROSOFT AUTOMATED PIPELINE: Stamp 'user/dev/michnorris/abr_promote_regress' with updated timestamp and hash after successful run
    * MICROSOFT AUTOMATED PIPELINE: Stamp 'user/dev/michnorris/abr_promote_regress' with updated timestamp and hash after successful run
    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
    [compile.yml, uvmf_mldsa_top_promote_regression.yml]
2024-10-24 Split zeta/zeta_inv (#19)
    * Split zeta/zeta_inv wires to individual values for better maintenance in twiddle lookup
    * MICROSOFT AUTOMATED PIPELINE: Stamp 'user/dev/mojtabab/zeta' with updated timestamp and hash after successful run
    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
2024-10-31 User/dev/ekarabulut/normcheck shuf (#23)
    * added randomness without shuffling enable control
    * added shuffling enable
    * connected randomness at the top level
    * fixed lint checker error
    * MICROSOFT AUTOMATED PIPELINE: Stamp 'user/dev/ekarabulut/normcheck_shuf' with updated timestamp and hash after successful run
    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
    [norm_check_ctrl.sv, norm_check_defines_pkg.sv, norm_check_tb.sv, norm_check_top.sv]
2024-10-31 Caliptra keyvault interface hooks (#25)
    * adding kv interface pragmas
    * keyvault hooks for caliptra integration
    * fixing reg gen script to see kv defines
    * MICROSOFT AUTOMATED PIPELINE: Stamp 'user/dev/michnorris/kv_inf' with updated timestamp and hash after successful run
    * MICROSOFT AUTOMATED PIPELINE: Stamp 'user/dev/michnorris/kv_inf' with updated timestamp and hash after successful run
    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
    [compile.yml, uvmf_mldsa_top_promote_regression.yml]
2024-10-31 User/dev/kupadhyayula/gh ntt shuffling (#22)
    * Shuffling wip
    * NTT shuffling updates
    * WIP INTT shuffling
    * Add shuffle_en wip
    * shuffling updates for pwo, intt
    * Add shuffle_en (wip)
    * Add shuffle_en input to ntt
    * Remove random input and use lfsr bits
    * Clean up
    * Lint cleanup
    * Fix lint
    * MICROSOFT AUTOMATED PIPELINE: Stamp 'user/dev/kupadhyayula/gh_ntt_shuffling' with updated timestamp and hash after successful run
    * Disable shuffling for now
    * MICROSOFT AUTOMATED PIPELINE: Stamp 'user/dev/kupadhyayula/gh_ntt_shuffling' with updated timestamp and hash after successful run
    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
    [compile.yml, mem_if.sv, mem_txn.sv, ntt_ctrl.sv, ntt_sb.sv, ntt_shuffle_buffer.sv, ntt_top.sv]
2024-11-05 User/dev/michnorris/verilator shuffle buffer fix (#29)
    * re-coded shuffle buffer output to fix verilator issue
    * cleaning up old code that was commented out
    * MICROSOFT AUTOMATED PIPELINE: Stamp 'user/dev/michnorris/verilator_shuffle_buffer_fix' with updated timestamp and hash after successful run
    [ntt_shuffle_buffer.sv]
2024-11-06 fixed makehint comparison bug (#30)
    * fixed makehint comparison bug
    * MICROSOFT AUTOMATED PIPELINE: Stamp 'user/dev/ekarabulut/hintgen_bug_fix' with updated timestamp and hash after successful run
    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
    [hintgen.sv, makehint.sv]
2024-11-12 skdecode error (#33)
    * fixed skdecode tb
    * added random test and error test
    * added skdecode_error and randomized tb
    * MICROSOFT AUTOMATED PIPELINE: Stamp 'mojtaba-msft-skdecode' with updated timestamp and hash after successful run
    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
    [skdecode_s1s2_unpack.sv, skdecode_tb.sv]
2024-11-20 User/dev/kupadhyayula/ntt masking (#39)
    * Masking files - wip
    * Add redux46 file
    * Masked adder, sub, gs, placeholder for mult reduction
    * completed redux46 masking module
    * removed files from merged branch
    * added a filed missing in compile order
    * added license header
    * MICROSOFT AUTOMATED PIPELINE: Stamp 'user/dev/ekarabulut/reduction46_0' with updated timestamp and hash after successful run
    * Masking WIP
    * Integrate into mldsa_top, some temp changes to debug long sim times
    * optimized flip flops for masking logic
    * converted array decl format
    * updated array format of B-sub
    * Fix hybrid interface, update ctrl to incr twiddle
    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
    [compile.yml, ntt_ctrl.sv, ntt_defines_pkg.sv, ntt_hybrid_butterfly_2x2.sv, ntt_top.sv, ntt_top_tb.sv, ntt_wrapper.sv]
2024-11-20 User/dev/kupadhyayula/fix ntt filelist (#40)
    * Fix filelist
    * Remove debug code
    * MICROSOFT AUTOMATED PIPELINE: Stamp 'user/dev/kupadhyayula/fix_ntt_filelist' with updated timestamp and hash after successful run
    [compile.yml, ntt_top_tb.sv, ntt_utb_top.sv, ntt_wrapper.sv]
2024-11-22 flopping mode decode in ntt to help timing/fanout issues (#44)
    * flopping mode decode in ntt to help timing/fanout issues
    * fixing reset copy paste issue due to rushed changes
    * MICROSOFT AUTOMATED PIPELINE: Stamp 'user/dev/michnorris/ntt_timing' with updated timestamp and hash after successful run
    [ntt_top.sv]
2024-11-26 Fix compilespecs.yml (#47)
    * Avoid '-' character in lib name
    * Update uvm_lib to mldsa_uvm_lib, generate missing file-lists
    * MICROSOFT AUTOMATED PIPELINE: Stamp 'cwhitehead-msft-compilespec-name' with updated timestamp and hash after successful run
    [compile.yml]
2024-12-04 User/dev/kupadhyayula/masking fixes (#49)
    * added masked pwm intt opcode
    using pwm intt masked opcode in sequencer
    * Enable masking for pwm_intt op
    * Revert vf change
    * MICROSOFT AUTOMATED PIPELINE: Stamp 'user/dev/kupadhyayula/masking_fixes' with updated timestamp and hash after successful run
    * PR suggestions
    * Rename param for clarity
    * MICROSOFT AUTOMATED PIPELINE: Stamp 'user/dev/kupadhyayula/masking_fixes' with updated timestamp and hash after successful run
    * MICROSOFT AUTOMATED PIPELINE: Stamp 'user/dev/kupadhyayula/masking_fixes' with updated timestamp and hash after successful run
    ---------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
    [ntt_ctrl.sv, ntt_hybrid_butterfly_2x2.sv, ntt_top.sv, ntt_top_tb.sv, ntt_twiddle_lookup.sv, ntt_wrapper.sv]
2024-12-12 Masking cleanup (#53)
    * Fix two share mult, clean up latency params
    * Add input flops to shares, refresh shares before INTT, optimize twiddle reg, adjust delays
    * Fix delay in pwm
    * Remove w_delay, lint fixes
    * MICROSOFT AUTOMATED PIPELINE: Stamp 'user/dev/kupadhyayula/masking_cleanup' with updated timestamp and hash after successful run
    * Parameterize delays
    * MICROSOFT AUTOMATED PIPELINE: Stamp 'user/dev/kupadhyayula/masking_cleanup' with updated timestamp and hash after successful run
    * Use different random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
    [ntt_ctrl.sv, ntt_defines_pkg.sv, ntt_hybrid_butterfly_2x2.sv]
2024-12-12 mldsa coverage and val tests (#51)
    * added error flag to ctrl
    * added mldsa coverage
    * updated vf lists
    * fixed typo
    * MICROSOFT AUTOMATED PIPELINE: Stamp 'mojtaba-mldsa-val' with updated timestamp and hash after successful run
    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
    [mldsa_cm_hier.cfg]
2024-12-17 Put hybrid wire in separate always statement (#61)
    * Put hybrid wire in separate always statement
    * MICROSOFT AUTOMATED PIPELINE: Stamp 'user/dev/kupadhyayula/fix_always_block_verilator' with updated timestamp and hash after successful run
    [ntt_top.sv]
2025-01-02 mldsa pcr signing (#63)
    * added pcr
    * fixed pcr connection
    * MICROSOFT AUTOMATED PIPELINE: Stamp 'mojtaba-mldsa-pcr' with updated timestamp and hash after successful run
    * locked api for pcr flow
    * MICROSOFT AUTOMATED PIPELINE: Stamp 'mojtaba-mldsa-pcr' with updated timestamp and hash after successful run
    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
2025-01-08 Formal review items (#65)
    * adding busy signal output to mldsa top
    * cleaning up work items
    * qualifying and using skencode error as assertion
    msg interface fsm doesn't unconditionally move on held last msg
    * MICROSOFT AUTOMATED PIPELINE: Stamp 'user/dev/michnorris/misc_workitems' with updated timestamp and hash after successful run
    * fixing busy signal to use only ready, zeroize pr will sync this properly
    * fixing typo in merge
    * MICROSOFT AUTOMATED PIPELINE: Stamp 'user/dev/michnorris/misc_workitems' with updated timestamp and hash after successful run
    [skencode.sv]
2025-01-23 export ABR SRAMs to an external module (#74)
    * exported srams from abr to top level module
    * fixed inst output for reset condition (#72)
    * added ExternalMu support (#70)
    * added ExternalMu support
    * removed hw write access to mu api
    * moved external_mu reg before memory api
    * MICROSOFT AUTOMATED PIPELINE: Stamp 'external_mu' with updated timestamp and hash after successful run
    * MICROSOFT AUTOMATED PIPELINE: Stamp 'external_mu' with updated timestamp and hash after successful run
    * updating file lists
    * adding debug unlock port to zeroize engine for caliptra
    Co-auth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
    [compile.yml]
2025-01-31 aligning msg fsm to msg interface better (#79)
    * aligning msg fsm to msg interface better
    state won't transition to function start until the entire message has been sent
    * fixing a typo in the sample offset values for pk
    * fixing privatekey read so that it unlocks for keygen process
    * MICROSOFT AUTOMATED PIPELINE: Stamp 'user/dev/michnorris/msg_fsm_fix' with updated timestamp and hash after successful run
    [uvmf_mldsa_top_promote_regression.yml]
2025-02-12 Fixup UVM assertion reporting for 1.1d compatibility (#92)
    * Fixup UVM assertion reporting for 1.1d compatibility
    * MICROSOFT AUTOMATED PIPELINE: Stamp 'cwhitehead-msft-uvm-assert-fixups' with updated timestamp and hash after successful run
    [abr_prim_assert.sv]
2025-02-14 misc fpv fixes (#88)
    * holding msg data if msg inf is stalled
    changed keccak to always drive ready low if it isn't ready
    changed keccak pad to start keccak even if receiving a partial in the same clock cycle
    * MICROSOFT AUTOMATED PIPELINE: Stamp 'user/dev/michnorris/fpv_fix' with updated timestamp and hash after successful run
    * Fixup UVM assertion reporting for 1.1d compatibility (#92)
    * Updated spec in md format (#91)
    * converted spec to md format
    * changed the format
    * updated images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
    [abr_sha3.sv, abr_sha3pad.sv]
2025-02-21 Fix NTT sampler_valid and done signal issues (#101)
    * Flop ntt_done
    * Fix sampler valid bug
    * Uncomment
    * MICROSOFT AUTOMATED PIPELINE: Stamp 'user/dev/kupadhyayula/ntt_done_trial' with updated timestamp and hash after successful run
    [ntt_ctrl.sv, ntt_top.sv, ntt_top_tb.sv]
2025-02-28 lint clean-up (#109)
    * fixed sampler_ntt_dv width mismatch
    * fixed pubkey_ram_wstrobe width mismatch
    * fixed sigencode_z_unit/opb1 width mismatch
    * fixed sigdecode_z_unit/opb1 width mismatch
    * added default to unique case statement
    * MICROSOFT AUTOMATED PIPELINE: Stamp 'mojtaba-lint' with updated timestamp and hash after successful run
    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
    [sigdecode_z_unit.sv, sigencode_z_unit.sv]
2025-03-01 fixed Unsized number (#111)
    * fixed Unsized number
    * MICROSOFT AUTOMATED PIPELINE: Stamp 'mojtaba-unsized_number' with updated timestamp and hash after successful run
    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
    [sigdecode_z_unit.sv, sigencode_z_unit.sv]
2025-03-02 User/dev/michnorris/sigdecode h error (#112)
    * defined a new error condition
    * cleaning up fixmes
    jumping out of verify early if we see it fail
    * MICROSOFT AUTOMATED PIPELINE: Stamp 'user/dev/michnorris/sigdecode_h_error' with updated timestamp and hash after successful run
    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
    [sigdecode_h.sv, sigdecode_h_ctrl.sv]
2025-03-04 Sigdecode error conditions (#116)
    * Add error condition
    * Optimize zero byte check, add test to regression
    * MICROSOFT AUTOMATED PIPELINE: Stamp 'user/dev/kupadhyayula/sigdecode_error_conditions' with updated timestamp and hash after successful run
    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
    [sigdecode_h.sv, sigdecode_h_ctrl.sv, sigdecode_h_tb.sv]
2025-03-04 added max hintsum check (#117)
    * added max hintsum check
    * Fix for loop limit
    * increased h failure regression
    * MICROSOFT AUTOMATED PIPELINE: Stamp 'mojtaba-hint' with updated timestamp and hash after successful run
    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
    [sigdecode_h.sv]
2025-03-06 Release spec (#119)
    [AdamsBridge_TestPlan.xlsx]
2025-03-06 fixed sig_decode fsm due to hintsum_max error (#122)
    * updated hint rules
    * updated max condition
    * fixed sig_decode fsm due to hintsum_max error
    * Fix priority in fsm states
    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
    [sigdecode_h_ctrl.sv]
2025-04-26 Variable length message feature (#137)
    * Variable length message implementation
    Command line test option for verify sequence for ctx and streaming msg
    Documentation for ctx and streaming message mode registers
    * update spec for ctx and external_mu
    * update reg gen script with --cov switch to generate coverage on demand
    add new verif KAT test that streams msg
    * variable message length bugfix
    API register data swizzling
    * updating predictor to work with fixed endianness API inputs
    * update all vf files
    disable stream msg mode for verif random sequence
    * fix for lint in context logic
    enable lint waiver
    * MICROSOFT AUTOMATED PIPELINE: Stamp 'user/dev/michnorris/variable_msg' with update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
    [abr_msg_buffer.sv, compile.yml]
2025-04-26 [VAL] Variable length message support in UVM env (#139)
    * MICROSOFT AUTOMATED PIPELINE: Stamp 'user/dev/michnorris/variable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
    [compile.yml]
2025-05-09 [RTL] Ay masking updates (#134)
    * Ay masking updates - wip
    * More fixes
    * expand memory instance 3 to support masked data storage
    remove pwm intt combined opcode
    * Integrate top level changes, some fixes, temp define
    * Temp fixes
    * More fixes
    * More clean up
    * Optimize pwm instances
    * File list updates
    * File list updates
    * Revert file name, remove commented out code
    * add parameter for masked memory instance
    add parameter for number of ntt
    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
    [ntt_ctrl.sv, ntt_defines_pkg.sv, ntt_hybrid_butterfly_2x2.sv, ntt_top.sv, ntt_top_tb.sv, ntt_wrapper.sv]
2025-05-15 mlkem rej sampler implementation (#143)
    * mlkem rej sampler implementation
    * updating file list for rej sampler changes
    * MICROSOFT AUTOMATED PIPELINE: Stamp 'user/dev/michnorris/kyber_rej_sampler' with updated timestamp and hash after successful run
    * add spec clarification for verification results when the verification fails
    [abr_sha3.sv, compile.yml, mldsa_rej_sampler.py, mldsa_rej_sampler_tb.sv, mlkem_rej_sampler.py, mlkem_rej_sampler_tb.sv]
2025-05-19 Update RTL hierarchy to better align with addition of ML-KEM (#147)
    * change mldsa_sampler to abr_sampler to better align with upcoming mlkem addition
    * rename mldsa_top to abr_top to accomodate addition of mlkem
    * renaming mldsa_reg to abr_reg to align with new hierarchy for mlkem addition
    * renaming mldsa_mem logic to abr_mem logic to align with new hiearchy and addition of MLKEM
    * rename param pkg to align with abr hierarchy and addition of mlkem
    * renaming mldsa_ctrl to abr_ctrl to align with new hieararchy with addition of MLKEM
    * consolidate all mldsa functions to one sequencer
    * add mlkem registers to the address map
    * update file lists
    * fix compile yml name
    * update sequen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
    [abr_cm_hier.cfg, interfaces.csv, mldsa_cm_hier.cfg, uvmf_mldsa_cm_hier.cfg]
2025-05-20 [RTL] fix for bug in controller (#149)
    * fix for bug in controller
    with 1 ntt the controller was using the wait state to wait for conflicts in accessing the ntt block
    certain timing conditions could cause the controller to skip over an instruction in this state or to load multiple messages into the keccak while waiting for the ntt
    added a dedicated stall state to go to when ntt is unavailable
    * MICROSOFT AUTOMATED PIPELINE: Stamp 'user/dev/michnorris/ctrl_bugfix' with updated timestamp and hash after successful run
    [abr_ctrl.sv, abr_ctrl_pkg.sv]
2025-05-23 add cbd sampler implementation for MLKEM (#151)
    * add cbd sampler implementation for MLKEM
    update file lists to include cbd sampler
    update variable piso to be better parameterized
    instantate cbd sampler into sampler top
    * fix typo in abr sampler rename
    fix cast of rate select in abr piso multi
    * MICROSOFT AUTOMATED PIPELINE: Stamp 'user/dev/michnorris/cbd_sampler' with updated timestamp and hash after successful run
    [abr_params_pkg.sv, abr_piso_multi.sv, abr_sampler_pkg.sv, abr_sampler_top.sv, cbd_sampler.py, cbd_sampler.sv, cbd_sampler_ctrl.sv, cbd_sampler_tb.sv]
2025-06-17 ML-KEM KeyGen feature with KAT (#154)
    * added barrett_reduction for ML-KEM
    fix elab issue due to old module name
    * using masked memory inst param in more places
    * update max depth param to match new max depth
    * Remove redundant branches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
    [abr_add_sub_mod.sv, abr_ctrl.sv, abr_ctrl_pkg.sv, abr_ntt_add_sub_mod.sv, abr_ntt_add_sub_mod_tb.sv, abr_params_pkg.sv, abr_sampler_pkg.sv, abr_sampler_top.sv]
2025-06-23 [RTL] ML-KEM Encaps flow and KAT (#155)
    * ML-KEM Encaps implementation
    Decompress aux block
    ML-KEM Encaps KAT
    * lint clean up
    * fix use of mldsa valid for mlkem process after refactor
    * fixing the lint fixes
    * MICROSOFT AUTOMATED PIPELINE: Stamp 'user/dev/michnorris/mlkem_encaps_seq' with updated timestamp and hash after successful run
    * fixed bug in decompress block
    Decaps flow complere - missing implicit rejection for mismatch cipher
    Decaps KAT test
    * add decaps test to promote
    * MICROSOFT AUTOMATED PIPELINE: Stamp 'user/dev/michnorris/mlkem_encaps_seq' with updated timestamp and hash after successful run
    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
    [abr_ctrl.sv, abr_ctrl_pkg.sv, abr_params_pkg.sv, abr_seq.sv, abr_top.sv]
2025-06-25 [RTL] ABR Refactoring and Issue Clean Up (#156)
    * update mlkem keygen kat to read EK also
    refactor abr ctrl code to utilize a single scratch register space for intermediate computed values
    * fix gh issue #62
    * fix gh issue #107
    * remove done signal to avoid confusion - zeroize will reset/terminate any flow
    remove assume properties
    fix gh issues #128 and #126
    * remove todo
    * MICROSOFT AUTOMATED PIPELINE: Stamp 'user/dev/michnorris/mlkem_refactor' with updated timestamp and hash after successful run
    * keygen decaps flow functionality
    self checking test for keygen/decaps flow
    * MICROSOFT AUTOMATED PIPELINE: Stamp 'user/dev/michnorris/mlkem_refactor' with updated timestamp and hash after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
    [abr_ctrl.sv, abr_ctrl_pkg.sv, abr_keccak_2share.sv, abr_keccak_round.sv, abr_sampler_top.sv, abr_sha3.sv, abr_sha3_pkg.sv, abr_sha3pad.sv]
2025-07-07 [RTL] Decapsulation implicit rejection flow (#157)
    * add compare functionality to compress aux block
    use compare functionality to compare decapsulated ciphertext with result of encapsulation flow
    if ciphertexts do not match, the shared secret is overwritten with a rejection value
    * move decaps ciphertext check after end of encaps so that encaps flow can end without running this
    * make shared secret key register external so that reads to it can return zeroes until mlkem operation is complete
    * MICROSOFT AUTOMATED PIPELINE: Stamp 'user/dev/michnorris/implicit_reject' with updated timestamp and hash after successful run
    * fix typo need to use ciphertext id to select ciphertext offset when l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
    [abr_ctrl.sv, abr_ctrl_pkg.sv, abr_seq.sv, abr_top.sv, compress_top.sv]
2025-07-14 [TB] Decapsulation rejection test case and random test (#162)
    * adding keygen decaps combined flow random test
    * adding decaps rejection to do using the wrong ek
    * add test that does random operations in random orders
    * MICROSOFT AUTOMATED PIPELINE: Stamp 'user/dev/michnorris/mlkem_tests' with updated timestamp and hash after successful run
    [compile.yml]
2025-07-18 Add ML-KEM Spec (#135)
    * added ML-KEM API
    * updated ML-KEM spec
    * fixed image
    * fixed image path
    * fixed ref
    * added high-level
    * added TBD
    * fix image path MLDAS -> MLDSA
    * fix some typos
    fix eta value for ML-KEM security levels
    clarify byte encode/decode functions as part of compress/decompress architecture
    update number of rejection samplers
    * replaced doc updates lost in rebase
    * spec clean up
    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
2025-07-25 NTT masking (#172)
    * Remove redundant branches in ternary assignm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
    [abr_ctrl_pkg.sv, abr_params_pkg.sv, abr_seq.sv, abr_sha3pad.sv, compile.yml, ntt_ctrl.sv, ntt_defines_pkg.sv, ntt_hybrid_butterfly_2x2.sv]
2025-07-27 [RTL] Fix verilator build for Caliptra (#173)
    * fix instantiation of piso for verilator, requires dummy params
    fix alwayscomb order for verilator in gs butterfly
    * MICROSOFT AUTOMATED PIPELINE: Stamp 'user/dev/michnorris/verilator_fix' with updated timestamp and hash after successful run
    [decompress_top.sv]
2025-07-30 [RTL][TB] Fix issues in compress, decompress, and input checks (#176)
    * fix gh issue 167
    the write address was not clearing after done, which could cause a second decompress call to terminate immediately
    * fix gh issue 166
    done signal asserts early due to uncovered pipe stages in done calculation
    * rename reset/zeroize states of sequencer with ABR prefix since they are common
    add input check for encaps and decaps flows
    * fix flop coding that was causing synthesis issues
    * correct the decompress change, can't use the 1/5/11 decomp logic for d of 12. Instead just check for out of range inputs and zero them so that compress check will fail
    * add error status result for input check failur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
    [abr_ctrl.sv, abr_ctrl_pkg.sv, abr_piso_multi.sv, abr_seq.sv]
2025-07-30 [DOC] updated rej sampler (#174)
    * updated rej sampler
    * updated rej spec
    * MICROSOFT AUTOMATED PIPELINE: Stamp 'mojtaba_spec' with updated timestamp and hash after successful run
    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
2025-08-01 [RTL] Functional coverage for ML-KEM (#178)
    * clean ek/dk/ct api decode logic
    coverpoints for mlkem input checks and rejection case
    * fix api reg read flop - stale data was left in the flop from last valid read
    add check to mlkem and mldsa tests that ensure reading other API output registers results in zeros
    * MICROSOFT AUTOMATED PIPELINE: Stamp 'user/dev/michnorris/mlkem_cov' with updated timestamp and hash after successful run
    [abr_ctrl.sv, abr_top_cov_if.sv]
2025-08-06 [TB] Missing signal on memory export resp modport (#181)
    * add missing wstrobe port to abr mem if resp modport
    * MICROSOFT AUTOMATED PIPELINE: Stamp 'user/dev/michnorris/abr_mem_if_port' with updated timestamp and hash after successful run
    * [VAL] fixed mlkem uvmf randomized test (#183)
    * added on-the-fly zeroize
    * added MLKEM overwrite cmd test
    * fixed uvmf randomized test
    * MICROSOFT AUTOMATED PIPELINE: Stamp 'mojtaba_mlkem_val' with updated timestamp and hash after successful run
    * MICROSOFT AUTOMATED PIPELINE: Stamp 'user/dev/michnorris/abr_mem_if_port' with updated timestamp and hash after successful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
    [abr_mem_if.sv]
2025-08-07 [RTL][VAL] Update kv macro and test butterfly and Barrett reduction input range (#184)
    * Update inputs to full mlkem range
    * wip tb changes
    * Add mlkem tb for unmasked version
    * Some clean up
    * Parameterize hardcoded widths, add missing hex
    * update abr reg with kv changes from caliptra
    * Update filelist
    * MICROSOFT AUTOMATED PIPELINE: Stamp 'kupadhyayula-mlkem-input-range-tb' with updated timestamp and hash after successful run
    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
    [compile.yml, mlkem_hybrid_bf_tb.sv, ntt_ram_tdp_file.sv, ntt_top_tb.sv, ntt_wrapper.sv]
2025-08-08 update kv read and write clients to utilize ocp lock filtering rules (#186)
    * update kv read and write clients to utilize ocp lock filtering rules
    * MICROSOFT AUTOMATED PIPELINE: Stamp 'user/dev/michnorris/kv_filtering_rules' with updated timestamp and hash after successful run
2025-08-14 [RTL] Add swwe to kv read and write controls for Caliptra (#187)
    * kv read/write control software write enables to prevent access during engine operation
    * include swwe in kv tie offs for non caliptra context
    * MICROSOFT AUTOMATED PIPELINE: Stamp 'user/dev/michnorris/kv_fix' with updated timestamp and hash after successful run
    [abr_ctrl.sv]
2025-08-14 [TB] coverage updates and new tests (#188)
    * removed UVM pkg coverage as it never worked
    add standalone signing test to regression with chance at skdecode failure
    add random reset test to regression for code coverage
    * MICROSOFT AUTOMATED PIPELINE: Stamp 'user/dev/michnorris/cov_fix' with updated timestamp and hash after successful run
    [abr_top_cov_if.sv, compile.yml]
2025-08-19 User/dev/michnorris/cov fix (#190)
    * move kv register back to original address for backwards compatibility with caliptra 2.0
    * ocp lock coverpoints for keyvault read/write scenarios
    * fix zeroize flow so that a pulse clears read flop of srams without colliding with the write flow
    * fix test list typo
    * move bit flip to hit signature h so that sigdecode h can actually fail
    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
    [abr_top.sv, abr_top_cov_if.sv]
2025-08-20 fix zeroize during fatal errors (#193)
    * fix zeroize during fatal errors
    * MICROSOFT AUTOMATED PIPELINE: Stamp 'user/dev/michnorris/zeroize_fix' with updated timestamp and hash after successful run
    [abr_ctrl.sv]
2025-08-20 [TB/RTL] Fix sig h test corner case, move intr block offset (#195)
    * cleaning up todo/fixme
    * fix corner case where sig decode flips a bit in the last byte of the signature which isn't a valid byte so the test passes
    * MICROSOFT AUTOMATED PIPELINE: Stamp 'user/dev/michnorris/sigh_test' with updated timestamp and hash after successful run
    * move intr block back to 0x8100 to maintain backwards compatibility in Caliptra
    * MICROSOFT AUTOMATED PIPELINE: Stamp 'user/dev/michnorris/sigh_test' with updated timestamp and hash after successful run
    [abr_ctrl.sv, abr_sampler_top.sv, abr_top.sv, pkdecode_tb.sv]
2025-08-21 [Lint] fixed Unnamed generate block (#196)
    * fixed Unnamed generate block
    * MICROSOFT AUTOMATED PIPELINE: Stamp 'mojtaba_lint_fix' with updated timestamp and hash after successful run
    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
    [compress_top.sv, decompose.sv, decompress_top.sv, makehint.sv, norm_check_top.sv, power2round_top.sv, skdecode_top.sv]
2025-08-26 Fix verif fail seq, coverage cleanup, and misc issue fix (#198)
    * clean up verif fail sequence
    * remove illegal coverage from mldsa cmd
    add coverage for zeroize after valids
    * remove tied off top level ports from aux blocks
    should help with code coverage and reduce the number of optimized constant flops
    * missing includes for issue 197
    * remove length specified in opcode that doesn't require it
    * MICROSOFT AUTOMATED PIPELINE: Stamp 'user/dev/michnorris/82125_cov_and_tests' with updated timestamp and hash after successful run
    [abr_ctrl.sv, abr_seq.sv, abr_top.sv, abr_top_cov_if.sv, makehint.sv, makehint_tb.sv, norm_check_tb.sv, norm_check_top.sv]
2025-08-29 [RTL] Disable standalone keygen/decaps without zeroize, fix privkey locks (#200)
    * fix assertion for some simulators that might evaluate signals in a different order
    fix standalone keygen/decaps where one could potentially manipulate a key from the kv
    fix private key lock so that it resets even if you don't zeroize
    * MICROSOFT AUTOMATED PIPELINE: Stamp 'user/dev/michnorris/82725_key_vuln' with updated timestamp and hash after successful run
    * mandate zeroize between all operations
    * MICROSOFT AUTOMATED PIPELINE: Stamp 'user/dev/michnorris/82725_key_vuln' with updated timestamp and hash after successful run
    [abr_ctrl.sv]
2025-08-29 [DOC] update release notes and readme for rc tag (#202)
    * update release notes and readme for rc tag
    * Add files via upload
    * Manually stamping after test plan file update
    * Manually stamping after test plan file update
    [AdamsBridge_TestPlan.xlsx]
2025-09-09 [RTL] Remove inferred latch and undriven dead code (#211)
    * remove dead code from old 2 sequencer version
    * refactor compress/decompress to avoid false latch lint violation
    * MICROSOFT AUTOMATED PIPELINE: Stamp 'user/dev/michnorris/latch_fix' with updated timestamp and hash after successful run
    [abr_ctrl.sv, abr_top.sv, compress.sv, decompress.sv]
2025-09-12 removed errorXmldsa_cmd cp (#212)
    * removed errorXmldsa_cmd cp
    * MICROSOFT AUTOMATED PIPELINE: Stamp 'abr_cov' with updated timestamp and hash after successful run
    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
    [abr_top_cov_if.sv]
2025-09-15 added mlkem_valid to reset kv_data_present (#213)
    * added mlkem_valid to reset kv_data_present
    * MICROSOFT AUTOMATED PIPELINE: Stamp 'kv_data_reset' with updated timestamp and hash after successful run
    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
    [abr_ctrl.sv]
2025-09-20 [RTL] Explicitly cast signals in port list for lint fix, qualify idle signal with valid (#217)
    * qualifying idle condition with valid reg so that we don't keep busy asserted while waiting for zeroize
    * casting mismatched widths to explicitly zero extend them
    gh issue 214
    * MICROSOFT AUTOMATED PIPELINE: Stamp 'user/dev/michnorris/issue_fix' with updated timestamp and hash after successful run
    [abr_ctrl.sv, abr_top.sv, ntt_butterfly.sv, ntt_hybrid_butterfly_2x2.sv]
2025-10-03 [RTL] Fix bug 227, only reset kv data present bits on mandatory zeroize (#228)
    * only reset kv data present bits on mandatory zeroize
    * MICROSOFT AUTOMATED PIPELINE: Stamp 'user/dev/michnorris/sharedkey_kv_fix' with updated timestamp and hash after successful run
    [abr_ctrl.sv]
2025-11-10 [RTL] Add parameters to disable masking and adjust SRAM latencies (#233)
    * add parameter at abr_top to enable/disable masking - default enabled
    * WIP SRAM pipeline
    * SRAM pipeline feature WIP
    * key gen and verify passing with 2 cycle latency sram
    * decaps passing with sram latency 2
    * fix decaps after keygen fix broke it
    * fixed bugs in makehint and skdecode from hard coded latencies
    setting params for new duts in top level tb
    * fix makehint bug
    last poly was triggering early and missing a potential hint in the last clock
    * validating 1 clock laten
    * mask disable and sram latency params regress clean on all 4 configurations
    * fix module instance name in power 2 round
    * update file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
    [abr_ctrl.sv, abr_ctrl_pkg.sv, abr_mem_top.sv, abr_params_pkg.sv, abr_piso_multi.sv, abr_rd_lat_buffer.sv, abr_sampler_top.sv, abr_sha3pad.sv]
2025-11-12 [RTL] Replace define name, optimize zeriozation logic, sib memory and clean up (#236)
    * addresses issue 231
    replace ABR_SIMULATION with SIMULATION to be consistent in Caliptra implementation
    * addresses issue 224 removing redundant leg of the external mu mode flop
    * addresses issue 226
    Sets each memory write enable for zeroization only until the address reaches their depth
    Adds assertions to sram models to detect writes and reads > than depth
    * issue 219
    sib mem was being highly optimized by synthesis due to constant 0s
    encoding the 3 possible values as 2 bits does even better and won't cause high constant prop warnings
    * switch compression read buffer from sample buffer to multi rate pi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
    [abr_1r1w_be_ram.sv, abr_1r1w_ram.sv, abr_ctrl.sv, abr_prim_flop_macros.sv, abr_prim_lfsr.sv, abr_prim_sparse_fsm_flop.sv, abr_sampler_top.sv, abr_top.sv]
2025-12-11 [RTL] Lint fixes for enhanced ruleset (#248)
    * update stream msg KAT to disable scoreboard and rely on self checking
    update stream msg KAT to set STROBE back to 0xF at the start of each KAT
    * fix new lint rules - mostly makes code less ambiguous
    genvar and int with the same name in the same module
    use unsigned ints for loop iterators, particularly where logic is compared with the loop iterator value
    fully cover enums in case statements
    remove range select on iterators
    remove unset output ports
    * MICROSOFT AUTOMATED PIPELINE: Stamp 'user/dev/michnorris/lint_updates' with updated timestamp and hash after successful run
    [abr_ctrl.sv, abr_ctrl_pkg.sv, abr_params_pkg.sv, abr_piso_multi.sv, abr_rd_lat_buffer.sv, abr_sampler_top.sv, abr_sha3.sv, abr_sha3_pkg.sv]
2026-02-25 [RTL] fix skdecode and compression errors (#259)
    * log compare and skdecode errors on done only so that memory reads/writes don't run away
    * missing bitwise OR on multi-bit set signal
    * MICROSOFT AUTOMATED PIPELINE: Stamp 'user/dev/michnorris/mem_overflow' with updated timestamp and hash after successful run
    [compress_top.sv, skdecode_ctrl.sv, skdecode_top.sv]
2026-03-03 [RTL] MLKEM seed swapping and MLDSA buffer zeroize (#257)
    * mlkem_kv swap
    * added zeroize to stream_msg buffer
    * tie off the pcr_extend swwe to 0
    * updated version
    * MICROSOFT AUTOMATED PIPELINE: Stamp 'mlkem_seed_swap' with updated timestamp and hash after successful run
    * updated version to 2.0.1
    * MICROSOFT AUTOMATED PIPELINE: Stamp 'mlkem_seed_swap' with updated timestamp and hash after successful run
    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
    [abr_ctrl.sv, abr_msg_buffer.sv, abr_params_pkg.sv]
2026-03-04 [RTL] Fix lint violation in the ifdef CALIPTRA code (#265)
    * fixed lint issue
    * MICROSOFT AUTOMATED PIPELINE: Stamp 'fix_lint' with updated timestamp and hash after successful run
    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
    [abr_ctrl.sv]
2026-03-04 [RTL] fixed verilator failure (#267)
    * fixed verilator failure
    * MICROSOFT AUTOMATED PIPELINE: Stamp 'fix_verilator_widthconcat' with updated timestamp and hash after successful run
    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
    [abr_ctrl.sv]
2026-03-11 [RTL] Fix issue 270 KV write ready not used to lock register (#271)
    * utilize kv write client ready signal to de-assert ready to lock write control register
    * MICROSOFT AUTOMATED PIPELINE: Stamp 'user/dev/michnorris/abr_kv_fix' with updated timestamp and hash after successful run
    [abr_ctrl.sv]
2026-03-24 [RTL/Val] clear kv ctrl reg with zeroize + add all-zero KV seed detection + ACVP rejection KATs (#255)
    * Erased KV ctrl/status reg with zeroize
    * MICROSOFT AUTOMATED PIPELINE: Stamp 'zeroize_kv_ctrl_reg' with updated timestamp and hash after successful run
    * MICROSOFT AUTOMATED PIPELINE: Stamp 'zeroize_kv_ctrl_reg' with updated timestamp and hash after successful run
    * Add KV zero-data error detection for ABR seeds and msg
    * Add KV zero-error coverpoints and cross coverage
    * Add ACVP ML-DSA-87 rejection path KAT test (#242)
    * Fix kv_mlkem_msg_nonzero declaration scope for non-CALIPTRA builds
    * MICROSOFT AUTOMATED PIPELINE: Stamp 'zeroize_kv_ctrl_reg' with updated timestamp and hash af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
    [abr_ctrl.sv, abr_top_cov_if.sv]
2026-04-22 Adding missing include statements causing synthesis errors (#251)
    * Adding missing include statements causing synthesis errors
    * Add missing header includes in source files
    * Add header include for assert macros in SV files generated from RDL
    * Regenerate abr_reg to add assert header include
    * Rename mldsa_sampler_pkg to abr_sampler_pkg
    * Regenerate file-lists
    * MICROSOFT AUTOMATED PIPELINE: Stamp 'ravthaku-amd-synth-errors' with updated timestamp and hash after successful run
    * MICROSOFT AUTOMATED PIPELINE: Stamp 'ravthaku-amd-synth-errors' with updated timestamp and hash after successful run
    * MICROSOFT AUTOMATED PIPELINE: Stamp 'ravthaku-amd-synth-errors' with updated timestamp an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
    [abr_icg.sv, abr_msg_buffer.sv, abr_piso_multi.sv, abr_sampler_top.sv, abr_sha3_tb.sv, compile.yml, exp_mask_tb.sv]
2026-06-12 [COV] Fix nightly regression (#280)
    * [BUG FIX] Fix VCS partcomp enum-scope mismatch in abr_top_cov_if
    * MICROSOFT AUTOMATED PIPELINE: Stamp 'user/mojtabab/fix-cov-if-enum-scope-mismatch' with updated timestamp and hash after successful run
    [abr_top_cov_if.sv]
2026-06-22 [DOC] Document mandatory ZEROIZE between operations in MLDSA/MLKEM flows (#276) (#283)
2026-06-24 [RTL] Zero-overhead masking via RECOMBINE fusion into downstream consumers (#282)
    * fuse RECOMBINE into MLKEM_DECAPS PWS
    * drop fused-PWS NOP slot in MLKEM_DECAPS
    * fuse RECOMBINE into 8 MLDSA SIGN PWS sites (NOP-swap)
    * compact MLDSA SIGN fused-PWS NOP slots (-8 rows)
    * wire PWA_R consumer-recombine path (dormant, reuses PWS_R pwm_b mux)
    * wire NORMCHK_R consumer-recombine path (dormant, reuses shared recombiner)
    * fuse RECOMBINE into 8 MLDSA KG PWA sites (NOP-swap)
    * compact MLDSA KG fused-PWA NOP slots (-8 rows)
    * SIGENCODE_R dual-recombiner dormant plumbing
    * atomic RECOMBINE+NORMCHK+SIGENCODE -> NOP+NORMCHK_R+SIGENCODE_R fusion (7 sites)
    * compact 7 NOP rows in MLDSA_SIGN_VALI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
    [abr_ctrl.sv, abr_ctrl_pkg.sv, abr_params_pkg.sv, abr_recombiner.sv, abr_seq.sv, abr_top.sv, abr_top_cov_if.sv, compile.yml]
2026-07-01 [RTL] Fix VCS DTIE/DTIIO build error and remove unused ntt_random_en (#286)
    * [RTL] Cast SCA recombine_en enum compares to packed logic to fix VCS DTIE/DTIIO
    * [RTL] Remove unused ntt_random_en signal
    * MICROSOFT AUTOMATED PIPELINE: Stamp 'user/mojtabab/cov-if-dtie-fix' with updated timestamp and hash after successful run
    [abr_top.sv, abr_top_cov_if.sv]
2026-07-20 [RTL][DOC] decompose_usehint prime widen (#210) + MakeHint figure fix (#95) (#290)
    * [RTL][BUG FIX] decompose_usehint: widen prime to 5 bits (issue #210)
    * [DOC] Fix MakeHint figures: middle comparator > to >= (issue #95)
    * MICROSOFT AUTOMATED PIPELINE: Stamp 'user/mojtabab/fix-usehint-prime-truncation' with updated timestamp and hash after successful run
    [decompose_usehint.sv]
2026-07-30 [RTL] Masked Keccak (#293)
    * update keccak round and keccak 2share with latest OT implementation
    add masking enabled keccak and masked keccak opcodes
    remove cshake from sha3 implementation
    * fix bad merge
    fix sha3 masking disable version - elab issues
    * fix lint - missing gen block name
    * MICROSOFT AUTOMATED PIPELINE: Stamp 'user/dev/michnorris/masked_keccak' with updated timestamp and hash after successful run
    * extra shake operation for seeding LFSR bits
    remove unused masked keccak ports
    use primitive for splitting message
    * MICROSOFT AUTOMATED PIPELINE: Stamp 'user/dev/michnorris/masked_keccak' with updated timestamp and hash after successful run
    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
    [abr_ctrl.sv, abr_ctrl_pkg.sv, abr_keccak_2share.sv, abr_keccak_round.sv, abr_prim_dom_and_2share.sv, abr_prim_generic_xor2.sv, abr_sampler_pkg.sv, abr_sampler_top.sv]
2026-08-06 [RTL] KV read-side length-mismatch: MLDSA/MLKEM consumer wiring (#294)
    * [RTL] KV read-side length-mismatch: MLDSA/MLKEM consumer wiring
    Explicit expected_key_size bindings for kv_mldsa_seed, kv_mlkem_seed,
    kv_mlkem_msg. Removes redundant _error == KV_SUCCESS terms from
    mldsa/mlkem cmd gating (kv_ready already includes the error gate).
    * MICROSOFT AUTOMATED PIPELINE: Stamp 'user/mojtabab/kv-length-mismatch' with updated timestamp and hash after successful run
    * [RTL] Explicitly tie kv_read_client check_key_size to satisfy SpyGlass W287a
    SpyGlass W287a treats port-default values as 'unconnected' and errors on
    every kv_read_client instance that relied on the check_key_size default.
    Wire an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
    [abr_ctrl.sv]
2026-08-07 tool version update (#295)
    * fix lint and simulation for tool version updates
    * update tool versions in README
    fix assertion issue in new VCS version
    * fix compile warning due to missing default case
    * MICROSOFT AUTOMATED PIPELINE: Stamp 'user/dev/michnorris/tool_updates' with updated timestamp and hash after successful run
    [abr_1r1w_be_ram.sv, abr_1r1w_ram.sv, abr_ctrl.sv, abr_keccak_2share.sv, abr_keccak_round.sv, abr_msg_buffer.sv, abr_piso_multi.sv, abr_prim_assert.sv]
2026-08-31 [RTL] Add explicit MLDSA signature verification result to MLDSA_STATUS (#297)
    * Add explicit MLDSA signature verification result to MLDSA_STATUS
    * MICROSOFT AUTOMATED PIPELINE: Stamp 'user/mojtabab/sigver-explicit-pass-fail' with updated timestamp and hash after successful run
    * Clear MLDSA VERIFY_PASS on verify start/abort; PR review fixes
    * MICROSOFT AUTOMATED PIPELINE: Stamp 'user/mojtabab/sigver-explicit-pass-fail' with updated timestamp and hash after successful run
    [abr_ctrl.sv]
2026-09-11 [RTL] prim generic swap methodology (#300)
    * audited prim modules for upstream changes, pruned unused files
    * add tech specific reaplacement flow for prim_generics
    * MICROSOFT AUTOMATED PIPELINE: Stamp 'user/dev/michnorris/prim_generic' with updated timestamp and hash after successful run
    [abr_prim_dom_and_2share.sv, abr_prim_flop_en.sv, abr_prim_xor2.sv, abr_sampler_top.sv, abr_top.sv, compile.yml]
2026-10-20 [DOC] Update tech cell swap flow for SCA countermeasures (#304)
    * match abr prims to caliptra prims for a simpler tech file swap at caliptra integration
    * update file lists with ABR primitives renamed for macro replacement
    * update documentation for swapping ABR tech cells for SCA countermeasures
    * MICROSOFT AUTOMATED PIPELINE: Stamp 'user/dev/michnorris/abr_prims' with updated timestamp and hash after successful run
    * clarifying language to address review comments
2026-11-03 [VAL] Support Questa simulation alongside VCS (#314)
    * MICROSOFT AUTOMATED PIPELINE: Stamp 'user/dev/faydn23/ado-validation' with updated timestamp and hash after successful run
    * MICROSOFT AUTOMATED PIPELINE: Stamp 'user/dev/faydn23/ado-validation' with updated timestamp and hash after successful run
    * Support native Questa simulation alongside existing VCS flows
    Add simulator-specific compile, DPI and QVIP settings without changing VCS provider options. Fix simulator-dependent LFSR initialization and scoreboard callback ordering while retaining assertion and unmatched-transaction failures; correct the ML-KEM zeroize helper argument.
    Validation: four VCS/Questa builds and eight focused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
2026-11-04 Fix ABR_PRIM_MODULE_NAME expansion in CALIPTRA mode (#318)
    * Fix ABR_PRIM_MODULE_NAME expansion in CALIPTRA mode
    Aliasing ABR_PRIM_MODULE_PREFIX to `CALIPTRA_PRIM_MODULE_PREFIX put a
    two-level macro chain in front of the token paste in
    ABR_PRIM_MODULE_NAME_EXPAND. Xcelium and DC expand that argument only
    one level, producing the undefined macro
    `CALIPTRA_PRIM_MODULE_PREFIX_buf. VCS expands it fully, so CI passed.
    In CALIPTRA mode, delegate ABR_PRIM_MODULE_NAME to
    CALIPTRA_PRIM_MODULE_NAME instead. An explicit ABR_PRIM_MODULE_PREFIX
    override still takes precedence, and standalone builds are unchanged.
    Fixes #316
    * Define ABR_PRIM_MODULE_PREFIX before use in prim macros
    VC SpyGlass lint (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
2026-11-06 [DOC] Prepare release notes and docs for v3.0.0-rc1 (#320)
    * [DOC] Prepare release notes and docs for v3.0.0-rc1
    Release notes:
    - Rename the in-development Rev 3p0 entry to Rev 3p0-rc1 with a date.
    - Add a verification summary (UVM, Questa support, formal report).
    - Fix duplicated "Previous Releases" headings.
    README:
    - Update the repository overview to the current layout (config/,
    formal/, new src blocks and docs; drop removed entries).
    - Replace placeholder UVM paths with the actual file lists, top-level
    TB and test directory; list the ML-DSA and ML-KEM generator files.
    - List Questa Sim-64 2025.1 as an alternative simulator for the UVM
    testbench.
    Specifications:
    - Integration spe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
